anttiraisala/casino-open-sign/RDD-REQUIREMENTS.md

# RDD-REQUIREMENTS
Functional requirements agreed by the maintainer (RDD = Requirement Driven Development). IDs are never reused.

## Overview
**Purpose:** (to be agreed with the maintainer; a draft was proposed in chat on 2026-11-10)
**Users:**
**In scope:**
**Out of scope:**
**Constraints:**

## Requirements
REQ-001 to REQ-011 describe the planned settings menu: it is NOT implemented yet and is not being implemented now.

| ID | Requirement | Acceptance criterion | Origin | Revisions |
|----|---|---|---|---|
| REQ-001 | Settings menu: a menu is a list of items; each item is either a submenu or a property. The user moves through it with the keys of REQ-005; how it is presented is a separate matter. Back returns to the place the user came from (the item that was selected when the submenu was entered); at the top level it leaves the menu. | A host test walks a sample menu tree: opening a submenu, going back lands on the same item, back at the top level leaves the menu. | Maintainer chat 2026-11-10 | |
| REQ-002 | A property has a name and a value. Types: integer (negative, positive or mixed ranges, e.g. -100..-10, -50..50, 0..255), float with linear scale, float with logarithmic scale, and choice (dropdown; a boolean is a choice of two). Each has min, max and default. A text (string) type is not needed yet. | For every type a host test shows the default is applied and the value never leaves [min, max]. | Maintainer chat 2026-11-10 | |
| REQ-003 | Step size: an integer property steps by 1 unless the definition gives another step. A float property divides min..max into 50 intervals unless the definition gives another step or number of steps. A logarithmic property needs min > 0 and multiplies by a constant ratio per step ((max/min)^(1/steps)). A shift button held while turning multiplies the step by 10 (capped to the range; a property may override the factor). | Host tests: integer 0..255 with default step moves by 1; float exponent 0.1..20 log gives 51 values with the default 2.67 on the grid; shift moves by ten times the step. | Maintainer chat 2026-11-10 |  2026-11-11: shift factor fixed to x10. |
| REQ-004 | Limits: with wrap off a step that would pass min or max stops exactly at that limit (both ends); with wrap on the remaining amount of the step continues from the other end (both directions). Wrap is set per property (default off). | Host tests with a stepped value near both ends, with wrap on and off, for integer, float and choice properties. | Maintainer chat 2026-11-10 | |
| REQ-005 | Keys: a free-running 16-position hex rotary switch changes the selection or value; three buttons: OK, CANCEL, SHIFT (the OK button, documentation name "OK-menu button", opens the menu from the status pages; its label in the UI and on the LCD is always `OK`). The menu rotary is relative (it moves the selection or changes the value by steps; it is the only hex switch). In the menu OK opens a submenu or starts editing a property. While editing, OK accepts the value and returns to the menu at that property; CANCEL cancels, restores the value the property had when editing started and returns to the menu at that property. In the menu CANCEL goes up one level. The list selection stops at both ends (no wrap). Turning the arrow or casino switch while the menu is open cancels any edit (value restored) and shows the status page. The menu always opens at the root; the inactivity timer runs only at the menu root while just browsing (no submenu, property view, edit or confirm page open): after 60 s without input the display returns to the status pages, the remaining seconds shown at the right edge of row 0; elsewhere there is no timeout. SHIFT held while turning multiplies the step by 10. | A scripted key sequence on the host (turn, OK, CANCEL, SHIFT) gives the expected value and menu position for each case above. | Maintainer chat 2026-11-10 |  2026-11-11: control set of the V2 sign (menu hex switch D42-D45, OK D48, CANCEL D49, SHIFT D50), timeout and no-wrap list. 2026-11-11 (OQ-006, OQ-007, OQ-011): OK-menu button name, relative menu rotary, timeout only at the root while browsing. 2026-11-12: program switch removed, so only the arrow and casino switches close the menu (IDEA-017). 2026-11-12: BACK renamed CANCEL (technical name PIN_CANCEL, one level up or cancels an edit); CANCEL also skips the power-on LED test and the separate skip button SW2/D33 is removed from V2 (owner decision). 2026-11-12: pins spread out (menu hex switch legs 1, 2, 4, 8 on D38, D41, D42, D45; OK D46; CANCEL D49 and SHIFT D50 unchanged; owner decision, wiring only). |
| REQ-006 | The menu is defined in a human-written JSON file with a `root` tree and a `common` section of reusable elements (properties, submenus, type templates). The same element may appear in many places; loops are forbidden and are detected by the tooling. A property field is taken from the built-in default, overridden by its type template, overridden by the property itself (e.g. integer step 1 unless set). | The tooling rejects a menu with a loop, accepts a shared element in two places, and a test shows a type template field being overridden by a property. | Maintainer chat 2026-11-10 | |
| REQ-007 | Row text: by default a property row shows its name and value; the maintainer can define any friendly text for a row (including the shown words for true and false). Quick-pick rows set a value directly with one OK press, with freely definable text (e.g. "Lights on" sets B to true; "Min brightness 10" sets an integer to 10). A row text longer than 16 characters scrolls (marquee) on the 16-character LCD row; it is not a build error. A property row whose name and value do not fit together in 16 characters scrolls as one text "Name: value": a pause at the start, one character per step, a pause with the last character at the right edge (2026-11-11). A turn at the first or last item changes nothing, and a move away and straight back within 300 ms keeps that row's scroll phase. | A sample menu has a property row with default text, one with custom text and two quick-pick rows; host tests show the displayed texts and that OK on a quick-pick row sets the value. | Maintainer chat 2026-11-10 | 2026-11-11: whole-row scroll "Name: value" for rows that do not fit (maintainer chat). |
| REQ-008 | Callbacks: a property may have no callback, one or several callback functions that are called when its value changes, in the order given; menu editing, quick-pick rows and bound controls all change values through the same path and call them the same way. | A host test: a property with two callbacks calls both in order on every change; a property without a callback just changes the value. | Maintainer chat 2026-11-10 | |
| REQ-009 | Values survive power-off (stored in EEPROM) and are applied at start-up. A value is written only when the user accepts it with OK (or by a quick-pick). Each property has its own slot (by order) and the stored data carries a layout tag; on a mismatch or invalid data all defaults are used (old values may be lost). | A host test with a mock EEPROM: set a value, restart, the same value is back; with empty or invalid stored data the defaults are used. | Maintainer chat 2026-11-10 |  2026-11-11: save only on OK, slot per property, layout tag. |
| REQ-010 | A property can be read-only (default false): the menu shows its value but does not let the user change it. A value shown in the menu updates immediately when it changes elsewhere (for example by a bound control). | Host tests: OK on a read-only row does not start editing; changing the value from outside changes the displayed text in the next loop pass. | Maintainer chat 2026-11-10 | 2026-11-11: OK on a read-only property opens a view page like the edit page (name; a padlock and the value on row 1), nothing can be changed, CANCEL or OK returns (maintainer chat). |
| REQ-011 | Hardware controls bound to properties (separate from the menu): a rotary switch and buttons can be bound directly to a property and change it through the same path as the menu (same limits, wrap and callbacks). A rotary switch can work in a relative way (turning steps the value) or an absolute way (the position sets the value). The property stays visible in the menu (read-only when wanted). | Host tests: a bound dial and a bound button each change a property with its callbacks called; a read-only bound property is shown in the menu and follows the control. | Maintainer chat 2026-11-10 | |
| REQ-012 | V2 controls: the arrow slide switch (D32) and the Casino open/closed slide switch (D30) each have a reverse flag (a boolean property stored in EEPROM, editable in the menu); the switch position itself is read-only in the menu. The speed switches SW3/SW4 and the mode button D33 are removed; the speeds are menu properties. | Host test: the reverse flag inverts the meaning of each switch; the removed pins are no longer read; speeds change only through properties. | Maintainer chat 2026-11-11 | |
| REQ-013 | V2 effects (replaces the program switch, which is removed: D34-D37 are free): the frame and the letters each have their own effect, chosen in the menu group Effects (Frame effect, Letters effect, Random delay); the two effect properties also open the Frame and Letters groups (one value, two places). Each effect property is 0..15 (no wrap, default 1, saved in EEPROM): 0 = Random, 1..15 = a fixed effect (letters: 1 Breathe .. 15 Marquee; each letters effect N goes with frame pattern N, some following the arrow direction). Value rows show the number first, e.g. `12 Slot machine`. Random: one shared timer, its length the property Random delay (integer minutes 0..30, default 2, step 1, no wrap; 0 = a random delay of 1..30 min drawn on every restart; the delay is stored, a drawn value is not). When the timer runs out only the groups set to 0 pick a new effect (each its own, never the same one twice in a row); a fixed effect never changes by itself; a group switched to 0 picks at once and restarts the shared timer. | Host tests: every fixed effect N starts letters pattern N and frame pattern N; a random group never repeats and uses all 15; only random groups change when the timer runs out; both random groups change at the same moment; delay 0 draws 1..30; delay N changes after N minutes; the saved effects load at power-up. | Maintainer chat 2026-11-11 | 2026-11-11: "read at boot" changed to "read all the time" (answer to OQ-013). 2026-11-12: program switch removed; effects moved into the menu (IDEA-017, maintainer: "Joo, poistetaan"); program 0..E / F random replaced by effects 1..15 / 0 random per group, shared random timer. |
| REQ-014 | V2 status page: row 0 `F12 L03 Open|Closed` (F = frame effect, L = letters effect, two digits each, at most 16 characters; a `*` before the number marks a random group and the number is the effect really showing now, e.g. `F*07`; `--` when unknown); row 1 shows the arrow as seen from behind the sign and the customer direction (arrow character + `Customer right|left`, 16 characters; `<-`/`->` fallback if the LCD ROM lacks the arrows). While the frame or the letters are random, row 1 alternates with `Change in M:SS` (about 3 s each). | Host test of the row texts for every combination of effects, casino state and arrow direction, and the countdown (shown when either group is random); an LCD check on the real display for the arrow characters. | Maintainer chat 2026-11-11 | 2026-11-12: row 0 changed from `#<hex> Casino Open|Closed` to `F12 L03 Open|Closed` and the countdown from program F to "a group is random" (IDEA-017, maintainer chose this row 0 on 2026-11-11). |
| REQ-015 | V2 menu content: Controls (arrow, casino read-only; arrow reverse, casino reverse), Effects (Frame effect, Letters effect, Random delay), Speed (three rows Frame speed, Letters speed, Arrow speed, float log 0.125..4, 30 steps, default 1 (exactly at step 18), 3 decimals, unit x; SHIFT moves 10 steps), a group per LED type, Frame (the frame strip), Letters and Arrow (the arrow sticks), each with its speed (Frame speed, Letters speed, Arrow speed; Frame and Letters start with their effect property) and Min (int 0..255 default 0), Max (int 0..255 default 80), Exponent (float log 0.1..20, 50 steps, default 2.67) and Mix (float linear 0..1, 50 steps, default 1.0; blends the linear and the logarithmic curve as in the brightness tool), Brightness (the same brightness properties again, grouped Frame / Letters / Arrow; each property exists once and appears in two places), and a preset Restore defaults (sets every property to its default after OK/CANCEL confirmation). | The generated menu tree matches this list; a host test walks every row and the Restore defaults preset sets all defaults in one EEPROM batch. | Maintainer chat 2026-11-11 |  2026-11-11: Letters brightness group and Mix property added (maintainer chat). 2026-11-11: Speed range changed from 0.25..4 / 24 steps to 0.125..4 / 30 steps, 3 decimals (maintainer chat); the EEPROM layout tag changes, so old saved values are dropped. 2026-11-11: Menu renamed and regrouped: Strip -> Frame, Stick -> Arrow; root now Controls, Speed, Frame, Letters, Arrow, Brightness, Random program, Restore defaults; speed rows named Frame speed / Letters speed / Arrow speed (maintainer chat). 2026-11-12: Controls loses program; new group Effects (Frame effect, Letters effect, Random delay; the effects also start the Frame and Letters groups); `Random program (Change delay)` replaced by Random delay in Effects; root now Controls, Effects, Speed, Frame, Letters, Arrow, Brightness, Restore defaults (IDEA-017). |
| REQ-016 | Quick-pick presets: a row may set up to 16 property values at once (hidden properties allowed, a value may be the word `default`); all values are applied first, then the callbacks run once and the EEPROM is written as one batch. A quick-pick that targets a read-only property gives a warning when the menu is generated, and the preset does not try to set that property. A destructive preset asks OK/CANCEL. No active-value marker is shown. | Host tests: a preset with three values calls each callback once and writes one batch; a read-only target gives a generator warning and is not set. | Maintainer chat 2026-11-11 | 2026-11-11 (OQ-012): build error changed to a warning. |
| REQ-017 | Menu editor tool: a browser tool (published as a link like the Plate Designer) edits the menu JSON of REQ-006 and shows a preview of the 2 x 16 character display and the key behaviour of REQ-005; it exports the JSON that a later generator turns into PROGMEM tables. The same core logic runs in the tool and in the host tests. | Node and browser tests: the sample V2 menu loads, validation reports loops and read-only quick-pick targets, preview rows are 16 characters, the exported JSON loads back unchanged. | Maintainer chat 2026-11-11 | |
| REQ-018 | Live preview while editing: while a property is being edited, every step of the rotary switch changes the value immediately and calls its callbacks, so the effect on the sign is seen at once (a brightness changes the light, a speed changes the animation, a lighting effect starts). OK accepts the value and ends the editing (the only moment it is written to EEPROM); CANCEL (cancel) restores the value the property had when editing started and calls the callbacks again, so the effect goes back too. | Host tests: while editing, each turn calls the callbacks with the new value and nothing is written to EEPROM; OK keeps the value and writes it once; CANCEL restores the start value, calls the callbacks with it and writes nothing; the same for the V2 sketch menu. | Maintainer chat 2026-11-11 | Behaviour already exists (REQ-005 accept/restore, REQ-008 callbacks on every change, REQ-009 save only on OK); this makes the live effect and the callback on cancel explicit. |
| REQ-019 | Brightness test mode: the first item of the Brightness group is the submenu "Brightness test". While it, or any menu, edit or view below it, is open, every LED shows a fixed test pattern instead of the effects (frame, letters, all ten arrow sticks whatever the arrow direction, the CLOSED stick), and the pattern goes through the same brightness curves as every effect. The submenu holds the property Pattern (Ramp, All white, Red, Green, Blue, Level; starts at Ramp), the property Level (0..255, default 128, used by the pattern Level) and the three curve groups Frame, Letters and Arrow (Min, Max, Exponent, Mix), so a curve can be edited while the pattern is visible (live preview, REQ-018). Ramp: 10 steps with the input levels 26, 51, 77, 102, 128, 153, 179, 204, 230, 255; on every stick and on the CLOSED stick LED 1..10 in wiring order, on the letters in reading order (C A S I N O O P E N), on the 18 frame pixels in strip order two pixels per step (steps 1, 2, 2, 3, 3, 4, 4, 5, 5, 6, 7, 7, 8, 8, 9, 9, 10, 10). All white, Red, Green, Blue: every LED at input 255 (the curve maximum); Level: every LED white at the Level value. Pattern and Level are not stored in EEPROM (the layout tag does not change). CANCEL out of the submenu (or a change of the arrow or casino switch) ends the mode and the effects go on; there is no menu timeout inside the submenu. | Host tests: with identity curves each pattern gives exactly the stated colours on every LED group; with a Max of 80 the brightest step shows 80 on all three LED types; turning Pattern or Level, or editing a curve property inside the submenu, changes the LEDs at once and CANCEL restores them; the mode is off in the Brightness group itself, ends when leaving the submenu or turning the arrow switch, and nothing is written to EEPROM. | Maintainer chat 2026-11-12 (IDEA-018) | |
| REQ-020 | EEPROM clear tool: the sketch `eeprom_clear/sketch.ino` sets every byte of the Mega's EEPROM to 0xFF once at start-up (only bytes that differ are written), checks by reading back, reports the size, the number of bytes that were not 0xFF and the result on the Serial Monitor (115200 baud, one DBG line per second) and blinks the LED on pin 13 slowly when clear and fast when a byte could not be cleared; it needs no wiring. | Host tests: with seven, 1024 or no used bytes, a stuck byte, and first and last byte used: all bytes 0xFF afterwards, writes only for bytes that differed, the messages, the LED rates and the DBG line exactly as stated, one debug line per second. | Maintainer chat 2026-11-12 (IDEA-019) | |
| REQ-021 | Monochrome and effect 15: the menu property Effects > Monochrome (No/Yes, default Yes, stored in EEPROM) makes the frame, letters, arrow and CLOSED light show grey instead of colour (grey level = the brightest of R, G, B, then the brightness curve); the Brightness test and the power-on LED test stay coloured. Effect 15 of both groups is "Grey bands": always grey, only the levels off, half (128) and full (255), all lit at the start of every phase, then moving patterns (frame: four phases of 36 steps; letters: three phases of 6 s) and a broken-light flicker (frame: one pixel in a burst of 8 steps per 50-step slot, one slot in three, plus the whole frame blinking out in the first 6 steps of some 60-step slots; letters: the existing neon flicker). | Host tests: toGrey/shapeShow exact values, Monochrome on gives grey on every LED of every strip and stick and off gives colour, the Brightness test stays coloured, the frame grey bands match the independent reference table (four phases, bursts), the letters grey bands match hard-coded levels in all three phases (off/half/full only, all lit at the start of each phase), menu row and storage slot of Monochrome, layout tag 6e5c98ef; mutation tests detect every mutant. | Maintainer chat 2026-11-12 (IDEA-020) | 2026-11-12: Monochrome default changed from No to Yes on the maintainer's request (grey is the standard look). 2026-11-12: effect 15 changed from four grey levels (0/70/150/255) to three (off, half, full) with all lit at the start of each phase, on the maintainer's request. 2026-11-12: whole-frame blink-out added to effect 15; power-on LED test shows only greys in Monochrome; arrow stick default Max 80 -> 60 (maintainer's request). |
