anttiraisala/casino-open-sign/AI_CONTEXT.md

# AI_CONTEXT - read this first when continuing the project

This file is for a new AI chat that continues the work. Read it fully, then read `README.txt`
and the top (CONFIGURATION section) of `sketch.ino`. `DESCRIPTION.md` is the plain-language
description for humans.

## 1. Project in one paragraph

Arduino Mega 2560 casino sign "CASINO OPEN" for a home poker casino: 10 WS2812B LED strips
(238 LEDs), a black 50 x 45 cm plate with an LED frame, red plexi letters (CASINO / OPEN), a hole
text "CLOSED" lit from behind, and a left/right arrow. Inputs: arrow direction switch, letter mode
button, casino closed switch, and two hex rotary speed switches; an I2C 2x16 LCD shows the settings
(debug style). The whole thing is simulated in
Wokwi (https://wokwi.com/projects/new/arduino-mega). The user pastes the files into Wokwi by hand;
you only produce project files. Nothing has been tested on real hardware or in Wokwi by the AI:
tests run on the host with mock Arduino headers (section 8).

## 2. Working rules set by the user (follow them)

- The user writes Finnish. **Reply in Finnish.** Everything that goes into the project (code,
  comments, docs, config, file names) is **English**. The only exception: `README-fi.txt`, a
  Finnish translation of `README.txt` (keep the two in sync; `README.txt` is the master). Product
  names copied from partco.fi may contain Finnish characters.
- **Deliver all project files together in ONE zip** (the whole `casino_sign` folder), never as
  loose files. Send only the zip.
- The README must contain an exact wiring description (component -> pin) and a parts-to-buy list
  looked up from **partco.fi** (main parts only, no plain wire).
- Always include an **SVG electrical schematic** drawn with real symbols (`wiring-diagram.svg`),
  plus the layout drawings. All drawings are A4 and also exported as PDF.
- The user often says (in Finnish) "explain in your own words, do not implement anything": then
  explain and **do not change anything** until they confirm. Flag contradictions in a request before building.
- **Parts list prices, stock and links (`parts-list.*`, `tools/parts_data.py`, README section 5) must NOT be
  updated without an explicit request from the user** (no refreshing, re-checking or relinking on your own
  initiative). **Remind the user now and then** (for example when the parts list is mentioned, when a
  zip with it is delivered, or when they talk about ordering or building) that these are a snapshot from
  2026-11-02 and that a refresh is possible on request. Do not refresh it just because you remind them.
- Do the work in this order: explain -> user confirms -> implement -> regenerate -> test -> zip.
- The user does not want a ring of single LEDs for the frame; the frame is two strips. A letter
  may use any number of LEDs (default 6, "I" 4). Placement by the user: the arrow must have no
  vertical line at the head end of the shaft (the shaft is closed at the tail, open at the head).

## 3. Files

| File | Role |
|---|---|
| `sketch.ino` | The program. All settings are in the CONFIGURATION section at the top. |
| `diagram.json` | Wokwi circuit. **Generated** by `tools/generate_diagram.py`; never edit by hand. |
| `libraries.txt` | `Adafruit NeoPixel` |
| `wiring-diagram.svg/.pdf` | Electrical schematic, A4 portrait. Generated by `tools/generate_schematic.py`. |
| `layout-diagram.svg/.pdf` | To-scale layout of the strips on the plate, A4 landscape. `tools/generate_layout.py`. |
| `layout-parts.svg/.pdf` | LED counts, cutting list, letter table, A4 portrait. Same script. |
| `README.txt`, `README-fi.txt` | Wokwi instructions, wiring, parts list, cutting list, behaviour. |
| `DESCRIPTION.md` | Human description + list of planned features. |
| `AI_CONTEXT.md` | This file. |
| `tools/generate_diagram.py` | Reads the config from `sketch.ino` (regex, `read_config`) and builds `diagram.json`. |
| `tools/generate_schematic.py` | Draws the schematic; also defines the `Svg` helper class (`render_a4`). |
| `tools/generate_layout.py` | Draws the plate layout and the parts sheet from the same geometry. |
| `tools/sign_data.py` | Shared strip data (pins, pieces, LED counts, index ranges) for the drawings. |
| `tools/size_calculator.py` | Suggests LED counts for a sign size (`--width --height --arrow-width --arrow-height --closed-leds`). |
| `tools/export_pdf.py` | SVG -> A4 PDF with Playwright. |
| `tools/parts_data.py` | Data of the shopping list (every part, qty, price, stock, partco.fi URL). Edit here. |
| `tools/generate_parts_list.py` | Makes `parts-list.pdf` (A4 landscape, clickable links + a link page), `parts-list.csv` and `parts-list.xlsx` (formulas: line totals, SUMIFS totals; recalculated with the xlsx skill's `recalc.py`). |
| `parts-list.pdf/.csv/.xlsx` | The complete shopping list, master of the parts list (README section 5 has the main parts only). |
| `tests/` | Host-side test harness (section 8); `tests/strip_test_harness.cpp` tests `strip_test/sketch.ino`. |
| `stick_test_direct/` | Second stick test: up to 11 Grove sticks (shield connectors D2..D8, A0..A3) plugged UNMODIFIED, always-moving patterns from power-up (spotlight stick, 11 patterns, button = load test) into the Grove shield, Arduino+shield fed from the external 5 V supply on the Mega 5V/GND pins (no USB while running). Same pins as stick_test plus A3; sign-of-life LED and DBG serial line. Generators `tools/generate_stick_test_direct_{diagram,schematic}.py` (layout comes from generate_stick_test_layout.py); host test `tests/stick_test_direct_harness.cpp`. |
| `stick_test/` | Separate small project: sketch + Wokwi diagram + A4 schematic + layout + READMEs for testing 10 Grove RGB LED sticks (10x WS2813) on a separate 5 V supply. Generators: `tools/generate_stick_test_{diagram,schematic,layout}.py`; host test `tests/stick_test_harness.cpp`. Chosen arrow design B (10 sticks: 4 shaft, 2 caps, 4 wings at 30 deg); NOT yet applied to the main sketch (user said 9 sticks earlier, 10 now: open). |
| `strip_test/` | Separate small project: sketch + Wokwi diagram + A4 schematic + READMEs for testing a short piece of the candidate 12 V WS2811 strip. Schematic made by `tools/generate_strip_test_schematic.py`. |
| `strip_single_led_test/` | Test "LED strip single LED": 3 x 12 V WS2811 strips (D9 walking white pixel, D10 coloured walking pixel, D11 ruler), 150 steps (probably only 50 real pixels). Files made by `tools/generate_strip_single_led_test.py`; tests `tests/strip_single_led_test_harness.cpp`, `tests/mutate_strip_single_led.py`. |
| `eeprom_clear/` | Tool (not a test): sets every EEPROM byte to 0xFF once at start-up (EEPROM.update, read back and verified), sign of life LED 13 (slow = ok, fast = failed) and a DBG line per second; no wiring, USB only. A USB upload does not clear the EEPROM, so the V2 menu settings survive uploads (a changed layout tag gives defaults). Tests `tests/eeprom_clear_harness.cpp` + `tests/mutate_eeprom_clear.py` (52 mutants). |
| `hex_rotary_test/` | Test of a free-running 16-position hex rotary switch (legs 1, 2, 4, 8 on D34-D37, C to GND, INPUT_PULLUP, bit set = LOW): number A 2..51 (start 26, no wrap, step 1, `reverseDirection` bit) follows the switch; direction and steps from delta = (new - old) mod 16 (1..7 forward, 9..15 backward, 8 ignored), 10 ms debounce; I2C LCD 0x27 shows `A=..` and `Pos:X CW n:..`; LCD retried every second when lost, re-initialised every 5 s; I2C scan at boot; sign of life. Files by `tools/generate_hex_rotary_test.py`; tests `tests/hex_rotary_test_harness.cpp`, `tests/mutate_hex_rotary.py`. Not yet run on hardware. |
| `strip_frame_demo_test/` | Demo "Strip frame demo" (owner's name "Street Frame Demo Test"): D9 frame strip of 18 WS2811 pixels (6 bottom, 3 right, 6 top, 3 left; pixel 1 at the lower-left corner, counter-clockwise), three Knight Rider lights whose route starts at the upper-left corner (strip pixel 15) and runs clockwise, turning at pixel 16 (34 steps per cycle), red 500 ms / green 385 ms (1.3x) / blue 333 ms (1.5x) per step with additive colour mixing; D10 single pixel pulse 3 s, 8 palette colours; D11 colour bar of 6 pixels (red, green, blue, cyan, violet, white moving 1 pixel/s towards pixel 6); D12 pixel test of 10 pixels (counter 5 s, fill/empty 10 s, red-green-blue-white 6 s, runner 3.6 s); peak 80. Files by `tools/generate_strip_frame_demo_test.py`; tests `tests/strip_frame_demo_test_harness.cpp`, `tests/mutate_strip_frame_demo.py`. |
| `strip_knight_rider_test/` | Demo "LED strip knight rider": 3 x 12 V WS2811 strips of 50 pixels, one light bounces (D9 red 1 px/s, D10 blue 4 px/s, D11 green 10 px/s; 98 steps per cycle). Files by `tools/generate_strip_knight_rider_test.py`; tests `tests/strip_knight_rider_test_harness.cpp`, `tests/mutate_strip_knight_rider.py`. |
| `sticks_11_test/` | Test "11 sticks": 10 arrow sticks (D2-D8, A0-A2, sign order) + the CLOSED light stick on A3, steady CLOSED light + flowing white arrow (button D33: flow <-> all on), heat check. Files by `tools/generate_sticks_11_test_{diagram,schematic,layout}.py`; tests `tests/sticks_11_test_harness.cpp`, `tests/mutate_sticks_11.py`. |

Regenerate everything after changing the config or geometry:

    python3 tools/generate_diagram.py
    python3 tools/generate_schematic.py
    python3 tools/generate_layout.py
    python3 tools/export_pdf.py
    python3 tools/generate_parts_list.py   # then recalculate parts-list.xlsx (LibreOffice recalc.py) so cached values exist
    rm -rf tools/__pycache__

## 4. Hardware and pins (must match `sketch.ino`, README.txt, both SVGs)

Strips (each through a 330 ohm resistor R1..R3 to the first LED's DIN):

| Pin | Strip | LEDs | What |
|---|---|---|---|
| D9 | frameCw | 53 | frame: top edge (28) then right edge (25) |
| D10 | frameCcw | 53 | frame: left edge (25) then bottom edge (28) |
| D11 | letters | 58 | letters in reading order C A S I N O, O P E N: 6 6 6 4 6 6, 6 6 6 6 |

Grove sticks (plugged into the Grove Base Shield connectors, no resistor, power ONLY through the shield):

| Connector | Stick | LEDs | What |
|---|---|---|---|
| D2 D3 D4 | L-CAP, L-WING-UP, L-WING-DN | 10 each | left cap and the left arrowhead wings |
| D5 D6 D7 D8 | RAIL-UP-L, RAIL-UP-R, RAIL-DN-L, RAIL-DN-R | 10 each | the four rail sticks |
| A0 A1 A2 | R-CAP, R-WING-UP, R-WING-DN | 10 each | right cap and the right arrowhead wings |
| A3 (57) | closedLight | 10 | the 11th stick: white light behind the plate, lights the CLOSED hole text |

D31 is free (the CLOSED light used to be a 6-LED strip there).

Inputs (INPUT_PULLUP; a switch pulls the pin to GND):

| Pin | Part | Meaning |
|---|---|---|
| D32 | slide switch SW1 | arrow direction: LOW (handle on GND side) = points left |
| D33 | push button | each press = next letter mode |
| D30 | slide switch SW5 | casino closed: LOW = closed |
| D22-D25 | hex rotary switch SW3 (bits 1,2,4,8) | speed of frame + arrow |
| D26-D29 | hex rotary switch SW4 (bits 1,2,4,8) | speed of the letter patterns |
| D20 (SDA), D21 (SCL) | I2C LCD 2x16 (PCF8574 backpack, 0x27) | shows mode, speeds, casino state, arrow; 5 V + GND from the Arduino pins |

The hex switches are the partco.fi part "hex-coded rotary switch 0-F" (not a pulse encoder): 4
bit pins + common to GND. `SPEED_BIT_IS_LOW = true`. Speed multiplier grows geometrically from
0.25 (position 0) to 4.0 (position F).

Power: 5 V / 10 A supply (Mean Well LRS-50-5), 10 A fuse, 1000 uF capacitor, common GND with the
Arduino. The supply feeds the Arduino through BOTH Mega 5V pins (no USB while the supply is on), and the Grove shield passes that 5 V to the 11 sticks; no wire goes from the supply to any stick. The strips are fed directly from the supply bus. Worst case 164 strip LEDs + 110 stick LEDs = 274 x 60 mA = 16.4 A;
Brightness curves: per LED type (STRIP: frame+letters, STICK: arrow+CLOSED) a 256-byte lookup table built by setBrightnessCurve(type,min,max,exponent,mix,keepZero) (defaults CURVE_DEFAULT_*: min 0, max 80, exponent 2.67, mix 1.0, keepZero true); shapeColor() maps the largest channel through the table and keeps the hue; applied where colours are written (not in the power-on test); the harness runs the old tests with an identity curve and tests the curves with hard-coded values. There is no global BRIGHTNESS any more (library brightness 255); curve max 80 gives about 4.5 A when all LEDs are white.

Geometry (60 LEDs/m, pitch 16.7 mm): plate 50 x 45 cm, arrow about 39.1 x 16.7 cm (the 40 x 15
target cannot be hit exactly with whole LEDs and an even cap), CLOSED hole text about 10 x 2.5 cm,
about 5 cm free under the arrow. Total 3.97 m of strip in 27 pieces (one 5 m reel).

## 5. Sketch structure

- Adafruit_NeoPixel, **one object and one data pin per logical strip** (10 objects), `show()` per
  strip. Strips made of several physical pieces are chained with wires (DOUT -> DIN).
- All timing is non-blocking `millis()`. **Never use `delay()`** (the only exception is the one-time LCD start-up in `setup()`).
- Sections in order: CONFIGURATION, helpers (`mixChannel`, `cycleOf`, `lettersTotalLeds`), input
  debouncing (`pollInput`, `initInput`, `INPUT_ARROW/MODE/CLOSED`), speed switches
  (`buildSpeedTable`, `pollSpeedSwitch`, `applyMainSpeed`, `applyLettersSpeed`,
  `advanceLetterClock`), frame (`updateFrame`), letters (11 modes `MODE_*`, `letterLevel`,
  `drawLetters`, random neon flicker of one letter), CLOSED light (states `CL_OFF/CL_STARTUP/
  CL_STEADY/CL_FLICKER`, `setCasinoClosed`, `updateClosedLight`), arrow (`drawArrow`,
  `updateArrow`, `applyArrowSwitch`), `setup()`, `loop()`.
- Frame: 5 LEDs lit / 5 dark pattern, distance measured from the start corner along two paths that
  meet at the opposite corner. Corners are empty cells. When the arrow points right the pattern
  starts at the top-left corner; when it points left the distance mapping is mirrored.
- Letters: modes 0 breathe (default, start mode), 1 wave, 2 typewriter, 3 ignite, 4 word blink,
  5 alternate, 6 scanner, 7 sparkle (stateless hash `hash16`), 8 chase (one dim letter per word),
  9 pulse (heartbeat), 10 random auto (`pickAutoMode`: random pattern from 0..9, never the one
  showing, re-picked every `LETTER_RANDOM_AUTO_MS` = 120000 real ms). `letterMode` is what the button
  selected, `activeMode` the pattern really shown; `baseLetterLevel` switches on `activeMode`. The
  letter patterns run on their own scaled clock `letterClockMs` (SW4), so changing the switch never
  makes a pattern jump. The random letter flicker keeps real time.
- Casino closed: `letterLevel()` returns 0 for letters of the second word (OPEN) while closed. The
  CLOSED light is always white (R = G = B): startup flashes (`CLOSED_STARTUP_MS`), steady
  5-14 s, flicker burst 0.4-1.5 s with full / dim / dark phases. Timing follows SW4.
- Power-on LED test (`POWER-ON LED TEST` section): `setup()` only initialises the hardware, the
  strips, the button, the LCD and the speed table, then `beginStartupTest()`; the rest of the start
  (reading the arrow/closed/speed switches, mode 0, closed light) is `finishStartup(now, skipped)`,
  called when the test ends or the button D3 is pressed (`buttonChanged` and LOW; a button already held
  at power-up has no change event, so only a new press skips; that press is not a mode change).
  `updateStartupTest()` draws, for all `allStrips[]` at once, a window of `STARTUP_TEST_WINDOW_LEDS` LEDs
  moving over the strip (front from 0 to n + w over each pass, so strips finish together); pass 0 white,
  later passes R, G, B by LED number. `STARTUP_TEST_MS` = 10000 (0 = no test), `STARTUP_TEST_PASSES` = 2.
  During the test `loop()` only polls the button and calls `updateStartupTest()` and `updateLcd()`.
  LCD test screen: `lcdBuildTestText()`: one row scrolls "press D3 to skip" (`LCD_TEST_SCROLL_MS`), the other
  shows `N/10 s` centred over a `#`/`.` progress bar; rows swap every `LCD_TEST_SWAP_MS` (2.5 s).
  The test harness calls `finishStartup(g_millis, true)` right after `setup()` so its older tests start
  from normal operation; the power-on test has its own block at the end of the harness.
- LCD (`LCD DISPLAY` section): own HD44780-over-PCF8574 driver on `Wire` only (no library; the
  one-time start-up sequence uses `delay()` in `setup()`, nothing else does). Pages 0 mode, 1 SW3,
  2 SW4, 3 status rotate every `LCD_PAGE_MS` (3 s). A changed setting calls `lcdShowPage(page, now,
  true)` = shown at once and held `LCD_HOLD_MS` (6 s) from the last change, then rotation resumes from
  the next page; the automatic random-auto change shows page 0 without a hold. `lcdBuildText()` builds
  the text (rate-limited, immediate on page change); `lcdSendChanges()` sends only changed characters,
  `LCD_CHARS_PER_LOOP` per loop pass (one short transmission, no blocking). If no display answers at
  start-up (`lcdOk` false) the display is skipped. Backpack mapping: P0 RS, P1 RW, P2 E, P3 backlight,
  P4-P7 D4-D7. Address `LCD_I2C_ADDRESS` 0x27 (the partco page says 0x27, but PCF8574AT chips are
  often 0x3F; unverified on real hardware).
- Arrow (10 Grove sticks): only the head the arrow points at is lit; tail cap = middle 6 LEDs, head cap = 3 + 3 end LEDs; two routes (upper, lower) tail -> rails -> head cap -> wing -> tip in blue/cyan/violet/ice-white, with a white pulse taking turns on the two routes (see section "Phase 1 sign rebuild").

### Pitfall: Arduino auto-prototypes

The Arduino build inserts function prototypes at the top of the file. A function signature may
only use types known before the first function: built-in types, `Adafruit_NeoPixel`,
`__FlashStringHelper`. A custom `struct` in a signature or a `constexpr` function caused the build
error `'Rgb' does not name a type`. Colours are packed `uint32_t`; the letter LED total is the
runtime function `lettersTotalLeds()`. Keep it this way.

## 6. Wokwi diagram (`diagram.json`) facts

- Parts used: `wokwi-lcd1602` (attribute `pins` "i2c": SDA = mega:20, SCL = mega:21, VCC = 5V, GND), `wokwi-arduino-mega`, `wokwi-led-strip` (chain DOUT -> DIN, VDD.2 -> VDD,
  VSS.2 -> VSS; any `rotate`), `wokwi-slide-switch` (pins 1, 2 common, 3; attribute `value` "1" =
  handle right), `wokwi-pushbutton`, `wokwi-dip-switch-8` (pins `1a`..`8b`), `wokwi-text`.
- The I2C LCD sits below the Arduino (caption above it). Wokwi has no hex rotary switch: a DIP-8 stands in (switches 1-4 = SW3 bits, 5-8 = SW4 bits).
- The CLOSED hole text cannot be shown; a text label stands in. SW5 starts "open" (`value` "1").
- Wokwi has no background graphics: the letters are groups of single LEDs drawn as circles with a
  text label in the middle. Strips are separated by one-LED gaps for clarity (not on the real sign).
- Geometry constants at the top of `generate_diagram.py` (`PITCH = 16`, `THICKNESS`, ...) are an
  estimate of the Wokwi strip element size. If the user reports misaligned parts, tune them.
- Layout: the sign is at x = 480, y = 20. The input block (switches, button, DIP bank, labels) is
  placed ABOVE the Arduino, left of x = 460, with every caption ABOVE its component (slide switches
  and button on top, then the DIP bank's caption block with the DIP bank below it); the Arduino is below. Wires may cross, that is fine.
- A text list of the letter modes sits under the sign (`mode_list_*` text parts); update it in
  `generate_diagram.py` when modes change.
- The user pastes `sketch.ino` into the `sketch.ino` tab and `diagram.json` into the `diagram.json`
  tab. Once the sketch ended up in the diagram.json tab (no Play button) - remind them if needed.

## 7. Drawings

- `Svg.render_a4(landscape)` in `generate_schematic.py` scales a drawing to one A4 page (width and
  height in mm, viewBox scaled to fit with 8 mm margins). Text sizes in the code are in drawing
  units; the printed size is printed by the generator scripts.
- Schematic: real symbols (resistors, slide switches, push button, hex switch blocks, fuse,
  capacitor, power supply). Each strip is a block fed at the points listed in README section 4.
  Strip table comes from `sign_data.strip_info`, so counts always match the sketch.
- Layout: to scale (60 LEDs/m), dimensions in cm, callouts per strip with LED index ranges, CLOSED
  hole text outline drawn over the LED squares. `--leds-per-m` changes the pitch.
- The wiring diagram is a single A4 page; its text is small (about 1.9 mm per 12-unit label).
  Splitting it into two pages was offered but the user chose one page for now.
- Always check new drawings visually (render with Playwright/pdftoppm and look at them).

## 8. Tests (no AVR toolchain, no Wokwi in the sandbox)

`tests/` holds a host-side harness with mock `Arduino.h`, `Adafruit_NeoPixel.h` and `Wire.h` (the
mock Wire contains a fake HD44780 + PCF8574 display that decodes the I2C bytes into two text rows):

    g++ -std=c++17 -O1 -w -Itests -DSKETCH_PATH='"../sketch.ino"' -o /tmp/harness tests/harness.cpp
    /tmp/harness        # prints "RESULT: all checks passed"

It checks (including the four new modes, random auto and the LCD pages): LED counts and pins of all strips, every letter mode, flicker, arrow direction and
frame mirroring, input debouncing, all speed switch positions, the casino-closed behaviour (OPEN
letters dark in all modes, CLOSED light always white with startup/steady/flicker phases, burst rate
scales with SW4, reopening restores everything, a 10 ms glitch is ignored). When you change the
sketch, extend the harness and also run a mutation (break the feature, the test must fail).
A reversed-polarity build (`CASINO_CLOSED_WHEN_LOW = false`) fails the harness by design because
the harness hard-codes LOW = closed.

### Hex rotary test (2026-11-10)

`hex_rotary_test/sketch.ino` is tested by `tests/hex_rotary_test_harness.cpp` (mock Arduino + Wire with the fake LCD; all expected values hard-coded:
leg-to-pin mapping, the move table with forward/backward/wrap/ambiguous cases and clamping, 10 ms debounce, `reverseDirection`, LCD text, LED and
DBG timing, LCD loss/retry/re-initialisation, I2C scan range) and mutation-tested by `tests/mutate_hex_rotary.py` (108 mutants, all detected; the
one "lcdShown updated on a failed send" mutant was dropped as equivalent because `lcdInit()` resets `lcdShown`):

    g++ -std=c++17 -O1 -w -Itests -DSKETCH_PATH='"'$PWD'/hex_rotary_test/sketch.ino"' -o /tmp/hex_rotary_harness tests/hex_rotary_test_harness.cpp && /tmp/hex_rotary_harness
    python3 tests/mutate_hex_rotary.py

The mock cannot check the LCD set-up commands 0x28, 0x0C, 0x06 (it only models 4-bit switching, clear and cursor/data writes).

### Casino Open Sign V2 tests (2026-11-10)

`casino_open_sign_v2/` has its own sketch; the harness is `tests/casino_open_sign_v2_harness.cpp` (derived from `tests/harness.cpp`, with the
V2 pins, 13 strips, hard-coded frame paths for both arrow directions, letter pixel order C A S I N O N E P O and a typewriter order test) and
`tests/mutate_v2.py` (~85 mutants):

    g++ -std=c++17 -O1 -w -Itests -DSKETCH_PATH='"'$PWD'/casino_open_sign_v2/sketch.ino"' -o /tmp/v2 tests/casino_open_sign_v2_harness.cpp && /tmp/v2

V2 generators: `tools/generate_v2_diagram.py` (Wokwi), `generate_v2_schematic.py`, `generate_v2_layout.py` (layout-diagram + layout-parts),
`generate_v2_parts_list.py` (CSV + SVG), shared data `tools/v2_data.py`; all read `casino_open_sign_v2/sketch.ino`. The v1 files are unchanged.
V2 stick wiring (differs from v1 and `arrow_sticks/`; positions unchanged): L-CAP D2, L-WING-UP D6, L-WING-DN D5, RAIL-UP-L D7, RAIL-UP-R D8,
RAIL-DN-L D3, RAIL-DN-R D4, R-CAP A3, R-WING-UP A1, R-WING-DN A2, CLOSED stick A0. The connectors come from the sketch, not from `arrow_geometry.py`.
V2 boot: `scanI2cBus()` (0x08-0x77, empty write) prints the found I2C devices to Serial before `lcdInit()` and warns if nothing answers on `LCD_I2C_ADDRESS` (0x27); one LCD only, its address is a constant (tests: "I2C scan" checks + 9 mutants).

## 9. Decisions already made (do not reopen without a reason)

- 60 LEDs/m strip, plate 50 x 45 cm, arrow ~40 x 15 cm target (actual 39.1 x 16.7 cm).
- The frame is two strips (CW and CCW), not a ring of single LEDs; corner cells stay empty.
- Letters: one data pin, one chained strip made of per-letter pieces, LED count per letter free.
- Hex rotary switches (4 pins each) for the two speeds, not pulse encoders.
- Power-on LED test: 10 s, all strips in parallel, 2 passes (white, then RGB), D3 skips, LCD shows seconds in a progress bar plus a scrolling skip text with the rows swapping every 2.5 s.
- Casino closed = darkens only OPEN (24 LEDs), lights the CLOSED hole text; the closed light is
  always white and flickers like a faulty fluorescent tube.
- One zip with all files; Finnish README as the only non-English file.
- The controller stays the Arduino Mega 2560 (decided 2026-11-02). Smaller boards were considered and rejected
  for now: the sign needs 23 I/O pins (10 strip data pins, 11 inputs, 2 I2C), more than an Uno/Nano (about
  18-20 usable); an Uno also has only 2 KB RAM (rough estimate, not measured, about 1.7 KB needed). CPU speed
  is not a problem (updating all 238 LEDs takes about 7 ms). Possible cheaper options if asked again: Seeeduino
  Mega (46.70 EUR at partco.fi, pin numbering unchecked), a Mega clone, or a smaller board plus an I2C port
  expander (PCF8574) for the hex switches (needs wiring and code changes). 3.3 V boards need level shifters
  for the WS2812B data lines.

## Plate Designer (2026-11-09)
`tools/plate-designer/` (README.md there): `plate-core.js` = tested pure logic (SDF/marching-squares letter geometry, hole checks, snapping, frame counts, EPS/PDF writers, JSON v1), `app.js` + `index.html` = UI, `arrow-data.js` generated from `tools/arrow_geometry.py`. Tests: `tests/plate_designer_core_test.js`, `tests/mutate_plate_designer.py`, `tests/plate_designer_ui_test.py`. Fonts stored by name only; Google Fonts load needs network (untested from the sandbox).

## Menu Editor (2026-11-11)
`tools/menu-editor/` (README there): `menu-core.js` (JSON format 1 validation + engine: keys, live editing, presets, EEPROM image with layout tag, 16-character rows, 60 s root timeout, marquee), browser editor (`index.html`, `app.js`), V2 menu `menu-v2.json`. Tests: `tests/menu_core_test.js` (hard-coded expectations), `tests/mutate_menu_core.py` (151 mutants), `tests/menu_editor_ui_test.py` (Playwright; `MENU_EDITOR_PAGE=menu-editor-single.html` for the single file). Single-file build `tools/build_menu_editor_single.py`, artifact slug 840aef6c-fb14-4ea5-9587-4e52d8c076dd. The V2 sketch does not use it yet; next steps are the generator (JSON -> PROGMEM) and the V2 sketch changes (REQ-012..016, RDD-PROGRESS AP-003..005).

### Menu engine and menu test (2026-11-11)
`tools/menu_engine/engine.inc` is the C++ menu engine (same rules as the JS `Engine`), `generate_menu_tables.js` turns the menu JSON into PROGMEM tables (properties, items, menus, presets, value texts, callbacks, string blob, EEPROM slots, layout tag), `test_shell.ino.in` is the hardware shell (menu hex switch D38/D41/D42/D45, OK D46, CANCEL D49, SHIFT D50, arrow D32, casino D30, I2C LCD, sign of life). `node tools/generate_menu_test.js` assembles `menu_test/sketch.ino` (never edit it by hand). Tests: `tests/menu_diff_test.py` (random events through both engines, compares rows, callbacks, EEPROM batches, positions, mode), `tests/menu_engine_harness.cpp` + `tests/menu_engine_checks.inc` (EEPROM image, texts, shell pins/debounce/polarity, sign of life, set-up), `tests/mutate_menu_engine.py` (124 mutants; equivalent ones are listed in its header). Drawings and Wokwi circuit: `tools/generate_menu_test_drawings.py`. `tests/arduino_signature_lint.py` checks that no function signature uses a user-defined type (Arduino automatic prototypes). The V2 sign sketch does not contain the menu yet (AP-004).

## 10. Open items and ideas

- Planned features are listed in `DESCRIPTION.md` (section "Planned and possible features");
  currently none are decided. Update both files when something is added or built.
- The parts list (`parts-list.*`) was checked on partco.fi on 2026-11-02: the 60 LEDs/m 5 V strip (the only suitable
  one) was SOLD OUT, so check availability again; the 330 ohm 0.5 W resistor was discontinued (2 W type used);
  wire prices, solder, plate, letters and frosted plastic have no price. Re-check stock and prices before ordering.
- Real hardware and Wokwi runs are unverified; if the user reports a Wokwi problem, ask for the
  error text or a screenshot.

### Strip change under study (NOT applied to the sign's files yet)

- The designed strip (60 LEDs/m, 5 V WS2812B) is sold out at partco.fi. A white single-colour 12 V strip was
  rejected (not addressable). The candidate is partco's RGB-LEDNAUHA 30kpl/m WS2811 5m (12 V, 150 LEDs, cut every
  10 cm, SKU LED-N-RGB-W2812X150-5M, https://partco.fi/tuote/rgb-lednauha-30kpl-m-ws2812-5m-103). The product text
  is generic; evidence (12 V, cut every 10 cm, WS2811) says one chip per 3 LEDs = 50 pixels of 10 cm. The user
  was to ask partco; a question email was drafted. Unconfirmed: colour order, bit speed, current, width.
- Plan: test a short piece with `strip_test/` first (the user reports what he sees), make the main design
  independent of the pixel size (set in cm), keep the current 5 V design in the zip as a variant if the user wants.
- New plate size from the user: 60 x 30 cm, the frame strip as large as the plate (ring outer 60 x 30 cm; the user cuts
  the strip later), arrow 45 cm tip to tip and 10 cm high (the 8 cm shaft cannot be made with the current even-cap
  model), the text and the arrow share about 26 cm. With the old 16.67 mm pitch this is frame 34 + 16 LEDs per half
  (100 LEDs), arrow 64 LEDs (cap 2, base 1, wing 5, body 18), total 228 LEDs. With 10 cm pixels about 38-50 pixels.
- Open decisions asked from the user: 10 cm pixel acceptable? one or two pixels per letter? simplified line arrow?
  fix the Wokwi letter circles (they do not fit vertically)? If the 12 V strip is used: LRS-50-12 supply (4.2 A),
  5 A fuse, capacitor rated 25 V, 330 ohm data resistors stay, Arduino data 5 V (probably works, test it).
- `parts-list.*` was rebuilt on 2026-11-02 at the user's explicit request for the PLANNED 12 V colour strip, with a
  Certainty column (sure/probable/uncertain), Insurance rows (extras for the uncertain situations; total with
  insurance) and strip-test parts. The sketch and drawings still describe the 5 V design.
- Hex rotary switches (KIERTOKYTKIN-216), slide switches KYT-LIU19-B (2-pole, long knob, 0.90 EUR, user's choice
  for D2/D30; use one pole) and push button KYT-DS102-MUS (panel, 6.53 EUR) for D3 were discussed; the parts list
  was NOT updated (prices and links change only on explicit request).

## 11. Checklist before sending a result

1. All config numbers consistent: `sketch.ino` -> generators rerun -> README.txt and README-fi.txt
   numbers (LED totals, strip length, pins, current) updated.
2. Harness passes; project text is ASCII/English (except README-fi and partco product names).
3. Drawings regenerated, PDFs exported, drawings looked at.
4. `tools/__pycache__` removed; one zip of the whole folder; send only the zip with a short
   Finnish summary (what changed, new numbers, what was NOT tested).

## Rule: tests the user is asked to run
Any test the AI asks the user to run must live in its own sub-folder of the zip (e.g. strip_test/). The sub-folder must be self-contained:
its own sketch.ino, diagram.json, libraries.txt, README.txt + README-fi.txt (wiring, parts to buy), wiring-diagram (SVG+PDF) and layout-diagram (SVG+PDF).

## Sign of life rule (project-wide)
While an Arduino program runs, the debug LED on pin 13 must blink and the Serial Monitor must get one line per second with changing values (uptime, fps/loop count, state, beats). The speed (115200 baud) is stated in the comment at the top of the sketch, printed at start-up and written in the README. The LED reflects the load: normal toggle interval, shortly inverted when a state change happens, twice as fast when many state changes happen. Skip the LED and/or the serial line if the project uses that pin or the serial port for something else. Reference implementation: stick_test_direct/sketch.ino (loop(), printDebug()) and tests/stick_test_direct_harness.cpp. stick_test_direct and sketch.ino have it now (sketch.ino: signOfLife/noteEvent/printDebug before setup(); 115200 baud); add it to strip_test/ and stick_test/ the next time they are updated (user decision).

## Stick arrow geometry (2026-11-07)
See `arrow_sticks/README.txt` and `tools/arrow_geometry.py` (single source for the drill template, layout and wiring drawings; `tests/arrow_geometry_test.py` checks it). Owner's inputs: stick body 83 x 10 mm, LED window 74 x 4 mm, 2 mm between sticks, Grove connector in the middle of the stick, rails' LED rows on the 3rd LED from the top and the 3rd from the bottom of the vertical bars, drill template exact to the millimetre as a landscape PDF, layout drawing indicative. Assumptions to confirm on a real stick: LED pitch 7.4 mm, ball end (STICK_BALL_AT_DIN_END), cable hole diameter 8 mm. The stick_test* layout drawings still show the older 80 mm sketch.

## Phase 1 sign rebuild (2026-11-07)
- sketch.ino drives the 10 sticks (STICK_PINS = D2-D8, A0-A2; names in arrow_sticks/README.txt) with two routes (upper, lower) of 36 LEDs each: tail cap middle 6 LEDs (index 2..7, 3 per lane, ends dark) -> 20 rail LEDs -> 3 end LEDs of the head cap (index 2,1,0 / 7,8,9; middle 4 dark) -> 10 wing LEDs to the tip (stickFlow(), stickActive()). Pointing right: L-CAP is the tail cap, R-CAP the head cap, R-WING-* lit; pointing left: mirrored. Both caps are therefore always partly lit; only the wings of the other head are dark. Logical stick LED 0 = the BALL end (the black dot in the drawings; left-half sticks point left, right-half right, caps up). STICK_BALL_AT_DIN_END (true = ball at the DIN end, LED numbers as they are; false = the program counts from the other end) corrects the LED order for the real sticks; the sticks are mounted exactly as drawn. LCD status page shows the customer view with the arrow symbol first ("<-Customer right" / "->Customer left"; mirrored because the LCD is behind the sign). Switch D32 (ARROW_POINTS_LEFT_WHEN_LOW reverses it; harness variant + mutants cover both values): handle direction = real arrow direction; back view, GND contact on the right. Animation: palette wave + shimmer on both routes, plus a white 5-LED pulse (255,200,150,100,55) that runs tail -> tip on the upper route, then on the lower route (ARROW_PULSE_TURN = 36, period 72 ticks, exactly one pulse head at a time).
- Moved pins: frame D9/D10, letters D11, CLOSED light moved from D31 to the 11th stick on A3, arrow switch D32, button D33, casino-closed D30, speed switches D22-D29.
- Power: the Grove shield passes the Mega 5V/GND to the sticks, so the PSU +5 V feeds both Mega 5V pins; no USB while the supply is on.
- Wokwi: the arrow is drawn below the frame at the Wokwi LED size (16 px per LED); diagram.json comes from tools/generate_diagram.py. Host harness tests/harness.cpp checks pins and the flow mapping with hard-coded expectations (mutation-tested with `python3 tests/mutate.py`: 34 mutants, all detected).
- CLOSED light (2026-11-07): the 11th Grove stick, PIN_CLOSED_LIGHT = A3 (57), CLOSED_LIGHT_LEDS = 10, always white; D31 is free. Sticks only through the shield: the supply never has a wire to any stick (wiring-diagram shows "+5V, GND via the shield"). The LED window (74 mm) is narrower than the ~100 mm hole text: diffuser needed.
- Old strip arrow: backup/old_arrow_strips/ (sketch, diagram, README with the retired parts). Phase 2 is in PROGRESS.md.

## Results from the user (2026-11-06)
- stick_test_direct on real hardware: all 11 Grove sticks plugged unmodified into the Grove Base Shield with the Arduino + shield fed from the external 5 V supply work, all show the moving patterns. The user has at least 11 sticks. This settles the stick count for the arrow (10 for design B, an 11th: now the CLOSED light).
- The directory is not a git repository inside the AI workspace; the user commits the files to version control himself (a .gitignore for __pycache__ is included). No GitHub repository for this project was found on the user's account by the AI.

## Casino Open Sign V2 settings menu (2026-11-11)
`casino_open_sign_v2/sketch.ino` has a generated block between `//@V2_MENU_BEGIN` and `//@V2_MENU_END` (PROGMEM tables + the C++ menu
engine from `tools/menu_engine/engine.inc`), written by `node tools/generate_v2_menu.js` from `tools/menu-editor/menu-v2.json`
(`--check` tells if it is current). The hand-written rest of the sketch supplies `menuCallback` (applySwitches, applySpeeds,
curve rebuilds), the controls (menu hex switch legs 1, 2, 4, 8 on D38/D41/D42/D45 relative, OK D46, CANCEL D49, SHIFT D50; there is no program switch and no skip button: CANCEL also skips the power-on LED test, D33 is free) and
the LCD output (`lcdBuildText` uses `menuRows`). The old speed switches (D22-D29) are removed: the speeds and the three brightness
curves are menu properties saved in EEPROM (layout tag checked at start-up). The two slide switches update
the status properties with `menuPhysical`, which also closes an open menu. Tests: `tests/casino_open_sign_v2_harness.cpp` (a boot
mode `V2_BOOT=1` loads a saved EEPROM image), `tests/mutate_v2.py` (196 mutants, each run in both modes), `tests/menu_diff_test.py`,
`tests/menu_engine_harness.cpp`. Host only: not run on hardware or Wokwi.
Menu structure (2026-11-11): root Controls, Effects (Frame effect, Letters effect, Random delay, Monochrome), Speed (three rows Frame speed / Letters speed / Arrow speed), Frame, Letters (both start with their effect property), Arrow (each its speed + Min, Max, Exponent, Mix), Brightness (first the submenu Brightness test, then Frame/Letters/Arrow with the same properties), Restore defaults. Brightness test (REQ-019, menuRef `brightnessTest`, table index constant `MENU_REF_brightnessTest` emitted by the generator for every menuRef): Pattern (Ramp, All white, Red, Green, Blue, Level; not stored), Level (0..255, default 128, not stored) and the three curve groups; while it or anything below it is open (`brightTestActive()` looks for the menu index in the open levels) `updateBrightTest()` (every 50 ms) replaces all effects with the pattern, through `shapeColor()` of each LED type: Ramp levels 26, 51, 77, 102, 128, 153, 179, 204, 230, 255 on LED 1..10 (wiring order) of all ten sticks and the CLOSED stick, letters in reading order, frame pixels two per step; leaving it sets `arrowDarkDirty` and `lastLetterClockTick`. The layout tag stays adc94b94 (non-stored properties). Property rows are "Name: value" (value right-aligned when name + 1 + value <= 16 characters, else the whole text scrolls: pause, one character per 400 ms, end pause). OK on a read-only property opens a view page (`MM_VIEW`; row 0 name, row 1 padlock + value; CANCEL/OK returns; no timeout). The padlock is HD44780 custom character 1 (`lcdLoadLock()`, called in `lcdInit`); `tests/Wire.h` emulates CGRAM. The EEPROM layout tag is now 0xADC94B94 (effect properties added, program removed, `Change delay` renamed `Random delay`).
Menu JSON copy: `casino_open_sign_v2/menu-v2.json` is an exact copy of `tools/menu-editor/menu-v2.json` written by `tools/generate_v2_menu.js` (checked by `--check`). Scroll: a turn at the first/last item does nothing; a move away and back within `MENU_UNDO_MS` (300 ms) keeps that row's marquee phase (guards against contact bounce of the binary menu switch).
Speed properties (V2): float, logarithmic, 0.125..4.0, 30 steps (31 positions), default 1.0 at position 18, shown with 3 decimals; layout tag 0x36874F93.

Monochrome and effect 15 (REQ-021, 2026-11-12): menu property `monochrome` (yesno, stored, last row of Effects; changing the stored set changed the EEPROM layout tag to `6e5c98ef`, so the first start after upload resets saved values once). `toGrey()` copies the brightest channel to all three; `shapeShow(type, color, alwaysGrey)` = `shapeColor` of the grey when Monochrome is on or the effect is always grey; all effects (frame, letters, arrow, CLOSED light) use it, the Brightness test and the power-on LED test call `shapeColor` directly (stay coloured). Effect 15 = frame pattern 14 and `MODE_GREY_BANDS` (letters), always grey, levels 0/70/150/255: frame four phases of 36 steps (ramp, ramp reversed, even/odd opposite, 3-pixel blocks) + broken pixel (8-step burst per 50-step slot, one slot in three, hash-based, so deterministic and testable); letters three phases of 6 s (ramp, words opposite, bouncing block), each phase starts from its own beginning, the existing letter neon flicker runs on top. Tests: frame table from `tests/frame_pattern_reference.py` (own step list for mode 14), letters levels hard-coded in the V2 harness, `tests/mutate_v2.py` grey/monochrome mutants.
Monochrome default is Yes (2026-11-12, owner: grey is the standard look). The layout tag does not depend on defaults, so a sign whose EEPROM already holds Monochrome = No keeps No until it is set to Yes in the menu, Restore defaults is run, or `eeprom_clear/` is used. The V2 harness turns Monochrome off before the colour checks of the timeline.
Effect 15 Grey bands uses three levels only (0, 128, 255) since the owner's request on 2026-11-12: every phase starts with all lit (frame 8 steps, letters 1000 ms; phase 1 all half), then RAMP6 {255,255,128,128,0,0} scrolling (frame phases 0/1, letters phase 0), RAMP3 {255,128,0} (frame phase 2 even/odd opposite, letters phase 1 words opposite), frame blocks {255,128,0,128}, letters bouncing block (255 head, 128 next). The broken-pixel flicker picks 0/128/255.
Further 2026-11-12 changes (owner): default curve Max of the arrow sticks 80 -> 60 (`CURVE_DEFAULT_MAX = {80, 60, 80}`, menu JSON stickMax default 60; the CLOSED stick uses the stick curve too; the phone brightness tool keeps one default set of 80 and tests the v1 root sketch; saved EEPROM values are not changed by a new default: Restore defaults or eeprom_clear/); the power-on LED test pass 2 shows full/half/quarter grey (255/128/64 by LED number) while Monochrome is on, red-green-blue otherwise (harness env `V2_LED_COLOUR=1` runs the colour variant); effect 15 frame: the whole frame blinks out (first 6 steps of a 60-step slot, one slot in two, dark in 2 of 3 steps, hash-based); the effects themselves never produced colour on the frame (RGB always equal), the colours the owner saw were the power-on LED test.
