anttiraisala/casino-open-sign/PROGRESS.md

# PROGRESS.md - status (2026-11-07)

## Done
- 2026-11-11: Requirement texts updated after the answers to OQ-006, 007, 010, 011, 012: REQ-005 (OK-menu button name, relative menu rotary, timer only at root while browsing), REQ-007 (long row text scrolls), REQ-016 (read-only target = warning); REQ-016 status changed. Documents only; the menu engine and `menu_test/` already behave this way except the generator warning for a read-only preset target (to check).
- 2026-11-11: OQ-001..005, 008, 009 answered, OQ-011 pins accepted; OK button to be renamed OK/menu (recorded only, nothing implemented).
- 2026-11-11: OQ-006, OQ-007, OQ-010, OQ-011, OQ-012 answered by the maintainer (recorded in RDD-IDEAS.md). Documents only; no requirement text changed yet.
- 2026-11-11: OQ-013 answered by the maintainer (program switch is read all the time); REQ-013 wording changed (status changed). Documents only.
- 2026-11-11: Casino Open Sign V2: program switch SW6 (hex rotary D34-D37, read all the time), 15 letter programs (new: converge, words swap, slot machine, twin chase, marquee; F = random every 2 min) and 15 frame patterns, D33 now only skips the LED test (IDEA-015, IDEA-016, OQ-013; REQ-013 in progress, AP-007). Wiring diagram, Wokwi diagram.json (second DIP bank) and READMEs updated. Run: V2 harness, mutate_v2.py (all detected), arduino_signature_lint. Host only, not run on hardware or Wokwi. `menu_test/` unchanged.
- Sign sketch (`sketch.ino`) for the first design: 10 WS2812B strips (pins D4-D12, D31), inputs D2, D3, D30, D22-D29, I2C LCD. Simulated in Wokwi by the owner earlier.
- Drawings, parts list (snapshot 2026-11-02), host test harnesses (all four pass on a host compiler with mock libraries).
- `strip_test/` (WS2812B strip test), `stick_test/` (sticks on a separate 5 V supply, modified cables), `strip_single_led_test/` (walking pixel on three 12 V WS2811 strips, not yet run on hardware), `sticks_11_test/` (10 arrow sticks + CLOSED light stick on A3, heat test, not yet run on hardware), `strip_knight_rider_test/` (bouncing light on three 50-pixel strips, not yet run on hardware), `strip_frame_demo_test/` (18-pixel frame strip, route from the upper-left corner clockwise, with three bouncing colour lights + single pulsing pixel + 6-pixel colour bar + 10-pixel pixel test (D12), not yet run on hardware), `stick_test_direct/` (11 sticks in the Grove shield, moving patterns, sign of life).

- `arrow_sticks/`: exact 1:1 drill template (A3 PDF, or two A4 pages with half an arrow on each), indicative layout and wiring for the 10-stick arrow with named sticks; dimensions checked by `tests/arrow_geometry_test.py` (gaps, rails on LED 3 and 8, size, symmetry; mutation-tested).

## Tested
- `stick_test_direct`: run on real hardware by the owner. All 11 Grove RGB LED sticks plugged unmodified into the Grove Base Shield (D2-D8, A0-A3), Arduino + shield fed from an external 5 V supply, every stick shows its patterns. The load test (button held, all LEDs white) was not reported separately; heat and voltage drop at full load are not confirmed.
- Host harnesses: logic only (mock libraries), no AVR build, no Wokwi run by the AI.

## Not tested
- `strip_test` and `stick_test` on real hardware; the sign sketch on real hardware.

## Ball/dot package DONE (2026-11-08)
- Dot = ball of the real stick (left half left, right half right, caps up); STICK_BALL_AT_DIN_END bit in sketch.ino (+ Wokwi generator, harness variant with the bit false, 42 mutation checks); LCD shows customer view "<-Customer right"/"->Customer left"; switch D32 mounting rule (back view, GND contact on the right) in README/schematic.

## Brightness curves DONE (2026-11-08)
- Per-LED-type lookup tables (strip, stick), defaults 0/255/1.97/1.0/keepZero, setBrightnessCurve() rebuilds a table; harness + 24 new mutants. Planned next (needs "toteuta"): menu with 4 rotary encoders, 3 buttons and EEPROM storage.

- Curve defaults changed to 0/80/2.67/1.0/true; global BRIGHTNESS removed (curve max is the limit); phone tool in tools/brightness-tool/ with its defaults test.

## Plate Designer DONE (2026-11-09)
- `tools/plate-designer/`: browser tool for the front plate (boxes, letter holes, CLOSED round/slot, dimension arrows, LED strip frame, strip pieces, fonts by name, thickening, thin-part warning, preview, undo, JSON, localStorage); exports drill EPS/DXF, tiled A4/A3 PDF, letter cut EPS/DXF (as placed / nested, mirror, kerf). Core logic has a node test with a mutation test (47 mutants); a Playwright test drives the UI with a local font. Not tested: real Google Fonts loading, real plate/laser.

## Plate Designer online (prepared 2026-11-09)
- Root `index.html` redirect + `.nojekyll` + README links for GitHub Pages (https://anttiraisala.github.io/casino-open-sign/). Not live until the owner enables Pages (steps in `tools/plate-designer/README.md`); not checked whether the repository is public.

## Planned / open
- Phase 1 DONE (2026-11-07; refined the same evening: tail cap middle 6 LEDs, head cap 3 + 3 end LEDs, upper/lower routes of 36 LEDs, alternating pulse; owner saw the first version run in Wokwi and said it works): sketch.ino + diagram.json use the 10 sticks (D2-D8, A0-A2) with a simple flowing arrow animation; frame D9/D10, letters D11, switch D32, button D33; CLOSED light changed from a 6-LED strip on D31 to the 11th Grove stick (10 LEDs, A3); sign of life in sketch.ino; old strip arrow in backup/old_arrow_strips/. Not yet run in Wokwi or built for the real Arduino by the AI.
- Phase 2 (after the owner asks): sign of life in strip_test and stick_test, old stick_test* layouts to 83x10 / 74x4 mm, richer arrow animations, 12 V WS2811 redesign, versioned releases, update the account skill ar-git-repo to v4.
- Check the drill template on real sticks before drilling: print at 100 %, lay a stick on it; confirm the LED pitch, Grove connector position, DIN end and the cable hole diameter (8 mm is a guess).
- Add the sign-of-life rule to `strip_test/`, `stick_test/` (done in `sketch.ino` and `stick_test_direct/`).
- Write the full arrow program (more patterns); phase 1 has only the flow animation.
- Open: second Grove connector on the sticks?, shield 5 V switch position (user says: 5 V), final stick count (11 work), whether the partco parts list needs a refresh (only on request).
- Plate Designer: options "LED strips inside the plate" (top bar) and "plate edge as a cut line in the letter cut" added, with tests (115 mutants detected).
- Plate Designer: strips inside the plate are drawn as translucent orange dashed ghosts over the plate; 100 mm LED groups alternate in tint with clear dividers (also outside).
- Plate Designer: several holes per letter (extraHoles): add buttons per letter, double-click add/remove, drag, Delete, drill exports, PDF labels, tests + mutants (132).
- Plate Designer: plate centre lines/marker drawn; holes and strips snap to them; Ctrl while dragging disables snapping.
- Plate Designer: plate width/height changes around the plate centre (resizePlate), 143 mutants.
- Plate Designer: plate size limits 1-1000 mm (width and height), default 960 x 300; default OPEN x 580, CLOSED x 540; 149 mutants.
- Plate Designer: gold selection flash + panel scroll into view for the text elements; 156 mutants.
- Plate Designer: right/middle button pans, rubber-band and Shift/Ctrl multi-selection of texts, group move/scale, "same height" option (sameHeight); 173 mutants.
- Plate Designer: frame material calculator (frameWidth 0-100, default 30; mitred bars, perimeter and material needed, frame page in the drill PDFs + "Frame PDF (A4)"); default plate 600 x 300 with new default text/arrow positions; 188 mutants.
- Plate Designer: EPS exports rewritten for Roland CutStudio (m/l/c only, pt, y up, extra 0 0 m); the plate is centred in the Export sheet w x h; 208 mutants.
- Plate Designer: strip pieces turn freely (rotation field, drag handle with Shift 15 degree snap, R = 90 degree step); strips JSON v2 (older rot 0/90 converted); 227 mutants.
- Plate Designer: arrow drill export = outlines of the 10 LED sticks (no round holes; DXF layer ARROW); new option mirror image of the drill pattern (EPS/DXF/PDF, default off); 240 mutants.
- Plate Designer: the arrow drill export is the 74 x 4 mm LED window of each stick (size from the LED window fields shared with the CLOSED slot, written whatever the CLOSED mode); 247 mutants.
- Casino Open Sign V2 (`casino_open_sign_v2/`, 2026-11-10): sketch (frame 18 px on D11, letters 10 px on D12 with OPEN reversed, two-way frame light from the upper corners), Wokwi diagram, schematic with two supplies (5 V + 12 V), layout, layout-parts, parts list (CSV/PDF), README EN/FI, host harness + ~85 mutants all detected. Stick shield connectors re-wired for V2 only (2026-11-10): L-WING-UP D6, L-WING-DN D5, RAIL-UP-L D7, RAIL-UP-R D8, RAIL-DN-L D3, RAIL-DN-R D4, R-CAP A3, CLOSED stick A0 (L-CAP D2, R-WING-UP A1, R-WING-DN A2 as before). V2 boot I2C scan prints the found devices to Serial (2026-11-10). Not run on hardware or Wokwi; open: owner to confirm the 5 V + 12 V power plan, frame bar width/speed, colour order of the 12 V strips.
- 2026-11-10: RDD taken into use (RDD-REQUIREMENTS.md, RDD-IDEAS.md, RDD-PROGRESS.md, rules in CLAUDE.md); the planned settings menu is recorded as REQ-001..011, ideas IDEA-001..010 and open questions OQ-001..012. Documents only; nothing implemented, no code run.
- 2026-11-10: `hex_rotary_test/` added (hex rotary switch test: legs 1, 2, 4, 8 on D34-D37, C to GND; number A 2..51 on the I2C LCD; direction from the position change; LCD retry every second and re-initialisation every 5 s because the owner saw "light but no text" on the real LCDs with the Arduino on an external supply). Host test + 108 mutants pass; drawings SVG+PDF, README.txt/README-fi.txt, Wokwi diagram (DIP bank stands in for the switch). Not run on hardware or Wokwi.
- 2026-11-11: RDD-IDEAS.md: quick-pick rows that set several values (IDEA-004 extended: max 16 values, hidden properties allowed), no active-value marker (IDEA-006 narrowed), new IDEA-012 (`default` value), IDEA-013 (generator validation), IDEA-014 (one EEPROM batch). Ideas only; no requirement changed, nothing implemented.
- 2026-11-11: RDD: V2 controls and settings-menu decisions recorded as REQ-012..017; REQ-003, REQ-005, REQ-009 revised (status changed); action points AP-001..005. Documents only; nothing run.
- 2026-11-11: Menu Editor added (`tools/menu-editor/`: `menu-core.js` validation + engine, browser editor with 2 x 16 preview and JSON export, `menu-v2.json`, `tools/build_menu_editor_single.py`); published as an artifact (slug 840aef6c-fb14-4ea5-9587-4e52d8c076dd). `tests/menu_core_test.js`, `tests/mutate_menu_core.py` (127 mutants), `tests/menu_editor_ui_test.py` all pass. REQ-017 done (AP-001, AP-002). No Arduino sketch changed.
- 2026-11-11: Menu Editor: brightness menu now Strip (frame strip), Letters, Stick, each Min, Max, Exponent, Mix (mix float linear 0..1, default 1.0); REQ-015 revised (changed). Tests and 127 mutants pass; editor artifact republished. No sketch changed.
- 2026-11-11: Menu engine and hardware test: `tools/menu_engine/` (C++ engine + hardware shell + table generator), `tools/generate_menu_test.js`, `menu_test/` (sketch, Wokwi diagram, wiring and layout drawings SVG+PDF, README.txt/README-fi.txt), `tools/generate_menu_test_drawings.py`; menu editor loaded with the owner's JSON and republished; AP-003 done, AP-006 added; REQ-015 evidence (host only). Tests run: menu_core_test, mutate_menu_core 128/128, menu_editor_ui_test, menu_diff_test 18006 events 0 mismatches, menu_engine_harness, mutate_menu_engine 99/99, all older harnesses. The V2 sketch was NOT changed; not run on hardware.
- 2026-11-11: `menu_test/` compile fix: the Arduino IDE reported "'HexSwitch' does not name a type" (function signatures with user-defined structs break the automatic prototypes); `readHexRaw`, `pollHex`, `pollButton` now take an index; new `tests/arduino_signature_lint.py` catches this (it flags the old sketch); engine checks, JS/C++ difference test (12006 events, 0 mismatches) and 99 engine mutants pass again. Not compiled with the real Arduino toolchain here; the owner's compiler output was the evidence.
- 2026-11-11: Wiring diagrams of `menu_test/` and `hex_rotary_test/`: rotary switch legs 1, 2, 4, 8 and C now labelled large and bold on the switch symbol; rule added to CLAUDE.md. Owner ran `menu_test/` on the hardware: all features worked (menu navigation, entering submenus, changing values, leaving), no errors found (owner's report; REQ-015 stays `changed` until the maintainer verifies it in RDD-PROGRESS.md).
- 2026-11-11: Casino Open Sign V2: the settings menu is in the sketch (generated block, `tools/generate_v2_menu.js`; menu hex switch D42-D45, OK D48, BACK D49, SHIFT D50; EEPROM; status page per REQ-014; speeds and the three brightness curves are menu properties; SW3/SW4 on D22-D29 removed; Arrow/Casino reverse flags; random delay property with the F countdown). Menu generator: a preset on a read-only property is a warning (`menu-core.js`). `menu_test/` regenerated (arrow mapping fixed: switch LOW = pos 1). Wokwi diagram, wiring diagram and READMEs updated. REQ-005, REQ-007, REQ-012..016, AP-004. Run: V2 harness (normal + `V2_BOOT=1`), `tests/menu_diff_test.py` 36006 events, `tests/menu_engine_harness.cpp`, `tests/mutate_menu_core.py` 129/129, `tests/mutate_menu_engine.py` 99/99, `tests/menu_editor_ui_test.py`, `tests/mutate_v2.py` 171 mutants all detected. Host only; not run on hardware or Wokwi.
- 2026-11-11: Speed menu properties (Frame, Letters, Arrow) changed to a logarithmic range 0.125..4.0 with 30 steps (default 1.000 = step 18, SHIFT 10 steps, 3 decimals); EEPROM layout tag changed to 0x36874F93 so old saved values are dropped; `menu_test/` regenerated; READMEs, REQ-015. Run: menu core test, menu diff test, menu engine harness, V2 harness (normal + boot modes), menu editor UI test; `tests/mutate_v2.py` 171 mutants, `tests/mutate_menu_core.py` 129/129 and `tests/mutate_menu_engine.py` 99/99 all detected. Host only.

- 2026-11-11: Menu regrouped and renamed (Strip -> Frame, Stick -> Arrow): root Controls, Speed (Frame speed, Letters speed, Arrow speed), Frame, Letters, Arrow (each its speed + Min/Max/Exponent/Mix), Brightness (Frame/Letters/Arrow), Random program, Restore defaults. Property rows are "Name: value" (right-aligned when it fits 16 characters, otherwise the whole row scrolls); OK on a read-only property opens a view page with a padlock (custom LCD character 1, loaded at LCD init). Engine, JS core, V2 sketch, `menu_test/` regenerated; READMEs, REQ-007/010/015. EEPROM tag unchanged (property ids same). Run: menu core test, menu diff test, menu engine harness, V2 harness, `mutate_menu_core.py` 136/136, `mutate_menu_engine.py` 108/108, `mutate_v2.py` (all detected), editor UI test. Host only.
- 2026-11-11: Menu scroll fix: a turn at the first/last item never restarts the row scroll, and a move away and straight back within 300 ms (contact bounce of the binary menu switch, suspected cause of the owner's report) keeps the scroll phase (`MENU_UNDO_MS`, JS core + C++ engine). The menu JSON used for the sketch is now stored as `casino_open_sign_v2/menu-v2.json` (written by `tools/generate_v2_menu.js`, checked by `--check`); CLAUDE.md rule. REQ-007. Run: menu core test, diff test (0 mismatches), engine harness, V2 mutants all detected, core 143/143, engine 116/116, editor UI test. Host only.
- 2026-11-11: REQ-018 (live preview while editing, cancel restores value and effect) added to RDD-REQUIREMENTS.md at the owner's request; RDD-PROGRESS.md row `planned` with AP-008 (explicit tests); nothing implemented. Also discussed (not decided, nothing recorded as a requirement): single rotary switch with per-group effect selection (Frame/Letters, 0 = random, 1..15).
- 2026-11-11: IDEA-017 (single rotary switch; Frame/Letters effects 0 = random, 1..15; shared random delay; status page row 0 `F12 L03 Open`) recorded in RDD-IDEAS.md with OQ-014, OQ-015; documents only, nothing implemented.
- 2026-11-11: OQ-015 answered (effect value text `12 Slot machine`, number first); IDEA-017 notes updated; documents only.

- 2026-11-12: IDEA-017 implemented on the owner's go: the program switch (D34-D37) is removed from V2 and `menu_test/`; menu group Effects (Frame effect, Letters effect 0..15, Random delay), effects also first in the Frame and Letters groups, shared random timer, status row 0 `F12 L03 Open`, countdown while either group is random, live preview/BACK restore (REQ-005, REQ-013, REQ-014, REQ-015, REQ-018); EEPROM tag 0xADC94B94; drawings, Wokwi files, READMEs, menu JSON copy and Menu Editor artifact updated. Run: menu core test, menu diff test (36006 events, 0 mismatches), engine harness, V2 harness (all checks, also V2_BOOT modes), editor UI test, signature lint, generate --check, mutation suites core 151/151, engine 124/124, V2 190 mutants + variants all detected.
- 2026-11-12: BACK renamed CANCEL everywhere (PIN_CANCEL, MENU_KEY_CANCEL, texts, drawings, Wokwi files, READMEs, editor, tests); then the V2 skip button SW2/D33 was removed: CANCEL (D49) skips the power-on LED test (only a new press counts), LCD text `press CANCEL to skip`, `Test skipped` notice for 1.5 s (REQ-005). Run: core test, diff test (36006 events), engine harness, V2 harness (+ boot mode), editor UI test, signature lint, mutation suites core 151/151, engine 124/124, V2 196 mutants all detected (2 equivalent ones documented).
- 2026-11-12: pins spread out on the owner's request (easier to unplug sockets): V2 frame D11 -> D12, letters D12 -> D10, menu hex switch legs 1, 2, 4, 8 D42-D45 -> D38, D41, D42, D45, OK D48 -> D46 (CANCEL D49, SHIFT D50, arrow D32, casino D30 unchanged); `menu_test/` follows for the menu switch and OK; sketches, generated menu_test sketch, Wokwi `diagram.json`, wiring/layout drawings (SVG + PDF), READMEs (EN + FI), CLAUDE.md, AI_CONTEXT.md, DESCRIPTION.md, tests and mutation patterns updated; REQ-005 revision note. Ran: V2 harness, menu diff test (36006 events), menu core/engine/UI tests, signature lint, `tests/mutate_v2.py` (199 detected, 0 survived), `tests/mutate_menu_engine.py` 124/124. Host only; not run on hardware or Wokwi.
- 2026-11-12: Brightness test mode (IDEA-018 -> REQ-019) on the owner's go: menu Brightness > Brightness test (Pattern Ramp/All white/Red/Green/Blue/Level, Level 0..255, the three curve groups inside; not stored, EEPROM layout tag unchanged); V2 sketch shows the pattern on all LEDs through the brightness curves while it is open (ramp 26, 51, 77, 102, 128, 153, 179, 204, 230, 255); generator emits `MENU_REF_<id>` constants; `casino_open_sign_v2/menu-v2.json` updated; Menu Editor republished to the same link; README EN+FI, CLAUDE.md, AI_CONTEXT.md, DESCRIPTION.md, RDD files updated. Ran: V2 harness, menu core/diff/engine/UI tests, signature lint, `tests/mutate_v2.py` (225 detected, 0 survived), `tests/mutate_menu_core.py` 151/151, `tests/mutate_menu_engine.py` 126/126. Host only; not run on hardware or Wokwi.
- 2026-11-12: EEPROM clear tool (IDEA-019 -> REQ-020) after the owner asked whether an upload clears the EEPROM (it does not): new folder `eeprom_clear/` (sketch, README EN + FI, wiring drawing SVG + PDF, Wokwi diagram.json), generator `tools/generate_eeprom_clear.py`, `tools/export_pdf.py` list, EEPROM mock got `length()` and a `stuck` hook, V2 README EN + FI note, CLAUDE.md and AI_CONTEXT.md. Ran: `tests/eeprom_clear_harness.cpp`, `tests/mutate_eeprom_clear.py` (52 detected, 0 survived), V2 harness and menu engine harness again with the changed mock. Host only; not run on hardware or Wokwi.
- 2026-11-12: Monochrome property and grey effect 15 (IDEA-020 -> REQ-021) on the owner's go: menu Effects > Monochrome (No/Yes, stored; layout tag now `6e5c98ef`, saved values reset once on the first start), `toGrey`/`shapeShow` (brightest channel) for frame, letters, arrow and CLOSED light, Brightness test and LED test stay coloured; effect 15 of frame and letters is now "Grey bands" (always grey, levels 0/70/150/255, four frame phases + broken pixel, three letter phases + the neon flicker; Dashes/Marquee removed). Menu JSON, generated menu block and `menu_test/`, Menu Editor republished (same link), V2 README EN + FI, CLAUDE.md, AI_CONTEXT.md, RDD files. Ran: `tests/casino_open_sign_v2_harness.cpp`, `tests/menu_core_test.js`, `tests/menu_engine_harness.cpp`, `tests/menu_diff_test.py` (0 mismatches), `tests/menu_editor_ui_test.py`, `tests/mutate_v2.py` (254 mutants, all detected; the 1 equivalent frame mutant removed and documented), `tests/mutate_menu_core.py` 151/151, `tests/mutate_menu_engine.py` 126/126. Host only; not run on hardware or Wokwi.
- 2026-11-12: Monochrome default changed from No to Yes (REQ-021) on the owner's request. Menu JSON, generated menu block, `menu_test/`, `menu-v2.json` copy, Menu Editor, READMEs, CLAUDE.md, AI_CONTEXT.md, tests adapted. Ran: V2 harness (+ boot modes), `tests/menu_core_test.js`, `tests/menu_engine_harness.cpp`, `tests/menu_diff_test.py`, `tests/menu_editor_ui_test.py`, `tests/mutate_menu_core.py` 151/151; `tests/mutate_v2.py` 254 mutants all detected, `tests/mutate_menu_engine.py` 126/126. Host only.
- 2026-11-12: Effect 15 Grey bands reduced to three levels (off, half 128, full 255) on the owner's request (REQ-021): every phase starts with all lit (frame 8 steps, letters 1 s; phase 1 all half), then scrolling off/half/full patterns, words opposite, bouncing block; broken-pixel flicker picks 0/128/255. Sketch, `tests/frame_pattern_reference.py`, V2 harness tables, mutants, READMEs EN+FI, CLAUDE.md, AI_CONTEXT.md, RDD-REQUIREMENTS.md. Ran: V2 harness (+ boot modes), `tests/mutate_v2.py` (all mutants detected, the 2 static-assert compile-error mutants as before). Menu JSON unchanged. Host only; not run on hardware or Wokwi.
- 2026-11-12: Owner's three changes (REQ-021): (1) default curve Max of the arrow sticks 80 -> 60 (25 % less; menu JSON `stickMax` default and `CURVE_DEFAULT_MAX = {80, 60, 80}`; the CLOSED stick shares the stick curve); (2) the frame never shows colour in the effects (RGB always equal, checked every frame show in the harness), the colours seen were the power-on LED test, which now shows only greys (255/128/64) while Monochrome is on; (3) effect 15 frame: the whole frame blinks out now and then. Menu JSON, generated block, `menu_test/`, `menu-v2.json`, Menu Editor (republished), tests, mutants, READMEs EN+FI, CLAUDE.md, AI_CONTEXT.md, RDD-REQUIREMENTS.md. Ran: V2 harness (+ boot modes + `V2_LED_COLOUR=1`), `tests/menu_core_test.js`, `tests/menu_engine_harness.cpp`, `tests/menu_diff_test.py`, `tests/menu_editor_ui_test.py`, `tests/mutate_v2.py` (270 mutants, all detected), `tests/mutate_menu_core.py` 151/151, `tests/mutate_menu_engine.py` 126/126. Host only; not run on hardware or Wokwi.
