anttiraisala/casino-open-sign/RDD-IDEAS.md

# RDD-IDEAS
Raw ideas and open questions (RDD = Requirement Driven Development). An idea becomes a requirement only when the maintainer accepts it.

| ID | Idea | Status | Notes |
|----|---|---|---|
| IDEA-001 | Text (string) property type: a charset rolled forward with the rotary switch, SHIFT jumps to the next character group (upper case, lower case, digits, symbols); OK moves to the next character, BACK to the previous. | new | Maintainer: not needed yet. Check against the LCD character ROM when it is built. |
| IDEA-002 | Logarithmic scale for ranges that cross zero (a linear zone around zero). | new | AI proposal; a negative-only range can be handled by mirroring. |
| IDEA-003 | A separate `onCommit` callback that runs only after OK (heavier work), next to the per-step callback. | new | AI proposal. |
| IDEA-004 | A quick-pick row sets several properties at once, as a list of property = value pairs (e.g. "Calm mode": A = 5, B = 14, max brightness = 40). The values are all set first and the callbacks shared by those properties then run once. Maximum 16 values per quick-pick. A quick-pick may also set a property that is not shown in the menu (but exists). A quick-pick refers only to properties, never to another quick-pick (no loops). | new | Maintainer 2026-11-11: max 16 values, hidden properties allowed. Rest AI proposal. |
| IDEA-005 | The generator prints a table of every menu row: shown text and what the row really does. | new | AI proposal, to catch misleading friendly texts. |
| IDEA-006 | After a quick-pick: a short confirmation on the LCD. A destructive quick-pick (for example restore defaults) first asks OK / BACK. | new | AI proposal. Maintainer 2026-11-11: NO marker on the row whose values are currently active (that part of the idea is dropped). |
| IDEA-007 | A bound control that changes a value shows a short toast page on the LCD (name and new value). | new | AI proposal. |
| IDEA-008 | EEPROM write protection: a value changed quickly by a dial is saved only after it has stayed unchanged for about two seconds. | new | AI proposal; EEPROM lasts about 100 000 writes per cell. |
| IDEA-009 | The existing inputs of the sign (arrow switch, casino closed switch, mode button, speed switches) become bindings of the same mechanism. | new | AI proposal; changes working code, only on request. |
| IDEA-010 | An I2C I/O expander on D20/D21 if the Mega runs out of pins for controls. | new | AI proposal. |
| IDEA-011 | Read the hex rotary switch with only two legs (1 and 2) to save pins: gives the direction (mod 4) but not the absolute position, and a fast turn is ambiguous. The Mega has many free pins, so `hex_rotary_test/` uses all four legs. | new | AI proposal after the owner's question 2026-11-10; the hardware test decides. |
| IDEA-012 | A quick-pick value may be the word `default`, meaning the default value of that property from its definition (`{"A": "default"}`), so restoring defaults does not copy the values into a second place. A ready-made row "Restore all defaults" goes through every property (more than 16 values allowed there because the generator builds it, not the author). | new | AI proposal 2026-11-11, from the quick-pick discussion. |
| IDEA-013 | The generator rejects a quick-pick whose value is outside the limits (or not on the step grid of a log property), whose property does not exist, or that has more than 16 values; a read-only target is OQ-012. | new | AI proposal 2026-11-11. |
| IDEA-014 | A quick-pick that changes several values writes them to EEPROM as one batch, not one write per value (see IDEA-008). | new | AI proposal 2026-11-11. |
| IDEA-015 | Five new letter programs (positions 10..14 of the program switch): 10 converge (each word lights from both ends towards its middle, holds, goes dark), 11 words swap (the two words breathe in opposite phase), 12 slot machine (letters flicker like reels and lock in one by one, left to right, hold, dark), 13 twin chase (two dim letters run through all letters in opposite directions), 14 marquee (three letters lit, one dark, moving). Programs 0..9 are the existing ten patterns; position F is random auto (never the same twice, new program every 2 min). | promoted (implemented as proposed, maintainer 2026-11-11: "implement them as such, I will think about them when I see them live") | Maintainer asked the AI to write the proposals here and implement them unchanged; he will judge them on the real sign. Implemented in `casino_open_sign_v2/sketch.ino`, host tests only. |
| IDEA-016 | Fifteen frame patterns, one per program (white): 0 bar (2 lit, 2 dark) from the arrow's start corner both ways (the existing pattern, follows the arrow); 1 comet with a 5-pixel tail once round the frame (follows the arrow); 2 fills from the start corner both ways, holds, off (follows the arrow); 3 pixels start up one by one, flickering; 4 top and bottom steady, sides blink; 5 odd and even pixels alternate; 6 one comet ping-pongs round the frame (follows the arrow); 7 random twinkle; 8 one lit pixel in three runs round (follows the arrow); 9 heartbeat of the whole frame; 10 corners light first, then the edges fill in; 11 long edges and side edges alternate; 12 slot machine: pixels spin then lock one by one; 13 twin comets run apart from the start corner (follows the arrow); 14 two lit, one dark, running round (follows the arrow). | promoted (implemented as proposed, maintainer 2026-11-11) | Same decision as IDEA-015. A pattern that "follows the arrow" starts at the arrow's start corner (right: upper-left, left: upper-right) and runs in the arrow direction (right: clockwise, left: counter-clockwise). |
| IDEA-017 | One rotary switch only: the program switch (D34-D37) is dropped and the effects are chosen in the menu. Group "Effects" with two properties, Frame effect and Letters effect (also under the Frame and Letters menus; one value, two places), each 0..15: 0 = random, 1..15 = the 15 effects (old programs 0..14 shifted by one, names such as 1 Breathe .. 15 Marquee for letters), default 1, no wrap. Name "Effect" chosen by the maintainer (2026-11-11). Random: one shared change delay (menu "Random delay"); when it fires only the groups that are set to 0 pick a new effect (each its own, never the same twice in a row); a fixed effect never changes by itself. Values live-preview while editing and BACK restores (REQ-018) and are saved in EEPROM on OK. Status page row 0 becomes `F12 L03 Open` / `F12 L03 Closed` (F = frame effect, L = letters effect, `*` before the number when it is random and now drawn, e.g. `F*07`); row 1 unchanged, `Change in M:SS` alternates there while a group is random (maintainer chose this row 0, 2026-11-11). Would change REQ-012, REQ-013, REQ-014, REQ-015. | promoted -> REQ-013 (also changes REQ-005, REQ-014, REQ-015) | Implemented 2026-11-12 on the maintainer's go ("Joo, poistetaan"): program switch removed from V2 and menu_test. Value text: number first with the name, e.g. `12 Slot machine` (accepted 2026-11-11, OQ-015). The quick-dial idea (status page edits a property) was dropped by the maintainer. OQ-014 answered. The frame effects have no names yet (the status page shows numbers only). |
| IDEA-018 | Brightness test mode: under Brightness a submenu "Brightness test" shows a fixed pattern on every LED (Ramp of 10 steps, All white, Red, Green, Blue, Level) so the brightness curves can be judged while they are edited. | promoted -> REQ-019 | Maintainer chat 2026-11-12: ramp steps equally spaced 26..255 (255 x step / 10), sticks LED by LED, letters in reading order, frame 18 pixels two per step; the curve properties live inside the test submenu; pattern and level not saved. |
| IDEA-019 | EEPROM clear tool: a USB upload does not clear the EEPROM, so a separate sketch `eeprom_clear/` sets every EEPROM byte to 0xFF once, to start the sign from nothing. | promoted -> REQ-020 | Maintainer chat 2026-11-12 ("if it does not clear, add a tool to clear the EEPROM"). |
| IDEA-020 | Monochrome property and a grey effect 15: menu Effects > Monochrome (No/Yes, stored) shows every effect as grey levels (brightest channel); effect 15 of the frame and the letters is replaced by "Grey bands", always grey, four grey levels, movement first, with a broken-light flicker. | promoted -> REQ-021 | Maintainer chat 2026-11-12 ("toteuta commit push"); owner answered the design questions by go: both groups, always grey, name Grey bands (my defaults). |

## Open questions
- OQ-001: Does a value change live while editing (callbacks on every step, BACK restores the old value)? Assumed yes. ANSWERED 2026-11-11: Yes.
- OQ-002: Wrap period: min and max count as two separate values (255 + 1 = 0, Z + 1 = A). Assumed yes. ANSWERED 2026-11-11: Yes.
- OQ-003: Default shift step: 16 times the normal step, at most one fifth of the number of steps, overridable per property (`shiftStep`). OK? ANSWERED 2026-11-11: Yes.
- OQ-004: Logarithmic scale: min > 0 required, negative-only ranges by mirroring, ranges crossing zero not supported (see IDEA-002). OK? ANSWERED 2026-11-11: Yes.
- OQ-005: Menu data: the JSON file is turned into tables by a generator at build time (recommended: checks at build time, no JSON parser on the Mega), or the JSON text is embedded in the sketch and parsed at start-up? ANSWERED 2026-11-11: Yes (generator at build time).
- OQ-006: Does the display return to the status pages after some inactivity (how long), and is an unfinished edit then cancelled? ANSWERED 2026-11-11: no, the display does not return to the status pages by itself (so there is no inactivity timeout and no automatic cancel of an edit). REVISED 2026-11-11: an inactivity timer exists, but only at the menu root while browsing (nothing opened for viewing or editing, no edit, no confirm page); then the display returns to the status pages. Elsewhere there is no timeout. This matches the current engine (TIMEOUT_MS 60000, `mode menu` and `stack.length === 1`); the 60 s value itself is still to be decided. Timeout 60 s accepted 2026-11-11 (remaining seconds shown on the display, as in menu_test).
- OQ-007: A rotary switch bound to a property: absolute or relative as the default, and at boot does the physical position win over the saved value? ANSWERED 2026-11-11: the program switch selects absolutely (the position is the program, not stored, so the position always wins); menu selection by rotary is relative. Still open: any other rotary bound to a stored property (none planned).
- OQ-008: While a property is edited in the menu, controls bound to it are ignored (the menu wins). OK? ANSWERED 2026-11-11: Yes (the menu wins).
- OQ-009: Texts on the LCD are English under the repository rule; Finnish texts need an explicit exception. ANSWERED 2026-11-11: For now no Finnish texts are needed (English only).
- OQ-010: A row text longer than 16 characters: build error, or scrolling text? ANSWERED 2026-11-11: scrolling text.
- OQ-011: Which program gets the menu (Casino Open Sign V2 assumed), and which hex switches, buttons (OK, BACK, SHIFT) and pins are used? ANSWERED 2026-11-11: the menu goes into Casino Open Sign V2. Hex switches, buttons and pins beyond D34-D37 (program) are still to be fixed. Pins D34-D37 accepted 2026-11-11. The OK button is renamed OK/menu (not yet applied to REQ-005, the editor, menu_test or the V2 sketch). Naming: the LCD/UI always says OK; documentation may call it the OK-menu button.
- OQ-012: A quick-pick row that targets a read-only property: warning or error? ANSWERED 2026-11-11: warning (at build time); the row does not try to set the read-only property.
- OQ-013: REQ-013 says the program switch is read at boot. The sign and `menu_test/` read it all the time (turning it changes the program at once, and closes the menu in the test), which is what the maintainer tried and approved on the test. ANSWERED 2026-11-11: read all the time; REQ-013 wording changed.
- OQ-014: Is the program switch (D34-D37) already wired on the real sign? ANSWERED 2026-11-11: not wired; the switch was removed from V2 and `menu_test/` entirely.
- OQ-015: Effect value text: number first with the name, e.g. `12 Slot machine`, scrolling. ANSWERED 2026-11-11: accepted by the maintainer.
