anttiraisala/casino-open-sign/RDD-PROGRESS.md

# RDD-PROGRESS
Current status of every requirement with action points and evidence (RDD = Requirement Driven Development).
Statuses: planned, in progress, done, verified, changed, dropped.

| ID | Status | Evidence |
|----|---|---|
| REQ-001 | planned | - |
| REQ-002 | planned | - |
| REQ-003 | changed | - |
| REQ-004 | planned | - |
| REQ-005 | done | 2026-11-11, host only (V2 sketch with the menu): `tests/casino_open_sign_v2_harness.cpp` drives the menu switch D42-D45 (relative steps 1..7 / 9..15, 8 ignored, SHIFT bigger step) and OK D48, BACK D49, SHIFT D50 through the sketch; `tests/menu_diff_test.py` 36006 events identical in JS and C++; `tests/mutate_v2.py` 171 mutants all detected (each also run in the boot modes with a saved, a wrong-tag and an out-of-range EEPROM image), `tests/mutate_menu_engine.py` 99/99. The hex switch itself works on the owner's hardware in `menu_test/` (owner's report). The V2 sketch is not run on hardware or Wokwi; not verified. 2026-11-12 (effects menu, program switch removed; IDEA-017): host only: `tests/casino_open_sign_v2_harness.cpp` (effects, shared random timer, status rows, countdown, live preview and BACK restore, no program pins), `tests/menu_core_test.js`, `tests/menu_diff_test.py` 36006 events 0 mismatches, `tests/menu_engine_harness.cpp`, `tests/menu_editor_ui_test.py`, `tests/mutate_menu_core.py` 151/151, `tests/mutate_menu_engine.py` 124/124, `tests/mutate_v2.py` 190 mutants (see PROGRESS.md). Not run on hardware or Wokwi; not verified. 2026-11-12 (CANCEL rename, SW2/D33 removed): host only: V2 harness (CANCEL skips the LED test, OK/SHIFT/arrow switch do not, held button does not, `Test skipped` notice 1.5 s), core/diff/engine/UI tests, `tests/mutate_v2.py` 198 mutants, core 151/151, engine 124/124. Not run on hardware; not verified.  2026-11-12 (pins spread out: menu switch D38/D41/D42/D45, OK D46, frame D12, letters D10): host only: V2 harness with the new pin asserts, `tests/menu_diff_test.py` 36006 events 0 mismatches, core/engine/UI tests, `tests/mutate_v2.py` 199 mutant lines detected and none survived (pin mutants updated), `tests/mutate_menu_engine.py` 124/124; drawings and Wokwi files regenerated. Not run on hardware or Wokwi; not verified. |
| REQ-006 | planned | - |
| REQ-007 | changed | 2026-11-11, host only (V2 sketch with the menu): row texts, quick-pick rows and scrolling long text checked by `tests/menu_engine_harness.cpp` and `tests/menu_diff_test.py`; V2 menu rows through `menuRows` in the V2 harness. Not run on hardware; not verified. 2026-11-11 (menu regroup, view page, whole-row scroll): menu core test, menu diff test (0 mismatches), menu engine harness, `tests/mutate_menu_core.py` 136/136, `tests/mutate_menu_engine.py` 108/108, V2 harness, `tests/mutate_v2.py` all mutants detected, editor UI test; 2026-11-11 later: scroll kept at list ends / after contact bounce (core 143/143, engine 116/116 mutants, diff test 0 mismatches). Host only, not verified. |
| REQ-008 | planned | - |
| REQ-009 | changed | - |
| REQ-010 | changed | - 2026-11-11 (menu regroup, view page, whole-row scroll): menu core test, menu diff test (0 mismatches), menu engine harness, `tests/mutate_menu_core.py` 136/136, `tests/mutate_menu_engine.py` 108/108, V2 harness, `tests/mutate_v2.py` all mutants detected, editor UI test. Host only, not verified. |
| REQ-011 | planned | - |
| REQ-012 | done | 2026-11-11, host only (V2 sketch with the menu): V2 harness: Arrow reverse and Casino reverse invert the switches (also after a boot with the saved flag), D22-D29 and the mode button no longer read (D33 only skips the LED test), speeds and curves change only through properties. Not run on hardware or Wokwi; not verified. |
| REQ-013 | changed | Host only (2026-11-11): V2 sketch reads the program switch D34-D37 (positions 0..E, F random), 15 letter programs and 15 frame patterns; `tests/casino_open_sign_v2_harness.cpp` with hard-coded tables from the independent `tests/frame_pattern_reference.py` passes, `tests/mutate_v2.py` all mutants detected.  Random delay property (Change delay, default 2 min, 0 = random 1..30) and the F countdown are checked in the V2 harness. Not run on hardware or Wokwi; not verified. 2026-11-12 (effects menu, program switch removed; IDEA-017): host only: `tests/casino_open_sign_v2_harness.cpp` (effects, shared random timer, status rows, countdown, live preview and BACK restore, no program pins), `tests/menu_core_test.js`, `tests/menu_diff_test.py` 36006 events 0 mismatches, `tests/menu_engine_harness.cpp`, `tests/menu_editor_ui_test.py`, `tests/mutate_menu_core.py` 151/151, `tests/mutate_menu_engine.py` 124/124, `tests/mutate_v2.py` 190 mutants (see PROGRESS.md). Not run on hardware or Wokwi; not verified. |
| REQ-014 | changed | 2026-11-11, host only (V2 sketch with the menu): V2 harness checks the status rows for the program, casino and arrow combinations, the ROM arrow characters 0x7F/0x7E and the F countdown `Change in M:SS`. The arrow characters on the real display are still unchecked (AP-005). Not verified. 2026-11-12 (effects menu, program switch removed; IDEA-017): host only: `tests/casino_open_sign_v2_harness.cpp` (effects, shared random timer, status rows, countdown, live preview and BACK restore, no program pins), `tests/menu_core_test.js`, `tests/menu_diff_test.py` 36006 events 0 mismatches, `tests/menu_engine_harness.cpp`, `tests/menu_editor_ui_test.py`, `tests/mutate_menu_core.py` 151/151, `tests/mutate_menu_engine.py` 124/124, `tests/mutate_v2.py` 190 mutants (see PROGRESS.md). Not run on hardware or Wokwi; not verified. |
| REQ-015 | changed | 2026-11-11: menu JSON updated, editor tests pass. Host evidence: `tests/menu_diff_test.py` 36006 events, `tests/menu_engine_harness.cpp`, `tests/mutate_menu_engine.py` 99/99; the V2 sketch now contains the generated menu (`tools/generate_v2_menu.js --check` up to date) and the V2 harness checks it (speeds, curves, random delay, 60 s timer, EEPROM save and boot load). `menu_test/` ran on the owner's hardware (owner's report: all features worked). The V2 sketch is not run on hardware; not verified. Speed range 0.125..4, 30 log steps, 3 decimals (2026-11-11): host tests updated and passing (`tests/menu_core_test.js`, `tests/menu_engine_harness.cpp`, V2 harness, `tests/menu_editor_ui_test.py`); layout tag now 0x36874F93. Not verified. 2026-11-11 (menu regroup, view page, whole-row scroll): menu core test, menu diff test (0 mismatches), menu engine harness, `tests/mutate_menu_core.py` 136/136, `tests/mutate_menu_engine.py` 108/108, V2 harness, `tests/mutate_v2.py` all mutants detected, editor UI test. Host only, not verified. 2026-11-12 (effects menu, program switch removed; IDEA-017): host only: `tests/casino_open_sign_v2_harness.cpp` (effects, shared random timer, status rows, countdown, live preview and BACK restore, no program pins), `tests/menu_core_test.js`, `tests/menu_diff_test.py` 36006 events 0 mismatches, `tests/menu_engine_harness.cpp`, `tests/menu_editor_ui_test.py`, `tests/mutate_menu_core.py` 151/151, `tests/mutate_menu_engine.py` 124/124, `tests/mutate_v2.py` 190 mutants (see PROGRESS.md). Not run on hardware or Wokwi; not verified. |
| REQ-016 | done | 2026-11-11, host only (V2 sketch with the menu): `tests/menu_core_test.js`: a preset on a read-only property gives a warning and the target is dropped; `tests/mutate_menu_core.py` 129/129 mutants; V2 harness: Restore defaults sets every stored value, one callback batch, one EEPROM write. Not run on hardware; not verified. |
| REQ-017 | done | 2026-11-11: `tests/menu_core_test.js` passes (V2 menu valid, loop and read-only quick-pick rejected, 16-character rows, EEPROM image), `tests/mutate_menu_core.py` 128/128 mutants detected, `tests/menu_editor_ui_test.py` passes (also for the single-file page; JSON round trip). Published as an artifact. Not yet verified by the maintainer. |
| REQ-018 | done | 2026-11-12, host only: V2 harness turns the Frame/Letters effect while editing (effect shows at once, only that group changes), BACK restores value and effect, OK accepts and saves to EEPROM; JS core and C++ engine tests cover callbacks per turn and BACK (menu_core_test, menu_engine_checks). Not run on hardware; not verified. |
| REQ-019 | done | 2026-11-12, host only: `tests/casino_open_sign_v2_harness.cpp` (Ramp with identity curves: exact levels 26..255 on every stick LED, the CLOSED stick, the letters in reading order and the frame two pixels per step; all ten sticks lit; All white/Red/Green/Blue/Level patterns; live turning and CANCEL restore of Pattern and Level; Max 80 on all three LED types; editing the frame Max inside the submenu changes the pattern at once; mode off in the Brightness group, ends by CANCEL out of the submenu and by the arrow switch; no timeout inside; letter clock does not jump; nothing written to EEPROM), `tests/menu_core_test.js` (menu structure, props not stored, layout tag unchanged), `tests/menu_engine_checks.inc` (generated `MENU_REF_` indexes), `tests/menu_diff_test.py` 36006 events 0 mismatches, `tests/menu_editor_ui_test.py`, `tests/mutate_v2.py` 225 mutant lines detected and none survived (26 new brightness-test mutants), `tests/mutate_menu_core.py` 151/151, `tests/mutate_menu_engine.py` 126/126. Not run on hardware or Wokwi; not verified. |
| REQ-020 | done | 2026-11-12, host only: `tests/eeprom_clear_harness.cpp` (7 used bytes, an empty EEPROM writes nothing, a full EEPROM writes 1024, first and last byte, a stuck byte gives FAILED text + fast LED + `state=FAIL`, slow LED 500 ms, one DBG line per second with the exact text, baud 115200), `tests/mutate_eeprom_clear.py` 52 mutants, 52 detected, none survived. Not run on the real Mega or in Wokwi; not verified. |
| REQ-021 | done | 2026-11-12, host only: `tests/casino_open_sign_v2_harness.cpp` (toGrey/shapeShow, Monochrome on/off on all LEDs, Brightness test stays coloured, frame grey bands vs `tests/frame_pattern_reference.py`, letters grey bands in three phases), `tests/menu_core_test.js`, `tests/menu_engine_checks.inc`, mutation tests (see PROGRESS.md). Not run on hardware or Wokwi; not verified. |

Action points are added per requirement when the maintainer asks for them.

## REQ-017 action points
- [x] AP-001 Menu JSON format and core logic (`tools/menu-editor/menu-core.js`) with host test and mutation test
- [x] AP-002 Browser editor with display preview and JSON export, UI test, published link
- [x] AP-003 Generator JSON -> PROGMEM tables and C++ menu engine (`tools/menu_engine/`, `tools/generate_menu_test.js`) with the hardware test `menu_test/` (evidence under REQ-017)

## REQ-012..016 action points
- [x] AP-007 (2026-11-11) V2 sketch: program switch D34-D37, 15 letter programs (5 new) and 15 frame patterns, mode button D33 only skips the LED test; host tests and mutation tests (evidence under REQ-013). (The SW3/SW4 removal, status page and menu followed under AP-004.)
- [x] AP-004 (2026-11-11) V2 sketch: menu switch D42-D45 (moved to D38/D41/D42/D45 on 2026-11-12), OK D48 (now D46), CANCEL D49 (was BACK), SHIFT D50, generated menu tables (`tools/generate_v2_menu.js`), status page, EEPROM, speeds and brightness curves as menu properties, SW3/SW4 removed (host tests and mutation tests; evidence under REQ-005..016). Not run on hardware.
- [ ] AP-005 Test the LCD ROM arrow characters on the real display (part of running `menu_test/` on the hardware)
- [ ] AP-006 Run `menu_test/` on the hardware and write down the results (owner)

## REQ-018 action points
- [x] AP-008 (2026-11-12, effect tests in the V2 harness) Add explicit host tests (JS core, C++ engine, V2 harness): callbacks per turn while editing, none written to EEPROM until OK, BACK restores and calls the callbacks again; add mutants

## REQ-019 action points
- [x] AP-009 (2026-11-12) Menu JSON: submenu Brightness test (Pattern, Level, three curve groups) first in Brightness; generator emits `MENU_REF_<id>` constants; V2 sketch test pattern (`brightTestActive`, `updateBrightTest`); host tests in the V2 harness, JS core and C++ engine, mutants in `tests/mutate_v2.py` and `tests/mutate_menu_engine.py`.
- [ ] AP-010 Try the Brightness test on the real sign and judge the patterns (owner).

## REQ-020 action points
- [x] AP-011 (2026-11-12) Sketch `eeprom_clear/sketch.ino`, README EN+FI, wiring drawing (USB only, SVG + PDF), Wokwi `diagram.json`, host harness and mutation test.
- [ ] AP-012 Run the tool on the real Mega and check the Serial Monitor text and the LED (owner).

## REQ-021 action points
- [x] AP-013 (2026-11-12) Menu JSON: Monochrome (yes/no, stored, last row of Effects); effect 15 renamed Grey bands; sketch `toGrey`/`shapeShow`, frame pattern 14 and letters mode 14 rewritten; tests, mutants, docs, Menu Editor republished.
- [ ] AP-014 Judge Monochrome and the grey bands (movement, flicker) on the real sign (owner).
