anttiraisala/casino-open-sign/tools/plate-designer/index.html

UndoRedo +-Fit Preview

### Plate (vinyl)

Width mm

Height mm

Frame width mm

Hole ⌀ mm

One diameter for all letter holes and the round CLOSED hole (10 mm = 6 wires).

LED strips inside the plate

Min stroke mm

### Texts

### Arrow

Fixed size 349.76 x 102.32 mm, 10 cable holes (8 mm) from arrow_geometry.py. Drag the box.

### LED strip frame (outside the plate)

Layout

### Strip pieces behind the letters

Add 100 x 10 mm pieceTurn 90° (R)Delete

Rotation °

### View

Dimensions

snap to centre lines (3 mm, Ctrl = off) grid and rulers

Drag: boxes, holes, strips. Wheel: zoom. Drag background: pan. Arrows: nudge 1 mm (Shift 10, Alt 0.1). R: turn the strip 90 degrees; drag the round handle at its end (Shift = 15 degree steps) or type the angle to turn it freely. Del: delete strip.

### Export

CLOSED hole

LED window w x h mm

plate outline in the drill pattern arrow LED windows in the drill pattern mirror image of the drill pattern (EPS, DXF, PDF) letters, arrow and labels in the drill PDF distances to all plate edges around every hole (PDF)

Drill pattern EPSDrill PDF A4Drill PDF A3Frame PDF (A4)Drill DXF

mirror the letters (cut from the back) dashed bounding boxes plate edge as a cut line in the letter cut nest the letters on a raw sheet

Kerf mmspacing

Sheet w x h mm

Letter cut EPSLetter cut DXF

Downloads can be blocked (for example inside a published page): every export is also shown here as text, to copy into a file with the same name.

Copy

### Layouts

Save

LoadDelete

Reset to defaults

### JSON (copy / paste)

Copy JSON from appPaste clipboard into app

Apply edited JSON

Fonts are stored by name only; they are fetched from Google Fonts when used (needs the network).
