anttiraisala/casino-open-sign/arrow_sticks/layout-diagram.pdf

## Stick arrow - layout (indicative; exact dimensions: drill-template-A3.pdf)

10 Grove RGB LED sticks, each 83 x 10 mm with 74 x 4 mm LED window, 2 mm between the sticks; arrow 349.8 x 102.3 mm

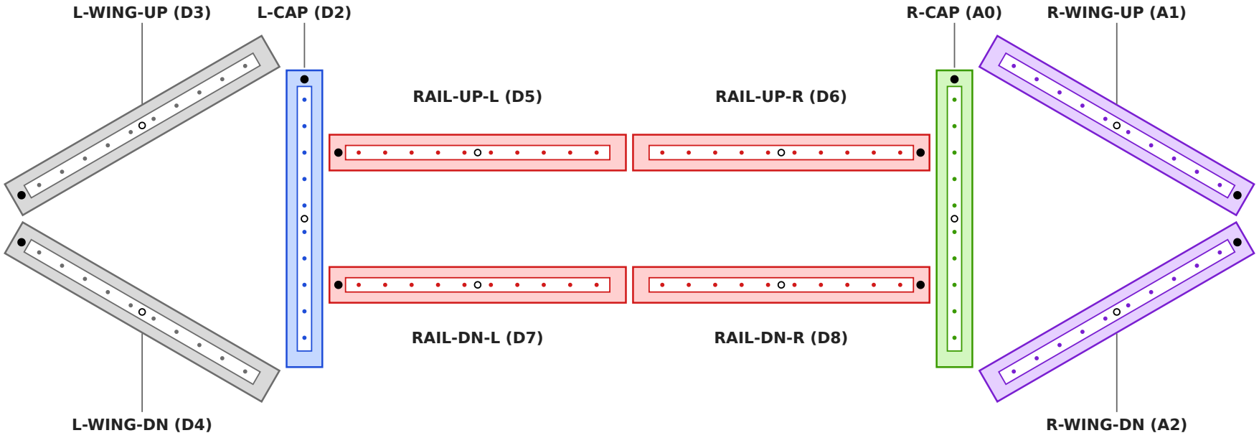
[picture p2: figure]
L-WING-UP (D3); L-CAP (D2); L-WING-DN (D4); RAIL-UP-L (D5); RAIL-UP-R (D6); RAIL-DN-L (D7); RAIL-DN-R (D8); R-CAP (A0); R-WING-UP (A1); R-WING-DN (A2)

### Stick names, positions and Grove Base Shield connectors

L-CAP D2 left vertical bar
L-WING-UP D3 left upper wing
L-WING-DN D4 left lower wing
RAIL-UP-L D5 upper rail, left stick RAIL-UP-R D6 upper rail, right stick

RAIL-DN-L D7 lower rail, left stick RAIL-DN-R D8 lower rail, right stick R-CAP A0 right vertical bar R-WING-UP A1 right upper wing R-WING-DN A2 right lower wing

Black dot = the ball of the stick: mount each stick with its ball here (left half: dots left, right half: dots right, caps: up). Small circle = middle of the stick (Grove connector, cable hole).
Connector A3 of the shield carries the CLOSED light stick (not part of the arrow).
The sign sketch drives the arrow; this drawing and the wiring only fix the names and the connectors.
