anttiraisala/casino-open-sign/layout-parts.pdf

## Casino sign - parts list: strips, LED counts and cutting list

3 strips, 14 pieces, 164 LEDs = 2.73 m of strip (60 LEDs per metre, pitch 16.7 mm).
Cut the strip only between two LEDs (at the cut marks). See layout-diagram.svg for the positions.

### LED counts and cutting list

Strip | Pin | LEDs | Pieces LEDs per piece (index range)
frameCw | D9 | 53 | 2 | top edge 28 (#0-27), right edge 25 (#28-52)
frameCcw | D10 | 53 | 2 | left edge 25 (#0-24), bottom edge 28 (#25-52)
letters | D11 | 58 | 10 | see the letter table below
Total | | 164 | 14 | 3 strips, 164 LEDs, 14 pieces

### Letters (strip D11): LEDs per letter group and LED index range

C (line 1) | A (line 1) | S (line 1) | I (line 1) | N (line 1) | O (line 1) | O (line 2) | P (line 2) | E (line 2) | N (line 2)
6 LEDs | 6 LEDs | 6 LEDs | 4 LEDs | 6 LEDs | 6 LEDs | 6 LEDs | 6 LEDs | 6 LEDs | 6 LEDs
#0-5 | #6-11 | #12-17 | #18-21 | #22-27 | #28-33 | #34-39 | #40-45 | #46-51 | #52-57

The letter pieces are joined in reading order (CASINO, then OPEN) with wire jumpers;
together they are the one strip 'letters' on pin D11.

### Grove sticks: 10 arrow sticks + the CLOSED light (in the shield, not cut)

Stick | Connector | LEDs | Position
1 L-CAP | D2 | 10 | left vertical bar
2 L-WING-UP | D3 | 10 | left upper wing
3 L-WING-DN | D4 | 10 | left lower wing
4 RAIL-UP-L | D5 | 10 | upper rail, left stick
5 RAIL-UP-R | D6 | 10 | upper rail, right stick
6 RAIL-DN-L | D7 | 10 | lower rail, left stick
7 RAIL-DN-R | D8 | 10 | lower rail, right stick
8 R-CAP | A0 | 10 | right vertical bar
9 R-WING-UP | A1 | 10 | right upper wing
10 R-WING-DN | A2 | 10 | right lower wing
11 CLOSED | A3 | 10 | CLOSED light, behind the plate

Stick body 83 x 10 mm, LED window 74 x 4 mm; arrow geometry and drill template: arrow_sticks/.
