anttiraisala/casino-open-sign/parts-list.pdf

# Casino sign - parts list (shopping list)

Prices incl. VAT 25.5 %, checked on partco.fi 2026-11-02. Plan: 12 V colour strip. (probable) / (uncertain) = how sure we are of the part. [n] = link number.
Prices, stock status and links are a snapshot from 2026-11-02. They are not updated unless the user explicitly asks for it, so check them before ordering.
Part | Used for | Qty Unit EUR | Line EUR | Availability | Product / SKU / notes | Link

### Control and display

Arduino Mega 2560 | the controller | 1 pcs | 58.00 | 58.00 | in stock (15 pcs) | Arduino Mega 2560 R3 (A000067) (ARD-A000067) | [1] (https://partco.fi/tuote/arduino-mega-2560-r3-a000067-2178)
LCD 2x16, I2C (probable) | shows mode, speeds, casino state, arrow | 1 pcs | 13.40 | 13.40 | in stock (45 pcs) | LCD-NÄYTTÖ 2x16 SINIVALKO I2C-LIITÄNTÄ (LCD-2X16-I2C) > I2C backpack with PCF8574AT, address 0x27 per the > page (try 0x3F if blank) | [2] (https://partco.fi/tuote/lcd-n%C3%A4ytt%C3%B6-2x16-sinivalko-i2c-liit%C3%A4nt%C3%A4-5193)

Hex rotary switch 0-F
(probable)

SW3 and SW4: speed of frame + arrow, speed of letters

2 pcs | 3.43 | 6.86 | in stock (4 pcs) | HEX ENKOODERI/KIERTOKYTKIN TAPILLA 0..F (KIERTOKYTKIN-216) > PCB mount, 16 positions, binary coded, NOT a pulse > encoder; the pin order and the code (true or > complement) are not on the page: test it
[3] (https://partco.fi/tuote/hex-enkooderi-kiertokytkin-tapilla-0-f-4851)

Slide switch DPDT,
long knob
(probable)

SW1 arrow direction, SW5 casino closed (one pole used)

2 pcs | 0.90 | 1.80 | in stock (25 pcs) | 2-NAP LIUKUKYTKIN ON/ON PITKÄ NUPPI (KYT-LIU19-B) > the user's choice; holes 19 mm apart, knob 6.5 mm; > the page does not say if it is panel or PCB mount
[4] (https://partco.fi/tuote/2-nap-liukukytkin-on-on-pitk%C3%A4-nuppi-4859)

Push button, panel
mount
(probable)

SW2: next letter mode, skips the power-on test

1 pcs | 6.53 | 6.53 | in stock (19 pcs) | SULKEUTUVA PAINOKYTKIN 1A 125VAC MUSTA (KYT- DS102-MUS) > hole 7 mm; the page does not state outright that it > is normally open (the name means it closes when > pressed)
[5] (https://partco.fi/tuote/sulkeutuva-painokytkin-1a-125vac-musta-14704)

USB cable A-B
(probable)
programming and power of the Arduino 1 pcs | 3.90 | 3.90 | in stock (per listing) | USB-2.0 VÄLIJOHTO A-UROS / B-UROS 1m (DK-USB- VJ2-1M) > price and stock are from partco.fi's Arduino > accessories listing; the product page was not opened
[6] (https://www.partco.fi/fi/1416-usb-kaapelit)

### Power

### 12 V power supply 4.2

A
(probable)
powers the 12 V LED strip | 1 pcs | 23.79 | 23.79 | in stock (4 pcs) | HAKKURI MODULI 50W 12VDC 4,2A (Mean Well) (LRS-50-12) > 99 x 82 x 30 mm, screw terminals; the page does not > mention an earth terminal: check the datasheet
[7] (https://partco.fi/tuote/hakkuri-moduli-50w-12vdc-4-2a-5775)
Fuse holder | 5 A fuse in the +12 V line | 1 pcs | 3.56 | 3.56 | in stock (8 pcs) | AUTOSULAKEPESÄ JOHDOT PÄÄSTÄ (SULPES-APUR) | [8] (https://partco.fi/tuote/autosulakepes%C3%A4-johdot-p%C3%A4%C3%A4st%C3%A4-4732)
Blade fuse 5 A (probable) | F1 (the strip needs about 3 A at most) | 1 pcs | 0.33 | 0.33 | in stock (per listing) | AUTOSULAKE 32V 5A oranssi (SUA-5A) > price and stock are from the fuse listing | [9] (https://partco.fi/kategoria/komponentit/s%C3%A4hk%C3%B6mekaaniset-komponentit/sulakkeet/autosulakkeet)
Capacitor 1000 uF 25 V | C1 across the LED supply (16 V is too tight at 12 V) | 1 pcs | 1.73 | 1.73 | in stock (100+ pcs) | ELEKTROLYYTTIKOND. 1000µF 25V 10x21mm (ELKO105-1000U-25V) | [10] (https://partco.fi/tuote/elektrolyyttikond-1000%C2%B5f-25v-10x21mm-12238)

Prices incl. VAT 25.5 %, checked on partco.fi 2026-11-02. Plan: 12 V colour strip. (probable) / (uncertain) = how sure we are of the part. [n] = link number.
Prices, stock status and links are a snapshot from 2026-11-02. They are not updated unless the user explicitly asks for it, so check them before ordering.
Part | Used for | Qty Unit EUR | Line EUR | Availability | Product / SKU / notes | Link

### Power

Mains cord, Schuko
plug, free end
230 V into the power supply | 1 pcs | 5.20 | 5.20 | in stock | LAITEJOHTO SUKO KULMA / VAPAA PÄÄ 2m
| | | | | (LAITEJOHTO-2V-KULMA) > 3-wire cord; the mains side must be wired by someone > who knows how | [11] (https://partco.fi/tuote/laitejohto-suko-kulma-vapaa-p%C3%A4%C3%A4-2m-4301)

Plastic enclosure with
cable glands
(probable)

encloses the power supply and the mains wiring

1 pcs | 12.70 | 12.70 | in stock (per listing) | VEDENPITÄVÄ MUOVIKOTELO LÄPIVIENNEILLÄ 95x151x175mm (KOTEV-171) > price and stock are from the industrial enclosures > listing; the product page was not opened
[12] (https://www.partco.fi/fi/1517-teollisuuskotelot)

### LED strip

RGB LED strip, 12 V,
WS2811, 30 LEDs/m, 5 m
(uncertain)

all lighting of the sign (colour, addressable)

1 reel | 70.37 | 70.37 | in stock (1 pc only!) | RGB-LEDNAUHA 30kpl/m WS2811 5m (LED-N- RGB-W2812X150-5M) > probably one control chip per 3 LEDs = 50 pixels of > 10 cm; colour order, bit speed, current and width > are unknown (test it with strip_test/); only one > reel in stock; the sign needs about 38-50 pixels
[13] (https://partco.fi/tuote/rgb-lednauha-30kpl-m-ws2812-5m-103)

### Strip test (do this first)

USB to 12 V step-up
converter, 500 mA
(probable)

powers a short test piece of the strip safely (no mains)

1 pcs | 14.19 | 14.19 | in stock (6 pcs) | USB to 2,1mm DC STEP-UP DC-DC MUUNNIN 12VDC (ADA2778) > 500 mA is enough for 30-60 cm at brightness 60; > needs a USB charger
[14] (https://www.partco.fi/fi/teholaehteet/dcdc-jaennitemuuntimet/step-up-dcdc-jaennitettae-nostava/23817-ada2778.html)

DC jack with screw
terminals, 2.1 mm
(probable)

connects the step-up converter to the strip wires

1 pcs | 3.40 | 3.40 | in stock (154 pcs) | DC-JATKOLIITIN 2,1mm RUUVILIITOKSELLA (DCJ21RUU) > check that it fits the barrel of the converter (2.1 > mm, plus in the middle)
[15] (https://partco.fi/tuote/dc-jatkoliitin-2-1mm-ruuviliitoksella-1875)

### Wiring and assembly

Resistor 330 ohm | R1.. in the data lines (one per
strip chain)
3 pcs | 0.45 | 1.35 | in stock (89 pcs) | METALLIOKSIDIKALVOVASTUS 2W: 330ohm (VASTUS-2W-330R) > 2 W type (body 5 x 12 mm) because the 0.5 W type > FRES-05W-330R has been discontinued; the new design > may need only 4-6 data lines
[16] (https://partco.fi/tuote/metallioksidikalvovastus-2w-330ohm-9515)
Perfboard 200 x 100 mm | resistors, capacitor, fuse holder, hex switches, connections | 1 pcs | 6.50 | 6.50 | in stock (10 pcs) | KYTKENTÄLEVY 200x100mm JUOTOSLIUSKOILLA PERTINAX (KL-PL200) | [17] (https://partco.fi/tuote/kytkent%C3%A4levy-200x100mm-juotosliuskoilla-pertinax-14786)
Heat-shrink tubing set | insulates soldered joints | 1 set | 10.50 | 10.50 | in stock (39 pcs) | KUTISTESUKKASARJA 100kpl laatikko (K-SARJA-86271) | [18] (https://www.partco.fi/fi/kaapelitarvikkeet/kutistemuovit/2-1-kutistemuovit/18196-k-sarja-86271.html)
Hook-up wire 0.75 mm2, red (probable) | +12 V feeds and data wires (length is an estimate) | 10 m | - | - | in stock | ASENNUSJOHTO 0,75mm2 PUNAINEN 1m (KAA- AJ-1X0.75-PUN) > price per metre not checked (the page did not load) | [19] (https://www.partco.fi/fi/kaapelit-metritavarana/monisaeikeiset-asennusjohdot/14290-kaa-aj-1x075-pun.html)

Prices incl. VAT 25.5 %, checked on partco.fi 2026-11-02. Plan: 12 V colour strip. (probable) / (uncertain) = how sure we are of the part. [n] = link number.
Prices, stock status and links are a snapshot from 2026-11-02. They are not updated unless the user explicitly asks for it, so check them before ordering.
Part | Used for | Qty Unit EUR | Line EUR | Availability | Product / SKU / notes | Link

### Wiring and assembly

Hook-up wire 0.75 mm2,
black
(probable)
GND feeds (length is an estimate) | 10 m | - | - | in stock | ASENNUSJOHTO 0,75mm2 MUSTA (sold by the metre; 100
| | | | | m reel shown) (KAA-AJ-1X0.75-MUS) > price per metre not checked; the 1 m item is listed > as a related product on this page | [20] (https://www.partco.fi/fi/kaapelit-metritavarana/monisaeikeiset-asennusjohdot/18135-kaa-aj-1x075-mus-100m.html)

Solder wire
(probable)
soldering | 1 roll | - | - | not looked up | lead-free solder wire (partco.fi had only tips and wick in my search) > buy where convenient; link is the partco.fi front > page
[21] (https://partco.fi/)

### Plate and letters (not at partco.fi)

Black plate 60 x 30 cm | the sign plate (with the CLOSED hole
text cut out)
1 pcs | - | - | - | your choice of material, with a 10 x 2.5 cm CLOSED text cut-out > not a partco.fi item; the link is the partco.fi > front page
[22] (https://partco.fi/)
Red plexiglass letters | CASINO and OPEN | 1 set | - | - | - | 10 letters (C A S I N O O P E N), size to fit the plate > not a partco.fi item; the link is the partco.fi > front page
[23] (https://partco.fi/)
Frosted plastic | behind the CLOSED hole text, so the
light does not show as dots
1 pcs | - | - | - | frosted/opal plastic, about 12 x 4 cm > not a partco.fi item; the link is the partco.fi > front page
[24] (https://partco.fi/)
Mounting hardware | fixing the strips, board, display
and letters to the plate
1 set | - | - | - | double-sided tape, screws, spacers (as needed) > not a partco.fi item; the link is the partco.fi > front page
[25] (https://partco.fi/)

### Insurance for the uncertain parts

Spare resistors 330
ohm

in case a data line needs more or one is damaged

2 pcs | 0.45 | 0.90 | in stock (89 pcs) | METALLIOKSIDIKALVOVASTUS 2W: 330ohm (VASTUS-2W-330R) | [26] (https://partco.fi/tuote/metallioksidikalvovastus-2w-330ohm-9515)
Spare blade fuse 5 A | a blown fuse is the usual first
mishap
2 pcs | 0.33 | 0.66 | in stock (per listing) | AUTOSULAKE 32V 5A oranssi (SUA-5A) | [27] (https://partco.fi/kategoria/komponentit/s%C3%A4hk%C3%B6mekaaniset-komponentit/sulakkeet/autosulakkeet)

Logic buffer 74HCT125
(DIP14)
(uncertain)

cleans up the 5 V data signal if the strip is fussy about it

1 pcs | 1.05 | 1.05 | in stock (20 pcs) | TTL-LOGIIKKAPIIRI BUF 74125 HCT-PERHE DIP14 (74HCT125) > only helps if the 5 V signal is poor; it does not > raise the level to 12 V; a DIP14 socket was not > looked up | [28] (https://partco.fi/fi/elektroniikan-komponentit/aktiivit/ttlcmos-logiikkapiirit/logiikkapiirit-74xx/2192-74hct125.html)

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

### Insurance for the uncertain parts

5 V power supply 10 A (for a 5 V strip bought elsewhere) (uncertain) | only if the 12 V strip turns out to be unusable
1 pcs | 23.79 | 23.79 | in stock (10 pcs) | HAKKURI MODULI 50W 5VDC 10A (Mean Well)
| | | | | (LRS-50-5) > the 5 V strip of the old design (60 LEDs/m) is sold > out at partco.fi | [29] (https://partco.fi/tuote/hakkuri-moduli-50w-5vdc-10a-5777)

Blade fuse 10 A (for
the 5 V supply)
(uncertain)
same reason as the 5 V supply | 1 pcs | 0.31 | 0.31 | in stock (76 pcs) | AUTOSULAKE 32V 10A punainen (SUA-10A) | [30] (https://partco.fi/tuote/autosulake-32v-10a-punainen-5320)

### Alternatives and options (not in any total)

Alternative: Seeeduino
Mega
instead of the Arduino Mega | 1 pcs | 46.70 | 46.70 | in stock (1 pc) | Seeeduino Mega (ATmega2560) (SEEED-102010007) > Mega compatible; set its 5 V / 3.3 V switch to 5 V > and check the pin numbering
[31] (https://partco.fi/tuote/seeeduino-mega-atmega2560-2531)

Old design: 5 V strip,
60 LEDs/m, 5 m
the strip of the earlier 5 V design | 1 reel | 136.00 | 136.00 | SOLD OUT, availability
unknown

RGB-LEDNAUHA 60kpl/m WS2812 5m (LED-N-RGB-W2812X300-5M)

[32] (https://partco.fi/tuote/rgb-lednauha-60kpl-m-ws2812-5m-104)

White strip, 12 V, 60
LEDs/m, 5 m (not
addressable)

only on/off and dimming of whole zones

1 reel | 35.14 | 35.14 | in stock (2 pcs) | EDULLINEN LED-NAUHA KYLMÄNVALKOINEN 6000K 24W IP20 (https://partco.fi/tuote/edullinen-led-nauha-kylm%C3%A4nvalkoinen-6000k-24w-ip20-5m-kela-120)
5m kela (LEDN-24W-VAL)
> rejected: no per-LED control
[33] (https://partco.fi/tuote/edullinen-led-nauha-kylm%C3%A4nvalkoinen-6000k-24w-ip20-5m-kela-120)

Option: knob for the
hex switches
(uncertain)

SW3 and SW4 (pin 3.8 mm; a standard knob may not fit)

2 pcs | - | - | - | Knobs category (3 mm, 4 mm and 6 mm shafts) > the hex switch has a 3.8 mm pin: check the fit, or > use a small screwdriver
[34] (https://www.partco.fi/fi/2088-nupit)

Option: screw terminal
block 2-pole

removable connections for the strip pieces

1 pcs | 0.79 | 0.79 | in stock (per listing) | IRROTETTAVA RIVILIITIN 2X R5,08 (TBW5-2P) > buy as many as you need
[35] (https://partco.fi/tuote/irrotettava-riviliitin-2x-r5-08-1787)

Total of the rows with a price (not counting insurance, alternatives and options): 244.11 EUR (VAT incl.)

Insurance rows (extra parts for the uncertain situations): 26.71 EUR. Total with insurance: 270.82 EUR.

7 counted rows have no price (wire, solder, plate, letters, frosted plastic, mounting): buy elsewhere or check the price yourself.
The LED strip is the most uncertain part (only 1 reel in stock; pixel size, colour order and speed unknown): test a short piece first with strip_test/.

# Links to partco.fi (numbers match the [n] in the table)

[1] | Arduino Mega 2560 | https://partco.fi/tuote/arduino-mega-2560-r3-a000067-2178
[2] | LCD 2x16, I2C | https://partco.fi/tuote/lcd-n%C3%A4ytt%C3%B6-2x16-sinivalko-i2c-liit%C3%A4nt%C3%A4-5193
[3] | Hex rotary switch 0-F | https://partco.fi/tuote/hex-enkooderi-kiertokytkin-tapilla-0-f-4851
[4] | Slide switch DPDT, long knob | https://partco.fi/tuote/2-nap-liukukytkin-on-on-pitk%C3%A4-nuppi-4859
[5] | Push button, panel mount | https://partco.fi/tuote/sulkeutuva-painokytkin-1a-125vac-musta-14704
[6] | USB cable A-B | https://www.partco.fi/fi/1416-usb-kaapelit
[7] | 12 V power supply 4.2 A | https://partco.fi/tuote/hakkuri-moduli-50w-12vdc-4-2a-5775
[8] | Fuse holder | https://partco.fi/tuote/autosulakepes%C3%A4-johdot-p%C3%A4%C3%A4st%C3%A4-4732
[9] | Blade fuse 5 A | https://partco.fi/kategoria/komponentit/s%C3%A4hk%C3%B6mekaaniset-komponentit/sulakkeet/autosulakkeet
[10] Capacitor 1000 uF 25 V | https://partco.fi/tuote/elektrolyyttikond-1000%C2%B5f-25v-10x21mm-12238
[11] Mains cord, Schuko plug, free end | https://partco.fi/tuote/laitejohto-suko-kulma-vapaa-p%C3%A4%C3%A4-2m-4301
[12] Plastic enclosure with cable glands | https://www.partco.fi/fi/1517-teollisuuskotelot
[13] RGB LED strip, 12 V, WS2811, 30 LEDs/m, 5 mhttps://partco.fi/tuote/rgb-lednauha-30kpl-m-ws2812-5m-103
[14] USB to 12 V step-up converter, 500 mA | https://www.partco.fi/fi/teholaehteet/dcdc-jaennitemuuntimet/step-up-dcdc-jaennitettae-nostava/23817-ada2778.html
[15] DC jack with screw terminals, 2.1 mm | https://partco.fi/tuote/dc-jatkoliitin-2-1mm-ruuviliitoksella-1875
[16] Resistor 330 ohm | https://partco.fi/tuote/metallioksidikalvovastus-2w-330ohm-9515
[17] Perfboard 200 x 100 mm | https://partco.fi/tuote/kytkent%C3%A4levy-200x100mm-juotosliuskoilla-pertinax-14786
[18] Heat-shrink tubing set | https://www.partco.fi/fi/kaapelitarvikkeet/kutistemuovit/2-1-kutistemuovit/18196-k-sarja-86271.html
[19] Hook-up wire 0.75 mm2, red | https://www.partco.fi/fi/kaapelit-metritavarana/monisaeikeiset-asennusjohdot/14290-kaa-aj-1x075-pun.html
[20] Hook-up wire 0.75 mm2, black | https://www.partco.fi/fi/kaapelit-metritavarana/monisaeikeiset-asennusjohdot/18135-kaa-aj-1x075-mus-100m.html
[21] Solder wire | https://partco.fi
[22] Black plate 60 x 30 cm | https://partco.fi
[23] Red plexiglass letters | https://partco.fi
[24] Frosted plastic | https://partco.fi
[25] Mounting hardware | https://partco.fi
[26] Spare resistors 330 ohm | https://partco.fi/tuote/metallioksidikalvovastus-2w-330ohm-9515
[27] Spare blade fuse 5 A | https://partco.fi/kategoria/komponentit/s%C3%A4hk%C3%B6mekaaniset-komponentit/sulakkeet/autosulakkeet
[28] Logic buffer 74HCT125 (DIP14) | https://partco.fi/fi/elektroniikan-komponentit/aktiivit/ttlcmos-logiikkapiirit/logiikkapiirit-74xx/2192-74hct125.html
[29] 5 V power supply 10 A (for a 5 V strip boughthtetplsse://wpahretcroe.fi)/tuote/hakkuri-moduli-50w-5vdc-10a-5777 (https://partco.fi/tuote/hakkuri-moduli-50w-5vdc-10a-5777)
[30] Blade fuse 10 A (for the 5 V supply) | https://partco.fi/tuote/autosulake-32v-10a-punainen-5320
[31] Alternative: Seeeduino Mega | https://partco.fi/tuote/seeeduino-mega-atmega2560-2531
[32] Old design: 5 V strip, 60 LEDs/m, 5 m | https://partco.fi/tuote/rgb-lednauha-60kpl-m-ws2812-5m-104
[33] White strip, 12 V, 60 LEDs/m, 5 m (not addreshsttapbs:l/e/p)artco.fi/tuote/edullinen-led-nauha-kylm%C3%A4nvalkoinen-6000k-24w-ip20-5m-kela-120 (https://partco.fi/tuote/edullinen-led-nauha-kylm%C3%A4nvalkoinen-6000k-24w-ip20-5m-kela-120)
[34] Option: knob for the hex switches | https://www.partco.fi/fi/2088-nupit
[35] Option: screw terminal block 2-pole | https://partco.fi/tuote/irrotettava-riviliitin-2x-r5-08-1787
