anttiraisala/casino-open-sign/casino_open_sign_v2/layout-parts.pdf

## Casino Open Sign V2 - parts: strips, pixel numbers and cutting list

2 strips, 28 pixels = 2.8 m of 12 V WS2811 strip (30 LEDs per metre, 1 pixel = 10 cm); 11 Grove sticks of 10 LEDs. Cut the strip only at the cut marks (between two pixels). Both strips are single pieces: no joints.

### Strips

Strip | Pin | Pixels LEDs | Length / contents
letters | D10 | 10 | 30 | 100 cm, one piece 1-6 C A S I N O, 7-10 N E P O (reversed)
frame | D12 | 18 | 54 | 180 cm, one piece 1-6 bottom 7-9 right 10-15 top 16-18 left
Total | | 28 | 84 | 2.8 m of one 5 m reel (50 pixels): 2.2 m left over

### Frame strip (D12): pixel numbers (front view, counter-clockwise)

Pixels | Position | | | Corners
1 - 6 | bottom edge, left to right | pixel 1 = lower-left corner, pixel 6 = lower-right corner
7 - 9 | right edge, going up
10 - 15 | top edge, right to left | pixel 10 = upper-right corner, pixel 15 = upper-left corner
16 - 18 | left edge, going down | the strip ends here (DOUT end)

Frame light, arrow right: start pixel 15 (upper left), end pixel 6 (lower right).
Frame light, arrow left: start pixel 10 (upper right), end pixel 1 (lower left).

### Letters strip (D10): one pixel per letter

C (line 1) | A (line 1) | S (line 1) | I (line 1) | N (line 1) | O (line 1) | O (line 2) | P (line 2) | E (line 2) | N (line 2)
pixel 1 | pixel 2 | pixel 3 | pixel 4 | pixel 5 | pixel 6 | pixel 10 | pixel 9 | pixel 8 | pixel 7

The strip order is C A S I N O N E P O: the OPEN letters are wired in REVERSED order (O is the last pixel).
The program maps every letter to its pixel, so all patterns run in reading order for the viewer.

### Grove sticks: 10 arrow sticks + the CLOSED light (in the shield, not cut)

Stick | Connector | LEDs | Position
1 L-CAP | D2 | 10 | left vertical bar
2 L-WING-UP | D6 | 10 | left upper wing
3 L-WING-DN | D5 | 10 | left lower wing
4 RAIL-UP-L | D7 | 10 | upper rail, left stick
5 RAIL-UP-R | D8 | 10 | upper rail, right stick
6 RAIL-DN-L | D3 | 10 | lower rail, left stick
7 RAIL-DN-R | D4 | 10 | lower rail, right stick
8 R-CAP | A3 | 10 | right vertical bar
9 R-WING-UP | A1 | 10 | right upper wing
10 R-WING-DN | A2 | 10 | right lower wing
11 CLOSED | A0 | 10 | CLOSED light, behind the plate

Stick body 83 x 10 mm, LED window 74 x 4 mm; arrow geometry and drill template: ../arrow_sticks/.
