anttiraisala/casino-open-sign/casino_open_sign_v2/parts-list.pdf

## Casino Open Sign V2 - parts list (partco.fi)

Prices, stock status and links are a snapshot from 2026-11-02. They are not updated unless the user explicitly asks for it, so check them before ordering. Prices include VAT 25.5 %. Rows without a price: not sold at partco.fi or not looked up. Links: see parts-list.csv.

Qty | Part | Used for | Unit | EUR each EUR line | In total | Certainty | SKU
Control and display
1 | Arduino Mega 2560 | the controller | pcs | 58.00 | 58.00 | Yes | sure | ARD-A000067
1 | LCD 2x16, I2C | shows mode, speeds, casino state, arrow | pcs | 13.40 | 13.40 | Yes | probable | LCD-2X16-I2C
2 | Hex rotary switch 0-F | SW3 and SW4: speed of frame + arrow, speed of letters | pcs | 3.43 | 6.86 | Yes | probable | KIERTOKYTKIN-216
2 | Slide switch DPDT, long knob | SW1 arrow direction, SW5 casino closed (one pole used) | pcs | 0.90 | 1.80 | Yes | probable | KYT-LIU19-B
1 | Push button, panel mount | SW2: next letter mode, skips the power-on test | pcs | 6.53 | 6.53 | Yes | probable | KYT-DS102-MUS
1 | USB cable A-B | programming and power of the Arduino | pcs | 3.90 | 3.90 | Yes | probable | DK-USB-VJ2-1M
Power
1 | 5 V power supply 10 A (PSU1) | feeds the Mega 5V pins, the Grove shield, the 11 sticks and the LCD | pcs | 23.79 | 23.79 | Yes | sure | LRS-50-5
1 | Blade fuse 10 A | F1 right after PSU1 (the Mega 5V pins carry the stick current) | pcs | 0.31 | 0.31 | Yes | sure | SUA-10A
1 | 12 V power supply 4.2 A (PSU2) | powers ONLY the two 12 V strips (28 pixels peak about 1-2 A at the brightness limit) | pcs | 23.79 | 23.79 | Yes | probable | LRS-50-12
2 | Fuse holder | fuse holders for F1 (5 V line) and F2 (+12 V line) | pcs | 3.56 | 7.12 | Yes | sure | SULPES-APUR
1 | Blade fuse 5 A | F2 in the +12 V line (the two strips need about 2 A at most) | pcs | 0.33 | 0.33 | Yes | probable | SUA-5A
2 | Capacitor 1000 uF 25 V | C1 across the 5 V supply (16 V or more) and C2 across +12 V at the strips (25 V) | pcs | 1.73 | 3.46 | Yes | sure | ELKO105-1000U-25V
2 | Mains cord, Schuko plug, free end | 230 V into PSU1 and PSU2 | pcs | 5.20 | 10.40 | Yes | sure | LAITEJOHTO-2V-KULM
1 | Plastic enclosure with cable glands | encloses both power supplies and the mains wiring (check the size: two supplies) | pcs | 12.70 | 12.70 | Yes | probable | KOTEV-171

LED strip
1 | RGB LED strip, 12 V, WS2811, 30 LEDs/m, 5 m | frame (18 pixels) + letters (10 pixels): 28 pixels = 2.8 m, one reel is enough | reel | 70.37 | 70.37 | Yes | uncertain | LED-N-RGB-W2812X15
11 | Grove RGB LED stick (10x WS2813 mini) | 10 arrow sticks + the CLOSED light stick | pcs | - | - | Yes | probable | -
1 | Grove Base Shield for Arduino Mega | the 11 sticks plug into its connectors D2-D8 and A0-A3 | pcs | - | - | Yes | probable | -
Wiring and assembly
2 | Resistor 330 ohm | R1, R2: data lines of the frame (D12) and the letters (D10) strips; the sticks have none | pcs | 0.45 | 0.90 | Yes | sure | VASTUS-2W-330R
1 | Perfboard 200 x 100 mm | resistors, capacitors, fuse holders, hex switches, connections | pcs | 6.50 | 6.50 | Yes | sure | KL-PL200
1 | Heat-shrink tubing set | insulates soldered joints | set | 10.50 | 10.50 | Yes | sure | K-SARJA-86271
10 | Hook-up wire 0.75 mm2, red | +12 V feeds and data wires (length is an estimate) | m | - | - | Yes | probable | KAA-AJ-1X0.75-PUN
10 | Hook-up wire 0.75 mm2, black | GND feeds (length is an estimate) | m | - | - | Yes | probable | KAA-AJ-1X0.75-MUS
1 | Solder wire | soldering | roll | - | - | Yes | probable | -
Plate and letters (not at partco.fi)
1 | Black plate 60 x 30 cm | the sign plate 60 x 30 cm (with the CLOSED hole text and the arrow stick holes) | pcs | - | - | Yes | sure | -
1 | Red plexiglass letters | CASINO and OPEN | set | - | - | Yes | sure | -
1 | Frosted plastic | behind the CLOSED hole text, so the light does not show as dots | pcs | - | - | Yes | sure | -
1 | Mounting hardware | fixing the strips, board, display and letters to the plate | set | - | - | Yes | sure | -
Insurance for the uncertain parts
2 | Spare resistors 330 ohm | in case a data line needs more or one is damaged | pcs | 0.45 | 0.90 | Insurance | sure | VASTUS-2W-330R
2 | Spare blade fuse 5 A | a blown fuse is the usual first mishap | pcs | 0.33 | 0.66 | Insurance | sure | SUA-5A
1 | Logic buffer 74HCT125 (DIP14) | cleans up the 5 V data signal if the strip is fussy about it | pcs | 1.05 | 1.05 | Insurance | uncertain | 74HCT125

Alternatives and options (not in any total)
1 | Alternative: Seeeduino Mega | instead of the Arduino Mega | pcs | 46.70 | 46.70 | No | sure | SEEED-102010007
1 | Old design: 5 V strip, 60 LEDs/m, 5 m | the strip of the earlier 5 V design | reel | 136.00 | 136.00 | No | sure | LED-N-RGB-W2812X30
1 | White strip, 12 V, 60 LEDs/m, 5 m (not addressable) | only on/off and dimming of whole zones | reel | 35.14 | 35.14 | No | sure | LEDN-24W-VAL
2 | Option: knob for the hex switches | SW3 and SW4 (pin 3.8 mm; a standard knob may not fit) | pcs | - | - | No | uncertain | -
1 | Option: screw terminal block 2-pole | removable connections for the strip pieces | pcs | 0.79 | 0.79 | No | sure | TBW5-2P

Total of the rows marked Yes that have a price: 260.66 EUR (9 counted rows have no price). Insurance rows: 2.61 EUR.

Not in the list: your own Grove sticks if you already have them, the plate material, the letters, the frosted plastic, tools.
Strip pixels: frame 18 + letters 10 = 28 pixels of one 5 m reel (50 pixels); the 11 sticks and the Grove shield are listed without price.
