anttiraisala/casino-open-sign/wiring-diagram.pdf

Casino sign - electrical schematic (Mega 2560 + Grove shield with 11 LED sticks, 3 WS2812B strips)

Mean Well
LRS-50-5
5 V / 10 A
PSU1

L

N

PE

230 V AC mains

mains side: inside an enclosure, wired by a qualified person

V+

V-

F1 10 A fuse
+5 V

### GND

+ C1 1000 uF / 16 V (stripe on the body = minus)

### Arduino Mega 2560

GND

any GND pin

5V

both 5V pins (long header)

D2

Grove SIG, no resistor | L-CAP 10 LEDs, WS2813 (stick) Grove stick: left vertical bar
DIN | +5V, GND: via the shield (Grove cable)

D3

Grove SIG, no resistor | L-WING-UP 10 LEDs, WS2813 (stick) Grove stick: left upper wing
DIN | +5V, GND: via the shield (Grove cable)

D4

Grove SIG, no resistor | L-WING-DN 10 LEDs, WS2813 (stick) Grove stick: left lower wing
DIN | +5V, GND: via the shield (Grove cable)

D5

Grove SIG, no resistor | RAIL-UP-L 10 LEDs, WS2813 (stick) Grove stick: upper rail, left stick
DIN | +5V, GND: via the shield (Grove cable)

D6

Grove SIG, no resistor | RAIL-UP-R 10 LEDs, WS2813 (stick) Grove stick: upper rail, right stick
DIN | +5V, GND: via the shield (Grove cable)

D7

Grove SIG, no resistor | RAIL-DN-L 10 LEDs, WS2813 (stick) Grove stick: lower rail, left stick
DIN | +5V, GND: via the shield (Grove cable)

D8

Grove SIG, no resistor | RAIL-DN-R 10 LEDs, WS2813 (stick) Grove stick: lower rail, right stick
DIN | +5V, GND: via the shield (Grove cable)

A0

Grove SIG, no resistor | R-CAP 10 LEDs, WS2813 (stick) Grove stick: right vertical bar
DIN | +5V, GND: via the shield (Grove cable)

A1

Grove SIG, no resistor | R-WING-UP 10 LEDs, WS2813 (stick) Grove stick: right upper wing
DIN | +5V, GND: via the shield (Grove cable)

A2

Grove SIG, no resistor | R-WING-DN 10 LEDs, WS2813 (stick) Grove stick: right lower wing
DIN | +5V, GND: via the shield (Grove cable)

A3

Grove SIG, no resistor | CLOSED 10 LEDs, WS2813 (stick) Grove stick: CLOSED light, behind the plate
DIN | +5V, GND: via the shield (Grove cable)

D9

R1 330 ohm | frameCw 53 LEDs, WS2812B top edge 28 + right edge 25
DIN | +5V
| GND

feed: start and end

D10

R2 330 ohm | frameCcw 53 LEDs, WS2812B left edge 25 + bottom edge 28
DIN | +5V
| GND

feed: start and end

D11

R3 330 ohm | letters 58 LEDs, WS2812B groups: 6 6 6 4 6 6 | 6 6 6 6
DIN | +5V
| GND

feed: every group

D32

2 (common)

1

3

SW1 slide switch (SPDT)
arrow direction: handle on the GND side
= LOW = arrow points left
mount: back view, GND contact on the right

pin 3 stays unconnected

D30

2 (common)

1

3

SW5 slide switch (SPDT)
casino closed: handle on the GND side = LOW = CLOSED (OPEN letters off, CLOSED light on); handle on the other side = casino open

pin 3 stays unconnected

D33

SW2 push button (momentary)
each press = next letter mode

SW3 hex rotary switch 0-F
speed of the frame and the arrow

0 .. F

| 1 | D22
| 2 | D23
| 4 | D24
C | 8 | D25

SW4 hex rotary switch 0-F
speed of the letters

0 .. F

| 1 | D26
| 2 | D27
| 4 | D28
C | 8 | D29

LCD1 2x16 character LCD, I2C backpack
shows mode, speeds, casino state, arrow
(I2C address 0x27, try 0x3F if blank)

LCD
16 x 2

GND
VCC | 5V pin
SDA | D20 (SDA)
SCL | D21 (SCL)

USB-B cable (upload, Serial Monitor): ONLY while the LED supply is switched OFF. The supply feeds the Mega 5V pins (the sticks
get their power through the Grove shield), so with USB plugged in
as well two 5 V sources would be connected together.
+5 V power | GND | data (via 330 ohm) | inputs | I2C | hop = lines cross without a connection; dot = connection

Notes
Total: 164 LEDs in 3 WS2812B strips (14 pieces) plus 11 Grove sticks with 10 LEDs each (10 arrow sticks + the CLOSED light). Positions: layout-diagram.svg, arrow_sticks/.
1. Common ground: PSU V-, Arduino GND (and the shield) and the GND of every LED strip piece and stick are connected together.
2. Put each 330 ohm resistor close to the first LED of its strip. Keep data wires short. The sticks plug straight into the Grove shield (no resistors).
3. Feed +5 V and GND into every strip piece from the buses (thick wire, at least 1 mm2). Where the diagram says 'start and end', feed the strip at both ends. The DIN end of a strip is the end the arrow printed on the strip points away from.
4. Strips made of several pieces (frame edges, letter groups) are chained: DOUT of one piece to DIN of the next, and each piece gets its own +5 V and GND connection.
5. The Mega's 5 V logic drives WS2812B and the sticks directly: no level shifter. Fit F1 right after
the supply.
6. SW3 and SW4: pins 1, 2, 4, 8 go to D22-D25 and D26-D29, the common pin C goes to GND. A position counts in binary (0..F). If your switch gives the complement (15 - position), set
SPEED_BIT_IS_LOW to false in sketch.ino.
7. All inputs (SW1 to SW5) use the internal pull-ups (INPUT_PULLUP), so no resistors are needed for them.
8. CLOSED (the 11th Grove stick, 10 white LEDs, shield connector A3) sits BEHIND the plate under the CLOSED hole text and is lit only while SW5 says closed. Like all sticks it is plugged into the
shield: no wire from the supply to it.
9. LCD1 (I2C backpack) uses the Mega's I2C pins D20 (SDA) and D21 (SCL) plus the Mega 5V and GND pins (about 30 mA with the backlight).
10. Arrow sticks: the 10 Grove RGB LED sticks go into the Grove Base Shield connectors D2-D8 and A0-A2 (A3 carries the CLOSED light stick; the shield's 3V3/5V switch must be on 5 V). Connect
the +5 V bus to BOTH 5V pins of the Mega's long header and the GND bus to the Mega GND pins, as in stick_test_direct (tested on real hardware). The Mega 5V pin therefore carries the stick
current: keep the brightness curve max moderate.
11. Pin 13 (the LED on the Mega board) blinks while the program runs; the Serial Monitor (115200 baud) shows one line per second.
