anttiraisala/casino-open-sign/eeprom_clear/wiring-diagram.pdf

## EEPROM clear tool - wiring

nothing is wired: only the USB cable between the PC and the Mega

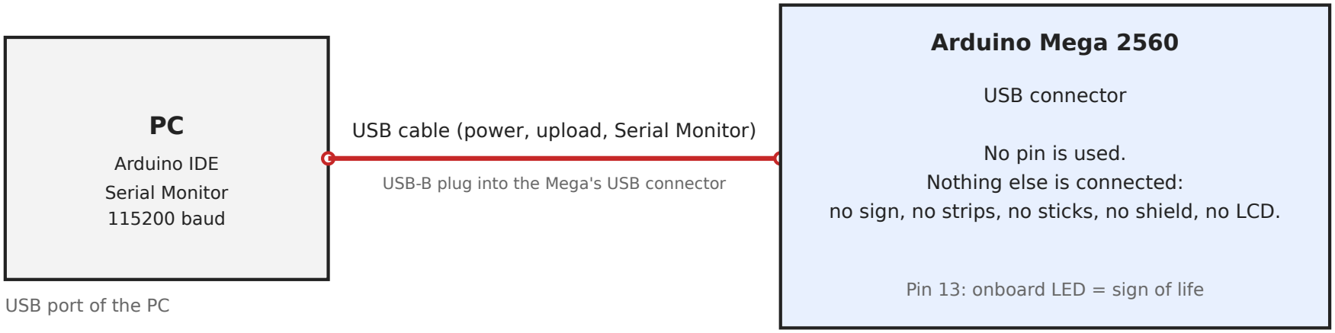
[picture p3: figure]
Arduino IDE Serial Monitor 115200 baud; USB port of the PC; Arduino Mega 2560; USB connector; No pin is used. Nothing else is connected:; Pin 13: onboard LED = sign of life

USB cable (power, upload, Serial Monitor)

USB-B plug into the Mega's USB connector
no sign, no strips, no sticks, no shield, no LCD.

### How to use

1. Unplug everything from the Mega except the USB cable (the sign hardware may stay connected: the tool does not use any pin).
2. Upload eeprom_clear/sketch.ino. At start-up it sets every EEPROM byte to 0xFF, once.
3. Serial Monitor at 115200 baud: 'EEPROM cleared: all bytes are 0xFF.' and one DBG line per second. LED on pin 13 blinks slowly.
4. A fast blink and 'EEPROM clear FAILED' mean that some byte could not be cleared (a worn-out EEPROM).
5. Upload the sign program again: it finds no saved settings and starts with the default values of the menu.
USB cable | GND
