anttiraisala/casino-open-sign/strip_single_led_test/wiring-diagram.pdf

## LED strip single LED - wiring (Arduino Mega 2560 + three 12 V WS2811 strips)

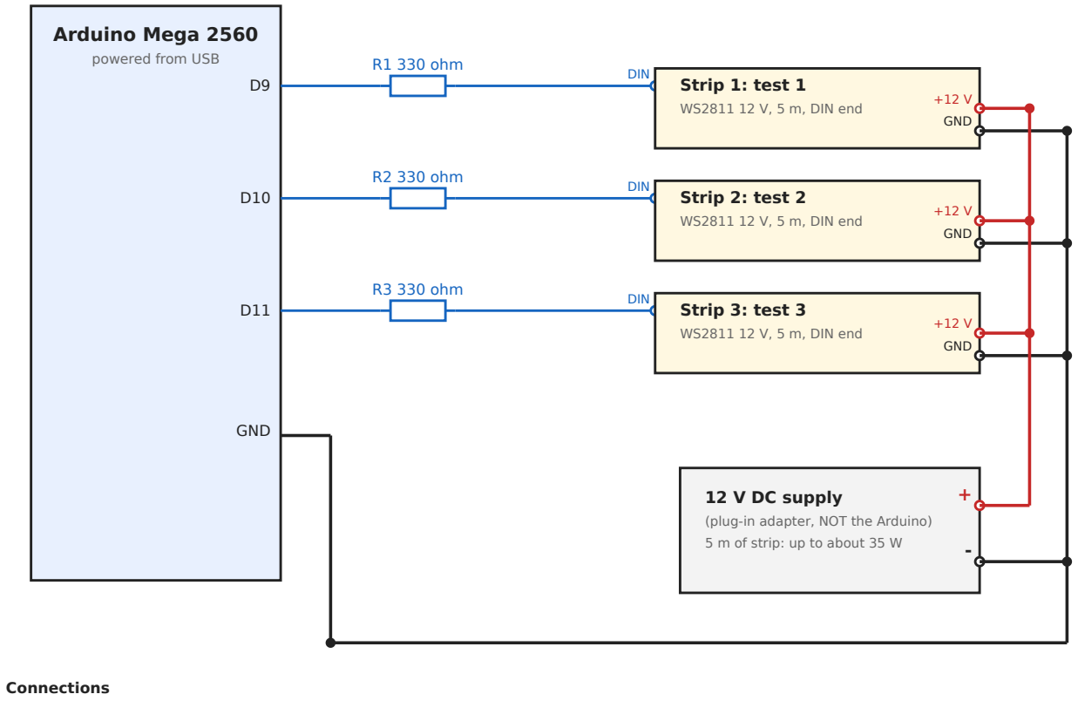
[picture p4: figure]
Arduino Mega 2560; powered from USB; GND; R1 330 ohm; Strip 1: test 1; WS2811 12 V, 5 m, DIN end; DIN; R2 330 ohm; Strip 2: test 2; R3 330 ohm; Strip 3: test 3; 12 V DC supply; (plug-in adapter, NOT the Arduino) 5 m of strip: up to about 35 W; Connections

1. Arduino D9, D10, D11 -> a 330 ohm resistor each -> DIN of strip 1, 2, 3 (the end where the printed arrows point away from). One strip is enough: connect it to D9 for test 1, or to D10 / D11 for the other tests.
2. The +12 V of every strip comes from the 12 V supply, NEVER from an Arduino pin. No 12 V on any Arduino pin.
3. GND of the 12 V supply, GND of all strips and GND of the Arduino are connected together (common ground).
4. The Arduino is powered from USB (the Serial Monitor, 115200 baud, shows one DBG line per second).
5. Optional: a 1000 uF capacitor rated 25 V or more across +12 V and GND at the strip start (plus to +12 V).
6. The built-in LED (pin 13) blinks while the program runs.
7. Brightness is limited to 80 of 255 in the sketch (TEST_LEVEL); the walking pixel is far below the supply limit.
