anttiraisala/casino-open-sign/hex_rotary_test/wiring-diagram.pdf

## Hex rotary switch test - wiring

### Arduino Mega 2560

powered over USB for this test

SW hex rotary switch 0-F
6 legs: 1, 2, 4, 8 and two C (common, joined inside)

0 .. F

leg 1 | D34

bit 0 (weight 1)

leg 2 | D35

bit 1 (weight 2)

leg 4 | D36

bit 2 (weight 4)

leg 8 | D37

bit 3 (weight 8)

C (common)

one C leg to GND (the other C leg is left free)
No resistors: the Mega's internal pull-ups (INPUT_PULLUP) are used. A leg connected to C reads LOW = bit set (sketch: HEX_BIT_IS_LOW).

LCD 2x16 character LCD, I2C backpack
shows A, the switch position and the direction
(I2C address 0x27; the boot scan on the Serial Monitor lists the real one)

LCD
16 x 2

GND
VCC | 5V pin
SDA | D20 (SDA)
SCL | D21 (SCL)

Pin 13: onboard LED = sign of life (blinks while the program runs)

switch leg | I2C (SDA / SCL) | +5 V | GND

Connections
1. Switch leg 1 -> D34, leg 2 -> D35, leg 4 -> D36, leg 8 -> D37; one C leg -> GND (any Mega GND pin).
2. LCD: GND -> GND, VCC -> 5V, SDA -> D20, SCL -> D21 (the Mega's own I2C pins; no pull-up resistors needed).
3. Power: USB cable to the PC (upload, Serial Monitor at 115200 baud). No LED strips or sticks are connected.
4. If the legs are not marked, look for the numbers 1, 2, 4, 8 and the two letters C on the switch body.
5. If A goes the wrong way: set reverseDirection to true in sketch.ino. If position 0 shows as F: set HEX_BIT_IS_LOW to false (the switch is complement-coded).
6. If the LCD shows no text but its light is on: turn the blue contrast trimmer on the I2C backpack, and check that the LCD VCC pin measures at least 4.75 V (see README.txt).
