anttiraisala/casino-open-sign/strip_frame_demo_test/wiring-diagram.pdf

## Strip frame demo test - wiring (Arduino Mega 2560 + four 12 V WS2811 strip pieces)

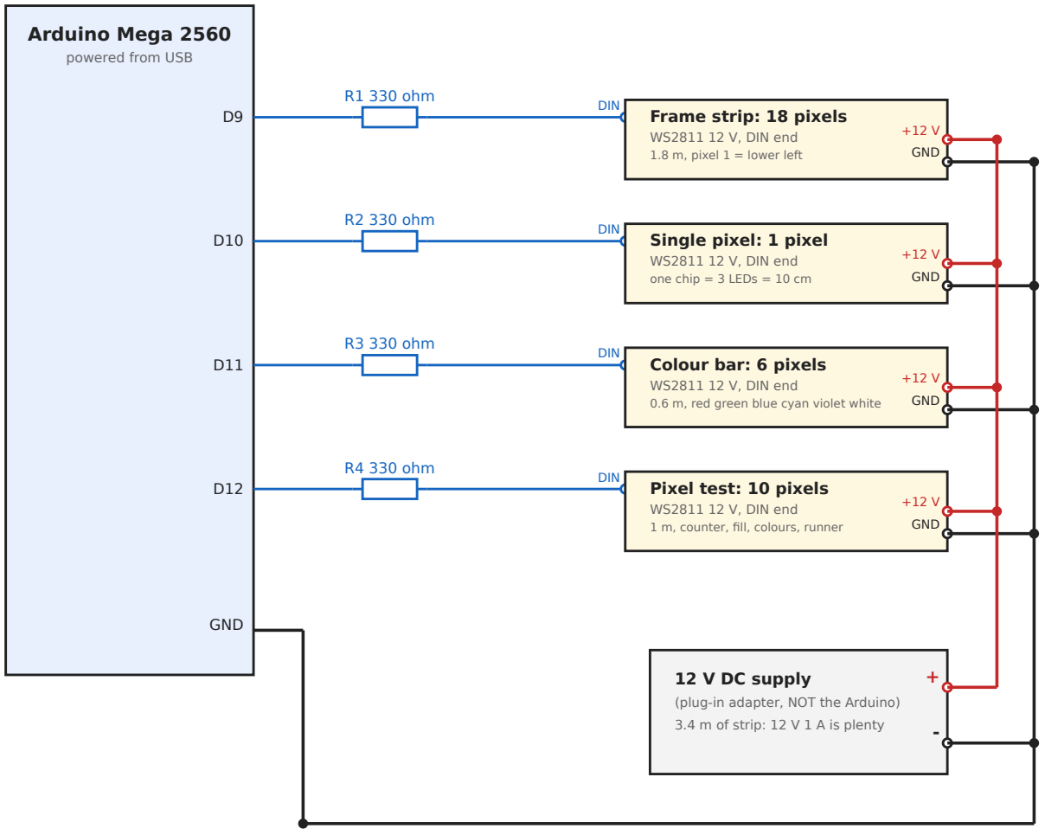
[picture p5: figure]
Arduino Mega 2560; powered from USB; GND; R1 330 ohm; Frame strip: 18 pixels WS2811 12 V, DIN end 1.8 m, pixel 1 = lower left; DIN; R2 330 ohm; Single pixel: 1 pixel; WS2811 12 V, DIN end one chip = 3 LEDs = 10 cm; R3 330 ohm; Colour bar: 6 pixels WS2811 12 V, DIN end 0.6 m, red green blue cyan violet white; R4 330 ohm; Pixel test: 10 pixels WS2811 12 V, DIN end 1 m, counter, fill, colours, runner; 12 V DC supply; (plug-in adapter, NOT the Arduino) 3.4 m of strip: 12 V 1 A is plenty

Connections
1. Arduino D9 -> 330 ohm resistor R1 -> DIN of the frame strip (18 pixels, the end where the printed arrows point away from).
2. Arduino D10 -> 330 ohm resistor R2 -> DIN of the single-pixel piece (one chip, 3 LEDs, cut from the same roll).
2b. Arduino D11 -> 330 ohm resistor R3 -> DIN of the colour bar (6 pixels = 18 LEDs, 60 cm, cut from the same roll).
2c. Arduino D12 -> 330 ohm resistor R4 -> DIN of the pixel test strip (10 pixels = 30 LEDs, 1 m, cut from the same roll).
3. The +12 V of all four strips comes from the 12 V supply, NEVER from an Arduino pin. No 12 V on any Arduino pin.
4. GND of the 12 V supply, GND of all strips and GND of the Arduino are connected together (common ground).
5. The Arduino is powered from USB (the Serial Monitor, 115200 baud, shows one DBG line per second).
6. Optional: a 1000 uF capacitor rated 25 V or more across +12 V and GND at the strip start (plus to +12 V).
7. The built-in LED (pin 13) blinks while the program runs.
8. Brightness peaks at 80 of 255 in the sketch (TEST_LEVEL); at most about 30 lit pixels need very little current.
