anttiraisala/casino-open-sign/arrow_sticks/wiring-diagram.pdf

Stick arrow - wiring (10 named Grove sticks plugged unmodified into the Grove Base Shield)

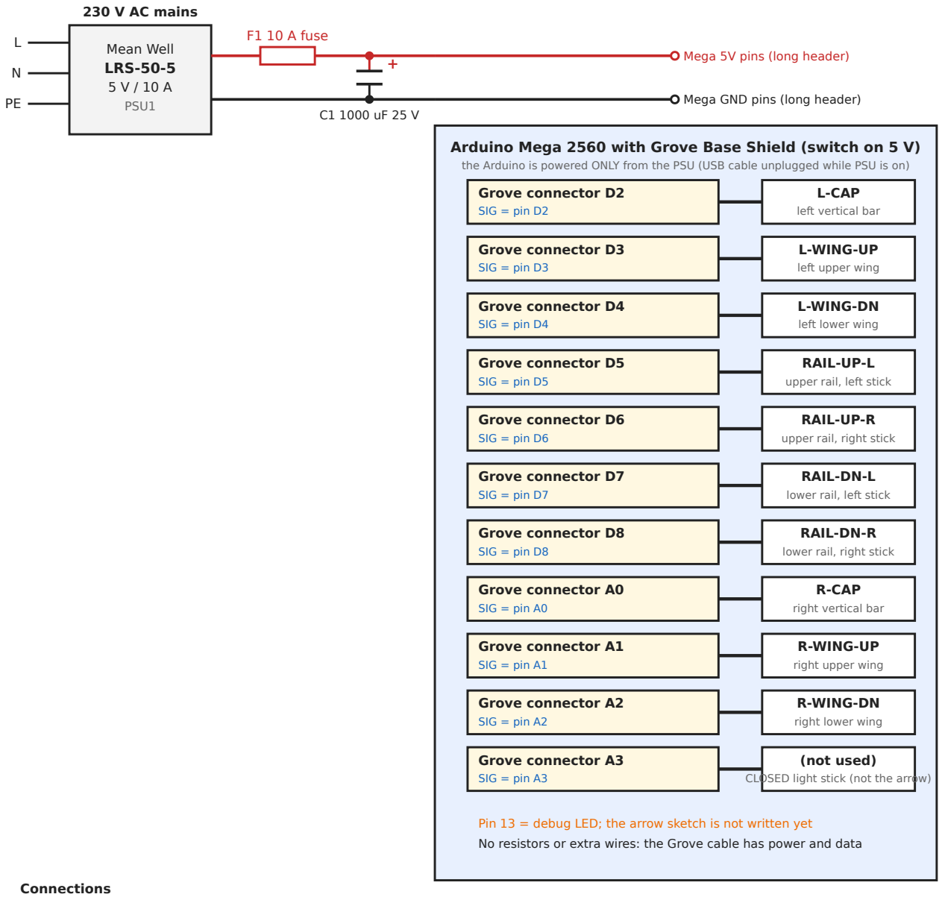
[picture p6: figure]
230 V AC mains; Mean Well LRS-50-5 5 V / 10 A PSU1; F1 10 A fuse; Mega 5V pins (long header); Mega GND pins (long header); Grove connector D2 SIG = pin D2; L-CAP left vertical bar; Grove connector D3 SIG = pin D3; L-WING-UP left upper wing; Grove connector D4 SIG = pin D4; L-WING-DN left lower wing; Grove connector D5 SIG = pin D5; RAIL-UP-L upper rail, left stick; Grove connector D6 SIG = pin D6; RAIL-UP-R upper rail, right stick; Grove connector D7 SIG = pin D7; RAIL-DN-L lower rail, left stick; Grove connector D8 SIG = pin D8; RAIL-DN-R lower rail, right stick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

Arduino Mega 2560 with Grove Base Shield (switch on 5 V)
the Arduino is powered ONLY from the PSU (USB cable unplugged while PSU is on)

Pin 13 = debug LED; the arrow sketch is not written yet
No resistors or extra wires: the Grove cable has power and data
1. Each stick is plugged with its own unmodified Grove cable into the connector shown: L-CAP D2 ... RAIL-DN-R D8,
R-CAP A0, R-WING-UP A1, R-WING-DN A2; the connector A3 carries the sign's CLOSED light stick, not part of the arrow (the stick names are in layout-diagram
2. The shield 3V3/5V switch must be on 5 V. The stick power (red/black wires) goes through the shield and the Grove connectors.
3. PSU V+ -> 10 A fuse F1 -> the Mega 5V pins; PSU V- -> the Mega GND pins (use the 5V and GND pins at the end of the long
double header, away from the shield; use both 5V pins and both GND pins, thick wire 1.5 mm2). C1 across the supply wires.
4. Power the Arduino ONLY from the PSU: do not plug the USB cable while the PSU is on (upload the sketch first with USB, unplug, then power).
5. No Serial Monitor output without USB; the pin 13 LED shows that the program runs.
6. Feel the shield, the connectors and the wires after running all LEDs white for a minute: if anything gets warm, switch off and lower the brightness.
7. The mains side of the supply must be in an enclosure and wired by a person who knows how (nothing here is mains).
