anttiraisala/casino-open-sign/menu_test/layout-diagram.pdf

## Settings menu test - where the wires go (not to scale)

Mega 2560: long double-row header (from above)

5V | 5V
-> casino switch | 30 | 31
-> arrow switch | 32 | 33
34 | 35
36 | 37
-> menu leg 1 | 38 | 39
40 | 41 | -> menu leg 2
-> menu leg 4 | 42 | 43
44 | 45 | -> menu leg 8
-> OK | 46 | 47
48 | 49 | -> CANCEL
-> SHIFT | 50 | 51
52 | 53
GND | GND

Yellow = used pins; grey = GND (all C legs, buttons, slide switches and the LCD GND go to GND pins).

What goes where

Part | Pin / contact | Mega pin
Menu hex switch | legs 1, 2, 4, 8 | D38 D41 D42 D45
| C (one leg) | GND
OK button | one contact | D46
CANCEL button | one contact | D49
SHIFT button | one contact | D50
| other contact | GND
Arrow slide switch | middle contact | D32
Casino slide switch | middle contact | D30
| one side contact | GND
LCD backpack | GND / VCC | GND / 5V
| SDA / SCL | D20 / D21

Rotary switch legs are marked 1, 2, 4, 8 and C (the order differs by maker).
A slide switch has three contacts in a row: the middle one is the common contact. D20 (SDA) / D21 (SCL): communication header, or the SDA / SCL pins by AREF.
