anttiraisala/casino-open-sign/strip_single_led_test/layout-diagram.pdf

# LED strip single LED - what to look for

Three tests run at the same time, one per data pin. Each segment (10 cm) has 3 LEDs.

Test 1 (D9): one white pixel walks along the strip, one step every 150 ms, 150 steps, then again

If one chip drives 3 LEDs, the lit spot is a whole 10 cm segment and only the first 50 steps light something. Note after which step (Serial Monitor: t1=n/150) the strip stays dark: that is the real number of pixels.

Test 2 (D10): one pixel walks (60 ms per step), the colour changes every pass: red, green, blue, white

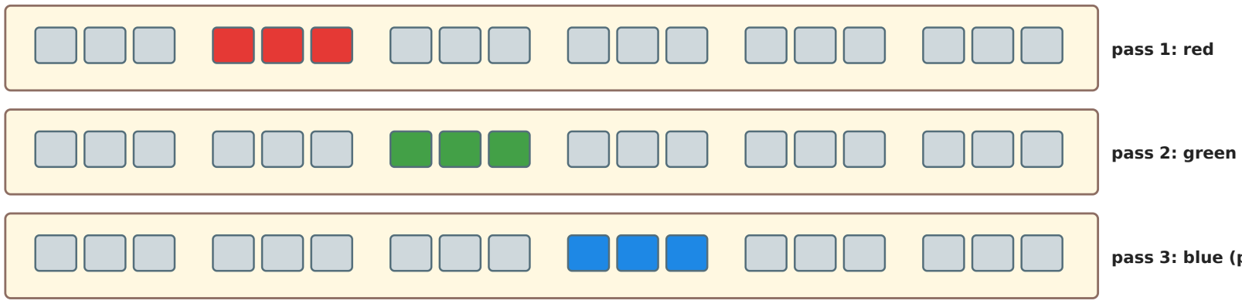
[picture p9: figure]
pass 1: red; pass 2: green

pass 3: blue (pass 4: white)

If pass 1 looks green or blue, the colour order is wrong: change COLOR_ORDER at the top of the sketch (see README).

### Test 3 (D11): ruler, blinking every 500 ms: every 10th pixel blue, every 50th pixel white

pixel 1, 51, 101: white | pixels 11, 21, 31 ... blue (not drawn)
