anttiraisala/casino-open-sign/hex_rotary_test/layout-diagram.pdf

## Hex rotary switch test - where the wires go (not to scale)

Mega 2560: long double-row header (from above)
One column holds the even pins, the other the odd pins (read the numbers on the board).
| 5V | 5V
| 22 | 23
| 32 | 33
-> switch leg 1 | 34 | 35 | -> switch leg 2
-> switch leg 4 | 36 | 37 | -> switch leg 8
| 38 | 39
| 52 | 53
-> switch C | GND | GND

Yellow = the four switch pins, grey = GND for the common leg C. Any other GND pin of the Mega works as well.

Switch legs

Switch leg | Bit weight | Mega pin
1 | 1 | D34
2 | 2 | D35
4 | 4 | D36
8 | 8 | D37
C (one of two) | common | GND
C (other) | - | free

The legs of the switch are marked 1, 2, 4, 8 and C on its body.
The order of the legs on the case differs between makers: read the marks.

LCD (I2C backpack)

GND | -> Mega GND
VCC | -> Mega 5V
SDA | -> Mega D20
SCL | -> Mega D21

D20 (SDA) and D21 (SCL) are on the communication header; the pins marked SDA and SCL next to AREF are the same two lines.
