anttiraisala/casino-open-sign/stick_test/layout-diagram.pdf

## Stick test - layout of the 10-stick arrow (design B, barbed head)

The test needs only the 10 sticks connected; they do not have to be fixed in this shape.

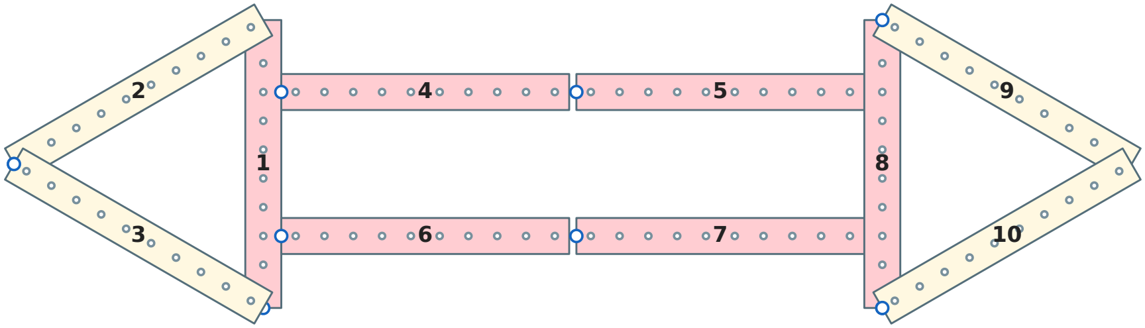
[picture p12: figure]

about 31 cm wide, 9 cm high (the exact size depends on the gaps) Blue dot = data-in end (LED 1) of the stick. Each stick: 80 x 10 x 10 mm, 10 LEDs.

### Stick -> Arduino data pin (sketch order)

Stick 1 D2 left cap
Stick 2 D3 left upper wing
Stick 3 D4 left lower wing
Stick 4 D5 top rail, left
Stick 5 D6 top rail, right

Stick 6 D7 bottom rail, left Stick 7 D8 bottom rail, right Stick 8 A0 right cap
Stick 9 A1 right upper wing Stick 10 A2 right lower wing

Wings are at 30 degrees: with 80 mm sticks the wing spans 69 mm along the shaft and 40 mm across it.
