anttiraisala/casino-open-sign/sticks_11_test/layout-diagram.pdf

## 11 sticks - which stick goes where, and what to feel

Sticks 1-10 form the arrow (same order and connectors as in the sign, see ../arrow_sticks/); stick 11 is the CLOSED light.

Stick -> Grove connector -> what it shows

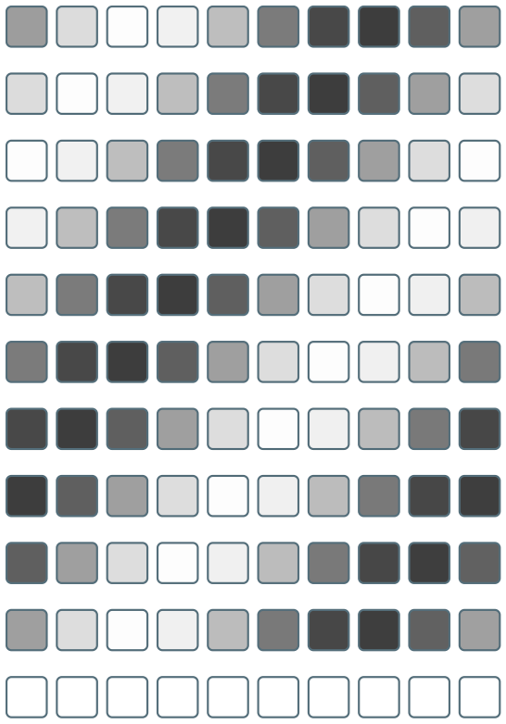
[picture p13: figure]

Stick 1 | D2 | L-CAP: flowing white wave, brightness 0..80
Stick 2 | D3 | L-WING-UP: flowing white wave, brightness 0..80
Stick 3 | D4 | L-WING-DN: flowing white wave, brightness 0..80
Stick 4 | D5 | RAIL-UP-L: flowing white wave, brightness 0..80
Stick 5 | D6 | RAIL-UP-R: flowing white wave, brightness 0..80
Stick 6 | D7 | RAIL-DN-L: flowing white wave, brightness 0..80
Stick 7 | D8 | RAIL-DN-R: flowing white wave, brightness 0..80
Stick 8 | A0 | R-CAP: flowing white wave, brightness 0..80
Stick 9 | A1 | R-WING-UP: flowing white wave, brightness 0..80
Stick 10 | A2 | R-WING-DN: flowing white wave, brightness 0..80
Stick 11 | A3 | CLOSED light: steady white, level 80

LEDs of the stick (example moment)

Where to feel for heat (switch the supply off first if something is hot):

1. The Grove Base Shield and the Mega 5V pin area (where the supply wires go in).
2. The Grove connectors and the cables, especially of sticks far from the supply and of the CLOSED light stick.
3. The back of each stick (the chips) and the CLOSED light stick, which is lit all the time.
4. The supply and the fuse holder. Try both modes: flow (default) and all on (button on D33).
