anttiraisala/casino-open-sign/strip_knight_rider_test/layout-diagram.pdf

## LED strip knight rider - what you should see

Three strips of 50 pixels (each pixel = one control chip = 3 LEDs = 10 cm). One light runs back and forth.

### D9: RED light, 1 pixel per second (one cycle (end to end and back) = 98 s)

pixel 1 <-> pixel 50 (only 6 of the 50 pixels are drawn)

### D10: BLUE light, 4 pixels per second (one cycle = 24.5 s)

pixel 1 <-> pixel 50 (only 6 of the 50 pixels are drawn)

### D11: GREEN light, 10 pixels per second (one cycle = 9.8 s)

pixel 1 <-> pixel 50 (only 6 of the 50 pixels are drawn)

At each end the light turns around at once (the end pixel is lit only once per turn). The LED on pin 13 is shortly inverted at a turnaround. If your strip has a different number of pixels, change STRIP_PIXELS in the sketch. Wrong colours: change COLOR_ORDER (see README).
