anttiraisala/casino-open-sign/strip_test/layout-diagram.pdf

# LED strip test - layout of the piece and what to look for

A piece of 3 to 6 pixel segments (10 cm each) is enough. Each segment has 3 LEDs.

### A The strip piece (start end = DIN end on the left)

cut only at these marks (every 10 cm)

data direction (the arrows printed on the strip point this way) DIN <- Arduino D6 via 330 ohm. +12 V <- 12 V supply. GND <- supply minus and Arduino GND.

### B Colour test (the first 3 seconds of every setting)

The setting number (blinks of the built-in LED, also in the Serial Monitor) where you see red, green, blue in this order is the colour order to use. Wrong settings show other colours (for example green, red, blue), nothing, white, or flicker.

### C Walking white pixel (after the colour test): how many LEDs light up in one step?

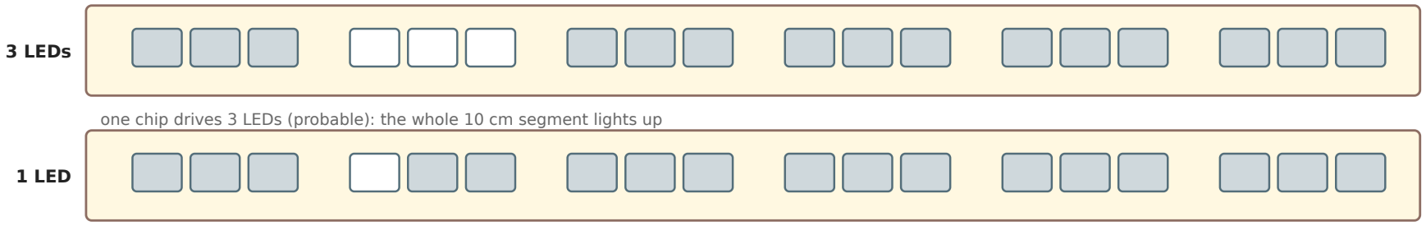
[picture p14: figure]
3 LEDs; 1 LED

one chip drives 3 LEDs (probable): the whole 10 cm segment lights up

every LED has its own chip: only one LED lights up

The white spot moves one step every half second along the piece. Tell me which of the two pictures matches what you see (3 LEDs or 1 LED at a time). Also tell: do all pixels work, does anything flicker, and what is printed on the strip or the reel.
