anttiraisala/casino-open-sign/menu_test/wiring-diagram.pdf

### Settings menu test - wiring

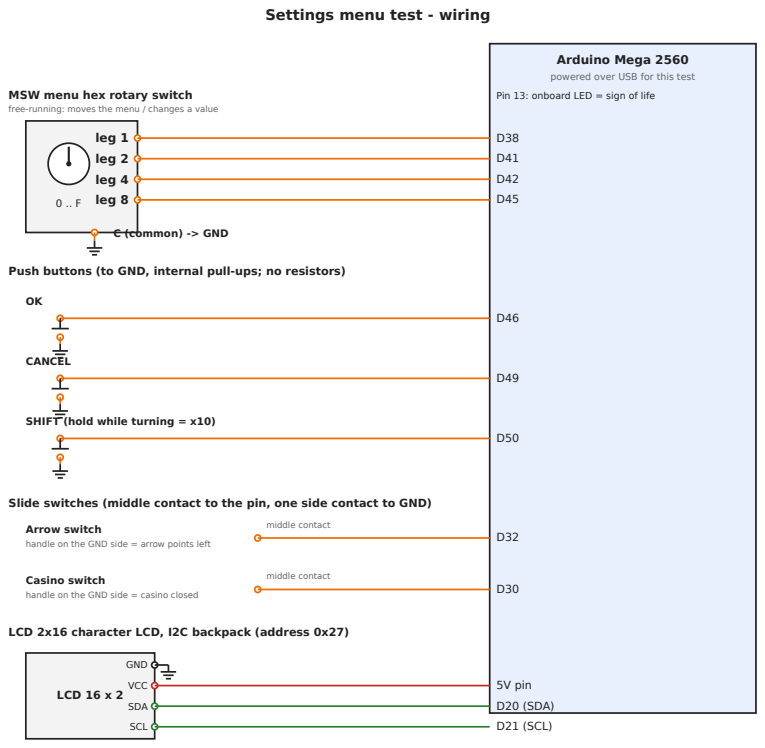
[picture p15: page 1]

Arduino Mega 2560
powered over USB for this test

MSW menu hex rotary switch
free-running: moves the menu / changes a value

Pin 13: onboard LED = sign of life

Push buttons (to GND, internal pull-ups; no resistors)

SHIFT (hold while turning = x10)

Slide switches (middle contact to the pin, one side contact to GND)

LCD 2x16 character LCD, I2C backpack (address 0x27)
