anttiraisala/casino-open-sign/layout-diagram.pdf

# Casino sign - layout of the LED strips (to scale, dimensions in cm)

### 50 cm

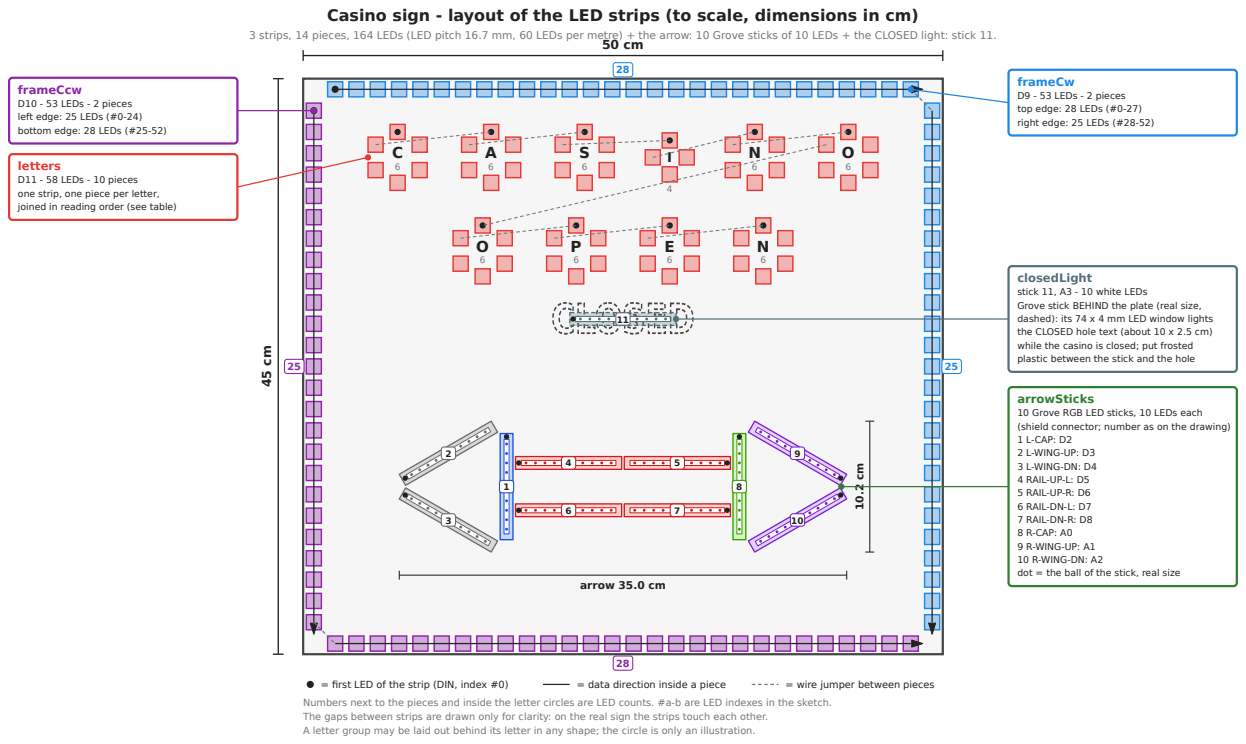
[picture p16: page 1]

3 strips, 14 pieces, 164 LEDs (LED pitch 16.7 mm, 60 LEDs per metre) + the arrow: 10 Grove sticks of 10 LEDs + the CLOSED light: stick 11.

letters
D11 - 58 LEDs - 10 pieces
one strip, one piece per letter,
joined in reading order (see table)

closedLight
stick 11, A3 - 10 white LEDs
Grove stick BEHIND the plate (real size,
dashed): its 74 x 4 mm LED window lights
the CLOSED hole text (about 10 x 2.5 cm)
while the casino is closed; put frosted
plastic between the stick and the hole

arrowSticks
10 Grove RGB LED sticks, 10 LEDs each
(shield connector; number as on the drawing)
1 L-CAP: D2
2 L-WING-UP: D3
3 L-WING-DN: D4
4 RAIL-UP-L: D5
5 RAIL-UP-R: D6
6 RAIL-DN-L: D7
7 RAIL-DN-R: D8
8 R-CAP: A0
9 R-WING-UP: A1
10 R-WING-DN: A2
dot = the ball of the stick, real size

Numbers next to the pieces and inside the letter circles are LED counts. #a-b are LED indexes in the sketch.
The gaps between strips are drawn only for clarity: on the real sign the strips touch each other.
A letter group may be laid out behind its letter in any shape; the circle is only an illustration.
