anttiraisala/casino-open-sign/arrow_sticks/drill-template-A3.pdf

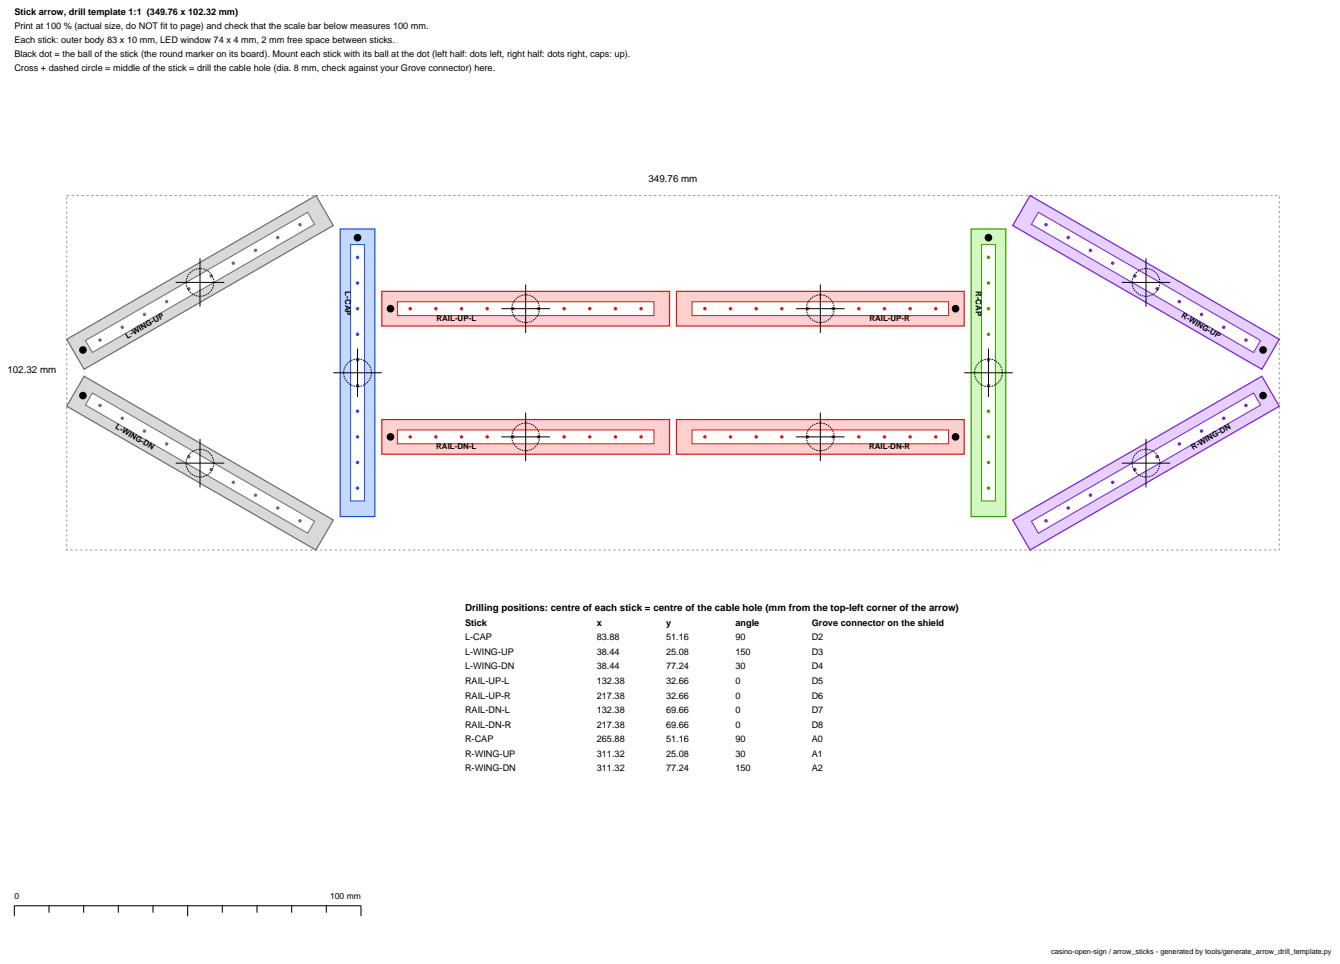
[picture p17: page 1]
L-WING-UP; L-WING-DN; RAIL-UP-L; RAIL-UP-R; RAIL-DN-L; RAIL-DN-R; R-CAP; R-WING-UP; R-WING-DN; Stick; angle; Grove connector on the shield; L-CAP

Stick arrow, drill template 1:1 (349.76 x 102.32 mm)
Print at 100 % (actual size, do NOT fit to page) and check that the scale bar below measures 100 mm.
Each stick: outer body 83 x 10 mm, LED window 74 x 4 mm, 2 mm free space between sticks.
Black dot = the ball of the stick (the round marker on its board). Mount each stick with its ball at the dot (left half: dots left, right half: dots right, caps: up).
Cross + dashed circle = middle of the stick = drill the cable hole (dia. 8 mm, check against your Grove connector) here. L-CAP

Drilling positions: centre of each stick = centre of the cable hole (mm from the top-left corner of the arrow)

casino-open-sign / arrow_sticks - generated by tools/generate_arrow_drill_template.py
