anttiraisala/casino-open-sign/arrow_sticks/drill-template-A4-tiled.pdf

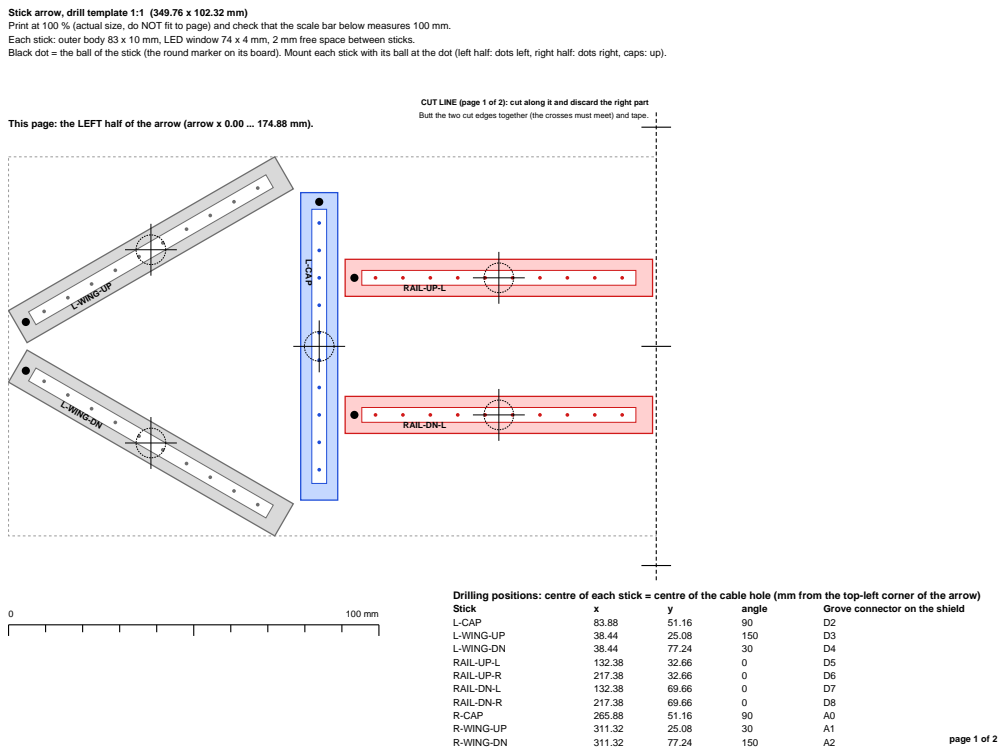
[picture p18: page 1]
L-CAP; L-WING-UP; L-WING-DN; RAIL-UP-L; RAIL-DN-L; Stick; angle; Grove connector on the shield; RAIL-UP-R; RAIL-DN-R; R-CAP; R-WING-UP; R-WING-DN; page 1 of 2

Stick arrow, drill template 1:1 (349.76 x 102.32 mm)
Print at 100 % (actual size, do NOT fit to page) and check that the scale bar below measures 100 mm.
Each stick: outer body 83 x 10 mm, LED window 74 x 4 mm, 2 mm free space between sticks.
Black dot = the ball of the stick (the round marker on its board). Mount each stick with its ball at the dot (left half: dots left, right half: dots right, caps: up).

CUT LINE (page 1 of 2): cut along it and discard the right part
Butt the two cut edges together (the crosses must meet) and tape.

This page: the LEFT half of the arrow (arrow x 0.00 ... 174.88 mm).

Drilling positions: centre of each stick = centre of the cable hole (mm from the top-left corner of the arrow)

CUT LINE (page 2 of 2): cut along it and discard the left part

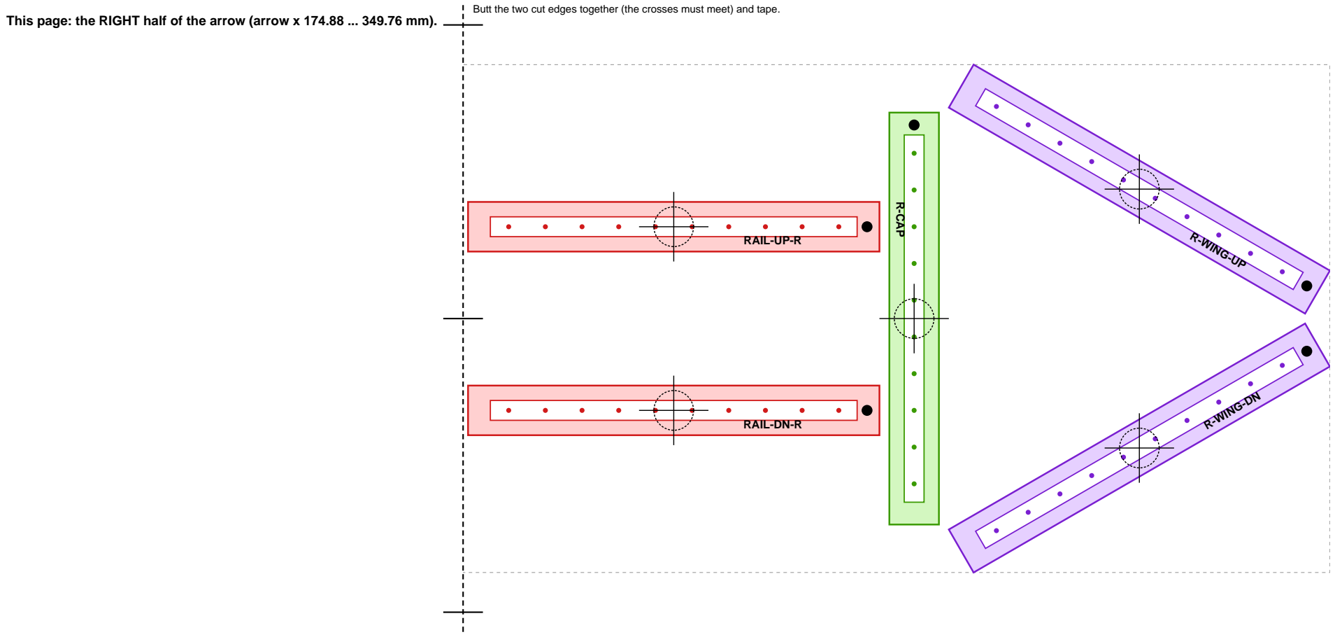
[picture p19: figure]
RAIL-UP-L; RAIL-UP-R; RAIL-DN-L; RAIL-DN-R; R-CAP; R-WING-UP; R-WING-DN

Butt the two cut edges together (the crosses must meet) and tape.

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

This page: the RIGHT half of the arrow (arrow x 174.88 ... 349.76 mm).

0 | 100 mm

page 2 of 2
