anttiraisala/casino-open-sign/tests/casino_open_sign_v2_harness.cpp

#include "Arduino.h"
#include "Adafruit_NeoPixel.h"
#include "Wire.h"
#include "EEPROM.h"
unsigned long g_millis = 0;
uint8_t g_pinLevel[64];
MockSerial Serial;
uint8_t g_pinOut[64];
TwoWire Wire;
EEPROMClass EEPROM;
std::vector<Adafruit_NeoPixel*> g_strips;
#include SKETCH_PATH
#include <cstring>
#include <set>
// Expected value of STICK_BALL_AT_DIN_END in the sketch under test (hard-coded here; tests/mutate.py builds a
// variant with the bit false and defines EXPECT_BALL_AT_DIN=0). The logical LED number counts from the ball.
#ifndef EXPECT_BALL_AT_DIN
#define EXPECT_BALL_AT_DIN 1
#endif
// Expected value of ARROW_POINTS_LEFT_WHEN_LOW (hard-coded; mutate.py builds a variant with false and defines
// EXPECT_LOW_IS_LEFT=0). SW_LEFT / SW_RIGHT are the pin levels that must make the arrow point left / right.
#ifndef EXPECT_LOW_IS_LEFT
#define EXPECT_LOW_IS_LEFT 1
#endif
#define SW_LEFT (EXPECT_LOW_IS_LEFT ? LOW : HIGH)
#define SW_RIGHT (EXPECT_LOW_IS_LEFT ? HIGH : LOW)
#define PHYS(ld) (EXPECT_BALL_AT_DIN ? (ld) : 9 - (ld))
#include <string>

// Names of the strips in the order they are created in the sketch (= order in g_strips).
static const char* kStripNames[] = {"frame", "letters", "closedLight", "L-CAP", "L-WING-UP", "L-WING-DN",
                                    "RAIL-UP-L", "RAIL-UP-R", "RAIL-DN-L", "RAIL-DN-R", "R-CAP", "R-WING-UP", "R-WING-DN"};
static const char* nameOf(Adafruit_NeoPixel *st) {
  for (size_t k = 0; k < g_strips.size(); k++) if (g_strips[k] == st) return kStripNames[k];
  return "?";
}
// V2 has no program switch: the effects are menu properties. In this harness an old "program" m (0..14) means that BOTH the
// frame effect and the letters effect are m + 1 (each program has its own frame pattern, as before), and program 15 means
// that both are random (effect 0). curMode() gives the program of the letters.
static const int MODE_RANDOM_AUTO = 15, LETTER_MODE_COUNT = 16;
static int curMode() { return lettersIsRandom() ? MODE_RANDOM_AUTO : (int)activeLetters; }
#define letterMode (curMode())
static void setProgram(int m) {
  const int e = m == MODE_RANDOM_AUTO ? 0 : m + 1;
  menuSetPos(P_frameEffect, (uint16_t)e); menuSetPos(P_lettersEffect, (uint16_t)e);
}

static void dump(FILE *f) {
  fprintf(f, "{\"t\":%lu,\"mode\":%d", g_millis, (int)letterMode);
  for (auto *s : g_strips) {
    fprintf(f, ",\"%s\":[", nameOf(s));
    for (size_t i = 0; i < s->shown_.size(); i++) fprintf(f, "%s\"%06x\"", i ? "," : "", s->shown_[i]);
    fprintf(f, "]");
  }
  fprintf(f, "}\n");
}
static int fails = 0;
#define CHECK(cond, msg) do { if (!(cond)) { if (fails < 25) printf("FAIL: %s (t=%lu)\n", msg, g_millis); fails++; } } while (0)

// Level of letter l read back from the strip (the red channel carries the level).
static uint8_t shownLevel(Adafruit_NeoPixel *let, uint8_t l) {
  // V2: one pixel per letter. Hard-coded strip pixels (0-based) of the letters C A S I N O, O P E N: the OPEN letters
  // are wired REVERSED on the strip (strip order C A S I N O N E P O).
  static const int PIXEL_OF_LETTER[10] = {0, 1, 2, 3, 4, 5, 9, 8, 7, 6};
  return (let->shown_[PIXEL_OF_LETTER[l]] >> 16) & 0xFF;
}

int main(int argc, char **argv) {
  FILE *out = argc > 1 ? fopen(argv[1], "w") : nullptr;
  Serial.capture = true;                                // everything printed is kept for the sign-of-life checks
  memset(g_pinLevel, HIGH, sizeof g_pinLevel);          // pull-ups: open switch/button read HIGH
  g_pinLevel[PIN_ARROW_SWITCH] = SW_RIGHT;             // slide switch handle right -> arrow points right
  if (getenv("V2_BOOT")) {   // power-up with a saved menu image in EEPROM (the mutation test runs this mode, too)
    for (int k = 0; k < 4; k++) EEPROM.mem[k] = (uint8_t)(MENU_LAYOUT_TAG >> (8 * k));
    for (uint8_t pr = 0; pr < MENU_PROP_COUNT; pr++) { const uint8_t sl = menuRd8(PP_SLOT, pr); if (sl != MENU_NO_SLOT) EEPROM.mem[4 + sl] = (uint8_t)menuRd16(PP_DEFPOS, pr); }
    auto saveSlot = [&](uint8_t pr, int pos) { EEPROM.mem[4 + menuRd8(PP_SLOT, pr)] = (uint8_t)pos; };
    saveSlot(P_speedFrame, 20); saveSlot(P_speedArrow, 4); saveSlot(P_speedLetters, 16); saveSlot(P_arrowReverse, 1); saveSlot(P_stripMax, 40);
    saveSlot(P_lettersMax, 60); saveSlot(P_stickMax, 100); saveSlot(P_randomDelay, 5);
    const std::string bootMode = getenv("V2_BOOT");
    if (bootMode == "tag") EEPROM.mem[1] ^= 0x55;            // a saved image of another menu layout
    if (bootMode == "range") saveSlot(P_speedFrame, 255);    // one stored value outside its property's range
    setup();
    finishStartup(g_millis, true);
    for (int k = 0; k < 300; k++) { g_millis++; loop(); }
    if (bootMode == "tag" || bootMode == "range") {
      CHECK(!menuEepromValid && Serial.captured.find("EEPROM: no saved values for this menu layout, defaults used.") != std::string::npos, "boot: a wrong layout tag / a value out of range gives the defaults and says so");
      CHECK(menuPos(P_speedFrame) == 18 && menuPos(P_speedArrow) == 18 && menuPos(P_speedLetters) == 18 && menuPos(P_arrowReverse) == 0 && menuPos(P_randomDelay) == 2 && menuPos(P_monochrome) == 1, "boot: after the rejected image all properties have their defaults (also the valid-looking ones; Monochrome is Yes)");
      if (fails) printf("RESULT: %d failures\n", fails); else printf("RESULT: all checks passed (boot mode %s)\n", bootMode.c_str());
      return fails ? 1 : 0;
    }
    CHECK(menuEepromValid && Serial.captured.find("EEPROM: saved menu values loaded.") != std::string::npos, "boot: the saved menu image is loaded");
    CHECK(menuPos(P_speedFrame) == 20 && menuPos(P_speedArrow) == 4 && menuPos(P_speedLetters) == 16, "boot: the saved speeds are loaded");
    CHECK(fabs((double)frameIntervalMs - 200.0 / (0.125 * pow(32.0, 20 / 30.0))) <= 1.0, "boot: the saved frame speed is applied");
    CHECK(fabs((double)arrowIntervalMs - 35.0 / (0.125 * pow(32.0, 4 / 30.0))) <= 2.0, "boot: the saved arrow speed is applied");
    CHECK(letterMult256 == (uint16_t)(0.125 * pow(32.0, 16 / 30.0) * 256.0 + 0.5), "boot: the saved letters speed is applied");
    CHECK(!arrowPointsRight && menuPos(P_arrow) == 1, "boot: the saved Arrow reverse flag turns the arrow (switch right -> arrow left)");
    CHECK(brightnessLut[LED_TYPE_STRIP][255] == 40 && brightnessLut[LED_TYPE_LETTERS][255] == 60 && brightnessLut[LED_TYPE_STICK][255] == 100, "boot: the saved curves are built for the three LED types");
    setProgram(MODE_RANDOM_AUTO); for (int k = 0; k < 300; k++) { g_millis++; loop(); }
    CHECK(autoDelayMs == 300000UL, "boot: the saved Random delay (5 min) is used by the random effects");
    CHECK(menuMode == MM_STATUS && menuLastInput >= 0, "boot: the status page is shown");
    printf(fails ? "RESULT: %d failures\n" : "RESULT: all checks passed (boot mode)\n", fails);
    return fails ? 1 : 0;
  }
  setup();
  CHECK(startupTestActive, "the power-on LED test starts at power-up");
  // The older tests below check the colours the sketch computes, so they run with an identity curve (min 0,
  // max 255, exponent 1, mix 0). The default curves are tested separately at the end.
  CHECK(brightnessLut[0][128] == 13 && brightnessLut[1][128] == 10 && brightnessLut[2][128] == 13 && brightnessLut[0][255] == 80 && brightnessLut[1][192] == 28 && brightnessLut[1][255] == 60 && brightnessLut[2][255] == 80, "setup() builds the default tables of the three LED types (frame, sticks, letters)");
  for (auto *s : g_strips) CHECK(s->brightness_ == 255, "no global library brightness: the curve maximum is the limit");
  CHECK(LED_TYPE_COUNT == 3 && CURVE_DEFAULT_MIN[0] == 0 && CURVE_DEFAULT_MIN[1] == 0 && CURVE_DEFAULT_MIN[2] == 0 &&
        CURVE_DEFAULT_MAX[0] == 80 && CURVE_DEFAULT_MAX[1] == 60 && CURVE_DEFAULT_MAX[2] == 80 &&
        CURVE_DEFAULT_EXPONENT[0] == 2.67f && CURVE_DEFAULT_EXPONENT[1] == 2.67f && CURVE_DEFAULT_EXPONENT[2] == 2.67f &&
        CURVE_DEFAULT_MIX[0] == 1.0f && CURVE_DEFAULT_MIX[1] == 1.0f && CURVE_DEFAULT_MIX[2] == 1.0f &&
        CURVE_DEFAULT_KEEP_ZERO[0] && CURVE_DEFAULT_KEEP_ZERO[1] && CURVE_DEFAULT_KEEP_ZERO[2], "default curve values: min 0, max 80 (arrow sticks 60), exponent 2.67, mix 1, keep zero dark");
  const uint8_t IDENT_TYPES[3] = {0, 1, 2};
  for (uint8_t ty : IDENT_TYPES) setBrightnessCurve(ty, 0, 255, 1.0f, 0.0f, true);
  finishStartup(g_millis, true);   // the older tests below start from the normal operation
  // Pins hard-coded here (not taken from the sketch): frame D11, letters D12, CLOSED light = 11th stick on A0 (54),
  // sticks in the order L-CAP D2, L-WING-UP D6, L-WING-DN D5, RAIL-UP-L D7, RAIL-UP-R D8, RAIL-DN-L D3, RAIL-DN-R D4,
  // R-CAP A3 (57), R-WING-UP A1 (55), R-WING-DN A2 (56) (A0 = 54 on the Mega), arrow switch D32 (D33 is free).
  CHECK(FRAME_SPEED_MS == 200 && FRAME_BAR_LEDS == 2 && STARTUP_TEST_WINDOW_LEDS == 2, "frame step 200 ms, bar of 2 pixels, LED test window of 2 pixels");
  CHECK(PIN_FRAME == 12 && PIN_LETTERS == 10 && PIN_CLOSED_LIGHT == 54 && PIN_STATUS_LED == 13, "strip pins (D13 stays the status LED)");
  for (auto *s : g_strips) CHECK(s->pin_ != 31, "pin 31 is free: nothing is on D31 any more");
  CHECK(PIN_ARROW_SWITCH == 32 && PIN_CANCEL == 49 && PIN_CASINO_CLOSED_SWITCH == 30, "input pins");
  const int wantStickPins[10] = {2, 6, 5, 7, 8, 3, 4, 57, 55, 56};
  Adafruit_NeoPixel *fr=nullptr,*let=nullptr,*clo=nullptr;
  Adafruit_NeoPixel *st[10] = {};          // the sticks in the order L-CAP, L-WING-UP, L-WING-DN, RAIL-UP-L, RAIL-UP-R,
                                           // RAIL-DN-L, RAIL-DN-R, R-CAP, R-WING-UP, R-WING-DN
  for (auto *s : g_strips) {
    if (s->pin_ == 12) fr = s; else if (s->pin_ == 10) let = s; else if (s->pin_ == 54) clo = s;
    for (int k = 0; k < 10; k++) if (s->pin_ == wantStickPins[k]) st[k] = s;
  }
  { bool allThere = fr && let && clo; for (int k = 0; k < 10; k++) allThere = allThere && st[k];
    if (!allThere) { printf("RESULT: pins do not match, stopping (1 failures)\n"); return 1; } }
  CHECK(g_strips.size() == 13 && STRIP_COUNT == 13, "13 strips: frame, letters, CLOSED light stick (A0), 10 arrow sticks (2 strips + 11 sticks)");
  CHECK(fr && let && clo, "frame, letters and CLOSED strips exist on the expected pins");
  for (int k = 0; k < 10; k++) CHECK(st[k] != nullptr && st[k]->numPixels() == 10, "every stick exists on its pin and has 10 LEDs");
  CHECK(clo && clo->numPixels() == 10 && CLOSED_LIGHT_LEDS == 10, "closed light is a 10-LED Grove stick");
  CHECK(fr->numPixels() == 18 && FRAME_PIXELS == 18, "the frame is one strip of 18 pixels");
  CHECK(let->numPixels() == 10 && LETTER_COUNT == 10, "the letters are one strip of 10 pixels (one per letter)");
  CHECK(arrowPointsRight, "arrow starts pointing right with the switch released (HIGH)");
  CHECK(g_analogPin == 69, "the random seed is read from the free pin A15 (A0 carries the CLOSED stick)");

  // ---- Frame patterns (one per program): expected levels are hard-coded (made by an independent reference
  // implementation, /tmp-free: see tests/frame_pattern_reference.py), 2 hex digits per pixel, pixels 0..17 ----
  {
    const int NSTEPS = 24;
    struct FrameExpect { int mode; bool right; const char *rows[24]; };
    static const int STEPS[24] = {0, 1, 2, 3, 4, 5, 6, 7, 9, 10, 12, 13, 14, 15, 17, 20, 25, 29, 30, 33, 35, 36, 38, 39};
    static const FrameExpect EXPECT[] = {
  {0, true, {"ffff0000ffffff0000ffff0000ffffff0000", "00ffff0000ff0000ffff0000ffff00ffff00", "0000ffff000000ffff0000ffff000000ffff", "ff0000ffff00ffff0000ffff0000ff0000ff", "ffff0000ffffff0000ffff0000ffffff0000", "00ffff0000ff0000ffff0000ffff00ffff00", "0000ffff000000ffff0000ffff000000ffff", "ff0000ffff00ffff0000ffff0000ff0000ff", "00ffff0000ff0000ffff0000ffff00ffff00", "0000ffff000000ffff0000ffff000000ffff", "ffff0000ffffff0000ffff0000ffffff0000", "00ffff0000ff0000ffff0000ffff00ffff00", "0000ffff000000ffff0000ffff000000ffff", "ff0000ffff00ffff0000ffff0000ff0000ff", "00ffff0000ff0000ffff0000ffff00ffff00", "ffff0000ffffff0000ffff0000ffffff0000", "00ffff0000ff0000ffff0000ffff00ffff00", "00ffff0000ff0000ffff0000ffff00ffff00", "0000ffff000000ffff0000ffff000000ffff", "00ffff0000ff0000ffff0000ffff00ffff00", "ff0000ffff00ffff0000ffff0000ff0000ff", "ffff0000ffffff0000ffff0000ffffff0000", "0000ffff000000ffff0000ffff000000ffff", "ff0000ffff00ffff0000ffff0000ff0000ff"}},
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
      {false, {"ffffffffffffffffffffffffffffffffffff", "ffffffffffffffffffffffffffffffff00ff", "ffffffffffffffffffffffffffffffff80ff", "ffffffffffffffffffffffffffffffff00ff", "ffffffffffffffffffffffffffffffff00ff", "00008080ffff00008080ffff00008080ffff", "80ffff00008080ffff00008080ffff000080", "80ffff00008080ffff00008080ffff000080", "808080808080808080808080808080808080", "808080808080808080808080808080808080", "808080808080808080808080808080808080", "00ffff80800000ffff80800000ffff808000", "80800000ffff80800000ffff80800000ffff", "80800000ffff80800000ffff80800000ffff", "ffffffffffffffffffffffffffffffffffff", "ffffffffffffffffffffffffffffffffffff", "ffffffffffffffffffffffffffffffffffff", "000080ffff80000080ffff80000080ffff80", "8080ff0000ff8080ff0000ff8080ff0000ff", "000080ffff80000080ffff80000080ffff80", "ffffffffffffffffffffffffffffffffffff", "ffffffffffffffffffffffffffffffffffff", "ffffffffffffffffffffffffffffffffffff", "0000808080ffffff808080ffffff80808000", "000000000000000000000000000000000000", "000000000000000000000000000000000000", "000000000000000000000000000000000000", "000000000000000000000000000000000000", "80ffffff8080800000ff8080800000008080", "80ffffff8080800000ff8080800000008080", "00808080ffffff808080ffffff8080800000", "ffffffffffffffffffffffffffffffffffff", "ffffffffffffffffffffffffffffffffffff", "ffffffffffffffffffffffffffffffffffff", "000000000000000000000000000000000000", "ffff00008080ffff00008080ffff80008080", "008080ffff00008080ffff000080ffffff00", "80ffff00008080ffff00008080ffff000080", "800000ffff80800000ffff80800000ffff80", "000000000000000000000000000000000000"}},
      };
      for (const GreyExpect &e : GREY) for (int k = 0; k < 40; k++) {
        std::string got; char b[4];
        for (uint16_t i = 0; i < 18; i++) { snprintf(b, sizeof b, "%02x", frameLevel(i, e.right, 14, (uint16_t)GSTEPS[k])); got += b; }
        if (got != e.rows[k]) { printf("FAIL: frame program 14 arrow %s step %d: got %s expected %s\n", e.right ? "right" : "left", GSTEPS[k], got.c_str(), e.rows[k]); fails++; }
      }
      // only off, half and full, always
      bool levelsOk = true;
      for (int t = 0; t < 3600; t++) for (uint16_t i = 0; i < 18; i++) { const uint8_t v = frameLevel(i, t % 2 == 0, 14, (uint16_t)t); if (v != 0 && v != 128 && v != 255) levelsOk = false; }
      CHECK(levelsOk, "frame program 14: only the levels 0, 128, 255");
      // the whole frame blinks out: 95 of the 3600 steps (made by the reference), all of them in the first 6 steps of a 60-step slot, in 23 different slots
      { int offSteps = 0, offOutside = 0; std::set<int> offSlots;
        for (int t = 0; t < 3600; t++) { bool allDark = true; for (uint16_t i = 0; i < 18; i++) if (frameLevel(i, true, 14, (uint16_t)t) != 0) allDark = false;
          if (allDark) { offSteps++; if (t % 60 >= 6) offOutside++; else offSlots.insert(t / 60); } }
        CHECK(offSteps >= 95 && offOutside == 0 && offSlots.size() == 23, "frame program 14: the whole frame blinks out only in the first 6 steps of some 60-step slots"); }
      // every phase starts with 8 steps all lit (full, in phase 1 half); 1728 is a multiple of 144, so phase ph starts at 1728 + 36 * ph
      for (int ph = 0; ph < 4; ph++) for (int k = 0; k < 8; k++) for (uint16_t i = 0; i < 18; i++) {
        const int t = 1728 + ph * 36 + k;
        if (t % 50 < 8 || t % 60 < 6) continue;                 // inside a burst one pixel may differ, or the whole frame is blinking out
        CHECK(frameLevel(i, true, 14, (uint16_t)t) == (ph == 1 ? 128 : 255), "frame program 14: every phase starts with all pixels lit (half in phase 1)"); }
    }
    // frame program 3: steady until step 29, dark from step 30
    for (int right = 0; right < 2; right++) for (uint16_t i = 0; i < 18; i++) {
      CHECK(frameLevel(i, right, 3, 29) == 230 && frameLevel(i, right, 3, 30) == 0, "frame program 3: steady until step 29, dark from step 30");
    }
    // frame program 12: pixel i locks at step 6 + i (spinning before, 255 from then on until step 36)
    { bool sawDarkSpin = false;
      for (uint16_t i = 0; i < 18; i++) { CHECK(frameLevel(i, true, 12, (uint16_t)(6 + i)) == 255, "frame program 12: pixel i is locked at step 6 + i");
        if (frameLevel(i, true, 12, (uint16_t)(5 + i)) == 0) sawDarkSpin = true; }
      CHECK(sawDarkSpin, "frame program 12: a pixel is still spinning at step 5 + i"); }
    // the step counter wraps at 3600 and restarts when the program changes
    { frameStep = 3599; updateFrame(); CHECK(frameStep == 0, "frame step wraps at 3600");
      frameStep = 7; updateFrame(); CHECK(frameStep == 8, "frame step counts the frame updates");
      frameStep = 7; setProgram(5); CHECK(frameStep == 0, "the frame step restarts when the frame effect changes");
      setProgram(MODE_RANDOM_AUTO); frameStep = 7; autoPickedAt = g_millis - autoDelayMs; updateRandomEffects(g_millis); CHECK(frameStep == 0, "the frame step restarts when a random frame effect picks a pattern");
      setProgram(0); }
    // random-looking programs: check what is certain
    for (int right = 0; right < 2; right++) {
      for (uint16_t i = 0; i < 18; i++) {
        CHECK(frameLevel(i, right, 3, 25) == 230 && frameLevel(i, right, 3, 33) == 0, "frame program 3: all steady at step 25, dark at step 33");
        CHECK(frameLevel(i, right, 12, 30) == 255 && frameLevel(i, right, 12, 38) == 0, "frame program 12: all locked at step 30, dark at step 38");
        for (int t = 0; t < 200; t++) { uint8_t v = frameLevel(i, right, 7, (uint16_t)t); CHECK(v == 255 || v == 30, "frame program 7: twinkle levels 255 or 30"); }
        for (int t = 0; t < 40; t++) { uint8_t v = frameLevel(i, right, 12, (uint16_t)t); CHECK(v == 255 || v == 0, "frame program 12: spinning pixels are on or off"); }
      }
    }
    // the programs that follow the arrow differ between the two directions; the others do not
    const int FOLLOW[] = {0, 1, 2, 6, 8, 13, 14};
    for (int m = 0; m < 15; m++) {
      bool differs = false;
      for (int t = 0; t < 36 && !differs; t++) for (uint16_t i = 0; i < 18; i++) if (m != 3 && m != 7 && m != 12 && frameLevel(i, true, m, t) != frameLevel(i, false, m, t)) differs = true;
      bool follows = false; for (int f : FOLLOW) if (f == m) follows = true;
      if (m != 3 && m != 7 && m != 12) CHECK(differs == follows, "frame programs 0, 1, 2, 6, 8, 13, 14 follow the arrow direction, the others do not");
    }
  }

  // ---- The five new letter programs (10-14): expected levels hard-coded from the descriptions ----
  {
    const uint8_t saved = activeLetters;
    auto lv = [&](int mode, unsigned long t, int letter) { activeLetters = (uint8_t)mode; return (int)baseLetterLevel((uint8_t)letter, t); };
    // 10 converge: step = t / 400 mod 8; each word lights from its ends: lit (230) when the distance from the nearer end <= step
    { const int e0[10] = {230, 25, 25, 25, 25, 230, 230, 25, 25, 230};            // step 0: CASINO ends C and O, OPEN ends O and N
      const int e1[10] = {230, 230, 25, 25, 230, 230, 230, 230, 230, 230};        // step 1
      for (int l = 0; l < 10; l++) { CHECK(lv(10, 0, l) == e0[l] && lv(10, 399, l) == e0[l], "converge step 0");
        CHECK(lv(10, 400, l) == e1[l], "converge step 1"); CHECK(lv(10, 800, l) == 230 && lv(10, 2000, l) == 230, "converge: all lit from step 2 to step 5");
        CHECK(lv(10, 2400, l) == 0 && lv(10, 2800, l) == 0 && lv(10, 3199, l) == 0 && lv(10, 3200, l) == e0[l], "converge: dark in steps 6 and 7"); } }
    // 11 words swap: the first word follows the sine table, the second word is half a cycle behind
    { for (int l = 0; l < 6; l++) { CHECK(lv(11, 0, l) == lv(11, 0, 0) && lv(11, 1200, l) == lv(11, 0, 6), "words swap: the first word at half a cycle equals the second word at 0"); }
      for (int l = 6; l < 10; l++) { CHECK(lv(11, 0, l) == lv(11, 0, 6) && lv(11, 1200, l) == lv(11, 0, 0), "words swap: the second word at half a cycle equals the first word at 0"); }
      CHECK(lv(11, 300, 0) != lv(11, 300, 6), "words swap: the words differ at the same moment");
      CHECK(lv(11, 0, 0) >= 40 && lv(11, 0, 0) <= 255 && lv(11, 600, 0) >= 40, "words swap: never darker than 40"); }
    // 12 slot machine: letter k locks at 1500 + 300 k ms; locked = 230 until 7200 ms, dark until 8000 ms, then again
    { for (int l = 0; l < 10; l++) { int v = lv(12, 0, l); CHECK(v == 255 || v == 30, "slot: spinning letters are 255 or 30");
        { int w = lv(12, 4199, 9); CHECK(w == 255 || w == 30, "slot: the last letter still spins at 4199 ms"); }
        CHECK(lv(12, 4200, l) == 230 && lv(12, 7199, l) == 230 && lv(12, 7200, l) == 0 && lv(12, 7999, l) == 0, "slot: all locked at 4200, dark from 7200");
        CHECK(lv(12, 8000 + 4200, l) == 230, "slot: the cycle repeats every 8000 ms"); }
      for (int l = 0; l < 4; l++) CHECK(lv(12, 2401, l) == 230, "slot: letters 0-3 are locked at 2401 ms");
      for (int l = 4; l < 10; l++) { int v = lv(12, 2401, l); CHECK(v == 255 || v == 30, "slot: letters 4-9 still spin at 2401 ms"); }
      bool sawOn = false, sawOff = false; for (int t = 0; t < 1500; t += 80) { int v = lv(12, t, 9); if (v == 255) sawOn = true; if (v == 30) sawOff = true; }
      CHECK(sawOn && sawOff, "slot: a spinning letter changes between 255 and 30"); }
    // 13 twin chase: dim (30) letters step and 9 - step, step = t / 250 mod 10
    { for (int step = 0; step < 10; step++) for (int l = 0; l < 10; l++) {
        const bool dim = (l == step || l == 9 - step);
        CHECK(lv(13, (unsigned long)step * 250 + 10, l) == (dim ? 30 : 230), "twin chase: the two dim letters run in opposite directions"); }
      CHECK(lv(13, 2500, 0) == 30 && lv(13, 2500, 9) == 30 && lv(13, 2500, 4) == 230, "twin chase: the cycle repeats after 10 steps"); }
    // 14 grey bands: only 0/128/255. Phases of 6000 ms (repeat after 18000 ms), each starts with 1000 ms all lit (phase 1: all half);
    // phase 0: pattern 255 255 128 128 0 0 scrolls one letter per 250 ms; phase 1: words run opposite ways in steps of 400 ms (ramp 255 128 0);
    // phase 2: a block bounces (200 ms steps): 255 at the head, 128 next to it, else 0
    { static const int RAMP6[6] = {255, 255, 128, 128, 0, 0};
      static const int RAMP3[3] = {255, 128, 0};
      bool levelsOk = true;
      for (int ph = 0; ph < 3; ph++) for (unsigned long ms = 0; ms < 1000; ms += 100) for (int l = 0; l < 10; l++)
        CHECK(lv(14, (unsigned long)ph * 6000 + ms, l) == (ph == 1 ? 128 : 255), "grey bands: every phase starts with all letters lit (half in phase 1)");
      for (int step = 4; step < 24; step++) for (int l = 0; l < 10; l++) {
        const unsigned long t = (unsigned long)step * 250 + 7;           // phase 0 lasts 24 steps of 250 ms
        CHECK(lv(14, t, l) == RAMP6[((step % 6) - l % 6 + 6) % 6], "grey bands phase 0: the pattern scrolls one letter per 250 ms");
        CHECK(lv(14, 18000UL + t, l) == lv(14, t, l), "grey bands: repeats every 18000 ms"); }
      // phase 1 (after the first second): first word letter l: RAMP3[(step - l) mod 3]; second word letter l (6..9): RAMP3[(step + l - 6) mod 3]; step = local / 400
      for (int step = 3; step < 15; step++) for (int l = 0; l < 10; l++) {
        const int want = l < 6 ? RAMP3[((step % 3) - l % 3 + 3) % 3] : RAMP3[(step % 3 + l - 6) % 3];
        CHECK(lv(14, 6000UL + (unsigned long)step * 400 + 9, l) == want, "grey bands phase 1: the two words run in opposite directions"); }
      // phase 2: head moves 0..9 then 8..1 (period 18 steps of 200 ms)
      for (int step = 5; step < 30; step++) { const int tri = step % 18, head = tri < 10 ? tri : 18 - tri;
        for (int l = 0; l < 10; l++) { const int d = l > head ? l - head : head - l; const int want = d == 0 ? 255 : (d == 1 ? 128 : 0);
          CHECK(lv(14, 12000UL + (unsigned long)step * 200 + 3, l) == want, "grey bands phase 2: a block bounces along the letters"); } }
      for (unsigned long t = 0; t < 36000; t += 50) for (int l = 0; l < 10; l++) { const int v = lv(14, t, l); if (v != 0 && v != 128 && v != 255) levelsOk = false; }
      CHECK(levelsOk, "grey bands: only the levels 0, 128, 255"); }
    activeLetters = saved;
  }

  menuSetPos(P_monochrome, 0);   // the timeline below checks the colours of the effects: Monochrome is Yes by default, so turn it off here
  // Timeline: program k (both effects k + 1) is active from MODE_MS*k; it is chosen in the menu properties just before.
  const unsigned long MODE_MS = 14000, END = MODE_MS * LETTER_MODE_COUNT + 2000;
  // Arrow switch: LOW (left) at 5 s, HIGH (right) at 25 s, short glitch at 45 s, bouncing change at 60 s.
  long lastFrameShows = fr->shows, lastArrowShows = 0; long arrowFlowChecks = 0;
  std::vector<int> prevPath; bool prevMirrored = false, sawMirrored = false, sawNormal = false;
  long modeChanges = 0; int lastMode = letterMode;
  bool minMax[LETTER_MODE_COUNT][4] = {};   // per mode: sawAllOff, sawAllLit, sawSpread, sawWordBlink
  unsigned long lastDump = 0; int modeSeenHigh2 = 0;
  uint8_t secondWordLo = 255, secondWordHi = 0, firstWordLo = 255; // for MODE_WORD_BLINK
  uint8_t breatheMin = 255; bool altDiffer = false, sawFlicker = false;
  bool glitchIgnored = true, bounceHandled = false;
  for (g_millis = 0; g_millis <= END; g_millis++) {
    // ---- stimulus ----
    for (int k = 1; k < LETTER_MODE_COUNT; k++) if (g_millis == MODE_MS * k - 200) setProgram(k);   // the next program is chosen
    if (g_millis == 5000) g_pinLevel[PIN_ARROW_SWITCH] = SW_LEFT;
    if (g_millis == 25000) g_pinLevel[PIN_ARROW_SWITCH] = SW_RIGHT;
    if (g_millis == 45000) g_pinLevel[PIN_ARROW_SWITCH] = SW_LEFT;    // 10 ms glitch: must be ignored
    if (g_millis == 45010) g_pinLevel[PIN_ARROW_SWITCH] = SW_RIGHT;
    if (g_millis >= 60000 && g_millis < 60012) g_pinLevel[PIN_ARROW_SWITCH] = (g_millis & 1) ? HIGH : LOW;  // bounce
    if (g_millis == 60012) g_pinLevel[PIN_ARROW_SWITCH] = SW_LEFT;     // settles LOW -> left

    loop();

    // ---- checks ----
    if (g_millis > 1 && letterMode != lastMode) { modeChanges++; lastMode = letterMode; }
    if (fr->shows != lastFrameShows) {
      lastFrameShows = fr->shows;
      for (auto c : fr->shown_) CHECK(((c >> 16) & 0xFF) == ((c >> 8) & 0xFF) && ((c >> 8) & 0xFF) == (c & 0xFF), "the frame shows only greys (R = G = B)");
      // Rebuild the two light paths (start corner -> end corner) from the ONE frame strip. Strip pixels (0-based, seen from
      // the front): 0 = lower-left corner, 0-5 bottom going right, 5 = lower-right, 6-8 right edge going up, 9 = upper-right,
      // 9-14 top going left, 14 = upper-left, 15-17 left edge going down. All indices are hard-coded here.
      const bool mir = !arrowPointsRight;
      std::vector<int> A, B;
      if (activeLetters == MODE_BREATHE) {   // the bar checks below are for program 0 only (the others are tested above)
      auto lit = [&](size_t i) { return (int)(fr->shown_[i] != 0); };
      for (auto c : fr->shown_) CHECK(c == 0 || c == 0xffffff, "frame colours black/white only");
      static const int RIGHT_CW[10] = {14, 13, 12, 11, 10, 9, 8, 7, 6, 5};     // upper-left, along the top, down the right edge
      static const int RIGHT_CCW[10] = {14, 15, 16, 17, 0, 1, 2, 3, 4, 5};     // upper-left, down the left edge, along the bottom
      static const int LEFT_CW[10] = {9, 8, 7, 6, 5, 4, 3, 2, 1, 0};           // upper-right, down the right edge, along the bottom
      static const int LEFT_CCW[10] = {9, 10, 11, 12, 13, 14, 15, 16, 17, 0};  // upper-right, along the top, down the left edge
      for (int k = 0; k < 10; k++) {
        A.push_back(lit(mir ? LEFT_CW[k] : RIGHT_CW[k]));
        B.push_back(lit(mir ? LEFT_CCW[k] : RIGHT_CCW[k]));
      }
      CHECK(A == B, "both frame light paths (clockwise and counter-clockwise) show the same pattern");
      size_t i = 0;
      while (i < A.size()) { size_t j = i; while (j < A.size() && A[j] == A[i]) j++;
        if (i > 0 && j < A.size()) CHECK(j - i == 2, "frame run length is 2 pixels");
        i = j; }
      if (!prevPath.empty() && prevMirrored == mir) {
        bool shifted = true;
        for (size_t k = 1; k < A.size(); k++) if (A[k] != prevPath[k-1]) shifted = false;
        CHECK(shifted, "frame pattern advances one pixel per step toward the end corner");
      }
      prevPath = A; prevMirrored = mir;
      sawMirrored = sawMirrored || mir; sawNormal = sawNormal || !mir;
      } else prevPath.clear();
    }
    // Letters: one pixel per letter, green channel follows the deep-red colour rule (green = red / 12); effect 15 is grey.
    // Only checked in a step where the strip was shown (a pattern change between two shows leaves the old colours on the strip).
    static unsigned long lastLetterShows = 0;
    if (let->shows != lastLetterShows) {
      lastLetterShows = let->shows;
      for (size_t p = 0; p < let->numPixels(); p++) {
        const uint32_t c = let->shown_[p];
        if (activeLetters == 14) CHECK(((c >> 8) & 0xFF) == ((c >> 16) & 0xFF) && (c & 0xFF) == ((c >> 16) & 0xFF), "letter pixel colour: effect 15 is always grey");
        else CHECK(((c >> 8) & 0xFF) == ((c >> 16) & 0xFF) / 12 && (c & 0xFF) == 0, "letter pixel colour: red with a little green, no blue");
      }
      if (flickerLetter != NO_LETTER) sawFlicker = true;
    }
    if (g_millis > 1) {
      // Per-mode behaviour (skip the flicker letter, which is deliberately overridden).
      const unsigned long tm = g_millis - letterModeStart;
      if (tm > 300) {
        const int m = letterMode;
        int lit = 0, off = 0; uint8_t lo = 255, hi = 0;
        for (uint8_t l = 0; l < LETTER_COUNT; l++) { if (l == flickerLetter) continue;
          uint8_t v = shownLevel(let, l); if (v > 150) lit++; if (v < 8) off++; if (v < lo) lo = v; if (v > hi) hi = v; }
        if (off >= LETTER_COUNT - 1) minMax[m][0] = true;
        if (lit >= LETTER_COUNT - 1) minMax[m][1] = true;
        if (hi - lo > 150) minMax[m][2] = true;
        if (m == MODE_WORD_BLINK) {
          uint8_t a = shownLevel(let, FIRST_WORD_LETTERS), b = shownLevel(let, 0);
          if (flickerLetter != FIRST_WORD_LETTERS) { if (a < secondWordLo) secondWordLo = a; if (a > secondWordHi) secondWordHi = a; }
          if (flickerLetter != 0 && b < firstWordLo) firstWordLo = b;
        }
        if (m == MODE_BREATHE) for (uint8_t l = 0; l < LETTER_COUNT; l++) if (l != flickerLetter && shownLevel(let,l) < breatheMin) breatheMin = shownLevel(let,l);
        if (m == MODE_ALTERNATE && flickerLetter != 0 && flickerLetter != 1 && abs((int)shownLevel(let,0) - (int)shownLevel(let,1)) > 100) altDiffer = true;
      }
    }
    // Casino open: the CLOSED light stays dark.
    for (auto c : clo->shown_) CHECK(c == 0, "CLOSED light is off while the casino is open");
    // Arrow: which LEDs are lit follows the switch (hard-coded lists; stick numbers: L-CAP 0, L-WING-UP 1, L-WING-DN 2,
    // RAIL-UP-L 3, RAIL-UP-R 4, RAIL-DN-L 5, RAIL-DN-R 6, R-CAP 7, R-WING-UP 8, R-WING-DN 9).
    //   points right: tail cap L-CAP lit on LEDs 2..7 only; head cap R-CAP lit on LEDs 0,1,2,7,8,9 only;
    //                 rails and R-WING-UP/DN fully lit; L-WING-UP/DN dark
    //   points left:  tail cap R-CAP lit on LEDs 2..7 only; head cap L-CAP lit on LEDs 0,1,2,7,8,9 only;
    //                 rails and L-WING-UP/DN fully lit; R-WING-UP/DN dark
    auto expectDir = [&](unsigned long from, unsigned long to, bool right, const char *msg) {
      if (g_millis > from && g_millis < to) {
        const bool tailLit[10] = {0, 0, 1, 1, 1, 1, 1, 1, 0, 0}, headLit[10] = {1, 1, 1, 0, 0, 0, 0, 1, 1, 1};
        const int tailCap = right ? 0 : 7, headCap = right ? 7 : 0;
        for (int i = 0; i < 10; i++) {
          CHECK((st[tailCap]->shown_[i] != 0) == (tailLit[i] != 0), msg);
          CHECK((st[headCap]->shown_[i] != 0) == (headLit[i] != 0), msg);
        }
        const int rails[4] = {3, 4, 5, 6};
        for (int i = 0; i < 4; i++) for (auto c : st[rails[i]]->shown_) CHECK(c != 0, msg);
        for (int w : {right ? 8 : 1, right ? 9 : 2}) for (auto c : st[w]->shown_) CHECK(c != 0, msg);
        for (int w : {right ? 1 : 8, right ? 2 : 9}) for (auto c : st[w]->shown_) CHECK(c == 0, msg);
      } };
    expectDir(1000, 4900, true, "before the switch moves: right head, tail cap L-CAP middle 6, head cap R-CAP ends 3+3");
    expectDir(5200, 24900, false, "switch LOW: left head, tail cap R-CAP middle 6, head cap L-CAP ends 3+3");
    expectDir(25200, 44900, true, "switch HIGH: right head, tail cap L-CAP middle 6, head cap R-CAP ends 3+3");
    expectDir(45000, 59900, true, "10 ms glitch ignored: still the right head");   // 45000..: glitch
    expectDir(60200, END, false, "bouncing switch settles LOW: left head");

    // Flow check with the white pulse head: at every arrow update exactly one LED is pure white, the LED whose flow
    // coordinate equals the pulse position. The upper route's pulse position is tick % 72, the lower route's is
    // (tick + 36) % 72; a pulse head exists on a route only while its position is 0..35. The map flow coordinate ->
    // (stick, LED) is hard-coded here (36 LEDs per route):
    //   points right: upper s0-2 L-CAP LEDs 4,3,2; s3-12 RAIL-UP-L 0..9; s13-22 RAIL-UP-R 9..0; s23-25 R-CAP LEDs 2,1,0;
    //                 s26-35 R-WING-UP 9..0
    //                 lower s0-2 L-CAP LEDs 5,6,7; s3-12 RAIL-DN-L 0..9; s13-22 RAIL-DN-R 9..0; s23-25 R-CAP LEDs 7,8,9;
    //                 s26-35 R-WING-DN 9..0
    //   points left:  upper s0-2 R-CAP LEDs 4,3,2; s3-12 RAIL-UP-R 0..9; s13-22 RAIL-UP-L 9..0; s23-25 L-CAP LEDs 2,1,0;
    //                 s26-35 L-WING-UP 9..0
    //                 lower s0-2 R-CAP LEDs 5,6,7; s3-12 RAIL-DN-R 0..9; s13-22 RAIL-DN-L 9..0; s23-25 L-CAP LEDs 7,8,9;
    //                 s26-35 L-WING-DN 9..0
    CHECK(ARROW_POINTS_LEFT_WHEN_LOW == (EXPECT_LOW_IS_LEFT != 0), "ARROW_POINTS_LEFT_WHEN_LOW has the expected value");
    CHECK(STICK_BALL_AT_DIN_END == (EXPECT_BALL_AT_DIN != 0), "STICK_BALL_AT_DIN_END has the expected value");
    if (st[3]->shows != lastArrowShows && g_millis > 1000) {
      lastArrowShows = st[3]->shows;
      const bool right = arrowPointsRight;
      const int tickDrawn = (int)arrowTick - 1;
      auto where = [&](bool lower, int s, int &stick, int &led) {
        if (s < 3) { stick = right ? 0 : 7; led = lower ? 5 + s : 4 - s; }
        else if (s < 13) { stick = lower ? (right ? 5 : 6) : (right ? 3 : 4); led = s - 3; }
        else if (s < 23) { stick = lower ? (right ? 6 : 5) : (right ? 4 : 3); led = 22 - s; }
        else if (s < 26) { stick = right ? 7 : 0; led = lower ? s - 16 : 25 - s; }
        else { stick = lower ? (right ? 9 : 2) : (right ? 8 : 1); led = 35 - s; }
      };
      int want = 0; bool found[2] = {false, false};
      for (int lane = 0; lane < 2; lane++) {
        const int pulse = (tickDrawn + (lane ? 36 : 0)) % 72;
        if (pulse <= 35) { int sk, ld; where(lane == 1, pulse, sk, ld); want++;
          found[lane] = (st[sk]->shown_[PHYS(ld)] & 0xFFFFFF) == 0xFFFFFF; }
      }
      int whites = 0;
      for (int k = 0; k < 10; k++) for (auto c : st[k]->shown_) if ((c & 0xFFFFFF) == 0xFFFFFF) whites++;
      CHECK(want == 1 && whites == 1, "arrow: exactly one white pulse head on the arrow");
      for (int lane = 0; lane < 2; lane++) if ((tickDrawn + (lane ? 36 : 0)) % 72 <= 35) CHECK(found[lane], "arrow: the white pulse head is on the LED with the right flow coordinate");
      arrowFlowChecks++;
    }
    if (out && g_millis - lastDump >= 250) { dump(out); lastDump = g_millis; }
  }
  // ---- Speeds: menu properties Speed > Frame, Letters, Arrow (x0.125 .. x4 in 30 log steps, default x1 = position 18) ----
  auto run = [&](unsigned long ms) { for (unsigned long k = 0; k < ms; k++) { g_millis++; loop(); } };
  CHECK(frameIntervalMs == 200 && arrowIntervalMs == 35 && letterMult256 == 256, "default speeds: x1 for the frame, the arrow and the letters");
  CHECK(menuPos(P_speedFrame) == 18 && menuPos(P_speedArrow) == 18 && menuPos(P_speedLetters) == 18, "the speed properties start at position 18 (x1.000)");
  const int speedPos[][3] = {{0, 30, 18}, {30, 0, 4}, {8, 24, 30}, {18, 18, 0}};   // frame, letters, arrow positions
  for (auto &pr : speedPos) {
    menuSetPos(P_speedFrame, pr[0]); menuSetPos(P_speedLetters, pr[1]); menuSetPos(P_speedArrow, pr[2]);
    run(300);
    const double mFrame = 0.125 * pow(32.0, pr[0] / 30.0), mLet = 0.125 * pow(32.0, pr[1] / 30.0), mArrow = 0.125 * pow(32.0, pr[2] / 30.0);
    double wantFrame = 200.0 / mFrame, wantArrow = 35.0 / mArrow;
    if (wantFrame < 8) wantFrame = 8;
    if (wantArrow < 8) wantArrow = 8;
    CHECK(fabs((double)frameIntervalMs - wantFrame) <= 1.0 + 0.015 * wantFrame, "frame interval follows the frame speed property");
    CHECK(fabs((double)arrowIntervalMs - wantArrow) <= 1.0 + 0.015 * wantArrow, "arrow interval follows the arrow speed property (separate from the frame)");
    const long f0 = fr->shows, a0 = st[3]->shows, l0 = let->shows;
    const unsigned long clk0 = letterClockMs;
    run(24000);
    const double gotFrame = 24000.0 / (fr->shows - f0), gotArrow = 24000.0 / (st[3]->shows - a0);
    CHECK(fabs(gotFrame - wantFrame) <= 0.03 * wantFrame + 1.5, "measured frame update period matches");
    CHECK(fabs(gotArrow - wantArrow) <= 0.03 * wantArrow + 1.5, "measured arrow update period matches");
    const double clockRate = (double)(letterClockMs - clk0) / 24000.0;
    CHECK(fabs(clockRate - mLet) <= 0.02 * mLet + 0.005, "letter pattern clock runs at the letters speed multiplier");
    CHECK(let->shows - l0 > 150, "letters keep updating at their own rate");
    printf("  speeds at positions %d/%d/%d: frame %.0f ms, arrow %.1f ms, letters x%.2f\n", pr[0], pr[1], pr[2], gotFrame, gotArrow, clockRate);
  }
  menuSetPos(P_speedFrame, 18); menuSetPos(P_speedLetters, 18); menuSetPos(P_speedArrow, 18);
  // The menu switch is a hex switch with a debounce (tested with the menu below); here the program is chosen in the menu properties.
  setProgram(0); run(200);
  setProgram(4); run(150);
  CHECK(letterMode == 4 && activeFrame == 4 && menuActiveLetters == 5 && menuActiveFrame == 5, "choosing effect 5 for both groups shows pattern 4 and publishes the numbers for the status page");
  setProgram(0); run(150);

  // ---- Casino closed tests ----
  run(300);
  auto openLevel = [&](int k) { return shownLevel(let, FIRST_WORD_LETTERS + k); };
  auto pressMode = [&]() { const int to = (letterMode + 1) % 16; setProgram(to); run(180); };   // next program (both effects)
  while (letterMode != MODE_BREATHE) pressMode();
  // V2: the typewriter lights the letters in reading order C A S I N O, O P E N; on the strip that is the pixel order
  // 0 1 2 3 4 5, then 9 8 7 6 (OPEN is wired reversed). Pixel numbers are hard-coded here.
  {
    static const int WANT_ORDER[10] = {0, 1, 2, 3, 4, 5, 9, 8, 7, 6};
    while (letterMode != MODE_TYPEWRITER) pressMode();
    long firstLit[10]; for (int p = 0; p < 10; p++) firstLit[p] = -1;
    const unsigned long t0 = g_millis;
    for (int k = 0; k < 6000; k++) { run(1); for (int p = 0; p < 10; p++) if (firstLit[p] < 0 && ((let->shown_[p] >> 16) & 0xFF) > 100) firstLit[p] = (long)(g_millis - t0); }
    bool ordered = true;
    for (int i = 0; i < 10; i++) { if (firstLit[WANT_ORDER[i]] < 0) ordered = false; if (i > 0 && firstLit[WANT_ORDER[i]] <= firstLit[WANT_ORDER[i - 1]]) ordered = false; }
    CHECK(ordered, "typewriter runs in reading order: strip pixels 0-5, then 9, 8, 7, 6 (OPEN is reversed on the strip)");
    for (int l = 0; l < 10; l++) CHECK(letterPixel(l) == WANT_ORDER[l], "letterPixel() maps the letters to the strip pixels");
    while (letterMode != MODE_BREATHE) pressMode();
  }
  // a 10 ms glitch on the switch must be ignored
  g_pinLevel[PIN_CASINO_CLOSED_SWITCH] = LOW; run(10); g_pinLevel[PIN_CASINO_CLOSED_SWITCH] = HIGH; run(200);
  CHECK(!casinoClosed, "10 ms glitch on the casino closed switch is ignored");
  // the OPEN letters are lit in breathe mode while open
  { int lit = 0; for (int k = 0; k < 600; k++) { run(1); for (int l = 0; l < LETTER_COUNT - FIRST_WORD_LETTERS; l++) if (openLevel(l) > 60) lit++; }
    CHECK(lit > 0, "OPEN letters are lit while the casino is open"); }
  g_pinLevel[PIN_CASINO_CLOSED_SWITCH] = LOW; run(100);
  CHECK(casinoClosed, "casino closed after the switch goes LOW");
  int prevFlick = NO_LETTER; bool sawFull = false, sawDim = false, sawOffAfterStart = false, startupZero = false, startupFull = false;
  long openLit = 0, firstLit = 0, nonWhite = 0;
  for (int mode = 0; mode < LETTER_MODE_COUNT; mode++) {
    long casinoLit = 0;
    for (int k = 0; k < 6000; k++) {
      run(1);
      for (int l = 0; l < LETTER_COUNT - FIRST_WORD_LETTERS; l++) if (openLevel(l) != 0) openLit++;
      for (int l = 0; l < FIRST_WORD_LETTERS; l++) if (shownLevel(let, l) > 20) casinoLit++;
      if (flickerLetter != NO_LETTER && prevFlick == NO_LETTER) CHECK(flickerLetter < FIRST_WORD_LETTERS, "only CASINO letters flicker while closed");
      prevFlick = flickerLetter;
      // CLOSED light: always white (R = G = B) and all LEDs equal
      for (auto c : clo->shown_) { if (((c >> 16) & 0xFF) != ((c >> 8) & 0xFF) || ((c >> 8) & 0xFF) != (c & 0xFF) || c != clo->shown_[0]) nonWhite++; }
      const uint8_t v = clo->shown_[0] & 0xFF;
      if (g_millis % 7 == 0) { }
      if (closedState == CL_STEADY) { if (v == 255) sawFull = true; }
      if (closedState == CL_FLICKER) { if (v > 0 && v < 255) sawDim = true; if (v == 0) sawOffAfterStart = true; }
      if (closedState == CL_STARTUP) { if (v == 0) startupZero = true; if (v == 255) startupFull = true; }
      if (out && g_millis % 250 == 0) dump(out);
    }
    firstLit += casinoLit;
    CHECK(casinoLit > 0, "CASINO letters still follow the mode while closed");
    pressMode();
  }
  CHECK(openLit == 0, "OPEN letters are dark in every mode while the casino is closed");
  CHECK(nonWhite == 0, "CLOSED light is always white and uniform");
  CHECK(sawFull && sawDim && sawOffAfterStart, "CLOSED light has steady phases and flicker bursts with full, dim and dark levels");
  CHECK(startupZero && startupFull, "CLOSED light flashes while starting up");
  // speed: at x4 the flicker bursts come much more often than at x0.25
  auto bursts = [&](int pos, unsigned long ms) { menuSetPos(P_speedLetters, pos); run(300); int n = 0, prev = closedState;
    for (unsigned long k = 0; k < ms; k++) { run(1); if (closedState == CL_FLICKER && prev != CL_FLICKER) n++; prev = closedState; } return n; };
  const int fast = bursts(30, 60000), slow = bursts(0, 60000);
  CHECK(fast >= 5 && slow <= 2 && fast > slow, "CLOSED light timing follows the letters speed property");
  printf("  CLOSED flicker bursts in 60 s: x4.000 -> %d, x0.125 -> %d\n", fast, slow);
  menuSetPos(P_speedLetters, 18); run(300);
  // reopen: OPEN letters come back, CLOSED light goes dark
  g_pinLevel[PIN_CASINO_CLOSED_SWITCH] = HIGH; run(100);
  CHECK(!casinoClosed, "casino open again after the switch goes HIGH");
  while (letterMode != MODE_BREATHE) pressMode();
  { int lit = 0; bool lightOff = true; for (int k = 0; k < 1500; k++) { run(1); for (int l = 0; l < LETTER_COUNT - FIRST_WORD_LETTERS; l++) if (openLevel(l) > 60) lit++;
        if (k > 100) for (auto c : clo->shown_) if (c != 0) lightOff = false; }
    CHECK(lit > 0, "OPEN letters light up again after reopening"); CHECK(lightOff, "CLOSED light is off after reopening"); }
  printf("  closed phase: CASINO letters lit samples %ld\n", firstLit);

  // ---- New letter modes (scanner, sparkle, chase, pulse) and random auto ----
  menuSetPos(P_speedLetters, 18); run(300);
  auto gotoMode = [&](uint8_t m) { while (letterMode != m) pressMode(); run(400); };
  {
    // scanner: a bright head moves over all letters; letters behind it glow as a tail
    gotoMode(MODE_SCANNER);
    bool heads[LETTER_COUNT] = {}; int spreadMs = 0, tailMs = 0;
    for (int k = 0; k < 5000; k++) { run(1);
      if (flickerLetter != NO_LETTER) continue;
      int best = 0; uint8_t hi = 0, lo = 255;
      for (uint8_t l = 0; l < LETTER_COUNT; l++) { uint8_t v = shownLevel(let, l); if (v > hi) { hi = v; best = l; } if (v < lo) lo = v; }
      if (hi >= 180) heads[best] = true;
      if (hi - lo > 150) spreadMs++;
      int mid = 0; for (uint8_t l = 0; l < LETTER_COUNT; l++) { uint8_t v = shownLevel(let, l); if (v > 60 && v < 230) mid++; }
      if (mid >= 2) tailMs++;
    }
    int seen = 0; for (bool h : heads) seen += h;
    CHECK(seen >= LETTER_COUNT - 1, "scanner: the bright head visits (almost) every letter");
    CHECK(spreadMs > 3000, "scanner: most of the time only part of the text is bright");
    CHECK(tailMs > 2500, "scanner: letters around the head glow as a tail");
  }
  {
    // sparkle: random letters flash and fade; levels in between exist
    gotoMode(MODE_SPARKLE);
    long flashes[LETTER_COUNT] = {}; bool fading = false; long total = 0;
    for (int k = 0; k < 6000; k++) { run(1);
      if (flickerLetter != NO_LETTER) continue;
      total++;
      for (uint8_t l = 0; l < LETTER_COUNT; l++) { uint8_t v = shownLevel(let, l); if (v > 200) flashes[l]++; if (v > 80 && v < 180) fading = true; }
    }
    bool every = true; for (long f : flashes) if (f < total / 40 || f > total / 2) every = false;
    CHECK(every, "sparkle: every letter sparkles sometimes, none all the time");
    CHECK(fading, "sparkle: flashes fade out softly");
  }
  {
    // chase: exactly one dim letter per word, and it moves
    gotoMode(MODE_CHASE);
    bool dimSeen[LETTER_COUNT] = {}; bool exactlyTwo = true;
    for (int k = 0; k < 4000; k++) { run(1);
      if (flickerLetter != NO_LETTER) continue;
      int dimFirst = 0, dimSecond = 0;
      for (uint8_t l = 0; l < LETTER_COUNT; l++) if (shownLevel(let, l) < 60) { (l < FIRST_WORD_LETTERS ? dimFirst : dimSecond)++; dimSeen[l] = true; }
      if (dimFirst != 1 || dimSecond != 1) exactlyTwo = false;
    }
    int seen = 0; for (bool d : dimSeen) seen += d;
    CHECK(exactlyTwo, "chase: exactly one dim letter in each word at any time");
    CHECK(seen == LETTER_COUNT, "chase: the dim spot visits every letter");
  }
  {
    // pulse: all letters equal, strong beats and a dim pause
    gotoMode(MODE_PULSE);
    bool uniform = true; uint8_t lo = 255, hi = 0;
    for (int k = 0; k < 4000; k++) { run(1);
      if (flickerLetter != NO_LETTER) continue;
      uint8_t ref = shownLevel(let, 0); if (ref < lo) lo = ref; if (ref > hi) hi = ref;
      for (uint8_t l = 1; l < LETTER_COUNT; l++) if (shownLevel(let, l) != ref) uniform = false;
    }
    CHECK(uniform, "pulse: all letters have the same brightness at the same time");
    CHECK(lo <= 60 && hi >= 200, "pulse: strong beats and a dim pause");
  }
  {
    // random effects (effect 0): a random group picks only real patterns, never the same twice in a row, uses all of them,
    // and one shared timer changes every random group after the Random delay (default 2 minutes)
    gotoMode(MODE_RANDOM_AUTO);
    CHECK(letterMode == MODE_RANDOM_AUTO && activeLetters < PATTERN_MODE_COUNT && activeFrame < PATTERN_MODE_COUNT, "random effects: both groups show a real pattern");
    CHECK(menuActiveFrame == activeFrame + 1 && menuActiveLetters == activeLetters + 1, "random effects: the status page gets the numbers of the patterns really showing");
    bool usedF[PATTERN_MODE_COUNT] = {}, usedL[PATTERN_MODE_COUNT] = {}; bool noRepeat = true, inRange = true;
    uint8_t prevF = activeFrame, prevL = activeLetters;
    for (int k = 0; k < 3000; k++) {
      autoPickedAt = g_millis - autoDelayMs; updateRandomEffects(g_millis);
      if (activeFrame == prevF || activeLetters == prevL) noRepeat = false;
      if (activeFrame >= PATTERN_MODE_COUNT || activeLetters >= PATTERN_MODE_COUNT) inRange = false; else { usedF[activeFrame] = true; usedL[activeLetters] = true; }
      prevF = activeFrame; prevL = activeLetters;
    }
    bool all = true; for (int i = 0; i < PATTERN_MODE_COUNT; i++) if (!usedF[i] || !usedL[i]) all = false;
    CHECK(noRepeat, "random effects: neither group picks the same pattern twice in a row");
    CHECK(inRange && all, "random effects: both groups pick every pattern 0..14 and nothing else");
    { int differ = 0; for (int k = 0; k < 2000; k++) { const uint8_t f = activeFrame; autoPickedAt = g_millis - autoDelayMs; updateRandomEffects(g_millis); if (activeFrame - f != activeLetters - activeLetters + (int)activeFrame - f) {} if (activeFrame != activeLetters) differ++; }
      CHECK(differ > 500, "random effects: the two groups draw independently (they are often different patterns)"); }
    menuSetPos(P_frameEffect, 1); menuSetPos(P_lettersEffect, 1); menuSetPos(P_frameEffect, 0); menuSetPos(P_lettersEffect, 0);   // both random, timer restarted by the last change
    int changesF = 0, changesL = 0; uint8_t lastF = activeFrame, lastL = activeLetters; unsigned long firstChange = 0, start = g_millis; bool together = true;
    for (unsigned long k = 0; k < 3 * 120000UL + 5000UL; k++) { run(1);
      const bool cf = activeFrame != lastF, cl = activeLetters != lastL;
      if (cf != cl) together = false;
      if (cf) { changesF++; lastF = activeFrame; if (!firstChange) firstChange = g_millis - start; }
      if (cl) { changesL++; lastL = activeLetters; } }
    CHECK(changesF == 3 && changesL == 3, "random effects: a new pattern after each 2 minutes (default Random delay)");
    CHECK(together, "random effects: both random groups change at the same moment");
    CHECK(firstChange >= 120000UL - 50 && firstChange <= 120000UL + 100, "random effects: first change after about two minutes");
    CHECK(letterMode == MODE_RANDOM_AUTO && frameIsRandom() && lettersIsRandom(), "random effects: the selected effects stay random");
    // only the random group changes; a fixed effect never changes by itself
    menuSetPos(P_frameEffect, 5);
    CHECK(activeFrame == 4 && !frameIsRandom() && lettersIsRandom(), "a fixed frame effect shows its own pattern, letters stay random");
    { const uint8_t l0 = activeLetters; int nl = 0; uint8_t la = l0; bool frameSteady = true;
      autoPickedAt = g_millis; menuSetPos(P_randomDelay, 1); restartRandomTimer(g_millis);
      for (unsigned long k = 0; k < 130000UL; k++) { run(1); if (activeFrame != 4) frameSteady = false; if (activeLetters != la) { nl++; la = activeLetters; } }
      CHECK(frameSteady, "a fixed frame effect does not change when the shared timer runs out");
      CHECK(nl == 2, "the random letters change by themselves (after 1 minute: twice in 130 s)"); }
    menuSetPos(P_randomDelay, 2);
    menuSetPos(P_lettersEffect, 8); menuSetPos(P_frameEffect, 0);
    { const uint8_t l8 = activeLetters; CHECK(l8 == 7 && !lettersIsRandom() && frameIsRandom(), "a fixed letters effect shows its own pattern, the frame is random");
      const uint8_t f0 = activeFrame; autoPickedAt = g_millis - autoDelayMs; updateRandomEffects(g_millis);
      CHECK(activeFrame != f0 && activeLetters == 7, "only the random frame changed when the timer ran out"); }
    // choosing random for a group picks a pattern at once and restarts the shared timer
    menuSetPos(P_frameEffect, 2); menuSetPos(P_lettersEffect, 2);
    { const unsigned long before = autoPickedAt; run(1000); menuSetPos(P_frameEffect, 0);
      CHECK(autoPickedAt > before && frameIsRandom() && activeFrame < PATTERN_MODE_COUNT, "choosing random for the frame picks a pattern and restarts the shared timer");
      const unsigned long mid = autoPickedAt; run(500); menuSetPos(P_lettersEffect, 0);
      CHECK(autoPickedAt > mid, "choosing random for the letters restarts the shared timer, so both groups still change together"); }
    // the Random delay property: 1 minute, and 0 = a random delay of 1..30 minutes
    setProgram(MODE_RANDOM_AUTO); menuSetPos(P_randomDelay, 1); restartRandomTimer(g_millis);
    CHECK(autoDelayMs == 60000UL, "random effects: Random delay 1 gives a 60 s delay");
    { unsigned long t0 = g_millis; uint8_t a0 = activeLetters; int n = 0;
      while (g_millis - t0 < 70000UL) { run(1); if (activeLetters != a0) { n++; a0 = activeLetters; } }
      CHECK(n == 1, "random effects: with Random delay 1 the pattern changes after one minute"); }
    menuSetPos(P_randomDelay, 0);
    { bool multiple = true, inRange = true; int smallest = 99, largest = 0;
      for (int k = 0; k < 400; k++) { restartRandomTimer(g_millis); if (autoDelayMs % 60000UL != 0) multiple = false;
        const int m = (int)(autoDelayMs / 60000UL); if (m < 1 || m > 30) inRange = false; if (m < smallest) smallest = m; if (m > largest) largest = m; }
      CHECK(multiple && inRange, "random effects: Random delay 0 draws whole minutes from 1 to 30");
      CHECK(smallest <= 3 && largest >= 28, "random effects: Random delay 0 uses the whole range 1..30 minutes"); }
    menuSetPos(P_randomDelay, 2);
    pressMode(); CHECK(letterMode == MODE_BREATHE, "choosing program 0 after random shows breathe again");
  }
  // ---- LCD display (fake HD44780 + PCF8574 backpack on the mock Wire) and the settings menu on the real controls ----
  {
    auto rtrim = [](std::string r) { while (!r.empty() && r.back() == ' ') r.pop_back(); return r; };
    auto line0 = [&]() { return rtrim(Wire.row(0)); };
    auto line1 = [&]() { return rtrim(Wire.row(1)); };
    CHECK(Wire.begun && Wire.clock == 400000UL, "LCD: I2C started at 400 kHz");
    CHECK(Wire.fourBit && Wire.clears >= 1 && Wire.backlight, "LCD: initialised in 4-bit mode, cleared, backlight on");
    CHECK(lcdOk, "LCD: found at start-up");
    CHECK(!Wire.oversize, "LCD: no transmission longer than the 32 byte Wire buffer");
    auto printable = [&]() { for (int r = 0; r < 2; r++) for (char c : Wire.row(r)) if ((c < 32 || c > 126) && c != 0x7E && c != 0x7F) return false; return true; };
    // Hard-coded pins of the menu controls and a model of the menu switch (starts at position 0 = all pins HIGH).
    CHECK(PIN_MENU_SWITCH[0] == 38 && PIN_MENU_SWITCH[1] == 41 && PIN_MENU_SWITCH[2] == 42 && PIN_MENU_SWITCH[3] == 45, "menu switch pins D38, D41, D42, D45");
    CHECK(PIN_OK == 46 && PIN_CANCEL == 49 && PIN_SHIFT == 50, "OK D46, CANCEL D49, SHIFT D50");
    static int menuPinPos = 0;
    auto setMenuPins = [&](int v) { for (int b = 0; b < 4; b++) g_pinLevel[PIN_MENU_SWITCH[b]] = ((v >> b) & 1) ? LOW : HIGH; };
    auto turn = [&](int steps) { const int d = steps < 0 ? -1 : 1; for (int k = 0; k < (steps < 0 ? -steps : steps); k++) { menuPinPos = (menuPinPos + d) & 15; setMenuPins(menuPinPos); run(25); } };
    auto key = [&](int pin) { g_pinLevel[pin] = LOW; run(60); g_pinLevel[pin] = HIGH; run(60); };
    auto settle = [&]() { run(200); };

    // ---- status page (row 0 "#<program> Casino Open|Closed", row 1 arrow symbol and customer direction) ----
    g_pinLevel[PIN_CASINO_CLOSED_SWITCH] = HIGH; g_pinLevel[PIN_ARROW_SWITCH] = SW_RIGHT; run(200);
    while (letterMode != MODE_BREATHE) pressMode();
    run(300);
    CHECK(menuMode == MM_STATUS, "status page after start-up");
    const std::string ARR_L = std::string(1, (char)0x7F) + " Customer right", ARR_R = std::string(1, (char)0x7E) + " Customer left";   // HD44780 ROM arrows
    CHECK(line0() == "F01 L01 Open" && line1() == ARR_L, "status page: effects 1 and 1, casino open, arrow points to the customer's right (left arrow symbol: seen from behind)");
    printf("  status page: '%s' / '%s'\n", line0().c_str(), line1().c_str());
    g_pinLevel[PIN_ARROW_SWITCH] = SW_LEFT; run(200);
    CHECK(line1() == ARR_R && !arrowPointsRight, "status page follows the arrow switch (customer left, right arrow symbol)");
    g_pinLevel[PIN_CASINO_CLOSED_SWITCH] = LOW; run(200);
    CHECK(line0() == "F01 L01 Closed" && casinoClosed, "status page shows Closed (and the sign follows)");
    g_pinLevel[PIN_CASINO_CLOSED_SWITCH] = HIGH; run(200);
    CHECK(line0() == "F01 L01 Open" && !casinoClosed, "status page shows Open again");
    g_pinLevel[PIN_ARROW_SWITCH] = SW_RIGHT; run(200);
    setProgram(10); run(200);
    CHECK(letterMode == 10 && line0() == "F11 L11 Open", "the effect numbers are shown with two digits (F11 L11)");
    setProgram(0); run(200);
    for (int m = 0; m < 15; m++) { setProgram(m); run(200); char want[24]; snprintf(want, sizeof want, "F%02d L%02d Open", m + 1, m + 1);
      CHECK(printable() && line0() == want && letterMode == m, "status page: every effect pair 1..15 is shown"); }
    setProgram(MODE_RANDOM_AUTO); run(200);
    { char want[24]; snprintf(want, sizeof want, "F*%02d L*%02d Open", (int)activeFrame + 1, (int)activeLetters + 1);
      CHECK(printable() && line0() == want, "status page: random groups show * before the number of the pattern really showing"); }
    menuSetPos(P_lettersEffect, 4); run(200);
    { char want[24]; snprintf(want, sizeof want, "F*%02d L04 Open", (int)activeFrame + 1);
      CHECK(line0() == want, "status page: only the random group has the star (F*.. L04)"); }
    menuSetPos(P_frameEffect, 9); run(200);
    CHECK(line0() == "F09 L04 Open", "status page: the frame and the letters effects are independent (F09 L04)");
    setProgram(0); run(200);
    // OK acts on the press (not on the release); a half turn (exactly 8) of the menu switch is ignored
    { setProgram(0); run(200); CHECK(menuMode == MM_STATUS, "OK test starts at the status page");
      g_pinLevel[PIN_OK] = LOW; run(60);
      CHECK(menuMode == MM_MENU, "OK opens the menu while the button is still held (acts on the press)");
      g_pinLevel[PIN_OK] = HIGH; run(60);
      CHECK(menuMode == MM_MENU, "releasing OK does not do anything else");
      const std::string h0 = line0(), h1 = line1();
      menuPinPos = (menuPinPos + 8) & 15; setMenuPins(menuPinPos); run(300);
      CHECK(line0() == h0 && line1() == h1, "a half turn (code change of exactly 8) of the menu switch is ignored");
      key(PIN_CANCEL); run(200);
      CHECK(menuMode == MM_STATUS, "CANCEL from the menu root returns to the status page"); }
    // random: row 1 alternates between the arrow text and "Change in M:SS"
    { setProgram(0); run(200); bool noCountdown = true;   // other programs never show the countdown
      for (int k = 0; k < 7000; k++) { run(1); if (line1().rfind("Change in ", 0) == 0) noCountdown = false; }
      CHECK(noCountdown && menuChangeInSec == -1, "fixed effects: row 1 never shows the countdown");
      setProgram(MODE_RANDOM_AUTO); run(200); CHECK(line1() == ARR_L, "random: row 1 starts with the arrow text, the countdown follows");
      bool sawArrow = false, sawCountdown = false;
      for (int k = 0; k < 7000; k++) { run(1); const std::string l1 = line1(); if (l1 == ARR_L) sawArrow = true; if (l1.rfind("Change in ", 0) == 0) sawCountdown = true; }
      CHECK(sawArrow && sawCountdown, "random: row 1 alternates between the arrow text and the change countdown");
      CHECK(line0().rfind("F*", 0) == 0 && line0().find(" L*") == 4, "random: row 0 shows F*.. L*..");
      menuSetPos(P_frameEffect, 3); run(200); { bool cd = false; for (int k = 0; k < 7000; k++) { run(1); if (line1().rfind("Change in ", 0) == 0) cd = true; } CHECK(cd, "the countdown shows while only the letters are random"); }
      menuSetPos(P_frameEffect, 0); menuSetPos(P_lettersEffect, 3); run(200); { bool cd = false; for (int k = 0; k < 7000; k++) { run(1); if (line1().rfind("Change in ", 0) == 0) cd = true; } CHECK(cd, "the countdown shows while only the frame is random"); }
      menuSetPos(P_frameEffect, 3); run(200); { bool cd = false; for (int k = 0; k < 7000; k++) { run(1); if (line1().rfind("Change in ", 0) == 0) cd = true; } CHECK(!cd && menuChangeInSec == -1, "no countdown when both effects are fixed"); }
      setProgram(MODE_RANDOM_AUTO); run(200);
      // the countdown shows the time left until the next random program: 2 minutes (default) minus the time passed
      bool okCount = false; int samples = 0;
      for (int k = 0; k < 7000 && samples < 3; k++) { run(1); const std::string l1 = line1();
        if (l1.rfind("Change in ", 0) == 0) { int m = 0, sec = 0; if (sscanf(l1.c_str() + 10, "%d:%d", &m, &sec) == 2) { samples++;
          const long left = 120L - (long)((g_millis - autoPickedAt) / 1000UL); if (labs((long)(m * 60 + sec) - left) <= 1 && menuChangeInSec == (long)((120000UL - (g_millis - autoPickedAt) + 999UL) / 1000UL)) okCount = true; else { okCount = false; break; } k += 400; } } }
      CHECK(okCount && samples >= 1, "random: the countdown shows the time left of the 2 minutes (M:SS)"); }
    setProgram(0); run(200);

    // ---- the menu on the real controls ----
    key(PIN_OK);
    CHECK(menuMode == MM_MENU && menuDepth == 1, "OK opens the menu at the root");
    CHECK(line0().rfind("Menu", 0) == 0 && line1().rfind("Controls", 0) == 0, "root: title Menu, first item Controls");
    printf("  menu root: '%s' / '%s'\n", Wire.row(0).c_str(), Wire.row(1).c_str());
    turn(1); settle(); CHECK(line1().rfind("Effects", 0) == 0, "one step on the menu switch moves to Effects");
    turn(1); settle(); CHECK(line1().rfind("Speed", 0) == 0, "after Effects comes Speed");
    turn(1); settle(); CHECK(line1().rfind("Frame", 0) == 0, "after Speed comes the Frame menu");
    turn(-1); turn(-1); turn(-1); turn(-5); settle(); CHECK(line1().rfind("Controls", 0) == 0, "the selection stops at the top (no wrap)");
    turn(2); settle(); key(PIN_OK);                    // Speed
    CHECK(menuDepth == 2 && line1().rfind("Frame", 0) == 0, "OK enters Speed (first row Frame)");
    key(PIN_OK);                                        // edit Frame speed
    CHECK(menuMode == MM_EDIT, "OK on a property starts editing");
    turn(3); settle();
    CHECK(menuPos(P_speedFrame) == 21, "turning the menu switch three steps raises the frame speed by three positions");
    CHECK(fabs((double)frameIntervalMs - 200.0 / (0.125 * pow(32.0, 21 / 30.0))) <= 3.0, "the new frame speed is applied while editing");
    g_pinLevel[PIN_SHIFT] = LOW; run(60);
    turn(1); settle();
    CHECK(menuPos(P_speedFrame) == 30, "SHIFT held makes the step bigger (10 steps, clamped at the top)");
    g_pinLevel[PIN_SHIFT] = HIGH; run(60);
    key(PIN_CANCEL); settle();
    CHECK(menuMode == MM_MENU && menuPos(P_speedFrame) == 18 && frameIntervalMs == 200, "CANCEL cancels the edit: the old speed returns");
    key(PIN_OK); turn(-4); key(PIN_OK); settle();       // edit and accept
    CHECK(menuMode == MM_MENU && menuPos(P_speedFrame) == 14, "OK accepts the edited value");
    CHECK(EEPROM.mem[0] != 0xFF && EEPROM.mem[3] != 0xFF, "the layout tag was written to EEPROM at address 0");
    { unsigned char savedSlot = EEPROM.mem[4 + menuRd8(PP_SLOT, P_speedFrame)]; CHECK(savedSlot == 14, "EEPROM holds position 14 for the frame speed"); }
    key(PIN_CANCEL); key(PIN_CANCEL); key(PIN_CANCEL); settle();
    CHECK(menuMode == MM_STATUS, "CANCEL from a submenu leads back to the status page");
    // the 60 s timer runs only at the root while browsing
    key(PIN_OK); run(59000); CHECK(menuMode == MM_MENU, "root: still open after 59 s");
    run(1500); CHECK(menuMode == MM_STATUS, "root: back to the status page after 60 s without input");
    key(PIN_OK); turn(1); key(PIN_OK); run(65000); CHECK(menuMode == MM_MENU && menuDepth == 2, "inside a submenu there is no timeout");
    key(PIN_OK); run(65000); CHECK(menuMode == MM_EDIT, "while editing there is no timeout");
    key(PIN_CANCEL); key(PIN_CANCEL); key(PIN_CANCEL); settle();
    CHECK(menuMode == MM_STATUS, "CANCEL at the root returns to the status page");

    // ---- the menu structure: Frame / Letters / Arrow groups, a view page with a padlock for read-only values ----
    { static const uint8_t lock[8] = {0x0E, 0x11, 0x11, 0x1F, 0x1B, 0x1B, 0x1F, 0x00};
      bool lockLoaded = true; for (int k = 0; k < 8; k++) if (Wire.cgram[8 + k] != lock[k]) lockLoaded = false;
      CHECK(lockLoaded, "the padlock is loaded into custom character 1 of the display");
      menuSetPos(P_speedFrame, 18); run(50);
      key(PIN_OK); turn(3); settle();
      CHECK(line1().rfind("Frame", 0) == 0, "root item 3 is the Frame group");
      key(PIN_OK); settle();
      printf("  Frame group rows: '%s' / '%s'\n", line0().c_str(), line1().c_str());
      CHECK(line0() == "Frame" && line1().rfind("Frame effect:", 0) == 0, "Frame group: first row is the Frame effect");
      turn(1); settle(); CHECK(line1().rfind("Frame speed:", 0) == 0, "Frame group: then the Frame speed");
      turn(1); settle(); CHECK(line1().rfind("Min", 0) == 0, "Frame group: then the brightness Min");
      key(PIN_CANCEL); turn(1); settle(); CHECK(line1().rfind("Letters", 0) == 0, "root item 4 is the Letters group");
      key(PIN_OK); settle(); CHECK(line0() == "Letters" && line1().rfind("Letters effect:", 0) == 0, "Letters group: first row is the Letters effect");
      key(PIN_CANCEL); turn(1); settle(); CHECK(line1().rfind("Arrow", 0) == 0, "root item 5 is the Arrow group");
      turn(1); settle(); key(PIN_OK); settle();
      CHECK(line0() == "Brightness" && line1().rfind("Brightness tes", 0) == 0, "Brightness starts with the Brightness test submenu");
      turn(1); settle(); CHECK(line1().rfind("Frame", 0) == 0, "Brightness: then the Frame, Letters and Arrow groups");
      key(PIN_OK); settle(); CHECK(line0() == "Frame" && line1().rfind("Min", 0) == 0, "Brightness > Frame starts with Min");
      key(PIN_CANCEL); key(PIN_CANCEL); key(PIN_CANCEL); settle();
      CHECK(menuMode == MM_STATUS, "back at the status page");
      key(PIN_OK); key(PIN_OK); key(PIN_OK); settle();                      // Controls > Arrow (read-only)
      CHECK(menuMode == MM_VIEW && line0() == "Arrow" && line1().size() >= 3 && line1()[0] == (char)1 && line1()[1] == ' ', "a read-only property opens the view page: name, padlock, value");
      turn(3); settle(); CHECK(menuMode == MM_VIEW, "turning does nothing on the view page");
      key(PIN_OK); settle(); CHECK(menuMode == MM_MENU, "OK leaves the view page");
      key(PIN_OK); settle(); key(PIN_CANCEL); settle(); CHECK(menuMode == MM_MENU, "CANCEL leaves the view page");
      key(PIN_OK); key(PIN_OK); key(PIN_OK); run(65000); CHECK(menuMode == MM_VIEW, "no timeout on the view page");
      key(PIN_CANCEL); key(PIN_CANCEL); key(PIN_CANCEL); settle(); }

    // ---- brightness test mode: Brightness > Brightness test shows a fixed pattern on every LED ----
    { const uint32_t gray[10] = {0x1a1a1a, 0x333333, 0x4d4d4d, 0x666666, 0x808080, 0x999999, 0xb3b3b3, 0xcccccc, 0xe6e6e6, 0xffffff};   // 26 51 77 102 128 153 179 204 230 255
      const int frameStep[18] = {0, 1, 1, 2, 2, 3, 3, 4, 4, 5, 6, 6, 7, 7, 8, 8, 9, 9};
      const int letterPix[10] = {0, 1, 2, 3, 4, 5, 9, 8, 7, 6};
      auto allEqual = [&](uint32_t v) {
        for (auto c : frame.shown_) if (c != v) return false;
        for (auto c : letters.shown_) if (c != v) return false;
        for (auto c : closedLight.shown_) if (c != v) return false;
        for (uint8_t k = 0; k < STICK_COUNT; k++) for (auto c : sticks[k]->shown_) if (c != v) return false;
        return true; };
      auto ramp = [&]() {
        for (int i = 0; i < 18; i++) if (frame.shown_[i] != gray[frameStep[i]]) return false;
        for (int l = 0; l < 10; l++) if (letters.shown_[letterPix[l]] != gray[l]) return false;
        for (int led = 0; led < 10; led++) {
          if (closedLight.shown_[led] != gray[led]) return false;
          for (uint8_t k = 0; k < STICK_COUNT; k++) if (sticks[k]->shown_[led] != gray[led]) return false; }
        return true; };
      const auto arrowBefore = g_pinLevel[PIN_ARROW_SWITCH];
      g_pinLevel[PIN_ARROW_SWITCH] = SW_RIGHT; run(300);
      menuSetPos(P_stripMax, 80); menuSetPos(P_lettersMax, 80); menuSetPos(P_stickMax, 80); rebuildAllCurves();
      const long eepromWrites = EEPROM.writes;
      key(PIN_OK); turn(6); key(PIN_OK); settle();                                  // Brightness
      CHECK(line0() == "Brightness" && !brightTestActive(), "the test mode is off while only the Brightness group is open");
      key(PIN_OK); settle();                                                        // Brightness test
      CHECK(line0() == "Brightness test" && line1().rfind("Pattern", 0) == 0 && brightTestActive() && menuMode == MM_MENU, "Brightness test opens on the Pattern row and the test mode is on");
      // identity curves: the pattern values come out unchanged, so the ramp is compared with hard-coded levels
      for (uint8_t ty = 0; ty < LED_TYPE_COUNT; ty++) setBrightnessCurve(ty, 0, 255, 1.0f, 0.0f, true);
      run(150);
      CHECK(ramp(), "Ramp: 10 steps 26..255 on every stick (LED 1..10) and the CLOSED stick, in reading order on the letters, two frame pixels per step");
      { bool allLit = true; for (uint8_t k = 0; k < STICK_COUNT; k++) for (auto c : sticks[k]->shown_) if (c == 0) allLit = false;
        CHECK(allLit, "all ten sticks are lit, whatever the arrow direction"); }
      CHECK(menuPos(P_testPattern) == 0, "the pattern starts at Ramp");
      key(PIN_OK); turn(1); run(150);
      CHECK(menuMode == MM_EDIT && menuPos(P_testPattern) == 1 && allEqual(0xffffff), "All white: every LED at 255 while the value is being turned");
      turn(1); run(150); CHECK(allEqual(0xff0000), "Red");
      menuSetPos(P_monochrome, 1); run(100); CHECK(allEqual(0xff0000), "the Brightness test stays coloured with Monochrome on"); menuSetPos(P_monochrome, 0);
      turn(1); run(150); CHECK(allEqual(0x00ff00), "Green");
      turn(1); run(150); CHECK(allEqual(0x0000ff), "Blue");
      turn(1); run(150); CHECK(menuPos(P_testPattern) == 5 && allEqual(0x808080), "Level: every LED white at the Level value (default 128)");
      key(PIN_CANCEL); settle();
      CHECK(menuMode == MM_MENU && menuPos(P_testPattern) == 0 && ramp() && brightTestActive(), "CANCEL restores the pattern (Ramp) and stays in the test mode");
      key(PIN_OK); turn(2); key(PIN_OK); settle();
      CHECK(menuPos(P_testPattern) == 2 && allEqual(0xff0000), "OK accepts the pattern (Red)");
      turn(1); settle(); CHECK(line1().rfind("Level", 0) == 0, "Brightness test: second row is the Level");
      key(PIN_OK); turn(1); key(PIN_OK); settle();
      CHECK(menuValue(P_testLevel) == 129.0f, "the Level can be edited (128 -> 129)");
      turn(-1); key(PIN_OK); turn(3); key(PIN_OK); settle();                        // pattern Red -> Level
      CHECK(menuPos(P_testPattern) == 5 && allEqual(0x818181), "Level pattern: every LED at 129");
      turn(1); key(PIN_OK); turn(-89); run(150);
      CHECK(menuMode == MM_EDIT && allEqual(0x282828), "turning the Level changes every LED at once (40)");
      key(PIN_CANCEL); settle(); CHECK(allEqual(0x818181), "CANCEL restores the Level");
      turn(-1); key(PIN_OK); turn(-5); key(PIN_OK); settle();
      CHECK(menuPos(P_testPattern) == 0 && ramp(), "back to Ramp");
      CHECK(EEPROM.writes == eepromWrites, "the test pattern and level are not saved in EEPROM");
      // the curve properties are inside the submenu and act on the pattern at once
      rebuildAllCurves(); run(150);
      CHECK(frame.shown_[17] == 0x505050 && letters.shown_[6] == 0x505050 && sticks[3]->shown_[9] == 0x505050, "with the saved curves the brightest step shows Max 80 on all three LED types");
      turn(2); settle(); CHECK(line1().rfind("Frame", 0) == 0, "Brightness test: then the Frame, Letters and Arrow groups");
      key(PIN_OK); settle(); CHECK(line0() == "Frame" && line1().rfind("Min", 0) == 0 && brightTestActive(), "the Frame group is inside the test mode");
      turn(1); key(PIN_OK); turn(-3); run(150);
      CHECK(menuMode == MM_EDIT && brightTestActive() && frame.shown_[17] == 0x4d4d4d && letters.shown_[6] == 0x505050, "editing the frame Max (80 -> 77) changes the frame pattern at once, the test mode stays on");
      key(PIN_CANCEL); run(150); CHECK(frame.shown_[17] == 0x505050, "CANCEL restores the frame Max");
      key(PIN_CANCEL); settle(); CHECK(line0() == "Brightness test" && brightTestActive(), "CANCEL from the Frame group stays inside the test submenu");
      key(PIN_CANCEL); run(300);
      CHECK(line0() == "Brightness" && !brightTestActive() && !ramp(), "CANCEL out of the submenu ends the test mode: the effects go on");
      { bool inactiveDark = true; for (uint8_t k = 0; k < STICK_COUNT; k++) if (!stickActive(k)) for (auto c : sticks[k]->shown_) if (c != 0) inactiveDark = false;
        CHECK(inactiveDark, "the sticks that are dark in the arrow direction are cleared again"); }
      // the menu timeout does not apply inside the test, and a switch change ends it
      const unsigned long clockBefore = letterClockMs;
      key(PIN_OK); settle(); run(65000);
      CHECK(menuMode == MM_MENU && brightTestActive() && ramp() == false && menuDepth == 3, "no timeout inside the test submenu");
      g_pinLevel[PIN_ARROW_SWITCH] = (arrowBefore == SW_RIGHT ? SW_LEFT : SW_RIGHT); run(300);
      CHECK(menuMode == MM_STATUS && !brightTestActive(), "turning the arrow switch ends the test mode and shows the status page");
      CHECK(letterClockMs - clockBefore < 3000UL, "the letter clock did not run on during the 65 s in the test (no jump when the effects come back)");
      g_pinLevel[PIN_ARROW_SWITCH] = arrowBefore; run(300);
      rebuildAllCurves(); }

    // a glitch of the menu switch shorter than the 10 ms debounce is not a step (contact bounce)
    { key(PIN_OK); settle(); const std::string g1 = line1(); const int p0 = menuPinPos;
      setMenuPins((p0 + 1) & 15); run(4); setMenuPins(p0); run(100);
      CHECK(line1() == g1, "a 4 ms glitch on the menu switch is ignored (debounce)");
      setMenuPins((p0 + 13) & 15); run(4); setMenuPins((p0 + 1) & 15); menuPinPos = (p0 + 1) & 15; run(100);
      CHECK(line1().rfind("Effects", 0) == 0, "a code that stays is one step: the 4 ms glitch before it did not count (debounce)");
      key(PIN_CANCEL); settle(); CHECK(menuMode == MM_STATUS, "back at the status page after the debounce test"); }
    // choosing random for a group never gives the pattern that is showing now
    { bool repeat = false;
      for (int e = 1; e <= 15 && !repeat; e++) for (int k = 0; k < 20; k++) {
        menuSetPos(P_frameEffect, (uint16_t)e); menuSetPos(P_lettersEffect, (uint16_t)e);
        const uint8_t f = activeFrame, l = activeLetters;
        menuSetPos(P_frameEffect, 0); if (activeFrame == f) repeat = true;
        menuSetPos(P_lettersEffect, 0); if (activeLetters == l) repeat = true; }
      CHECK(!repeat, "choosing random never picks the pattern that was showing");
      setProgram(0); run(100); }
    // with both effects fixed the shared timer does nothing (no restart, no output)
    { setProgram(5); run(100); const size_t mark = Serial.captured.size(); const unsigned long t0 = autoPickedAt; run(135000UL);
      CHECK(autoPickedAt == t0 && Serial.captured.find("Effects:", mark) == std::string::npos, "both effects fixed: the timer neither restarts nor prints");
      setProgram(0); run(100); }

    // ---- Effects menu: live preview while editing (REQ-018), OK accepts, CANCEL restores value and effect ----
    { setProgram(0); run(200);
      key(PIN_OK); turn(1); settle(); CHECK(line1().rfind("Effects", 0) == 0, "Effects is root item 1");
      key(PIN_OK); settle();
      CHECK(line0() == "Effects" && line1().rfind("Frame effect:", 0) == 0, "Effects: first row is the Frame effect");
      key(PIN_OK); turn(3); settle();
      CHECK(menuMode == MM_EDIT && menuPos(P_frameEffect) == 4 && activeFrame == 3 && activeLetters == 0, "turning the frame effect shows it at once (only the frame changes)");
      turn(-4); settle();
      CHECK(menuPos(P_frameEffect) == 0 && frameIsRandom() && activeFrame < PATTERN_MODE_COUNT, "turning to 0 makes the frame random while editing");
      key(PIN_CANCEL); settle();
      CHECK(menuMode == MM_MENU && menuPos(P_frameEffect) == 1 && activeFrame == 0 && !frameIsRandom(), "CANCEL restores the old value and the old effect");
      key(PIN_OK); turn(6); key(PIN_OK); settle();
      CHECK(menuPos(P_frameEffect) == 7 && activeFrame == 6, "OK accepts the new frame effect");
      { unsigned char saved = EEPROM.mem[4 + menuRd8(PP_SLOT, P_frameEffect)]; CHECK(saved == 7, "the accepted frame effect is saved in EEPROM"); }
      turn(1); settle(); CHECK(line1().rfind("Letters effect:", 0) == 0, "Effects: second row is the Letters effect");
      key(PIN_OK); turn(11); settle();
      CHECK(menuPos(P_lettersEffect) == 12 && activeLetters == 11 && activeFrame == 6, "turning the letters effect shows it at once (12 Slot machine)");
      CHECK(line1().find("12") != std::string::npos, "the value row shows the number first");
      key(PIN_CANCEL); settle();
      CHECK(menuPos(P_lettersEffect) == 1 && activeLetters == 0, "CANCEL restores the letters effect");
      turn(1); settle(); CHECK(line1().rfind("Random delay:", 0) == 0, "Effects: third row is the Random delay");
      key(PIN_CANCEL); key(PIN_CANCEL); settle(); CHECK(menuMode == MM_STATUS, "back at the status page");
      menuSetPos(P_frameEffect, 1); menuSave(&P_frameEffect, 1); setProgram(0); run(200); }

    // ---- reverse flags: the slide switches follow the flags at once ----
    g_pinLevel[PIN_ARROW_SWITCH] = SW_RIGHT; g_pinLevel[PIN_CASINO_CLOSED_SWITCH] = HIGH; run(200);
    CHECK(arrowPointsRight && !casinoClosed, "start: arrow right, casino open");
    menuSetPos(P_arrowReverse, 1); run(50);
    CHECK(!arrowPointsRight && menuPos(P_arrow) == 1, "Arrow reverse swaps the arrow direction without touching the switch");
    menuSetPos(P_casinoReverse, 1); run(50);
    CHECK(casinoClosed && menuPos(P_casino) == 0, "Casino reverse swaps open/closed");
    g_pinLevel[PIN_CASINO_CLOSED_SWITCH] = LOW; run(200);
    CHECK(!casinoClosed, "with Casino reverse on, the closed handle position means open");
    g_pinLevel[PIN_ARROW_SWITCH] = SW_LEFT; run(200);
    CHECK(arrowPointsRight, "with Arrow reverse on, the left handle position means right");
    menuSetPos(P_arrowReverse, 0); menuSetPos(P_casinoReverse, 0); run(50);
    CHECK(!arrowPointsRight && casinoClosed, "the flags off: the switch positions mean what they say again");
    g_pinLevel[PIN_ARROW_SWITCH] = SW_RIGHT; g_pinLevel[PIN_CASINO_CLOSED_SWITCH] = HIGH; run(200);
    CHECK(arrowPointsRight && !casinoClosed, "switches back to right / open");

    // ---- Monochrome: effects show grey (the brightest channel), the Brightness test stays coloured ----
    {
      for (uint8_t ty = 0; ty < LED_TYPE_COUNT; ty++) setBrightnessCurve(ty, 0, 255, 1.0f, 0.0f, true);   // identity curves: exact colours
      CHECK(toGrey(0) == 0 && toGrey(0x102030) == 0x303030 && toGrey(0xff0000) == 0xffffff && toGrey(0x0000ff) == 0xffffff && toGrey(0x00ff00) == 0xffffff && toGrey(0x7f1000) == 0x7f7f7f, "toGrey: all three channels get the largest channel");
      menuSetPos(P_monochrome, 0);
      CHECK(shapeShow(LED_TYPE_LETTERS, 0x200808, false) == 0x200808 && shapeShow(LED_TYPE_STICK, 0x200808, true) == 0x202020, "shapeShow: colour stays when Monochrome is off, grey only when the effect asks for it");
      menuSetPos(P_monochrome, 1);
      CHECK(shapeShow(LED_TYPE_LETTERS, 0x200808, false) == 0x202020 && shapeShow(LED_TYPE_STRIP, 0x0000ff, false) == 0xffffff, "shapeShow: grey when Monochrome is on");
      menuSetPos(P_monochrome, 0); run(400);
      bool lettersColoured = false, sticksColoured = false;
      for (auto c : letters.shown_) if (((c >> 16) & 0xFF) != ((c >> 8) & 0xFF)) lettersColoured = true;
      for (uint8_t k = 0; k < STICK_COUNT; k++) for (auto c : sticks[k]->shown_) if (((c >> 16) & 0xFF) != (c & 0xFF) || ((c >> 8) & 0xFF) != (c & 0xFF)) sticksColoured = true;
      CHECK(lettersColoured && sticksColoured, "Monochrome off: the letters are red and the arrow has colours");
      menuSetPos(P_monochrome, 1); run(400);
      bool allGrey = true, anyLit = false;
      auto grey = [&](uint32_t c) { if (c != 0) anyLit = true; if (((c >> 16) & 0xFF) != ((c >> 8) & 0xFF) || ((c >> 8) & 0xFF) != (c & 0xFF)) allGrey = false; };
      for (auto c : letters.shown_) grey(c);
      for (auto c : frame.shown_) grey(c);
      for (auto c : closedLight.shown_) grey(c);
      for (uint8_t k = 0; k < STICK_COUNT; k++) for (auto c : sticks[k]->shown_) grey(c);
      CHECK(allGrey && anyLit, "Monochrome on: every LED of every strip and stick shows a grey");
      menuSetPos(P_monochrome, 0); run(100);
      rebuildAllCurves();
    }

    // ---- brightness curves are menu properties: each LED type has its own curve ----
    rebuildAllCurves();                                  // the older tests ran with identity curves: back to the menu values
    menuSetPos(P_stripMax, 40); run(10);
    CHECK(brightnessLut[LED_TYPE_STRIP][255] == 40 && brightnessLut[LED_TYPE_LETTERS][255] == 80 && brightnessLut[LED_TYPE_STICK][255] == 80, "Strip Max changes only the frame curve");
    menuSetPos(P_lettersMax, 60); run(10);
    CHECK(brightnessLut[LED_TYPE_LETTERS][255] == 60 && brightnessLut[LED_TYPE_STRIP][255] == 40 && brightnessLut[LED_TYPE_STICK][255] == 80, "Letters Max changes only the letters curve");
    menuSetPos(P_stickMax, 100); run(10);
    CHECK(brightnessLut[LED_TYPE_STICK][255] == 100 && brightnessLut[LED_TYPE_LETTERS][255] == 60, "Stick Max changes only the stick curve");
    menuSetPos(P_stripMax, 80); menuSetPos(P_lettersMax, 80); menuSetPos(P_stickMax, 80); run(10);
    CHECK(brightnessLut[0][255] == 80 && brightnessLut[1][255] == 80 && brightnessLut[2][255] == 80, "the Max values back to 80");
    // Exponent and Mix reach the curves, too (property positions: exponent 0.1..20 log 50 steps, mix 0..1 linear 50 steps)
    menuSetPos(P_lettersMix, 0); run(10);
    CHECK(brightnessLut[LED_TYPE_LETTERS][128] == 40 && brightnessLut[LED_TYPE_STRIP][128] == 13, "Letters Mix 0 makes only the letters curve linear (128 -> 40)");
    menuSetPos(P_lettersMix, 50); run(10);
    CHECK(brightnessLut[LED_TYPE_LETTERS][128] == 13, "Letters Mix 1 again");
    menuSetPos(P_stickMin, 10); run(10);
    CHECK(brightnessLut[LED_TYPE_STICK][255] == 80 && brightnessLut[LED_TYPE_STICK][1] == 10 && brightnessLut[LED_TYPE_STICK][0] == 0 && brightnessLut[LED_TYPE_STRIP][1] == 0, "Stick Min 10 lifts only the stick curve (zero stays dark)");
    menuSetPos(P_stickMin, 0); run(10);

    // ---- Restore defaults through the menu: asks OK / CANCEL, sets every stored value to its default ----
    menuSetPos(P_speedArrow, 20); menuSetPos(P_randomDelay, 7); run(10);
    key(PIN_OK); turn(7); key(PIN_OK);                   // root item 7 = Restore defaults
    CHECK(menuMode == MM_CONFIRM, "Restore defaults asks for confirmation");
    key(PIN_CANCEL); CHECK(menuMode == MM_MENU && menuPos(P_speedArrow) == 20, "CANCEL at the question changes nothing");
    key(PIN_OK); key(PIN_OK); settle();
    CHECK(menuPos(P_speedArrow) == 18 && menuPos(P_speedFrame) == 18 && menuPos(P_randomDelay) == 2 && frameIntervalMs == 200 && arrowIntervalMs == 35,
          "OK at the question restores every default and applies it");
    key(PIN_CANCEL); key(PIN_CANCEL); settle();

    // ---- power cycle: the saved values come back from EEPROM ----
    menuSetPos(P_speedLetters, 20); menuSave(&P_speedLetters, 1);
    menuSetPos(P_speedLetters, 3);                       // a change that is not saved
    { const bool saved = menuBegin(); applySpeeds(); rebuildAllCurves();
      menuSet(P_arrow, arrowPosition()); menuSet(P_casino, casinoClosed ? 0 : 1);   // the status values are set again by finishStartup() in the real start
      CHECK(saved && menuPos(P_speedLetters) == 20 && letterMult256 == (uint16_t)(0.125 * pow(32.0, 20 / 30.0) * 256.0 + 0.5), "after a restart the saved value is used, the unsaved one is gone"); }
    menuSetPos(P_speedLetters, 18); menuSave(&P_speedLetters, 1); run(10);

    for (uint8_t ty : IDENT_TYPES) setBrightnessCurve(ty, 0, 255, 1.0f, 0.0f, true);   // the older tests below run with identity curves

    // ---- LCD hardware behaviour ----
    run(1000);
    const long before = Wire.transactions; run(2500);
    CHECK(Wire.transactions - before <= 8, "LCD: the display is only written when the text changes");
    bool small = true; long worst = 0;
    for (int k = 0; k < 20000; k++) { const long t0 = Wire.transactions; run(1); if (Wire.transactions - t0 > 1) small = false; if ((long)Wire.lastBytes > worst) worst = Wire.lastBytes; }
    CHECK(small && worst <= 24 && !Wire.oversize, "LCD: at most one short I2C transmission per loop pass");
    printf("  LCD: longest I2C transmission %ld bytes\n", worst);

    // a display that is missing or at another address is left out without disturbing the sign, and found again later
    Wire.address = 0x3F; lcdOk = false; lcdInit();
    CHECK(!lcdOk, "LCD: a display at another address is not found");
    const long t1 = Wire.transactions; run(500);
    CHECK(Wire.transactions == t1 + 1 || Wire.transactions == t1, "LCD: while no display answers only the retry probe is sent");
    Wire.address = 0x27; run(1500);
    CHECK(lcdOk, "LCD: found again by the periodic retry when the display answers");
    run(400);
    CHECK(line0() == "F01 L01 Open" && printable(), "LCD: shows the status page again after re-initialisation");
    CHECK(Wire.present, "LCD: present");
    Wire.present = false; g_pinLevel[PIN_ARROW_SWITCH] = SW_LEFT; run(300);          // the text changes: sending it fails
    CHECK(!lcdOk, "LCD: a display that stops answering is noticed when the sketch writes to it");
    g_pinLevel[PIN_ARROW_SWITCH] = SW_RIGHT;
    Wire.present = true; run(1500);
    CHECK(lcdOk, "LCD: and found again when it comes back");
    run(300);

    // boot-time I2C scan: the log lists the display and the scan hint appears only when the LCD address is silent
    {
      const std::string boot = Serial.captured;
      CHECK(boot.find("I2C scan (0x08-0x77):") != std::string::npos, "I2C scan: runs at boot and says so");
      CHECK(boot.find("  found 0x27  (LCD address in this sketch)\n") != std::string::npos, "I2C scan: boot log lists the display at 0x27");
      CHECK(boot.find("I2C scan done: 1 device(s)\n") != std::string::npos, "I2C scan: boot log counts one device");
      CHECK(boot.find("No device on the LCD address") == std::string::npos, "I2C scan: no warning when the display answers");
      CHECK(boot.find("I2C scan done") < boot.find("Serial speed 115200 baud"), "I2C scan: happens before the start-up lines");
      CHECK(boot.find("EEPROM: no saved values for this menu layout, defaults used.") != std::string::npos, "start-up: says that the EEPROM had no saved menu values");
      Serial.captured.clear();
      Wire.address = 0x3F;
      const uint8_t n3f = scanI2cBus();
      CHECK(n3f == 1 && Serial.captured.find("  found 0x3F\n") != std::string::npos, "I2C scan: finds a display at 0x3F (no LCD marker)");
      CHECK(Serial.captured.find("No device on the LCD address 0x27: check SDA D20 / SCL D21") != std::string::npos,
            "I2C scan: warns when nothing answers on the LCD address");
      Serial.captured.clear();
      Wire.present = false;
      const uint8_t n0 = scanI2cBus();
      CHECK(n0 == 0 && Serial.captured.find("I2C scan done: 0 device(s)") != std::string::npos, "I2C scan: reports no devices on an empty bus");
      Wire.present = true; Wire.address = 0x0A;
      Serial.captured.clear();
      CHECK(scanI2cBus() == 1 && Serial.captured.find("  found 0x0A\n") != std::string::npos, "I2C scan: addresses below 0x10 are printed with a leading zero");
      Wire.address = 0x27;
      Serial.captured.clear();
      CHECK(scanI2cBus() == 1 && Serial.captured.find("  found 0x08") == std::string::npos, "I2C scan: finds exactly the display (0x08 and 0x77 are the limits)");
      Serial.captured = boot;
    }
  }
  // ---- Power-on LED test ----
  {
    auto rtrimS = [](std::string r) { while (!r.empty() && r.back() == ' ') r.pop_back(); return r; };
    auto line0 = [&]() { return rtrimS(Wire.row(0)); };
    g_pinLevel[PIN_CANCEL] = HIGH; g_pinLevel[PIN_CASINO_CLOSED_SWITCH] = HIGH;
    while (letterMode != MODE_BREATHE) pressMode();
    run(300);
    const unsigned long t0 = g_millis;
    beginStartupTest(g_millis);
    CHECK(STARTUP_TEST_MS == 10000 && STARTUP_TEST_PASSES == 2, "LED test: 10 seconds, 2 passes");
    const unsigned long passMs = 5000;
    // lit[pass][strip][led]
    std::vector<std::vector<std::vector<char>>> lit(STARTUP_TEST_PASSES);
    for (auto &p : lit) { p.resize(STRIP_COUNT); for (int k = 0; k < STRIP_COUNT; k++) p[k].assign(allStrips[k]->numPixels(), 0); }
    const bool ledColour = getenv("V2_LED_COLOUR") != nullptr;   // run with Monochrome off: the LED test shows red, green and blue
    if (ledColour) menuSetPos(P_monochrome, 0);
    int maxLit = 0; bool wrongColour = false, onlyTestPattern = true;
    bool charsRow[2][256] = {};
    bool lcdExact = true; int lcdSamples = 0; std::string firstBad;
    const std::string marquee = "press CANCEL to skip   ";
    unsigned long endedAt = 0;
    for (unsigned long k = 0; k < STARTUP_TEST_MS + 200 && startupTestActive; k++) {
      if (k == 2000) g_pinLevel[PIN_CASINO_CLOSED_SWITCH] = LOW;      // changed during the test: takes effect afterwards
      run(1);
      if (!startupTestActive) { endedAt = g_millis - t0; break; }
      const unsigned long el = g_millis - t0;
      int pass = (int)(el / passMs); if (pass >= STARTUP_TEST_PASSES) pass = STARTUP_TEST_PASSES - 1;
      int total = 0;
      for (int s = 0; s < STRIP_COUNT; s++) for (uint16_t i = 0; i < allStrips[s]->numPixels(); i++) {
        const uint32_t c = allStrips[s]->shown_[i];
        if (!c) continue;
        total++; lit[pass][s][i] = 1;
        const uint32_t want = pass == 0 ? 0xFFFFFFu : (ledColour ? (i % 3 == 0 ? 0xFF0000u : i % 3 == 1 ? 0x00FF00u : 0x0000FFu)
                                                              : (i % 3 == 0 ? 0xFFFFFFu : i % 3 == 1 ? 0x808080u : 0x404040u));   // Monochrome (the default): full, half, quarter grey
        if ((c & 0xFFFFFF) != want) wrongColour = true;
      }
      if (total > maxLit) maxLit = total;
      if (total > STRIP_COUNT * 2) onlyTestPattern = false;
      for (int s2 = 0; s2 < STRIP_COUNT; s2++) { int cnt = 0; for (auto c : allStrips[s2]->shown_) if (c) cnt++; if (cnt > 2) onlyTestPattern = false; }
      for (int r = 0; r < 2; r++) for (char ch : Wire.row(r)) charsRow[r][(unsigned char)ch] = true;
      // LCD: compare with an independent calculation at moments when nothing is about to change
      if (el >= 180 && (el - 180) % 250 == 0) {
        const unsigned long idx = el / 2500;
        const int counterRow = idx % 2 == 0 ? 1 : 0, skipRow = 1 - counterRow;
        std::string skip; const unsigned long sh = (el / 250) % marquee.size();
        for (int c = 0; c < 16; c++) skip += marquee[(sh + c) % marquee.size()];
        std::string label = std::to_string(el / 1000) + "/" + std::string("10") + " s";
        const int start = (16 - (int)label.size()) / 2, filled = (int)(el * 16 / STARTUP_TEST_MS);
        std::string bar;
        for (int c = 0; c < 16; c++) bar += (c >= start && c < start + (int)label.size()) ? label[c - start] : (c < filled ? '#' : '.');
        lcdSamples++;
        if (Wire.row(skipRow) != skip || Wire.row(counterRow) != bar) { lcdExact = false; if (firstBad.empty()) firstBad = "t=" + std::to_string(el) + " got '" + Wire.row(0) + "'/'" + Wire.row(1) + "' want '" + (skipRow == 0 ? skip : bar) + "'/'" + (skipRow == 0 ? bar : skip) + "'"; }
      }
    }
    CHECK(endedAt >= STARTUP_TEST_MS - 5 && endedAt <= STARTUP_TEST_MS + 40, "LED test: lasts 10 seconds");
    CHECK(!wrongColour, "LED test: white on pass 1; pass 2 greys (Monochrome, default) or red-green-blue (Monochrome off) by LED number");
    CHECK(onlyTestPattern, "LED test: at most 2 pixels per strip are lit at the same time (nothing else is drawn)");
    bool all = true;
    for (int pass = 0; pass < STARTUP_TEST_PASSES; pass++) for (int s = 0; s < STRIP_COUNT; s++) for (char c : lit[pass][s]) if (!c) all = false;
    CHECK(all, "LED test: every LED of every strip is lit in every pass");
    CHECK(maxLit >= 20, "LED test: all strips run at the same time");
    CHECK(lcdExact && lcdSamples >= 38, "LED test: the LCD shows the scrolling text and the counter/bar, rows swapping every 2.5 s");
    if (!lcdExact) printf("  LCD mismatch: %s\n", firstBad.c_str());
    bool charsOk = true; for (char ch : marquee) for (int r = 0; r < 2; r++) if (!charsRow[r][(unsigned char)ch]) charsOk = false;
    CHECK(charsOk, "LED test: every character of the skip text appears on both rows");
    printf("  LED test: %.1f s, at most %d LEDs lit at once\n", endedAt / 1000.0, maxLit);
    CHECK(!startupTestActive && letterMode == MODE_BREATHE, "after the test the sign starts in mode 0");
    CHECK(casinoClosed, "a switch changed during the test takes effect when the test ends");
    run(400);
    CHECK(line0() == "F01 L01 Closed", "after the test the LCD shows the status page (the casino switch was set to closed during the test)");
    g_pinLevel[PIN_CASINO_CLOSED_SWITCH] = HIGH; run(100);
    CHECK(!casinoClosed, "casino open again");

    // CANCEL skips the test, the same press does nothing else, and nothing else skips it
    run(300); beginStartupTest(g_millis); run(500);
    CHECK(startupTestActive, "LED test: still running after 0.5 s");
    CHECK(Serial.captured.find("press CANCEL to skip") != std::string::npos, "LED test: the serial line says press CANCEL to skip");
    g_pinLevel[PIN_OK] = LOW; run(100); g_pinLevel[PIN_OK] = HIGH; run(100);
    g_pinLevel[PIN_SHIFT] = LOW; run(100); g_pinLevel[PIN_SHIFT] = HIGH; run(100);
    g_pinLevel[PIN_ARROW_SWITCH] = g_pinLevel[PIN_ARROW_SWITCH] == LOW ? HIGH : LOW; run(100);
    g_pinLevel[PIN_ARROW_SWITCH] = g_pinLevel[PIN_ARROW_SWITCH] == LOW ? HIGH : LOW; run(100);
    CHECK(startupTestActive && menuMode == MM_STATUS, "LED test: OK, SHIFT and the arrow switch neither skip the test nor open the menu");
    const size_t skipMark = Serial.captured.size();
    g_pinLevel[PIN_CANCEL] = LOW; run(100); g_pinLevel[PIN_CANCEL] = HIGH; run(100);
    CHECK(!startupTestActive, "LED test: CANCEL skips the test");
    CHECK(Serial.captured.find("LED test skipped", skipMark) != std::string::npos, "LED test: the serial monitor says the test was skipped");
    CHECK(letterMode == MODE_BREATHE && menuMode == MM_STATUS, "LED test: the skipping press does nothing else (no mode change, no menu)");
    CHECK(line0() == "Test skipped" && rtrimS(Wire.row(1)).empty(), "LED test: after a skip the LCD says Test skipped");
    run(1000); CHECK(line0() == "Test skipped", "LED test: the notice stays for a moment");
    run(700); CHECK(line0() == "F01 L01 Open", "LED test: then the LCD shows the status page");

    // CANCEL held down during power-up does not skip the test until it was released and pressed again
    g_pinLevel[PIN_CANCEL] = LOW; run(100);               // normal operation: CANCEL does nothing on the status page
    beginStartupTest(g_millis); run(2000);
    CHECK(startupTestActive, "LED test: CANCEL held during power-up does not skip the test");
    g_pinLevel[PIN_CANCEL] = HIGH; run(100);
    CHECK(startupTestActive, "LED test: releasing CANCEL does not skip it");
    g_pinLevel[PIN_CANCEL] = LOW; run(100);
    CHECK(!startupTestActive, "LED test: a new press skips it");
    g_pinLevel[PIN_CANCEL] = HIGH; run(100);
    // after a test that ran to the end there is no notice
    run(2000); beginStartupTest(g_millis); run(STARTUP_TEST_MS + 300);
    CHECK(!startupTestActive && line0() == "F01 L01 Open", "LED test: a test that runs to the end shows no Test skipped notice");
    while (letterMode != MODE_BREATHE) pressMode();

    // a skipped test leaves no LED test pattern behind: the strips are cleared and the sign runs normally
    run(300);
    bool shows = false; for (auto *st : g_strips) for (auto c : st->shown_) if (c) shows = true;
    CHECK(shows, "after the test the normal animations are running");
    CHECK(rtrimS(Wire.row(0)).size() > 0, "LCD has text");
  }
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
