anttiraisala/casino-open-sign/tests/mutate_menu_core.py

# Mutation test of tools/menu-editor/menu-core.js: every mutant must make tests/menu_core_test.js fail.
#   python3 tests/mutate_menu_core.py
import subprocess, os, tempfile, concurrent.futures as cf
ROOT = os.path.dirname(os.path.dirname(os.path.abspath(__file__)))
SRC = open(os.path.join(ROOT, 'tools', 'menu-editor', 'menu-core.js'), encoding='utf-8').read()
muts = [
 ("int count off by one", "Math.floor((p.max - p.min) / p.step + 1e-9) + 1", "Math.floor((p.max - p.min) / p.step + 1e-9)"),
 ("int value step", "return p.min + i * p.step;", "return p.min + i;"),
 ("float count", "return p.steps + 1;", "return p.steps;"),
 ("log ratio", "p.min * Math.pow(p.max / p.min, i / p.steps)", "p.min * Math.pow(p.max / p.min, i / (p.steps + 1))"),
 ("linear range", "p.min + i * (p.max - p.min) / p.steps", "p.min + i * (p.max - p.min) / (p.steps + 1)"),
 ("bool count", "return 2;\n  }", "return 3;\n  }"),
 ("posOf linear metric", "Math.abs(valueAt(p, i) - v);", "Math.abs(valueAt(p, i) - v) * 0;"),
 ("posOf log metric", "p.scale === 'log' ? Math.abs(Math.log(valueAt(p, i)) - Math.log(Math.max(v, 1e-300)))", "p.scale === 'log' ? Math.abs(valueAt(p, i) - v)"),
 ("posOf choice clamp", "Math.max(0, Math.min(n - 1, Math.round(v)))", "Math.round(v)"),
 ("move clamp low", "return Math.max(0, Math.min(n - 1, q));", "return Math.min(n - 1, q);"),
 ("move clamp high", "return Math.max(0, Math.min(n - 1, q));", "return Math.max(0, q);"),
 ("move wrap", "return ((q % n) + n) % n;", "return q % n;"),
 ("hex upper", "Math.round(v).toString(16).toUpperCase()", "Math.round(v).toString(16)"),
 ("unit appended", "return t + (p.unit || '');", "return t;"),
 ("valueTexts lookup", "p.valueTexts && p.valueTexts[", "false && p.valueTexts && p.valueTexts["),
 ("bool texts", "return v ? p.trueText : p.falseText;", "return v ? p.falseText : p.trueText;"),
 ("builtin int shift", "int: { min: 0, max: 100, step: 1, wrap: false, shift: 10,", "int: { min: 0, max: 100, step: 1, wrap: false, shift: 5,"),
 ("builtin choice shift", "choice: { wrap: false, shift: 1,", "choice: { wrap: false, shift: 10,"),
 ("builtin float steps", "scale: 'linear', steps: 50,", "scale: 'linear', steps: 40,"),
 ("builtin int step", "int: { min: 0, max: 100, step: 1,", "int: { min: 0, max: 100, step: 2,"),
 ("template order", "chain.unshift(cur);", "chain.push(cur);"),
 ("type loop check", "if (seen[cur.type]) {", "if (false) {"),
 ("unknown type check", "if (!cur) { errors.push('property ' + id + ': unknown type '", "if (false) { errors.push('property ' + id + ': unknown type '"),
 ("property overrides template", "chain.forEach(function (c) { FIELDS.forEach(", "chain.slice().reverse().forEach(function (c) { FIELDS.forEach("),
 ("kind check", "if (!KINDS[kind]) {", "if (false) {"),
 ("int min max check", "if (!isNum(p.min) || !isNum(p.max) || p.min > p.max) {", "if (!isNum(p.min) || !isNum(p.max)) {"),
 ("int step check", "p.step < 1 || Math.floor(p.step) !== p.step", "Math.floor(p.step) !== p.step"),
 ("float min max check", "p.min >= p.max) { e('min/max invalid'); return false; }\n      if (p.scale", "false) { e('min/max invalid'); return false; }\n      if (p.scale"),
 ("log min check", "if (p.scale === 'log' && p.min <= 0)", "if (p.scale === 'log' && p.min < 0)"),
 ("choice count check", "p.choices.length < 2", "p.choices.length < 1"),
 ("default text lookup", "var ci = p.choices.indexOf(p.default);", "var ci = 0;"),
 ("default range check", "if (d < p.min - 1e-9 || d > p.max + 1e-9) {", "if (d < p.min - 1e-9) {"),
 ("default snap warning", "if (Math.abs(g - d) > 0.25 * sp + 1e-9)", "if (false)"),
 ("default position", "p.defaultPos = posOf(p, d);", "p.defaultPos = 0;"),
 ("menu loop check", "if (stack.indexOf(it.menuRef) >= 0) {", "if (false) {"),
 ("loop check in unused menus", "walkItems(menus[id].items, 'menus.' + id, [id], inline);", "void 0;"),
 ("menu loop stack", "walkItems(mr.items, where + '/' + it.menuRef, stack.concat([it.menuRef]), collect)", "walkItems(mr.items, where + '/' + it.menuRef, stack, collect)"),
 ("unknown menuRef", "if (!mr) {", "if (false) {"),
 ("duplicate property id", "if (defs[it.property]) errors.push", "if (false) errors.push"),
 ("unknown property ref", "if (it.type === 'prop' && !defs[it.id]) errors.push", "if (false) errors.push"),
 ("empty menu", "if (!Array.isArray(items) || !items.length) {", "if (!Array.isArray(items)) {"),
 ("readonly opens edit", "this.mode = p.readOnly ? 'view' : 'edit';", "this.mode = 'edit';"),
 ("view page lock", "(this.mode === 'view' ? LOCK_CHAR : '>')", "'>'"),
 ("view key back", "} else if (this.mode === 'view') {", "} else if (false) {"),
 ("whole row scroll", "pn.length + 1 + pv.length <= COLS ? fit(pn, pv, now, since)", "true ? fit(pn, pv, now, since)"),
 ("whole row threshold", "pn.length + 1 + pv.length <= COLS ? fit(pn, pv, now, since)", "pn.length + 1 + pv.length < COLS ? fit(pn, pv, now, since)"),
 ("whole row colon", "fit(pn + ': ' + pv, '', now, since)", "fit(pn + ' ' + pv, '', now, since)"),
 ("lock char code", "var LOCK_CHAR = '\\u0001'", "var LOCK_CHAR = '\\u0002'"),
 ("preset readonly warning", "if (p.readOnly) { warnings.push(w + ': preset sets read-only", "if (false) { warnings.push(w + ': preset sets read-only"),
 ("preset readonly not dropped", "(it is skipped)'); delete it.set[id]; return; }", "(it is skipped)'); return; }"),
 ("preset unknown", "if (!p) { errors.push(w + ': preset sets unknown", "if (false) { errors.push(w + ': preset sets unknown"),
 ("preset range", "if (!isNum(v) || v < p.min - 1e-9 || v > p.max + 1e-9) errors.push", "if (!isNum(v) || v < p.min - 1e-9) errors.push"),
 ("preset limit 16", "if (n > MAX_PRESET_VALUES)", "if (n > MAX_PRESET_VALUES + 1)"),
 ("preset limit const", "var MAX_PRESET_VALUES = 16;", "var MAX_PRESET_VALUES = 15;"),
 ("preset needs set", "if (it.set === undefined && it.setAll === undefined) errors.push", "if (false) errors.push"),
 ("preset setAll value", "if (it.setAll !== undefined && it.setAll !== 'default')", "if (false)"),
 ("preset choice check", "p.choices.indexOf(v) < 0 && !(isNum(v)", "false && !(isNum(v)"),
 ("preset bool check", "if (typeof v !== 'boolean') errors.push", "if (false) errors.push"),
 ("preset snap warning", "warnings.push(w + ': value '", "void (w + ': value '"),
 ("status property check", "if (!m.props[st[k]]) errors.push", "if (false) errors.push"),
 ("format check", "if (src.format !== 1)", "if (false)"),
 ("root check", "if (!rootSrc || !Array.isArray(rootSrc.items))", "if (false)"),
 ("persist skips readonly", "return m.props[id].persist && !m.props[id].readOnly; }); }\n  function layoutTag", "return m.props[id].persist; }); }\n  function layoutTag"),
 ("tag includes count", "[id, p.kind, p.count].join(':')", "[id, p.kind].join(':')"),
 ("tag includes ids", "[id, p.kind, p.count].join(':')", "[p.kind, p.count].join(':')"),
 ("marquee pause", "MARQUEE_PAUSE_MS = 1000", "MARQUEE_PAUSE_MS = 500"),
 ("marquee step", "MARQUEE_STEP_MS = 400", "MARQUEE_STEP_MS = 300"),
 ("marquee cap", "Math.min(maxOff, Math.floor((t - MARQUEE_PAUSE_MS) / MARQUEE_STEP_MS))", "Math.floor((t - MARQUEE_PAUSE_MS) / MARQUEE_STEP_MS)"),
 ("marquee loop", "t = t % total;", "t = Math.min(t, total);"),
 ("fit avail", "var avail = COLS - right.length - (right ? 1 : 0)", "var avail = COLS - right.length"),
 ("fit width", "return (s + '                ').substr(0, COLS);", "return s;"),
 ("fit padding", "while (out.length < avail) out += ' ';", ""),
 ("timeout value", "TIMEOUT_MS = 60000", "TIMEOUT_MS = 30000"),
 ("timeout compare", "now - this.lastInput >= TIMEOUT_MS) this._toStatus", "now - this.lastInput > TIMEOUT_MS) this._toStatus"),
 ("timeout only root", "this.stack.length === 1 && now - this.lastInput", "now - this.lastInput"),
 ("timeout only menu mode", "if (this.mode === 'menu' && this.stack.length === 1 && now", "if (this.stack.length <= 1 && now"),
 ("countdown rounding", "Math.ceil((TIMEOUT_MS - (now - this.lastInput)) / 1000)", "Math.floor((TIMEOUT_MS - (now - this.lastInput)) / 1000)"),
 ("countdown at root only", "if (this.stack.length === 1) {\n      var sec", "if (true) {\n      var sec"),
 ("input restarts timeout", "if (k === l.idx) this._touch(now, false);", "if (k === l.idx) {}"),
 ("edge turn restarts scroll", "if (k === l.idx) this._touch(now, false);", "if (k === l.idx) this._touch(now, true);"),
 ("undo window zero", "var UNDO_MS = 300;", "var UNDO_MS = 0;"),
 ("undo window long", "var UNDO_MS = 300;", "var UNDO_MS = 3000;"),
 ("undo ignores item", "this.undo.idx === k && now", "now"),
 ("undo keeps no since", "l.idx = k; this.since = this.undo.since; this.undo = null;", "l.idx = k; this.undo = null;"),
 ("undo not remembered", "this.undo = { idx: l.idx, since: this.since, at: now };", "this.undo = null;"),
 ("undo kept after key", "Engine.prototype.key = function (name, now) {\n    this.undo = null;\n", "Engine.prototype.key = function (name, now) {\n"),
 ("list clamp low", "Math.max(0, Math.min(n - 1, l.idx + steps))", "Math.min(n - 1, l.idx + steps)"),
 ("list clamp high", "Math.max(0, Math.min(n - 1, l.idx + steps))", "Math.max(0, l.idx + steps)"),
 ("shift multiplier", "steps * (shift ? p.shift : 1)", "steps * (shift ? 1 : 1)"),
 ("shift ignored", "steps * (shift ? p.shift : 1)", "steps * p.shift"),
 ("root back leaves", "else this._toStatus(now); return; }", "else { this._touch(now, true); } return; }"),
 ("submenu back index", "if (this.stack.length > 1) { this.stack.pop();", "if (this.stack.length > 1) { this.stack.pop(); this._level().idx = 0;"),
 ("submenu push index", "this.stack.push({ menu: it, idx: 0 });", "this.stack.push({ menu: it, idx: 1 });"),
 ("readonly view only", "this.mode = p.readOnly ? 'view' : 'edit';", "this.mode = p.readOnly ? 'menu' : 'edit';"),
 ("edit OK saves", "if (name === 'OK') this._save([this.edit.id]); else this._setPos(this.edit.id, this.edit.start);", "this._save([this.edit.id]);"),
 ("edit CANCEL restores", "if (name === 'OK') this._save([this.edit.id]); else this._setPos(this.edit.id, this.edit.start);", "if (name === 'OK') this._save([this.edit.id]);"),
 ("edit OK restores", "if (name === 'OK') this._save([this.edit.id]); else this._setPos(this.edit.id, this.edit.start);", "this._setPos(this.edit.id, this.edit.start); if (name === 'OK') this._save([this.edit.id]);"),
 ("confirm OK applies", "if (name === 'OK') this._apply(this.confirmItem);", "this._apply(this.confirmItem);"),
 ("confirm needed", "if (it.confirm) { this.mode = 'confirm';", "if (false) { this.mode = 'confirm';"),
 ("physical cancels edit", "if (isStatus && this.mode === 'edit' && this.edit) this._setPos(this.edit.id, this.edit.start);", ""),
 ("physical cancel for every id", "if (isStatus && this.mode === 'edit' && this.edit)", "if (this.mode === 'edit' && this.edit)"),
 ("physical to status", "if (isStatus && this.mode !== 'status') this._toStatus(now);", "if (false) this._toStatus(now);"),
 ("physical ids", "isStatus = !!st && (id === st.casino || id === st.arrow)", "isStatus = !!st && (id === st.casino)"),
 ("physical casino", "id === st.casino || id === st.arrow);", "id === st.arrow);"),
 ("physical arrow", "id === st.casino || id === st.arrow);", "id === st.casino);"),
 ("set silent", "if (!silent) this._call(id);", "if (silent) this._call(id);"),
 ("callback order", "for (var i = 0; i < p.callbacks.length; i++) {", "for (var i = p.callbacks.length - 1; i >= 0; i--) {"),
 ("callback value", "v = valueAt(p, this.pos[id]);\n    for", "v = this.pos[id];\n    for"),
 ("no change no call", "if (pos === this.pos[id]) return false;", ""),
 ("preset callbacks after", "changed.forEach(function (id) { self._call(id); });", ""),
 ("preset changed only", "if (self.pos[id] !== want[id]) { self.pos[id] = want[id]; changed.push(id); }", "{ self.pos[id] = want[id]; changed.push(id); }"),
 ("preset save", "this._save(changed);", ""),
 ("preset setAll readonly", "if (!p.readOnly) want[id] = p.defaultPos;", "want[id] = p.defaultPos;"),
 ("preset default keyword", "v === 'default' ? p.defaultPos :", "false ? p.defaultPos :"),
 ("preset choice text", "p.kind === 'choice' && typeof v === 'string' ? p.choices.indexOf(v)", "false ? 0"),
 ("save non-persisted", "return m.props[id].persist && !m.props[id].readOnly; });\n    if (list.length)", "return true; });\n    if (list.length)"),
 ("save empty batch", "if (list.length) this.batches.push", "this.batches.push"),
 ("load tag check", "ok = !!img && img.tag === this.tag &&", "ok = !!img &&"),
 ("load range check", "s >= 0 && s < m.props[id].count", "s >= 0"),
 ("load count check", "img.slots.length === ids.length", "true"),
 ("load integer check", "Number.isInteger(s) &&", ""),
 ("load defaults", "this.pos[ids[i]] = ok ? img.slots[i] : m.props[ids[i]].defaultPos;", "if (ok) this.pos[ids[i]] = img.slots[i];"),
 ("eeprom slots", "slots: persistIds(this.m).map(function (id) { return self.pos[id]; })", "slots: persistIds(this.m).map(function (id) { return 0; })"),
 ("status frame letter", "r0 = 'F' + eff(", "r0 = 'G' + eff("),
 ("status letters letter", "' L' + eff(st.effectLetters", "' M' + eff(st.effectLetters"),
 ("status star", "(pos === 0 ? '*' : '')", "''"),
 ("status two digits", "('0' + n).slice(-2)", "('' + n)"),
 ("status unknown dashes", "n > 0 ? (", "n >= 0 ? ("),
 ("status random uses active", "n = pos === 0 ? active : pos", "n = pos"),
 ("status letters uses letters runtime", "eff(st.effectLetters, rt.activeLetters)", "eff(st.effectLetters, rt.activeFrame)"),
 ("status frame uses frame runtime", "eff(st.effectFrame, rt.activeFrame)", "eff(st.effectFrame, rt.activeLetters)"),
 ("status casino text", "' ' + this.text(st.casino)", "' ' + this.text(st.arrow)"),
 ("status arrow dir", "var left = this.getPos(st.arrow) === 0;", "var left = this.getPos(st.arrow) === 1;"),
 ("status ascii left", "'<-Customer right'", "'<-Customer rigth'"),
 ("status ascii right", "'->Customer left'", "'->Customer lef'"),
 ("status left arrow char", "LEFT_ARROW + ' Customer right'", "RIGHT_ARROW + ' Customer right'"),
 ("status right arrow char", "RIGHT_ARROW + ' Customer left'", "LEFT_ARROW + ' Customer left'"),
 ("status alt period", "STATUS_ALT_MS = 3000", "STATUS_ALT_MS = 2000"),
 ("status alt phase", "% 2 === 1) {\n        var s", "% 2 === 0) {\n        var s"),
 ("status alt when frame random", "this.getPos(st.effectFrame) === 0 ||", "false ||"),
 ("status alt when letters random", "|| this.getPos(st.effectLetters) === 0;", "|| false;"),
 ("status alt always", "var isRandom = this.getPos(st.effectFrame) === 0 || this.getPos(st.effectLetters) === 0;", "var isRandom = true;"),
 ("status alt needs runtime", "this.runtime.changeInSec !== null &&", ""),
 ("status countdown minutes", "Math.floor(s / 60) + ':'", "Math.floor(s / 30) + ':'"),
 ("status countdown seconds", "('0' + (s % 60)).slice(-2)", "(s % 60)"),
 ("edit row prefix", "(this.mode === 'view' ? LOCK_CHAR : '>') + ' '", "(this.mode === 'view' ? LOCK_CHAR : '>')"),
 ("confirm text", "'OK=yes CANCEL=no'", "'OK=yes'"),
 ("confirm title", "c.confirmText || (c.text || c.name) + '?'", "c.name"),
 ("submenu marker", "fit(it.text || it.name, '>', now, since)", "fit(it.text || it.name, '', now, since)"),
 ("custom text", "var pn = it.text || m.props[it.id].name", "var pn = m.props[it.id].name"),
 ("row marquee origin", "} else r0 = fit(l.menu.name, '', now, since);", "} else r0 = fit(l.menu.name, '', now, 0);"),
]
def run(m):
    name, old, new = m
    n = SRC.count(old)
    if n != 1:
        return name, 'BAD (pattern found %d times)' % n
    with tempfile.NamedTemporaryFile('w', suffix='.js', delete=False, encoding='utf-8') as f:
        f.write(SRC.replace(old, new)); path = f.name
    try:
        try:
            r = subprocess.run(['node', os.path.join(ROOT, 'tests', 'menu_core_test.js')], env=dict(os.environ, MENU_CORE=path), capture_output=True, timeout=20)
        except subprocess.TimeoutExpired:
            return name, 'killed'                      # a hang counts as detected
        return name, 'killed' if r.returncode != 0 else 'SURVIVED'
    finally:
        os.unlink(path)
with cf.ThreadPoolExecutor(8) as ex:
    res = list(ex.map(run, muts))
bad = [r for r in res if r[1] != 'killed']
for n, s in bad: print(s + ': ' + n)
print('%d mutants, %d killed, %d problems' % (len(res), len(res) - len(bad), len(bad)))
raise SystemExit(1 if bad else 0)
