anttiraisala/casino-open-sign/tests/mutate_plate_designer.py

# Mutation test of tools/plate-designer/plate-core.js: every mutant must make
# tests/plate_designer_core_test.js fail.   python3 tests/mutate_plate_designer.py
import subprocess, os, concurrent.futures as cf
ROOT = os.path.dirname(os.path.dirname(os.path.abspath(__file__)))
SRC = open(os.path.join(ROOT, 'tools', 'plate-designer', 'plate-core.js')).read()
muts = [
 ("edt swap term", "(f[q] + q * q) - (f[v[k]] + v[k] * v[k])) / (2 * q - 2 * v[k]);\n      while", "(f[q] + q * q) - (f[v[k]] + v[k] * v[k])) / (2 * q - 2 * v[k] + 1);\n      while"),
 ("sdf half pixel in", "dIn[i] - 0.5 :", "dIn[i] - 0.4 :"),
 ("sdf half pixel out", "-(dOut[i] - 0.5)", "-(dOut[i] - 0.6)"),
 ("raster top edge", "if (yc < lo || yc >= hi) continue;", "if (yc < lo || yc > hi) continue;"),
 ("raster winding", "b[1] > a[1] ? 1 : -1", "1"),
 ("raster x round", "Math.ceil(xs[k][0] - 0.5), x1 = Math.ceil(xs[k + 1][0] - 0.5)", "Math.ceil(xs[k][0]), x1 = Math.ceil(xs[k + 1][0])"),
 ("insideDist half px", "* this.ppm + this.ox - 0.5, py", "* this.ppm + this.ox, py"),
 ("insideDist offset", "return v / this.ppm + (offsetMm || 0);", "return v / this.ppm - (offsetMm || 0);"),
 ("insideDist bounds", "i >= this.w - 1 || j >= this.h - 1) return -1e3", "i >= this.w || j >= this.h) return -1e3"),
 ("inscribed offset", "r: best / this.ppm + (offsetMm || 0) };", "r: best / this.ppm };"),
 ("bestHole margin", "(r + (marginMm || 0) - (offsetMm || 0))", "(r - (offsetMm || 0))"),
 ("bestHole offset", "(r + (marginMm || 0) - (offsetMm || 0))", "(r + (marginMm || 0) + (offsetMm || 0))"),
 ("bestHole nearest", "if (dd < best) { best = dd; bi = i; }", "if (dd > best || bi < 0) { best = dd; bi = i; }"),
 ("bestHole fits flag", "r: f[bi] / this.ppm + (offsetMm || 0), fits: true", "r: f[bi] / this.ppm + (offsetMm || 0), fits: false"),
 ("thin core radius", "r = minStrokeMm / 2 * this.ppm", "r = minStrokeMm * this.ppm"),
 ("thin slack", "d[i] > r + 1) thin++", "d[i] > r + 3) thin++"),
 ("thin offset", "if (f[i] + off >= r) { core[i] = 1; any = true; }", "if (f[i] >= r) { core[i] = 1; any = true; }"),
 ("natural spacing half", "gx = x + def.spacing / 2;", "gx = x + def.spacing;"),
 ("natural cell width", "cw = adv + def.spacing;", "cw = adv;"),
 ("uniform centring", "gx = x + cw / 2 - (ink ? (ink.x0 + ink.x1) / 2 : 0);", "gx = x + cw / 2;"),
 ("baseline", "goy: def.y + def.h }", "goy: def.y }"),
 ("cell centre y", "cell.cy = cell.y + def.h / 2;", "cell.cy = cell.y;"),
 ("hole offset dy", "cy + (o.dy || 0)", "cy"),
 ("hole offset dx", "cx + (o.dx || 0)", "cx"),
 ("hole covered tolerance", "d >= r - 1e-6", "d > r + 1"),
 ("hole clearance", "clearance: d - r }", "clearance: d }"),
 ("hole centre mode", "if (mode === 'centre') return { dx: 0, dy: 0 };", ""),
 ("hole fit margin default", "marginMm === undefined ? 0.5 : marginMm", "marginMm === undefined ? 0 : marginMm"),
 ("frame floor", "Math.floor(len / unit + 1e-9)", "Math.round(len / unit)"),
 ("frame left uses top len", "l = side(fs[2].len), r = side(fs[3].len);", "l = side(fs[0].len), r = side(fs[3].len);"),
 ("frame leds", "total * 3", "total * 2"),
 ("frame exact fit", "unit + 1e-9)", "unit)"),
 ("dims right", "right: W - x", "right: W + x"),
 ("dims down", "down: H - y", "down: H + y"),
 ("snap threshold", "Math.abs(dx) <= thr &&", "Math.abs(dx) < thr &&"),
 ("snap threshold y", "Math.abs(dy) <= thr &&", "Math.abs(dy) < thr &&"),
 ("snap nearest", "Math.abs(dx) < Math.abs(bestX.d)", "Math.abs(dx) > Math.abs(bestX.d)"),
 ("snap nearest y", "Math.abs(dy) < Math.abs(bestY.d)", "Math.abs(dy) > Math.abs(bestY.d)"),
 ("nest tallest first", "return b.h - a.h; }", "return a.h - b.h; }"),
 ("nest wrap", "x + it.w > sheetW + 1e-9", "x + it.w > sheetW + 50"),
 ("nest height", "y + it.h > sheetH + 1e-9", "y + it.h > sheetH + 50"),
 ("dxf circle y", "dxfCircle(it.x, plate.h - it.y,", "dxfCircle(it.x, it.y,"),
 ("dxf radius", "it.d / 2, 'HOLES'", "it.d, 'HOLES'"),
 ("dxf slot y", "plate.h - it.y - it.h, it.w, it.h, 'SLOT'", "plate.h - it.y, it.w, it.h, 'SLOT'"),
 ("dxf poly closed", "'\\n66\\n1\\n70\\n1\\n'", "'\\n66\\n1\\n70\\n0\\n'"),
 ("dxf letters flip", "[q[0], h - q[1]]", "[q[0], q[1]]"),
 ("dxf min points", "if (p.length >= 3) t += dxfPoly", "if (p.length >= 2) t += dxfPoly"),
 ("dxf box y", "dxfRect(b.x, h - b.y - b.h,", "dxfRect(b.x, h - b.y,"),
 ("dxf version", "AC1009", "AC1015"),
 ("pdf ref evenodd", "cs += 'B*\\n0.1 w\\n';", "cs += 'B\\n0.1 w\\n';"),
 ("pdf ref not closed", "cs += 'h '; });", "cs += ''; });"),
 ("pdf ref y", "fmt(X(q[0])) + ' ' + fmt(Yp(q[1]))", "fmt(X(q[0])) + ' ' + fmt(Yp(-q[1]))"),
 ("pdf ref x", "fmt(X(q[0])) + ' ' + fmt(Yp(q[1]))", "fmt(q[0]) + ' ' + fmt(Yp(q[1]))"),
 ("pdf ref fill", "cs += fmt(it.fill) + ' g ' + fmt(it.stroke)", "cs += fmt(it.stroke) + ' g ' + fmt(it.fill)"),
 ("pdf ref moveto", "(i ? ' l ' : ' m ')", "' l '"),
 ("pdf ref after drill", "(ref || []).forEach(function (it) {", "[].forEach(function (it) {"),
 ("pdfRef default", "e2.pdfRef = x.pdfRef !== false;", "e2.pdfRef = !!x.pdfRef;"),
 ("pdf text escape", "pdfEscape(it.s) + ') Tj ET", "it.s + ') Tj ET"),
 ("dim left", "var L = edge ? x - rx : x,", "var L = edge ? x - rx : x + 1,"),
 ("dim right", "R = edge ? plate.w - x - rx : plate.w - x,", "R = edge ? plate.w - x - rx : plate.w + x,"),
 ("dim up", "U = edge ? y - ry : y,", "U = edge ? y - ry : y - 1,"),
 ("dim down", "D = edge ? plate.h - y - ry : plate.h - y;", "D = edge ? plate.h - y - ry : plate.h + y;"),
 ("dim slot edge", "R = edge ? plate.w - x - rx :", "R = edge ? plate.w - x :"),
 ("dim slot up edge", "U = edge ? y - ry : y,", "U = edge ? y : y,"),
 ("dim rounding", "Math.round(v * 10) / 10", "Math.round(v)"),
 ("dim line left", "line(0, y, x - rx, y);", "line(0, y, x, y);"),
 ("dim line down", "line(x, y + ry, x, plate.h);", "line(x, y, x, plate.h);"),
 ("dim text left x", "x: x - rx - 1 - tw(sl) / 2", "x: x - rx - 1"),
 ("dim text right x", "x: x + rx + 1 + tw(sr) / 2", "x: x + rx + 1"),
 ("dim text up y", "y: y - ry - 1.5", "y: y - ry"),
 ("dim text down y", "y: y + ry + 3.5", "y: y + ry"),
 ("dim text height", "y: y - 1.2, s: sl", "y: y, s: sl"),
 ("dim circle edge", "one(it.x, it.y, it.d / 2, it.d / 2, false)", "one(it.x, it.y, it.d / 2, it.d / 2, true)"),
 ("dim pdf dash", "(it.dash ? '[' + fmt(it.dash) + ' ' + fmt(it.dash) + '] 0 d ' : '')", "''"),
 ("dim pdf line y", "fmt(Yp(it.y1)) + ' m '", "fmt(it.y1) + ' m '"),
 ("dim pdf colour", "(it.rgb ? it.rgb.join(' ') + ' rg ' : '0.25 g ')", "'0.25 g '"),
 ("dim default", "e2.pdfDims = x.pdfDims !== false;", "e2.pdfDims = !!x.pdfDims;"),
 ("hs corner", "Math.sqrt(dx * dx + dy * dy) / Math.sqrt(w0 * w0 / 4 + h0 * h0 / 4)", "Math.sqrt(dx * dx + dy * dy) / Math.sqrt(w0 * w0 + h0 * h0)"),
 ("hs side x", "return Math.abs(dx) / (w0 / 2);", "return Math.abs(dx) / w0;"),
 ("hs side y", "return Math.abs(dy) / (h0 / 2);", "return Math.abs(dy) / h0;"),
 ("hs abs", "return Math.abs(dy) / (h0 / 2);", "return dy / (h0 / 2);"),
 ("hs snap x", "ns = 2 * hx * (xs[i] - cx) / w0;", "ns = 2 * (xs[i] - cx) / w0;"),
 ("hs snap y", "ns = 2 * hy * (ys[i] - cy) / h0;", "ns = 2 * (ys[i] - cy) / h0;"),
 ("hs snap pos", "if (ns > 0 && Math.abs(d) <= thr && (best === null || Math.abs(d) < Math.abs(best.d))) best = { d: d, s: ns, v: xs[i]", "if (Math.abs(d) <= thr && (best === null || Math.abs(d) < Math.abs(best.d))) best = { d: d, s: ns, v: xs[i]"),
 ("hs snap thr", "if (ns > 0 && Math.abs(d) <= thr && (best === null || Math.abs(d) < Math.abs(best.d))) best = { d: d, s: ns, v: xs[i]", "if (ns > 0 && Math.abs(d) < thr && (best === null || Math.abs(d) < Math.abs(best.d))) best = { d: d, s: ns, v: xs[i]"),
 ("hs snap nearest", "(best === null || Math.abs(d) < Math.abs(best.d))) best = { d: d, s: ns, v: null", "(best === null || Math.abs(d) > Math.abs(best.d))) best = { d: d, s: ns, v: null"),
 ("hs snap nearest x", "(best === null || Math.abs(d) < Math.abs(best.d))) best = { d: d, s: ns, v: xs[i]", "(best === null || Math.abs(d) > Math.abs(best.d))) best = { d: d, s: ns, v: xs[i]"),
 ("hs X pos", "X = cx + hx * w0 * s / 2", "X = cx + w0 * s / 2"),
 ("hs Y pos", "Y = cy + hy * h0 * s / 2", "Y = cy + h0 * s / 2"),
 ("hs limits lo", "var lo = Math.max(5 / t.h, 5 / t.cellW)", "var lo = 5 / t.h"),
 ("hs limits hi", "hi = Math.min(600 / t.h, 600 / t.cellW);", "hi = 600 / t.h;"),
 ("hs limits sp", "hi = Math.min(hi, 100 / t.spacing)", "hi = Math.min(hi, 50 / t.spacing)"),
 ("hs limits neg", "hi = Math.min(hi, 50 / -t.spacing)", "hi = Math.min(hi, 100 / -t.spacing)"),
 ("hs scaled offsets", "dx: r(o.dx * s), dy: r(o.dy * s)", "dx: r(o.dx), dy: r(o.dy * s)"),
 ("hs scaled spacing", "spacing: r(t.spacing * s),", "spacing: r(t.spacing),"),
 ("hs scaled round", "return Math.round(v * 1000) / 1000;", "return Math.round(v * 100) / 100;"),
 ("fr inside top len", "lenH = tb ? W : W - 2 * sw; lenV = tb ? H - 2 * sw : H;", "lenH = tb ? W : W - sw; lenV = tb ? H - 2 * sw : H;"),
 ("fr inside side len", "lenV = tb ? H - 2 * sw : H;", "lenV = tb ? H - sw : H;"),
 ("fr inside x0", "x0 = tb ? 0 : sw; y0 = tb ? sw : 0;", "x0 = 0; y0 = tb ? sw : 0;"),
 ("fr inside y0", "x0 = tb ? 0 : sw; y0 = tb ? sw : 0;", "x0 = tb ? 0 : sw; y0 = 0;"),
 ("fr inside bottom", "y: inside ? H - sw : H, len: lenH", "y: H, len: lenH"),
 ("fr inside right", "x: inside ? W - sw : W, y: y0", "x: W, y: y0"),
 ("fr inside top y", "{ x: x0, y: o, len: lenH, horiz: true }", "{ x: x0, y: -sw, len: lenH, horiz: true }"),
 ("fr clamp", "lenH = Math.max(0, lenH); lenV = Math.max(0, lenV);", ""),
 ("fr outside layout", "var tb = layout !== 'sides'", "var tb = layout === 'sides'"),
 ("fr default inside", "s.frame.inside = !!o.frame.inside;", "s.frame.inside = o.frame.inside !== false;"),
 ("cut default", "e2.plateCut = !!x.plateCut;", "e2.plateCut = x.plateCut !== false;"),
 ("cut layer", "'PLATE_CUT'); });", "'LETTERS'); });"),
 ("cut flip", "(plateCuts || []).forEach(function (p) { t += dxfPoly(p.map(function (q) { return [q[0], h - q[1]]; })", "(plateCuts || []).forEach(function (p) { t += dxfPoly(p.map(function (q) { return [q[0], q[1]]; })"),
 ("xh group", "if (e.i === i) cell.extras.push", "if (e.i !== i) cell.extras.push"),
 ("xh index", "y: cell.cy + (e.dy || 0), k: k }", "y: cell.cy + (e.dy || 0), k: 0 }"),
 ("xh dy", "y: cell.cy + (e.dy || 0), k: k", "y: cell.cy - (e.dy || 0), k: k"),
 ("xh status arg", "var h = hole || cell.hole;", "var h = cell.hole;"),
 ("xh suggest margin", "< r + 0.5) continue;", "< r - 0.5) continue;"),
 ("xh suggest far", "if (min > bestD + 1e-9)", "if (min < bestD + 1e-9)"),
 ("xh suggest round", "dx: Math.round((best.x - cell.cx) * 100) / 100, dy: Math.round((best.y - cell.cy) * 100) / 100, covered: true", "dx: Math.round((best.x - cell.cx) * 100) / 100, dy: Math.round((best.y - cell.cy) * 100) / 100, covered: false"),
 ("xh suggest empty", "if (!best) return { dx: 0, dy: 0, covered: false };", "if (!best) return { dx: 1, dy: 0, covered: false };"),
 ("xh suggest noglyph", "if (!cell.glyph) return { dx: 0, dy: 0, covered: false };", "if (!cell.glyph) return { dx: 0, dy: 0, covered: true };"),
 ("xh drill", "(c.extras || []).forEach(function (e) { items.push({ kind: 'circle', x: e.x, y: e.y, d: d, tag: key }); });", ""),
 ("xh drill y", "items.push({ kind: 'circle', x: e.x, y: e.y,", "items.push({ kind: 'circle', x: e.x, y: e.x,"),
 ("xh scale dx", "extraHoles: (t.extraHoles || []).map(function (o) { return { i: o.i, dx: r(o.dx * s)", "extraHoles: (t.extraHoles || []).map(function (o) { return { i: o.i, dx: r(o.dx)"),
 ("xh scale i", "return { i: o.i, dx: r(o.dx * s), dy: r(o.dy * s) }", "return { i: o.i + 1, dx: r(o.dx * s), dy: r(o.dy * s) }"),
 ("xh json max", "t.extraHoles.slice(0, 40)", "t.extraHoles.slice(0, 41)"),
 ("xh json i", "Math.min(19, Math.round(h.i))", "Math.min(25, Math.round(h.i))"),
 ("xh json filter", "filter(function (h) { return h && isFinite(h.i); })", "filter(function (h) { return h; })"),
 ("xh json clamp", "dx: num(h.dx, -300, 300, 0), dy: num(h.dy, -300, 300, 0) }; }) : [];\n      if (k", "dx: num(h.dx, -300, 3000, 0), dy: num(h.dy, -300, 300, 0) }; }) : [];\n      if (k"),
 ("rs half", "var dx = (nw - state.plate.w) / 2, dy", "var dx = (nw - state.plate.w), dy"),
 ("rs dy half", "dy = (nh - state.plate.h) / 2;", "dy = (nh - state.plate.h);"),
 ("rs min", "Math.max(1, Math.min(1000, w))", "Math.max(2, Math.min(1000, w))"),
 ("rs maxw", "Math.max(1, Math.min(1000, w))", "Math.max(1, Math.min(980, w))"),
 ("rs maxh", "Math.min(1000, h)", "Math.min(300, h)"),
 ("rs minh", "Math.max(1, Math.min(1000, h))", "Math.max(5, Math.min(1000, h))"),
 ("plate w json min", "num(o.plate.w, 1, 1000", "num(o.plate.w, 2, 1000"),
 ("plate w json max", "num(o.plate.w, 1, 1000", "num(o.plate.w, 1, 980"),
 ("plate h json min", "num(o.plate.h, 1, 1000", "num(o.plate.h, 2, 1000"),
 ("plate h json max", "num(o.plate.h, 1, 1000", "num(o.plate.h, 1, 300"),
 ("default plate w", "plate: { w: 600, h: 300 }", "plate: { w: 620, h: 300 }"),
 ("default frame width", "frameWidth: 30,", "frameWidth: 31,"),
 ("default arrow x", "arrow: { x: 125, y: 198 }", "arrow: { x: 124, y: 198 }"),
 ("default open y", "x: 120, y: 112, h: 100", "x: 120, y: 113, h: 100"),
 ("fb long w", "long: plate.w + 2 * fw, short: plate.w },\n      { name: 'Bottom'", "long: plate.w + fw, short: plate.w },\n      { name: 'Bottom'"),
 ("fb long h", "long: plate.h + 2 * fw, short: plate.h },\n      { name: 'Right'", "long: plate.h + fw, short: plate.h },\n      { name: 'Right'"),
 ("fb outer", "2 * (plate.w + plate.h) + 8 * fw;", "2 * (plate.w + plate.h) + 4 * fw;"),
 ("fb short", "{ name: 'Left', long: plate.h + 2 * fw, short: plate.h }", "{ name: 'Left', long: plate.h + 2 * fw, short: plate.h + 1 }"),
 ("fb zero", "if (!(fw > 0)) return", "if (!(fw >= 0)) return"),
 ("fb json max", "num(o.frameWidth, 0, 100, d.frameWidth)", "num(o.frameWidth, 0, 120, d.frameWidth)"),
 ("fb json min", "num(o.frameWidth, 0, 100, d.frameWidth)", "num(o.frameWidth, 1, 100, d.frameWidth)"),
 ("fb min thick", "thick = Math.max(fw * sc, 2)", "thick = Math.max(fw * sc, 1)"),
 ("fb null items", "rows = items ? Math.max(1, Math.ceil(plate.h / th - 1e-9)) : 0;", "rows = Math.max(1, Math.ceil(plate.h / th - 1e-9));"),
 ("fb extra page", "(extras || []).forEach(function (e) { pages.push(e); });", "(extras || []).slice(1).forEach(function (e) { pages.push(e); });"),
 ("fb tilePages", "var tilePages = rows * cols;", "var tilePages = pages.length;"),
 ("fb mediabox", "fmt(pg.w * K) + ' ' + fmt(pg.h * K)", "fmt(pw * K) + ' ' + fmt(ph * K)"),
 ("rs arrow", "state.arrow.x = r2(state.arrow.x + dx);", "state.arrow.x = r2(state.arrow.x);"),
 ("rs arrow y", "state.arrow.y = r2(state.arrow.y + dy);", "state.arrow.y = r2(state.arrow.y);"),
 ("rs strips", "q.x = r2(q.x + dx); q.y = r2(q.y + dy);", "q.x = r2(q.x + dx);"),
 ("rs text y", "t.y = r2(t.y + dy);", "t.y = r2(t.y);"),
 ("rs text x", "t.x = r2(t.x + dx); t.y", "t.x = r2(t.x); t.y"),
 ("rs round", "return Math.round(v * 100) / 100; }\n    var nw", "return v; }\n    var nw"),
 ("sd visible", "if (top >= 0 && bottom <= viewH) return 0;", "if (top > 0 && bottom <= viewH) return 0;"),
 ("sd visible2", "if (top >= 0 && bottom <= viewH) return 0;", "if (top >= 0 && bottom < viewH) return 0;"),
 ("sd margin", "var m = viewH / 5;", "var m = viewH / 4;"),
 ("sd fits2", "if (bottom - top + 2 * m > viewH) return top - m;", "if (bottom - top + m > viewH) return top - m;"),
 ("sd above val", "if (top < 0) return top - m;\n    return", "if (top < 0) return top;\n    return"),
 ("sd below", "return bottom - (viewH - m);", "return bottom - viewH;"),
 ("sd tall", "viewH) return top - m;\n    if (top < 0)", "viewH) return top;\n    if (top < 0)"),
 ("gr union x", "x0 = Math.min(x0, b.x); y0", "x0 = Math.max(x0, b.x); y0"),
 ("gr union y1", "y1 = Math.max(y1, b.y + b.h); });", "y1 = Math.max(y1, b.y); });"),
 ("gr union x1", "x1 = Math.max(x1, b.x + b.w);", "x1 = Math.max(x1, b.x);"),
 ("gr union y0", "y0 = Math.min(y0, b.y); x1", "y0 = Math.max(y0, b.y); x1"),
 ("gr touch1", "a.x <= b.x + b.w && b.x <= a.x + a.w", "a.x < b.x + b.w && b.x <= a.x + a.w"),
 ("gr touch2", "&& b.x <= a.x + a.w && a.y", "&& b.x < a.x + a.w && a.y"),
 ("gr touch3", "a.y <= b.y + b.h && b.y <= a.y + a.h; }", "a.y < b.y + b.h && b.y <= a.y + a.h; }"),
 ("gr touch4", "&& b.y <= a.y + a.h; }", "&& b.y < a.y + a.h; }"),
 ("gr band add", "mode === 'add' ? c || h", "mode === 'add' ? c && h"),
 ("gr band rem", "mode === 'remove' ? c && !h", "mode === 'remove' ? c && h"),
 ("gr band rep", ": h;\n    });", ": c;\n    });"),
 ("gr lim lo", "lo = Math.max(lo, l.min);", "lo = Math.min(lo, l.min);"),
 ("gr lim hi", "hi = Math.min(hi, l.max);", "hi = Math.max(hi, l.max);"),
 ("gr centre", "return { x: g.x + s * (c.x - g.x), y: g.y + s * (c.y - g.y) }", "return { x: g.x + s * (c.x - g.x), y: g.y + (c.y - g.y) }"),
 ("gr centre x", "return { x: g.x + s * (c.x - g.x),", "return { x: c.x + s * (c.x - g.x),"),
 ("gr same default", "s.sameHeight = o.sameHeight !== false;", "s.sameHeight = !!o.sameHeight;"),
 ("gr same state", "sameHeight: true,", "sameHeight: false,"),
 ("cut y flip", "Y = (areaH - (y + oy)) * K", "Y = (y + oy) * K"),
 ("cut x offset", "X = (x + ox) * K", "X = x * K"),
 ("cut y offset", "(areaH - (y + oy))", "(areaH - y)"),
 ("cut k", "var out = [], warnings = [], K = MM_TO_PT", "var out = [], warnings = [], K = 2.83"),
 ("cut range", "Math.abs(X) > 10000 || Math.abs(Y) > 10000", "Math.abs(X) > 10001 || Math.abs(Y) > 10000"),
 ("cut range y", "Math.abs(X) > 10000 || Math.abs(Y) > 10000", "Math.abs(X) > 10000 || Math.abs(Y) > 20000"),
 ("cut distinct", "if (k < 2) {", "if (k < 1) {"),
 ("cut empty", "if (!n) warnings.push", "if (n > 5) warnings.push"),
 ("cut num round", "Math.round(v * 1000) / 1000", "Math.round(v * 100) / 100"),
 ("cut num trail", ".replace(/0+$/, '')", ""),
 ("cut close", "if (closed && pts.length &&", "if (!closed && pts.length &&"),
 ("cut circle k", "var k = 0.5522847498 * r;", "var k = 0.5 * r;"),
 ("cut circle curves", "['c', cx + k, cy - r, cx + r, cy - k, cx + r, cy]]", "['l', cx + r, cy]]"),
 ("cut head bbox", "'%%BoundingBox: -10000 -10000 10000 10000', '%%EndComments'", "'%%BoundingBox: 0 0 10000 10000', '%%EndComments'"),
 ("cut tail moveto", "'0 0 m', 'S Q'", "'S Q'"),
 ("cut width", "'1.41732 w'", "'1 w'"),
 ("cut drill centre x", "ox = (aw - plate.w) / 2", "ox = (aw - plate.w)"),
 ("cut drill centre y", "oy = (ah - plate.h) / 2", "oy = 0"),
 ("cut drill area", "aw = Math.max(plate.w, sheet ? sheet.w : 0)", "aw = sheet ? sheet.w : plate.w"),
 ("cut drill warn", "sheet.w < plate.w || sheet.h < plate.h", "sheet.w < plate.w"),
 ("cut drill circle r", "circlePath(it.x, it.y, it.d / 2)", "circlePath(it.x, it.y, it.d)"),
 ("cut rect", "paths.push(rectPath(it.x, it.y, it.w, it.h));", "paths.push(rectPath(it.x, it.y, it.h, it.w));"),
 ("strip norm mod", "a = ((a % 360) + 360) % 360;", "a = a % 360;"),
 ("strip norm round", "a = Math.round(a * 100) / 100; return", "a = Math.round(a * 10) / 10; return"),
 ("strip norm 360", "return a >= 360 ? 0 : a; }", "return a; }"),
 ("strip centre", "return { x: s.x + STRIP_L / 2, y: s.y + STRIP_W / 2 };", "return { x: s.x, y: s.y };"),
 ("strip rot dir", "return { x: c.x + u * co - v * si, y: c.y + u * si + v * co };", "return { x: c.x + u * co + v * si, y: c.y - u * si + v * co };"),
 ("strip rot rad", "var c = stripCentre(s), a = (s.rot || 0) * Math.PI / 180, co", "var c = stripCentre(s), a = (s.rot || 0) * Math.PI / 90, co"),
 ("strip contains dir", "a = -(s.rot || 0) * Math.PI / 180, dx = px - c.x", "a = (s.rot || 0) * Math.PI / 180, dx = px - c.x"),
 ("strip contains w", "Math.abs(v) <= STRIP_W / 2 + 1e-9", "Math.abs(v) <= STRIP_W + 1e-9"),
 ("strip contains l", "Math.abs(u) <= STRIP_L / 2 + 1e-9", "Math.abs(u) <= STRIP_L / 2 + 5"),
 ("strip samples step", "v = -STRIP_W / 2 + step / 2; v < STRIP_W / 2; v += step", "v = -STRIP_W / 2 + step / 2; v < STRIP_W / 2 - 1; v += step"),
 ("strip handle", "stripToWorld(s, STRIP_L / 2 + 12, 0)", "stripToWorld(s, STRIP_L / 2 + 10, 0)"),
 ("strip angle snap", "a = Math.round(a / snap) * snap;", "a = Math.floor(a / snap) * snap;"),
 ("strip angle atan", "Math.atan2(py - c.y, px - c.x) * 180 / Math.PI", "Math.atan2(px - c.x, py - c.y) * 180 / Math.PI"),
 ("strip rect bbox", "x1 = Math.max(x1, q[0]); y0", "x1 = Math.min(x1, q[0]); y0"),
 ("strip json v", "o.stripsV === 2 ? normRot(t.rot)", "o.stripsV === 3 ? normRot(t.rot)"),
 ("strip json legacy x", "x -= 45; y += 45;", "x -= 50; y += 45;"),
 ("strip json legacy y", "x -= 45; y += 45;", "x -= 45; y += 50;"),
 ("strip json legacy cond", "if (o.stripsV !== 2 && rot === 90)", "if (rot === 90)"),
 ("strip json set", "s.stripsV = 2;", "s.stripsV = 1;"),
 ("strip default v", "stripsV: 2,\n", "stripsV: 1,\n"),
 ("mir circle", "if (it.kind === 'circle') o.x = plateW - it.x;", "if (it.kind === 'circle') o.x = it.x;"),
 ("mir rect", "o.x = plateW - it.x - it.w;", "o.x = plateW - it.x;"),
 ("mir poly", "o.pts = it.pts.map(function (q) { return [plateW - q[0], q[1]]; });", "o.pts = it.pts.map(function (q) { return [q[0], plateW - q[1]]; });"),
 ("mir copy", "var o = {}, k; for (k in it) o[k] = it[k];", "var o = it, k;"),
 ("mir json", "e2.mirrorDrill = !!x.mirrorDrill;", "e2.mirrorDrill = x.mirrorDrill === true;"),
 ("mir default", "mirror: false, mirrorDrill: false,", "mirror: false, mirrorDrill: true,"),
 ("arrow items", "(scene.arrow.sticks || []).forEach(function (st) {", "(scene.arrow.sticks || []).slice(1).forEach(function (st) {"),
 ("arrow items tag", "scene.closedSlot.h), tag: 'arrow', name: st.name", "scene.closedSlot.h), tag: 'x', name: st.name"),
 ("poly eps", "else if (it.kind === 'poly') paths.push(polyPath(it.pts, true));", "else if (it.kind === 'poly') paths.push(polyPath(it.pts, false));"),
 ("poly dxf y", "dxfPoly(it.pts.map(function (q) { return [q[0], plate.h - q[1]]; }), 'ARROW')", "dxfPoly(it.pts.map(function (q) { return [q[0], q[1]]; }), 'ARROW')"),
 ("poly dxf layer", "'ARROW');\n    });", "'SLOT');\n    });"),
 ("poly pdf close", "cs += 'h S\\n';", "cs += 'S\\n';"),
 ("poly dims centre", "one((x0 + x1) / 2, (y0 + y1) / 2, (x1 - x0) / 2, (y1 - y0) / 2, true);", "one((x0 + x1) / 2, (y0 + y1) / 2, (x1 - x0) / 2, (y1 - y0) / 2, false);"),
 ("win centre", "cx += pts[i][0] / n; cy += pts[i][1] / n;", "cx += pts[i][0] / n; cy += pts[i][1] / (n + 1);"),
 ("win long edge", "Math.hypot(e1[0], e1[1]) >= Math.hypot(e2[0], e2[1]) ? e1 : e2", "Math.hypot(e1[0], e1[1]) <= Math.hypot(e2[0], e2[1]) ? e1 : e2"),
 ("win perp", "vx = -uy, vy = ux;", "vx = uy, vy = ux;"),
 ("win w", "var a = q[0] * w / 2, b = q[1] * h / 2;", "var a = q[0] * w / 2, b = q[1] * h;"),
 ("win h", "var a = q[0] * w / 2, b = q[1] * h / 2;", "var a = q[0] * w, b = q[1] * h / 2;"),
 ("win round", "return Math.round(v * 1000) / 1000; }\n    return [[-1, -1]", "return Math.round(v * 100) / 100; }\n    return [[-1, -1]"),
 ("win slot w", "stickWindow(st.pts, scene.closedSlot.w, scene.closedSlot.h)", "stickWindow(st.pts, scene.closedSlot.h, scene.closedSlot.w)"),
 ("json clamp", "Math.min(hi, Math.max(lo, v))", "v"),
 ("json strips rot", "t.rot === 90 ? 90 : 0", "t.rot"),
 ("json dims", "o.ui.dims : 'selected'", "o.ui.dims : 'all'"),
]
def run(i):
    name, old, new = muts[i]
    if SRC.count(old) < 1: return name, 'BAD MUTANT (snippet missing)'
    d = '/tmp/mut_plate/%d' % i; os.makedirs(d, exist_ok=True)
    open(d + '/plate-core.js', 'w').write(SRC.replace(old, new, 1))
    env = dict(os.environ, PLATE_CORE=d + '/plate-core.js')
    r = subprocess.run(['node', ROOT + '/tests/plate_designer_core_test.js'], capture_output=True, text=True, env=env, timeout=120)
    return name, ('DETECTED' if r.returncode != 0 or 'all checks passed' not in r.stdout else 'SURVIVED')
with cf.ThreadPoolExecutor(6) as ex:
    res = list(ex.map(run, range(len(muts))))
for n, r in res: print(r + ' ' + n)
print('RESULT: %d mutants, %d survived/bad' % (len(res), sum(1 for n, r in res if r != 'DETECTED')))
