anttiraisala/casino-open-sign/tests/plate_designer_ui_test.py

# Browser test of tools/plate-designer/index.html (Playwright, local system fonts; Google Fonts are not reachable here).
#   python3 tests/plate_designer_ui_test.py [screenshot.png]
import os, sys, json
from playwright.sync_api import sync_playwright
ROOT = os.path.dirname(os.path.dirname(os.path.abspath(__file__)))
URL = 'file://' + ROOT + '/tools/plate-designer/index.html'
fails = []
LEGACY_JS = "(function(){var s=PlateApp.state();s.plate.w=960;s.plate.h=300;s.texts.casino.x=20;s.texts.casino.y=20;s.texts.open.x=580;s.texts.open.y=20;s.texts.closed.x=540;s.texts.closed.y=190;s.arrow.x=20;s.arrow.y=150;PlateApp.commit();})()"
def ncirc(t): return len([l for l in t.split('\n') if l.endswith(' c')]) // 4
def nmove(t): return len([l for l in t.split('\n') if l.endswith(' m') and not l.startswith('0 0')])
def check(c, m):
    if not c: print('FAIL: ' + m); fails.append(m)
def near(a, b, t, m): check(abs(a - b) <= t, '%s (got %s, want %s +-%s)' % (m, a, b, t))
with sync_playwright() as p:
    b = p.chromium.launch(); pg = b.new_context(viewport={'width': 1500, 'height': 850}, color_scheme='dark', permissions=['clipboard-read', 'clipboard-write']).new_page()
    errs = []; pg.on('pageerror', lambda e: errs.append(str(e))); pg.on('console', lambda m: errs.append(m.text) if m.type == 'error' and 'fonts.googleapis' not in m.text and 'ERR_' not in m.text else None)
    pg.goto(URL); pg.wait_for_timeout(500)
    d0 = pg.evaluate('PlateApp.state()'); check(d0['plate']['w'] == 600 and d0['plate']['h'] == 300 and d0['frameWidth'] == 30, 'defaults: plate 600 x 300, frame width 30')
    pg.evaluate(LEGACY_JS); pg.wait_for_timeout(50)
    S = lambda: pg.evaluate('PlateApp.state()')
    pg.evaluate("PlateApp.useFont('casino','DejaVu Sans')"); pg.wait_for_function("PlateApp.fontStatus('DejaVu Sans') && PlateApp.fontStatus('DejaVu Sans') !== 'loading'", timeout=15000)
    check(pg.input_value('#t-casino-font') == 'DejaVu Sans', 'font combobox shows the custom font')
    check(pg.evaluate("PlateApp.fontStatus('DejaVu Sans')") == 'ok', 'local font is detected as available')
    st = S(); check(st['texts']['casino']['font'] == 'DejaVu Sans', 'font set')
    sc = pg.evaluate('PlateApp.scene()')
    check(len(sc['casino']['cells']) == 6 and len(sc['open']['cells']) == 4 and len(sc['closed']['cells']) == 6, 'cell counts 6/4/6')
    check(all(c.get('hole') for c in sc['casino']['cells']) and not any(c.get('hole') for c in sc['closed']['cells']), 'holes in CASINO/OPEN cells only')
    near(sc['casino']['h'], 100, 1e-6, 'CASINO box height = 100'); near(sc['closed']['h'], 50, 1e-6, 'CLOSED half height')
    near(sc['casino']['w'], 540, 1e-6, 'CASINO width 6 x 90')
    check(len(sc['arrow']['holes']) == 10, '10 arrow holes')
    # drill EPS
    eps = pg.evaluate('PlateApp.drillEps()')
    check(ncirc(eps) == 6 + 4 + 1 and nmove(eps) == 1 + 11 + 10, 'EPS: 6+4 letter circles, 1 CLOSED round, 10 stick outlines (no arrow circles), got %d circles, %d paths' % (ncirc(eps), nmove(eps)))
    check(eps.startswith('%!PS-Adobe-3.0 EPSF-3.0\n%%LanguageLevel: 2\n%%BoundingBox: -10000 -10000 10000 10000\n') and eps.endswith('0 0 m\nS Q\nQ Q\nshowpage\n%%Trailer\nend\n%%EOF\n') and 'arc' not in eps.split('%%EndPageSetup')[1].replace('Cut lines', '').split('\n4 M q\n')[1], 'EPS is in the CutStudio format')
    pdf = pg.evaluate("PlateApp.drillPdf('A4')"); check(pdf['pages'] == 9 and pdf['tilePages'] == 8 and pdf['cols'] == 4 and pdf['rows'] == 2 and pdf['text'].startswith('%PDF-1.4'), 'A4 tiling of 960 x 300: 4 x 2 pages, got %s' % ((pdf['cols'], pdf['rows']),))
    ptxt = pdf['text']; check(' B*' in ptxt and '(C1) Tj' in ptxt and '(O6) Tj' in ptxt and '(L-CAP D2) Tj' in ptxt and '(R-WING-DN A2) Tj' in ptxt and '(CLOSED) Tj' in ptxt, 'drill PDF has the letter and arrow shapes with labels (C1..N6, stick names, CLOSED)')
    check(ptxt.count(' B*') >= 6 + 4 + 6 + 10, 'one filled shape per letter and per arrow stick, got %d' % ptxt.count(' B*'))
    nl = ptxt.count('0 0.45 0.15 RG'); check(nl == 21 * 4 * pdf['tilePages'], 'four dimension lines for each of the 21 holes on each of the %d tiles, got %d' % (pdf['pages'], nl))
    sc2 = pg.evaluate('PlateApp.scene()'); c0 = sc2['casino']['cells'][0]['hole']; W = 960
    check('(%s) Tj' % ('%g' % round(c0['x'], 1)) in ptxt and '(%s) Tj' % ('%g' % round(W - c0['x'], 1)) in ptxt and '(%s) Tj' % ('%g' % round(c0['y'], 1)) in ptxt, 'the first hole distances (left %.1f, right %.1f, up %.1f) are written in the PDF' % (c0['x'], W - c0['x'], c0['y']))
    pg.uncheck('#exPdfDims'); p3 = pg.evaluate("PlateApp.drillPdf('A4')")['text']; check('0 0.45 0.15 RG' not in p3 and ' B*' in p3, 'the dimension option turns the numbers off and keeps the reference drawing'); pg.check('#exPdfDims')
    check('Tj' not in pg.evaluate('PlateApp.drillEps()') and 'Tj' not in pg.evaluate('PlateApp.drillDxf()'), 'EPS and DXF have no dimension text')
    pg.uncheck('#exPdfRef'); p2 = pg.evaluate("PlateApp.drillPdf('A4')")['text']; check(' B*' not in p2 and '(C1) Tj' not in p2, 'the option turns the reference drawing off'); pg.check('#exPdfRef')
    pdf3 = pg.evaluate("PlateApp.drillPdf('A3')"); check(pdf3['pages'] == 7, 'A3 tiling: 3 x 2 pages, got %d' % pdf3['pages'])
    dxf = pg.evaluate('PlateApp.drillDxf()'); check(dxf.count('0\nCIRCLE\n') == 11 and dxf.count('POLYLINE\n8\nARROW') == 10 and dxf.startswith('0\nSECTION') and dxf.endswith('0\nEOF\n'), 'DXF has 11 circles and 10 arrow polylines, got %d' % dxf.count('0\nCIRCLE\n'))
    ld = pg.evaluate('PlateApp.lettersEps()'); check(ld['dxf'].count('POLYLINE\n8\nLETTERS') == ld['polys'] and ld['polys'] >= 14, 'letter DXF has one polyline per outline')
    pg.click('#exDxf'); pg.wait_for_timeout(100); check(pg.input_value('#exName') == 'plate-drill-pattern.dxf' and pg.input_value('#exText').count('CIRCLE') == 11, 'export is also shown as text (name and content)')
    # letter EPS
    le = pg.evaluate('PlateApp.lettersEps()'); check(le['polys'] >= 14, 'letter outlines exist, got %d' % le['polys']); check(nmove(le['text']) >= 14 and ' l\n' in le['text'], 'letter EPS has paths')
    # holes covered by the letters in the default layout (DejaVu Sans, uniform cells)
    cov = pg.inner_text('#info-casino'); print('casino info:', cov)
    # controls: plate width slider
    pg.fill('#plateWn', '700'); pg.wait_for_timeout(100); check(S()['plate']['w'] == 700, 'plate width numeric field'); check(pg.input_value('#plateW') == '700', 'slider follows numeric field')
    pg.fill('#plateWn', '960')
    # hole slider shared diameter
    pg.fill('#holeDn', '12'); pg.wait_for_timeout(50); check(S()['holeD'] == 12, 'hole diameter 12')
    eps = pg.evaluate('PlateApp.drillEps()'); el = eps.split('\n4 M q\n')[1].split('\n'); i0 = [i for i, l in enumerate(el) if l.endswith(' m')][1]; xs = float(el[i0].split()[0]); xe = float(el[i0 + 2].split()[-3]); check(abs((xs - xe) - 12 * 72 / 25.4) < 0.01, 'hole radius 6 mm in the EPS (diameter %.3f pt)' % (xs - xe))
    pg.fill('#holeDn', '10')
    # text edit
    pg.fill('#t-open-text', 'OP'); pg.wait_for_timeout(50); check(len(pg.evaluate('PlateApp.scene()')['open']['cells']) == 2, 'OPEN edited to two letters')
    pg.fill('#t-open-text', 'OPEN')
    # drag the CASINO box with the mouse
    box = pg.evaluate('PlateApp.scene().casino'); vb = pg.evaluate("document.getElementById('svg').getAttribute('viewBox')").split(); vb = [float(v) for v in vb]
    r = pg.evaluate("(()=>{const r=document.getElementById('svg').getBoundingClientRect();return [r.left,r.top,r.width,r.height]})()")
    def px(x, y): return r[0] + (x - vb[0]) / vb[2] * r[2], r[1] + (y - vb[1]) / vb[3] * r[3]
    # click on a gap between holes inside the CASINO box (top edge area, away from holes)
    sx, sy = px(box['x'] + box['w'] * 0.2, box['y'] + 4)
    pg.mouse.move(sx, sy); pg.mouse.down(); pg.mouse.move(sx + 20, sy + 40, steps=5); pg.mouse.up(); pg.wait_for_timeout(100)
    dx = S()['texts']['casino']['x'] - 20; dy = S()['texts']['casino']['y'] - 20
    check(dx > 5 and dy > 5, 'box moved by dragging (dx %.1f dy %.1f)' % (dx, dy))
    # undo restores
    pg.evaluate('PlateApp.commit()'); n0 = pg.evaluate('PlateApp.hist()')
    pg.click('#undo'); pg.wait_for_timeout(100); check(S()['texts']['casino']['x'] == 20, 'undo restores the position (x=%s)' % S()['texts']['casino']['x'])
    pg.click('#redo'); pg.wait_for_timeout(100); check(S()['texts']['casino']['x'] > 25, 'redo moves it again')
    # keyboard nudge
    pg.keyboard.press('ArrowRight'); x1 = S()['texts']['casino']['x']; pg.keyboard.press('Shift+ArrowRight'); x2 = S()['texts']['casino']['x']
    near(x2 - x1, 10, 1e-6, 'Shift+Arrow nudges 10 mm'); pg.keyboard.press('Alt+ArrowLeft'); near(S()['texts']['casino']['x'] - x2, -0.1, 1e-6, 'Alt+Arrow nudges 0.1 mm')
    # dropdowns: click opens the list, arrows preview live, Enter accepts, Esc reverts
    pg.select_option('#t-casino-font', 'Limelight'); pg.wait_for_timeout(100)
    pg.click('#t-casino-font + *', force=True) if False else pg.locator('#t-casino-font').locator('xpath=preceding-sibling::button').click()
    check(pg.locator('.dd-list').count() == 1, 'click opens the list')
    check(pg.locator('.dd-item.hi').inner_text() == 'Limelight', 'the current font is highlighted when the list opens')
    pg.keyboard.press('ArrowDown'); pg.wait_for_timeout(100); f1 = S()['texts']['casino']['font']; check(f1 != 'Limelight', 'ArrowDown previews the next font at once (got %s)' % f1)
    check(pg.locator('#t-casino-font').locator('xpath=preceding-sibling::button').inner_text().startswith(f1), 'the box shows the previewed font')
    pg.keyboard.press('Escape'); pg.wait_for_timeout(100); check(S()['texts']['casino']['font'] == 'Limelight' and pg.locator('.dd-list').count() == 0, 'Esc closes the list and puts the old font back')
    pg.locator('#t-casino-font').locator('xpath=preceding-sibling::button').click(); pg.keyboard.press('ArrowDown'); pg.keyboard.press('ArrowDown'); pg.keyboard.press('Enter'); pg.wait_for_timeout(100)
    f2 = S()['texts']['casino']['font']; check(f2 not in ('Limelight', f1) and pg.locator('.dd-list').count() == 0, 'Enter accepts the previewed font (%s)' % f2)
    h0 = pg.evaluate('PlateApp.hist()')['n']; pg.locator('#t-casino-font').locator('xpath=preceding-sibling::button').click(); pg.keyboard.press('ArrowDown'); pg.wait_for_timeout(600); pg.keyboard.press('Escape'); pg.wait_for_timeout(100)
    check(S()['texts']['casino']['font'] == f2 and pg.evaluate('PlateApp.hist()')['n'] == h0, 'a cancelled preview leaves no undo step')
    pg.locator('#frameLayout').locator('xpath=preceding-sibling::button').click(); pg.keyboard.press('ArrowDown'); check(S()['frame']['layout'] == 'sides', 'other dropdowns preview live too'); pg.keyboard.press('Escape'); check(S()['frame']['layout'] == 'topbottom', 'and revert on Esc')
    pg.locator('#dims').locator('xpath=preceding-sibling::button').click(); pg.mouse.click(5, 5); check(pg.locator('.dd-list').count() == 0, 'a click outside closes the list')
    pg.evaluate("PlateApp.useFont('casino','DejaVu Sans')")
    col = pg.evaluate("(()=>{const s=getComputedStyle(document.querySelector('.dd-btn'));return [s.color,s.backgroundColor]})()")
    check(col[0] != col[1], 'dropdown text is readable in dark mode: %s on %s' % tuple(col))
    # every control has a tooltip
    missing = pg.evaluate("Array.from(document.querySelectorAll('#panel input, #panel textarea, #panel button, #panel select')).filter(e => !(e.title || '').trim() && !e.closest('label[title]')).map(e => e.id || e.className)")
    check(not missing, 'controls without a tooltip: %s' % missing)
    mp = pg.evaluate("document.getElementById('minStroke').title"); check('thin' in mp and 'Minimum stroke' in mp, 'min stroke tooltip explains the setting')
    # drag a number
    def centre(sel):
        pg.locator(sel).scroll_into_view_if_needed(); bb = pg.locator(sel).bounding_box(); return bb['x'] + bb['width'] / 3, bb['y'] + bb['height'] / 2
    cx, cy = centre('#plateHn'); pg.mouse.move(cx, cy); pg.mouse.down(); pg.mouse.move(cx - 40, cy, steps=6); pg.mouse.up(); pg.wait_for_timeout(50)
    check(S()['plate']['h'] == 280, 'dragging left 40 px lowers plate height by 20 mm (got %s)' % S()['plate']['h'])
    cx, cy = centre('#plateHn'); pg.mouse.move(cx, cy); pg.mouse.down(); pg.mouse.move(cx, cy - 10, steps=5); pg.mouse.up(); pg.wait_for_timeout(50)
    check(S()['plate']['h'] == 300, 'dragging up 10 px raises it by 20 steps (4x faster), clamped to 300 (got %s)' % S()['plate']['h'])
    cx, cy = centre('#holeDn'); pg.mouse.move(cx, cy); pg.mouse.down(); pg.mouse.move(cx + 8, cy, steps=4); pg.mouse.up(); pg.wait_for_timeout(50)
    check(S()['holeD'] == 12, 'step 0.5: 8 px right = 4 steps = +2 mm (got %s)' % S()['holeD'])
    pg.fill('#holeDn', '10')
    cx, cy = centre('#t-casino-h'); pg.mouse.click(cx, cy); pg.keyboard.type('90'); pg.wait_for_timeout(50)
    check(S()['texts']['casino']['h'] == 90 and pg.evaluate("document.activeElement.id") == 't-casino-h', 'a plain click still lets you type a number (got %s)' % S()['texts']['casino']['h'])
    pg.fill('#t-casino-h', '100'); pg.keyboard.press('Tab')
    # a font that is still loading is not drawn: the old font stays until the new one is ready
    pg.route('**/fonts.googleapis.com/**', lambda r: (pg.wait_for_timeout(1500), r.abort()))
    before = pg.evaluate("PlateApp.shownFont('casino')")
    pg.evaluate("PlateApp.useFont('casino','Zilla Slab')"); pg.wait_for_timeout(200)
    check(pg.evaluate("PlateApp.shownFont('casino')") == before and pg.evaluate("PlateApp.fontStatus('Zilla Slab')") == 'loading', 'while the new font loads the old one stays drawn (shows %s)' % pg.evaluate("PlateApp.shownFont('casino')"))
    pg.wait_for_timeout(500); check('Loading font Zilla Slab' in pg.inner_text('#info-casino'), 'the info line says the font is loading')
    pg.wait_for_function("PlateApp.fontStatus('Zilla Slab') !== 'loading'", timeout=10000)
    check(pg.evaluate("PlateApp.shownFont('casino')") == 'Zilla Slab', 'after loading (or failing) the new font is the drawn one')
    pg.unroute('**/fonts.googleapis.com/**'); pg.evaluate("PlateApp.useFont('casino','DejaVu Sans')"); pg.wait_for_timeout(300)
    # height and width scale the whole text uniformly around the centre of the box
    pg.fill('#t-casino-x', '20'); pg.fill('#t-casino-y', '20'); pg.fill('#t-casino-h', '60'); st = S()['texts']['casino']
    near(st['y'], 40, 0.011, 'height 100 -> 60 keeps the vertical centre (y 20 -> 40)'); near(st['x'], 128, 0.011, 'and the horizontal centre: the width shrinks 540 -> 324, x 20 -> 128')
    near(st['cellW'], 54, 0.001, 'cell width scales with the height'); near(st['spacing'], 3.6, 0.001, 'gap scales with the height')
    check(pg.input_value('#t-casino-w') == '324', 'the width field shows 324 (got %s)' % pg.input_value('#t-casino-w'))
    pg.fill('#t-casino-w', '648'); st = S()['texts']['casino']
    near(st['h'], 120, 0.01, 'width 324 -> 648 doubles the height (aspect locked)'); near(st['x'] + 324, 290, 0.02, 'horizontal centre stays at 290'); near(st['y'] + 60, 70, 0.02, 'vertical centre stays at 70')
    pg.fill('#t-casino-h', '100'); pg.fill('#t-casino-cw', '90'); pg.fill('#t-casino-sp', '6'); st = S()['texts']['casino']; c0 = st['x'] + 270
    pg.fill('#t-casino-cw', '100'); st = S()['texts']['casino']; near(st['x'] + 300, c0, 0.02, 'cell width alone also keeps the horizontal centre')
    pg.fill('#t-casino-cw', '90'); pg.select_option('#t-casino-mode', 'natural')
    def cen(): return pg.evaluate("(()=>{const b=PlateApp.scene().casino;return [b.x+b.w/2,b.y+b.h/2,b.w/b.h]})()")
    c0 = cen(); pg.fill('#t-casino-h', '70'); c1 = cen()
    near(c1[0], c0[0], 0.02, 'natural mode: horizontal centre stays'); near(c1[1], c0[1], 0.02, 'natural mode: vertical centre stays'); near(c1[2], c0[2], 0.02, 'natural mode: aspect ratio stays')
    pg.select_option('#t-casino-mode', 'uniform'); pg.fill('#t-casino-h', '100'); pg.fill('#t-casino-cw', '90'); pg.fill('#t-casino-sp', '6'); pg.fill('#t-casino-x', '20'); pg.fill('#t-casino-y', '20')
    # handles: drag to scale around the centre
    def mmpx(mx, my):
        vb2 = [float(v) for v in pg.evaluate("document.getElementById('svg').getAttribute('viewBox')").split()]; r2 = pg.evaluate("(()=>{const r=document.getElementById('svg').getBoundingClientRect();return [r.left,r.top,r.width,r.height]})()")
        return r2[0] + (mx - vb2[0]) / vb2[2] * r2[2], r2[1] + (my - vb2[1]) / vb2[3] * r2[3]
    pg.mouse.click(*mmpx(20 + 540 * 0.2, 24)); check(pg.evaluate('PlateApp.selection().type') == 'casino', 'casino selected')
    pg.uncheck('#snap')
    bx = pg.evaluate('PlateApp.scene().casino'); hx0, hy0 = mmpx(bx['x'] + bx['w'], bx['y'] + bx['h'] / 2); tx, ty = mmpx(290 + 324, 70)
    pg.mouse.move(hx0, hy0); check(pg.evaluate("document.getElementById('svg').style.cursor") == 'ew-resize', 'cursor over a side handle is ew-resize')
    pg.mouse.down(); pg.mouse.move(tx, hy0, steps=6); pg.mouse.up(); pg.wait_for_timeout(50)
    st = S()['texts']['casino']; near(st['h'], 120, 1.5, 'right side handle dragged to scale 1.2: height 100 -> ~120 (got %s)' % st['h'])
    cb = pg.evaluate('PlateApp.scene().casino'); near(cb['x'] + cb['w'] / 2, 290, 0.05, 'centre x stays after a handle drag'); near(cb['y'] + cb['h'] / 2, 70, 0.05, 'centre y stays after a handle drag'); near(cb['w'] / cb['h'], 5.4, 0.01, 'aspect ratio stays')
    pg.fill('#t-casino-h', '100'); pg.fill('#t-casino-x', '20'); pg.fill('#t-casino-y', '20')
    bx = pg.evaluate('PlateApp.scene().casino'); hx0, hy0 = mmpx(bx['x'] + bx['w'], bx['y'] + bx['h']); tx, ty = mmpx(290 + 270 * 1.1, 70 + 50 * 1.1)
    pg.mouse.move(hx0, hy0); check(pg.evaluate("document.getElementById('svg').style.cursor") == 'nwse-resize', 'cursor over the bottom right corner is nwse-resize')
    pg.mouse.down(); pg.mouse.move(tx, ty, steps=6); pg.mouse.up(); pg.wait_for_timeout(50)
    st = S()['texts']['casino']; near(st['h'], 110, 1.5, 'corner handle: scale 1.1 (got %s)' % st['h']); cb = pg.evaluate('PlateApp.scene().casino'); near(cb['x'] + cb['w'] / 2, 290, 0.05, 'corner: centre x stays'); near(cb['w'] / cb['h'], 5.4, 0.01, 'corner: aspect stays')
    pg.fill('#t-casino-h', '100'); pg.fill('#t-casino-x', '20'); pg.fill('#t-casino-y', '20'); pg.check('#snap')
    # a handle snaps to the edges and centres of the other elements: the right edge of CASINO onto the left edge of OPEN (x = 600)
    pg.fill('#t-open-x', '600'); pg.uncheck('#sameH-casino')
    bx = pg.evaluate('PlateApp.scene().casino'); hx0, hy0 = mmpx(bx['x'] + bx['w'], bx['y'] + bx['h'] / 2); tx, ty = mmpx(597.5, 70)
    pg.mouse.move(hx0, hy0); pg.mouse.down(); pg.mouse.move(tx, hy0, steps=6); pg.mouse.up(); pg.wait_for_timeout(50)
    cb = pg.evaluate('PlateApp.scene().casino'); near(cb['x'] + cb['w'], 600, 0.02, 'the right handle snapped to x = 600 (the left edge of OPEN)'); near(cb['x'] + cb['w'] / 2, 290, 0.05, 'snapping keeps the centre')
    pg.fill('#t-casino-h', '100'); pg.fill('#t-casino-x', '20'); pg.fill('#t-casino-y', '20')
    # strip pieces
    pg.click('#stripAdd'); check(len(S()['strips']) == 1, 'strip piece added'); pg.keyboard.press('r'); check(S()['strips'][0]['rot'] == 90, 'R rotates the strip')
    pg.keyboard.press('Delete'); check(len(S()['strips']) == 0, 'Delete removes the strip')
    # CLOSED hole export modes
    pg.select_option('#closedHole', 'slot'); e2 = pg.evaluate('PlateApp.drillEps()'); check(ncirc(e2) == 10 and nmove(e2) == 10 + 1 + 1 + 10, 'slot mode: 10 circles + a rectangle + 10 stick outlines (+ the plate outline)')
    pg.select_option('#closedHole', 'none'); e3 = pg.evaluate('PlateApp.drillEps()'); check(ncirc(e3) == 10 and nmove(e3) == 10 + 1 + 10, 'none mode: 10 circles + 10 stick outlines (+ the plate outline)')
    pg.select_option('#closedHole', 'round')
    # quick hole buttons
    pg.click('#t-casino-fit'); offs = S()['texts']['casino']['holeOffsets']; check(len(offs) == 6, 'fit button stores 6 offsets')
    pg.click('#t-casino-centre'); check(all(o['dx'] == 0 and o['dy'] == 0 for o in S()['texts']['casino']['holeOffsets']), 'centre button zeros the offsets')
    # JSON round trip
    j = pg.input_value('#json'); pg.evaluate('PlateApp.commit()'); j = pg.input_value('#json'); d = json.loads(j); check(d['version'] == 1 and d['texts']['casino']['font'] == 'DejaVu Sans', 'JSON textarea shows the state')
    d['plate']['w'] = 800; pg.fill('#json', json.dumps(d)); pg.click('#jsonApply'); check(S()['plate']['w'] == 800, 'JSON import applies')
    pg.fill('#json', '{"version":9}'); pg.click('#jsonApply'); check('Not loaded' in pg.inner_text('#jsonMsg'), 'bad JSON is reported')
    # copy JSON from the app / paste the clipboard into the app
    pg.click('#jsonCopy'); pg.wait_for_timeout(100); clip = pg.evaluate('navigator.clipboard.readText()')
    check(json.loads(clip)['plate']['w'] == 800 and 'Copied' in pg.inner_text('#jsonMsg') + 'Copied' and 'copied' in pg.inner_text('#jsonMsg'), 'Copy JSON puts the layout on the clipboard')
    d2 = json.loads(clip); d2['plate']['w'] = 600; pg.evaluate('t => navigator.clipboard.writeText(t)', json.dumps(d2)); pg.click('#jsonPaste'); pg.wait_for_timeout(200)
    check(S()['plate']['w'] == 600, 'Paste clipboard into app loads the layout (got %s)' % S()['plate']['w'])
    pg.evaluate('t => navigator.clipboard.writeText(t)', 'not json'); pg.click('#jsonPaste'); pg.wait_for_timeout(200); check('Not loaded' in pg.inner_text('#jsonMsg') and S()['plate']['w'] == 600, 'bad clipboard text is reported and changes nothing')
    pg.evaluate("document.activeElement.blur()"); d2['plate']['w'] = 700
    pg.evaluate("t => { const dt = new DataTransfer(); dt.setData('text', t); document.dispatchEvent(new ClipboardEvent('paste', { clipboardData: dt, bubbles: true })); }", json.dumps(d2)); pg.wait_for_timeout(100)
    check(S()['plate']['w'] == 700, 'Ctrl+V anywhere on the page loads a pasted layout')
    pg.fill('#plateWn', '960')
    # frame info
    pg.fill('#plateWn', '960'); info = pg.inner_text('#frameInfo'); check('Total 24 units = 72 LEDs' in info, 'frame info: ' + info.replace('\n', ' | '))
    # layouts in localStorage
    pg.fill('#layoutName', 'test one'); pg.click('#layoutSave'); check('test one' in pg.inner_text('#layoutList'), 'saved layout is listed')
    pg.evaluate('PlateApp.commit()'); pg.reload(); pg.wait_for_timeout(400); check(S()['plate']['w'] == 960 or S()['plate']['w'] == 800, 'autosave restored after reload'); check('test one' in pg.inner_text('#layoutList'), 'saved layout survives reload')
    # the repository root page redirects to the designer (GitHub Pages entry)
    pg.goto('file://' + ROOT + '/index.html'); pg.wait_for_url('**/tools/plate-designer/index.html', timeout=5000); check(pg.locator('#plateW').count() == 1, 'root index.html redirects to the Plate Designer')
    pg.goto(URL); pg.wait_for_timeout(300)
    # plate edge cut line and LED strips inside the plate
    pg.goto(URL); pg.wait_for_timeout(300); pg.evaluate(LEGACY_JS); pg.wait_for_timeout(50); pg.evaluate("PlateApp.useFont('casino','DejaVu Sans')")
    n0 = pg.evaluate('PlateApp.lettersEps()'); check('PLATE_CUT' not in n0['dxf'], 'plate cut is off by default')
    pg.check('#exPlateCut'); ld = pg.evaluate('PlateApp.lettersEps()')
    check(ld['dxf'].count('POLYLINE\n8\nPLATE_CUT') == 1 and ld['polys'] == n0['polys'] + 1 and nmove(ld['text']) == nmove(n0['text']) + 1, 'plate edge adds one closed outline to the letter EPS and DXF')
    pg.check('#exNest'); lnest = pg.evaluate('PlateApp.lettersEps()')
    check(lnest['dxf'].count('POLYLINE\n8\nPLATE_CUT') == 1 and lnest['polys'] == n0['polys'] + 1, 'nested: the plate edge is a nested piece')
    pg.uncheck('#exNest'); pg.uncheck('#exPlateCut')
    S0 = S(); check(S0['frame']['inside'] is False, 'strips outside by default')
    t_out = pg.inner_text('#frameInfo'); pg.check('#frameInside'); check(S()['frame']['inside'] is True, 'top bar checkbox sets frame.inside')
    t_in = pg.inner_text('#frameInfo'); check(t_in != t_out and 'Total 22 units' in t_in.replace('\xa0', ' ') if S()['plate']['w'] == 960 else True, 'frame info changes when the strips move inside')
    pg.click('#zfit'); pg.wait_for_timeout(100)
    ghost = pg.evaluate("document.querySelectorAll('#svg g[pointer-events=none] rect[stroke-dasharray]').length"); check(ghost == 4, 'inside: four ghost strips (dashed, translucent) are drawn over the plate, got %d' % ghost)
    pg.uncheck('#frameInside'); pg.wait_for_timeout(100)
    # extra holes in a letter
    pg.goto(URL); pg.wait_for_timeout(300); pg.evaluate(LEGACY_JS); pg.wait_for_timeout(50); pg.evaluate("PlateApp.useFont('casino','DejaVu Sans')"); pg.click('#zfit'); pg.wait_for_timeout(200)
    def scr(x, y):
        vb = [float(v) for v in pg.evaluate("document.getElementById('svg').getAttribute('viewBox')").split()]; r = pg.evaluate("(function(){var b=document.getElementById('svg').getBoundingClientRect();return [b.left,b.top,b.width,b.height]})()")
        return r[0] + (x - vb[0]) / vb[2] * r[2], r[1] + (y - vb[1]) / vb[3] * r[3]
    arcs0 = ncirc(pg.evaluate('PlateApp.drillEps()')); dxf0 = pg.evaluate('PlateApp.drillDxf()').count('0\nCIRCLE\n')
    check(S()['texts']['casino']['extraHoles'] == [], 'no extra holes by default'); check(pg.locator('#t-casino-xbox .xadd').count() == 6 and pg.locator('#t-open-xbox .xadd').count() == 4 and pg.locator('#t-closed-xbox').count() == 0, 'one add button per letter (CASINO 6, OPEN 4), none for CLOSED')
    pg.click('#t-casino-xbox .xadd[data-i="1"]'); pg.wait_for_timeout(100)
    xh = S()['texts']['casino']['extraHoles']; check(len(xh) == 1 and xh[0]['i'] == 1, 'the add button adds an extra hole to letter 2')
    c1 = pg.evaluate('PlateApp.scene().casino.cells[1]'); check(len(c1['extras']) == 1 and (abs(c1['extras'][0]['x'] - c1['hole']['x']) > 5 or abs(c1['extras'][0]['y'] - c1['hole']['y']) > 5), 'the new hole is placed away from the main hole')
    check(ncirc(pg.evaluate('PlateApp.drillEps()')) == arcs0 + 1 and pg.evaluate('PlateApp.drillDxf()').count('0\nCIRCLE\n') == dxf0 + 1, 'the extra hole is in the drill EPS and DXF')
    check('A2 hole 1' in pg.inner_text('#t-casino-xbox'), 'the list names the hole: A2 hole 1, got %r' % pg.inner_text('#t-casino-xbox'))
    check('Holes covered by the letters: 4/7' in pg.inner_text('#info-casino') or '/7' in pg.inner_text('#info-casino'), 'the hole counter counts the extra hole (7 holes)')
    ex = c1['extras'][0]; x0, y0 = scr(ex['x'], ex['y']); pg.mouse.move(x0, y0); pg.mouse.down(); k = pg.evaluate('(function(){var b=document.getElementById("svg").getBoundingClientRect();var vb=document.getElementById("svg").getAttribute("viewBox").split(" ");return b.width/parseFloat(vb[2])})()')
    pg.mouse.move(x0 + 3 * k, y0 + 2 * k, steps=4); pg.mouse.up(); pg.wait_for_timeout(100)
    xh2 = S()['texts']['casino']['extraHoles'][0]; near(xh2['dx'] - xh[0]['dx'], 3, 0.6, 'dragging moves the extra hole by 3 mm in x'); near(xh2['dy'] - xh[0]['dy'], 2, 0.6, 'and by 2 mm in y')
    pg.keyboard.press('Delete'); pg.wait_for_timeout(100); check(S()['texts']['casino']['extraHoles'] == [], 'Delete removes the selected extra hole')
    check(pg.locator('#undo').is_enabled(), 'undo available'); pg.click('#undo'); pg.wait_for_timeout(200); check(len(S()['texts']['casino']['extraHoles']) == 1, 'undo brings the hole back')
    ex = pg.evaluate('PlateApp.scene().casino.cells[1].extras[0]'); x1, y1 = scr(ex['x'], ex['y']); pg.mouse.dblclick(x1, y1); pg.wait_for_timeout(100); check(S()['texts']['casino']['extraHoles'] == [], 'double-clicking an extra hole removes it')
    pg.mouse.dblclick(x1, y1); pg.wait_for_timeout(100); xh3 = S()['texts']['casino']['extraHoles']; check(len(xh3) == 1 and xh3[0]['i'] == 1, 'double-clicking inside a letter adds a hole at that spot (letter 2)')
    c1b = pg.evaluate('PlateApp.scene().casino.cells[1]'); near(c1b['extras'][0]['x'], ex['x'], 0.7, 'the new hole is where the click was (x)'); near(c1b['extras'][0]['y'], ex['y'], 0.7, 'and (y)')
    pg.click('#t-casino-xbox .xdel'); pg.wait_for_timeout(100); check(S()['texts']['casino']['extraHoles'] == [], 'the x button in the list removes the hole')
    pg.fill('#t-casino-text', 'CAS'); pg.click('#t-casino-xbox .xadd[data-i="2"]'); pg.fill('#t-casino-text', 'CA'); pg.evaluate('PlateApp.commit()'); pg.wait_for_timeout(100)
    check(pg.locator('#t-casino-xbox .xchip').count() == 0, 'a hole of a letter that no longer exists is not listed')
    pg.fill('#t-casino-text', 'CASINO'); pg.evaluate('PlateApp.commit()')
    # plate centre lines and Ctrl = no snapping
    pg.goto(URL); pg.wait_for_timeout(300); pg.evaluate(LEGACY_JS); pg.wait_for_timeout(50); pg.click('#zfit'); pg.wait_for_timeout(100)
    check(pg.evaluate("document.querySelectorAll('#svg line[stroke=\"#0a8f8f\"]').length") == 2 and 'centre 480, 150' in pg.evaluate("document.getElementById('svg').textContent"), 'the plate centre lines and the centre label (490, 150) are drawn')
    check(pg.evaluate("document.querySelector('#svg line[stroke=\"#0a8f8f\"]').getAttribute('x1')") == '480', 'vertical centre line at x = 480')
    check(S()['ui']['snap'] is True, 'snap is on by default')
    pg.fill('#t-casino-x', '20'); pg.fill('#t-casino-y', '20')
    ax, ay = scr(20 + 540 * 0.2, 24); kk = pg.evaluate('(function(){var b=document.getElementById("svg").getBoundingClientRect();var vb=document.getElementById("svg").getAttribute("viewBox").split(" ");return b.width/parseFloat(vb[2])})()')
    pg.mouse.move(ax, ay); pg.mouse.down(); pg.mouse.move(ax + 191.5 * kk, ay, steps=5); pg.mouse.up(); pg.wait_for_timeout(100)
    near(S()['texts']['casino']['x'], 210, 0.01, 'dragging CASINO 191.5 mm snaps its centre onto the plate centre line (x = 210)')
    pg.fill('#t-casino-x', '20'); ax, ay = scr(20 + 540 * 0.2, 24)
    pg.keyboard.down('Control'); pg.mouse.move(ax, ay); pg.mouse.down(); pg.mouse.move(ax + 191.5 * kk, ay, steps=5); pg.mouse.up(); pg.keyboard.up('Control'); pg.wait_for_timeout(100)
    near(S()['texts']['casino']['x'], 211.5, 0.3, 'with Ctrl held the same drag does not snap (x = 211.5)')
    pg.fill('#t-casino-x', '20'); pg.evaluate('PlateApp.commit()')
    # plate resize happens around the plate centre
    pg.goto(URL); pg.wait_for_timeout(300); pg.evaluate(LEGACY_JS); pg.wait_for_timeout(50); cx0 = S()['texts']['casino']['x']; w0 = S()['plate']['w']
    pg.fill('#plateWn', str(w0 - 100)); pg.wait_for_timeout(100); near(S()['texts']['casino']['x'], cx0 - 50, 0.01, 'plate 100 mm narrower: content shifts 50 mm (both edges move)'); check(S()['plate']['w'] == w0 - 100, 'plate width changed')
    h0 = S()['plate']['h']; cy0 = S()['texts']['casino']['y']; pg.fill('#plateHn', str(h0 - 40)); pg.wait_for_timeout(100); near(S()['texts']['casino']['y'], cy0 - 20, 0.01, 'plate 40 mm lower: content shifts 20 mm up')
    pg.fill('#plateWn', str(w0)); pg.fill('#plateHn', str(h0)); pg.wait_for_timeout(100); near(S()['texts']['casino']['x'], cx0, 0.01, 'back to the old width: content is back'); pg.evaluate('PlateApp.commit()')
    # plate size limits 1-1000 mm, defaults 960 x 300
    pg.goto(URL); pg.wait_for_timeout(300); pg.evaluate("PlateApp.reset && PlateApp.reset()")
    pg.fill('#plateWn', '1'); pg.fill('#plateHn', '1000'); pg.wait_for_timeout(100); check(S()['plate']['w'] == 1 and S()['plate']['h'] == 1000, 'plate can be 1 x 1000 mm')
    pg.fill('#plateWn', '5000'); pg.fill('#plateHn', '-4'); pg.wait_for_timeout(100); check(S()['plate']['w'] == 1000 and S()['plate']['h'] == 1, 'width is limited to 1000, height to 1')
    check(pg.get_attribute('#plateW', 'max') == '1000' and pg.get_attribute('#plateH', 'max') == '1000' and pg.get_attribute('#plateWn', 'min') == '1', 'the sliders and number fields are 1-1000')
    pg.fill('#plateWn', '960'); pg.fill('#plateHn', '300'); pg.wait_for_timeout(100); pg.evaluate('PlateApp.commit()')
    # gold flash and panel scrolling when a text is selected from the drawing
    pg.goto(URL); pg.wait_for_timeout(300); pg.evaluate(LEGACY_JS); pg.wait_for_timeout(50); pg.evaluate("PlateApp.useFont('casino','DejaVu Sans')"); pg.set_viewport_size({'width': 1300, 'height': 520}); pg.click('#zfit'); pg.wait_for_timeout(200)
    pg.evaluate("document.getElementById('panel').scrollTop = 0"); pg.wait_for_timeout(100)
    def sect_state(key):
        return pg.evaluate("(function(){var p=document.getElementById('panel').getBoundingClientRect(),e=document.getElementById('sect-%s').getBoundingClientRect();return [e.top-p.top,e.bottom-p.top,document.getElementById('panel').clientHeight,document.getElementById('sect-%s').classList.contains('flash')]})()" % (key, key))
    ob = pg.evaluate('PlateApp.scene().open'); ox, oy = scr(ob['x'] + ob['w'] * 0.2, ob['y'] + 4)
    check(pg.evaluate('PlateApp.selection().type') == 'casino' and sect_state('open')[1] > sect_state('open')[2], 'before: CASINO is selected and the OPEN section is not fully visible')
    pg.mouse.click(ox, oy); pg.wait_for_timeout(120)
    check(pg.evaluate('PlateApp.selection().type') == 'open', 'clicking OPEN in the drawing selects it')
    check(sect_state('open')[3] is True, 'the OPEN section flashes (gold)'); check(pg.evaluate("document.querySelectorAll('#svg rect[stroke=\"#e8a000\"]').length") == 1, 'a gold bounding box is drawn around OPEN')
    pg.wait_for_timeout(900); st = sect_state('open'); m = st[2] / 5
    check(st[0] >= m - 1.5 and st[1] <= st[2] - m + 1.5 or (st[1] - st[0] + 2 * m > st[2] and abs(st[0] - m) < 1.5), 'the panel scrolled so that OPEN is visible with a 1/5 margin: top %.0f bottom %.0f of %d' % (st[0], st[1], st[2]))
    check(sect_state('open')[3] is False and pg.evaluate("document.querySelectorAll('#svg rect[stroke=\"#e8a000\"]').length") == 0, 'the flash is over after half a second')
    top1 = pg.evaluate("document.getElementById('panel').scrollTop"); pg.mouse.click(ox, oy); pg.wait_for_timeout(150)
    check(sect_state('open')[3] is False and pg.evaluate("document.querySelectorAll('#svg rect[stroke=\"#e8a000\"]').length") == 0 and pg.evaluate("document.getElementById('panel').scrollTop") == top1, 'clicking the already selected text: no flash, no scrolling')
    pg.evaluate("document.getElementById('panel').scrollTop = 0"); cb = pg.evaluate('PlateApp.scene().casino'); cx2, cy2 = scr(cb['x'] + cb['w'] * 0.2, cb['y'] + 4)
    pg.mouse.move(cx2, cy2); pg.mouse.down(); pg.wait_for_timeout(80); check(sect_state('casino')[3] is True, 'starting a drag on an unselected text selects it and flashes'); pg.mouse.move(cx2 + 5, cy2 + 5, steps=3); pg.mouse.up()
    pg.wait_for_timeout(700); pg.evaluate("document.getElementById('panel').scrollTop = 300")
    pg.mouse.click(*scr(S()['arrow']['x'] + 20, S()['arrow']['y'] + 20)); pg.wait_for_timeout(150)
    check(pg.evaluate('PlateApp.selection().type') == 'arrow' and not any(sect_state(k)[3] for k in ('casino', 'open', 'closed')) and pg.evaluate("document.querySelectorAll('#svg rect[stroke=\"#e8a000\"]').length") == 0, 'selecting the arrow does not flash anything')
    pg.set_viewport_size({'width': 1400, 'height': 800}); pg.wait_for_timeout(100)
    # frame material: field, info text, PDF page
    pg.goto(URL); pg.evaluate('localStorage.clear()'); pg.goto(URL); pg.wait_for_timeout(300)
    check(pg.input_value('#frameWn') == '30' and pg.get_attribute('#frameW', 'max') == '100' and pg.get_attribute('#frameW', 'min') == '0' and pg.get_attribute('#frameWn', 'max') == '100', 'frame width field: default 30, range 0-100')
    fi = pg.inner_text('#frameMatInfo').replace('\xa0', ' '); check('plate edge 1800 mm' in fi and 'outer edge 2040 mm' in fi and 'long 660 mm, short 600 mm' in fi and 'long 360 mm, short 300 mm' in fi and 'Material needed (long edges): 2040 mm' in fi, 'frame info: ' + fi)
    pg.fill('#frameWn', '50'); pg.wait_for_timeout(100); fi = pg.inner_text('#frameMatInfo'); check(S()['frameWidth'] == 50 and 'outer edge 2200 mm' in fi and 'long 700 mm' in fi, 'frame width 50 updates the info: ' + fi)
    pg.fill('#frameWn', '500'); pg.wait_for_timeout(100); check(S()['frameWidth'] == 100, 'frame width limited to 100')
    pg.fill('#frameWn', '-3'); pg.wait_for_timeout(100); check(S()['frameWidth'] == 0 and 'No frame' in pg.inner_text('#frameMatInfo') and 'perimeter 1800 mm' in pg.inner_text('#frameMatInfo'), 'frame width 0: no frame, perimeter shown')
    fp0 = pg.evaluate("PlateApp.drillPdf('A4')"); check(fp0['pages'] == fp0['tilePages'], 'no frame page in the drill PDF when the width is 0')
    pg.fill('#frameWn', '30'); pg.wait_for_timeout(100); fp = pg.evaluate("PlateApp.drillPdf('A4')")
    check(fp['pages'] == fp['tilePages'] + 1 and 'Top bar: long edge 660 mm' in fp['text'], 'the frame page is the last page of the drill PDF')
    fr = pg.evaluate('PlateApp.framePdf()'); check(fr['pages'] == 1 and fr['text'].startswith('%PDF-1.4') and 'Right bar: long edge 360 mm' in fr['text'] and '/MediaBox [0 0 841.89' in fr['text'], 'separate frame PDF: one A4 landscape page')
    pg.fill('#plateWn', '1000'); pg.fill('#plateHn', '800'); pg.wait_for_timeout(100); check('outer edge 3840 mm' in pg.inner_text('#frameMatInfo'), 'frame info follows the plate size: ' + pg.inner_text('#frameMatInfo'))
    pg.evaluate('PlateApp.commit()'); pg.reload(); pg.wait_for_timeout(300); check(S()['frameWidth'] == 30, 'frame width survives reload')
    # EPS sheet area: the plate is centred in the sheet w x h
    pg.goto(URL); pg.wait_for_timeout(300); pg.evaluate(LEGACY_JS); pg.wait_for_timeout(50)
    pg.fill('#exSheetW', '1000'); pg.fill('#exSheetH', '400'); pg.wait_for_timeout(100)
    def first_lines(t, n): return t.split('\n4 M q\n')[1].split('\n')[:n]
    check(S()['export']['plateOutline'] and first_lines(pg.evaluate('PlateApp.drillEps()'), 2) == ['56.693 992.126 m', '2777.953 992.126 l'], 'drill EPS: the 960 x 300 plate is centred in the 1000 x 400 sheet (offset 20, 50 mm): %s' % first_lines(pg.evaluate('PlateApp.drillEps()'), 2))
    pg.check('#exPlateCut'); lc = pg.evaluate('PlateApp.lettersEps()')['text']; check(first_lines(lc, 2) == ['56.693 992.126 m', '2777.953 992.126 l'], 'letter EPS: plate edge centred the same way: %s' % first_lines(lc, 2))
    pg.fill('#exSheetW', '500'); pg.wait_for_timeout(100); lw = pg.evaluate('PlateApp.lettersEps()'); check('larger than the sheet' in lw['message'] if 'message' in lw else True, 'sheet smaller than the plate: warning'); check(first_lines(lw['text'], 1) == ['0 992.126 m'], 'sheet narrower than the plate: no horizontal offset, area grows')
    pg.uncheck('#exPlateCut'); pg.fill('#exSheetW', '600'); pg.fill('#exSheetH', '300'); pg.wait_for_timeout(100)
    # strip pieces: free rotation (field, handle, R)
    pg.goto(URL); pg.evaluate('localStorage.clear()'); pg.goto(URL); pg.wait_for_timeout(300); pg.set_viewport_size({'width': 1400, 'height': 800}); pg.click('#zfit'); pg.wait_for_timeout(200)
    import math
    pg.click('#stripAdd'); pg.wait_for_timeout(100); st0 = S()['strips'][0]; check(st0['rot'] == 0 and pg.input_value('#stripRotN') == '0', 'a new piece starts at rotation 0')
    pg.fill('#stripRotN', '33.5'); pg.wait_for_timeout(100); check(S()['strips'][0]['rot'] == 33.5 and pg.locator('#svg polygon[stroke="#d00"]').count() == 1 and pg.locator('#svg circle[stroke="#d00"]').count() == 1, 'the rotation field turns the selected piece (33.5), handle shown')
    pg.fill('#stripRotN', '-90'); pg.wait_for_timeout(100); check(S()['strips'][0]['rot'] == 270, 'negative angles wrap: -90 -> 270')
    pg.fill('#stripRotN', '0'); pg.wait_for_timeout(100)
    def sc_c(): st = S()['strips'][0]; return st['x'] + 50, st['y'] + 5
    cx, cy = sc_c(); hx, hy = cx + 62, cy
    pg.mouse.move(*scr(hx, hy)); pg.mouse.down(); pg.mouse.move(*scr(cx + 80 * math.cos(math.radians(40)), cy + 80 * math.sin(math.radians(40))), steps=8); pg.mouse.up(); pg.wait_for_timeout(100)
    near(S()['strips'][0]['rot'], 40, 0.15, 'dragging the round handle turns the piece freely'); check(pg.input_value('#stripRotN') in ('40', '39.9', '40.1') or abs(float(pg.input_value('#stripRotN')) - 40) < 0.15, 'the field follows the handle drag')
    check(abs(S()['strips'][0]['x'] + 50 - cx) < 0.01 and abs(S()['strips'][0]['y'] + 5 - cy) < 0.01, 'turning keeps the centre of the piece')
    hp = (cx + 62 * math.cos(math.radians(40)), cy + 62 * math.sin(math.radians(40)))
    pg.keyboard.down('Shift'); pg.mouse.move(*scr(*hp)); pg.mouse.down(); pg.mouse.move(*scr(cx + 80 * math.cos(math.radians(52)), cy + 80 * math.sin(math.radians(52))), steps=8); pg.mouse.up(); pg.keyboard.up('Shift'); pg.wait_for_timeout(100)
    check(S()['strips'][0]['rot'] == 45, 'Shift while dragging the handle snaps to 15 degrees (52 -> 45), got %s' % S()['strips'][0]['rot'])
    pg.keyboard.press('r'); pg.wait_for_timeout(60); check(S()['strips'][0]['rot'] == 90, 'R turns to the next 90 degree step (45 -> 90)')
    pg.keyboard.press('r'); pg.wait_for_timeout(60); check(S()['strips'][0]['rot'] == 180, 'R again: 180')
    pg.click('#stripRot'); pg.click('#stripRot'); pg.wait_for_timeout(60); check(S()['strips'][0]['rot'] == 0, 'the Turn 90 button: 180 -> 270 -> 0')
    pg.fill('#stripRotN', '30'); pg.wait_for_timeout(100)
    pc = pg.evaluate("(function(){ var p = document.querySelectorAll('#svg polygon[stroke=\"#d00\"]')[0]; return p.getAttribute('points'); })()"); pts = [tuple(float(v) for v in q.split(',')) for q in pc.split()]
    check(len(pts) == 4 and abs(math.hypot(pts[1][0] - pts[0][0], pts[1][1] - pts[0][1]) - 100) < 0.05 and abs(math.hypot(pts[2][0] - pts[1][0], pts[2][1] - pts[1][1]) - 10) < 0.05 and abs(math.degrees(math.atan2(pts[1][1] - pts[0][1], pts[1][0] - pts[0][0])) - 30) < 0.05, 'the drawn piece is a 100 x 10 mm rectangle turned 30 degrees')
    pg.mouse.click(*scr(cx + 40 * math.cos(math.radians(30)), cy + 40 * math.sin(math.radians(30)))); pg.wait_for_timeout(60)
    check(pg.evaluate('PlateApp.selection().type') == 'strip', 'a click on the turned piece selects it')
    pg.mouse.click(*scr(cx - 45 * math.cos(math.radians(30)) + 12 * math.sin(math.radians(30)), cy - 45 * math.sin(math.radians(30)) - 12 * math.cos(math.radians(30)))); pg.wait_for_timeout(60)
    check(pg.evaluate('PlateApp.selection().type') != 'strip', 'a click just beside the turned piece (its old bounding box area) does not select it')
    pg.mouse.click(*scr(cx + 40 * math.cos(math.radians(30)), cy + 40 * math.sin(math.radians(30)))); pg.wait_for_timeout(60)
    sx0, sy0 = S()['strips'][0]['x'], S()['strips'][0]['y']; pg.mouse.move(*scr(cx + 20 * math.cos(math.radians(30)), cy + 20 * math.sin(math.radians(30)))); pg.mouse.down(); pg.mouse.move(*scr(cx + 20 * math.cos(math.radians(30)) + 15, cy + 20 * math.sin(math.radians(30)) + 7), steps=6); pg.mouse.up(); pg.wait_for_timeout(100)
    check(S()['strips'][0]['rot'] == 30 and abs(S()['strips'][0]['x'] - sx0 - 15) < 3.5, 'dragging the turned piece moves it and keeps the angle (snap may nudge it)')
    pg.evaluate('PlateApp.commit()'); pg.reload(); pg.wait_for_timeout(300); check(S()['strips'][0]['rot'] == 30 and S()['stripsV'] == 2, 'the angle survives a reload')
    pg.evaluate("PlateApp.state().strips[0].rot = 30"); info = pg.evaluate("document.getElementById('stripInfo').textContent"); check('piece' in info.lower(), 'strip info still shows: ' + info)
    # arrow LED windows come from the LED window fields, whatever the CLOSED mode is
    pg.goto(URL); pg.wait_for_timeout(300); pg.evaluate(LEGACY_JS); pg.wait_for_timeout(50)
    for mode in ('round', 'slot', 'none'):
        pg.select_option('#closedHole', mode); dd = pg.evaluate('PlateApp.drillDxf()')
        check(dd.count('POLYLINE\n8\nARROW') == 10 and '8\nARROW\n10\n115.38\n20\n119.34\n' in dd, 'CLOSED mode %s: the 10 arrow windows are written; RAIL-UP-L window corner (115.38, 180.66 -> y flipped 119.34)' % mode)
    pg.select_option('#closedHole', 'none'); pg.fill('#slotW', '60'); pg.fill('#slotH', '6'); pg.wait_for_timeout(100); dd = pg.evaluate('PlateApp.drillDxf()')
    check('8\nARROW\n10\n122.38\n20\n120.34\n' in dd and 'LED window' in pg.inner_text('#panel'), 'the LED window fields (60 x 6) size the arrow windows even with no CLOSED hole')
    pg.select_option('#closedHole', 'round'); pg.fill('#slotW', '74'); pg.fill('#slotH', '4'); pg.wait_for_timeout(100)
    # arrow stick outlines and the mirrored drill pattern
    pg.goto(URL); pg.wait_for_timeout(300); pg.evaluate(LEGACY_JS); pg.wait_for_timeout(50)
    check(S()['export']['mirrorDrill'] is False and not pg.is_checked('#exMirrorDrill') and pg.is_checked('#exArrow'), 'mirror image of the drill pattern is off by default; arrow outlines on')
    e_n = pg.evaluate('PlateApp.drillEps()'); d_n = pg.evaluate('PlateApp.drillDxf()'); f_n = pg.evaluate("PlateApp.drillPdf('A4')")['text']
    pg.uncheck('#exArrow'); e_x = pg.evaluate('PlateApp.drillEps()'); check(nmove(e_x) == nmove(e_n) - 10 and 'ARROW' not in pg.evaluate('PlateApp.drillDxf()'), 'arrow option off: no stick outlines'); pg.check('#exArrow')
    pg.check('#exMirrorDrill'); e_m = pg.evaluate('PlateApp.drillEps()'); d_m = pg.evaluate('PlateApp.drillDxf()'); f_m = pg.evaluate("PlateApp.drillPdf('A4')")['text']
    check(S()['export']['mirrorDrill'] is True, 'the mirror option is stored')
    def first_xs(t): return [float(l.split()[0]) for l in t.split('\n4 M q\n')[1].split('\n') if l.endswith(' m') and not l.startswith('0 0')]
    xn, xm = first_xs(e_n), first_xs(e_m); W = 960 * 72 / 25.4
    check(len(xn) == len(xm) == 22, 'EPS: the same 22 paths when mirrored (outline, 11 circles, 10 stick outlines)')
    def circ_centres(t): return [float(l.split()[0]) - 5 * 72 / 25.4 for l in t.split('\n4 M q\n')[1].split('\n') if l.endswith(' m') and not l.startswith('0 0')][1:11]
    cn, cm = circ_centres(e_n), circ_centres(e_m)
    check(len(cn) == 10 and all(abs(a + b - W) < 0.02 for a, b in zip(cn, cm)), 'EPS: every circle centre x -> plate width - x when mirrored')
    check(d_n != d_m and d_n.count('CIRCLE') == d_m.count('CIRCLE') and d_m.count('POLYLINE\n8\nARROW') == 10, 'DXF is mirrored too')
    check(f_n != f_m and f_m.startswith('%PDF-1.4') and f_m.count('(L-CAP D2) Tj') == f_n.count('(L-CAP D2) Tj'), 'PDF is mirrored too, labels stay readable text')
    pg.uncheck('#exMirrorDrill'); check(pg.evaluate('PlateApp.drillEps()') == e_n and pg.evaluate('PlateApp.drillDxf()') == d_n, 'turning the mirror off gives the original files back')
    lt = pg.evaluate('PlateApp.lettersEps()')['text']; pg.check('#exMirrorDrill'); check(pg.evaluate('PlateApp.lettersEps()')['text'] == lt, 'the drill mirror does not touch the letter cut (it has its own mirror option)'); pg.uncheck('#exMirrorDrill')
    # selecting several texts: rubber band, shift / ctrl, group move and scale, same height
    pg.goto(URL); pg.evaluate('localStorage.clear()'); pg.goto(URL); pg.wait_for_timeout(300); pg.evaluate(LEGACY_JS); pg.wait_for_timeout(50); pg.evaluate("PlateApp.useFont('casino','DejaVu Sans')"); pg.set_viewport_size({'width': 1400, 'height': 800}); pg.click('#zfit'); pg.wait_for_timeout(200)
    def box(k): return pg.evaluate('PlateApp.scene().%s' % k)
    def drag_mm(a, b, steps=6, button='left'):
        pg.mouse.move(*scr(*a)); pg.mouse.down(button=button); pg.mouse.move(*scr(*b), steps=steps); pg.mouse.up(button=button); pg.wait_for_timeout(60)
    v0 = pg.evaluate('[PlateApp.view.cx, PlateApp.view.cy]'); drag_mm((-15, -15), (-15, -45), button='right'); v1 = pg.evaluate('[PlateApp.view.cx, PlateApp.view.cy]')
    check(abs(v1[1] - v0[1]) > 5 and pg.evaluate('PlateApp.selected()') == ['casino'], 'right button drag pans the view (selection unchanged)')
    v0 = pg.evaluate('[PlateApp.view.cx, PlateApp.view.cy]'); pg.click('#zfit'); pg.wait_for_timeout(100)
    drag_mm((-15, -15), (610, 60)); check(pg.evaluate('PlateApp.selected()') == ['casino', 'open'], 'rubber band over CASINO and OPEN selects both, got %s' % pg.evaluate('PlateApp.selected()'))
    check(pg.evaluate('[PlateApp.view.cx, PlateApp.view.cy]') == [pg.evaluate('PlateApp.view.cx'), pg.evaluate('PlateApp.view.cy')] and abs(pg.evaluate('PlateApp.view.cx') - 480) < 1, 'the left button drag did not pan')
    check(pg.locator('.sect.flash').count() == 2 and pg.evaluate("document.querySelectorAll('#svg rect[stroke=\"#e8a000\"]').length") == 2, 'both selected texts flash (2 panel sections, 2 gold boxes)')
    pg.wait_for_timeout(700)
    cb, ob = box('casino'), box('open'); ux0, uy0 = min(cb['x'], ob['x']), min(cb['y'], ob['y']); ux1, uy1 = max(cb['x'] + cb['w'], ob['x'] + ob['w']), max(cb['y'] + cb['h'], ob['y'] + ob['h'])
    # group move
    cx0, ox0 = S()['texts']['casino']['x'], S()['texts']['open']['x']; drag_mm((cb['x'] + cb['w'] * 0.2, cb['y'] + 4), (cb['x'] + cb['w'] * 0.2 - 3, cb['y'] + 4 + 5)); pg.keyboard.up('Control')
    dxc, dxo = S()['texts']['casino']['x'] - cx0, S()['texts']['open']['x'] - ox0
    check(abs(dxc - dxo) < 0.01 and abs(dxc) > 0.5 and pg.evaluate('PlateApp.selected()') == ['casino', 'open'], 'dragging one of the group moves both by the same amount (%.2f, %.2f), group stays' % (dxc, dxo))
    # group scale: bottom right corner handle
    pg.fill('#t-casino-x', '20'); pg.fill('#t-casino-y', '20'); pg.fill('#t-open-x', '580'); pg.fill('#t-open-y', '20'); pg.wait_for_timeout(100)
    pg.evaluate("PlateApp.commit()"); cb, ob = box('casino'), box('open'); ux0, uy0 = min(cb['x'], ob['x']), min(cb['y'], ob['y']); ux1, uy1 = max(cb['x'] + cb['w'], ob['x'] + ob['w']), max(cb['y'] + cb['h'], ob['y'] + ob['h'])
    gcx, gcy = (ux0 + ux1) / 2, (uy0 + uy1) / 2; h0c, h0o = S()['texts']['casino']['h'], S()['texts']['open']['h']; occ0 = (ob['x'] + ob['w'] / 2, ob['y'] + ob['h'] / 2)
    pg.uncheck('#snap'); drag_mm((ux1, uy1), (gcx + (ux1 - gcx) * 0.8, gcy + (uy1 - gcy) * 0.8)); pg.check('#snap')
    cb2, ob2 = box('casino'), box('open'); fc, fo = S()['texts']['casino']['h'] / h0c, S()['texts']['open']['h'] / h0o
    near(fc, 0.8, 0.02, 'group scale: CASINO height x 0.8 (got %.3f)' % fc); near(fo, fc, 0.002, 'group scale: OPEN scaled by the same factor')
    near((min(cb2['x'], ob2['x']) + max(cb2['x'] + cb2['w'], ob2['x'] + ob2['w'])) / 2, gcx, 0.3, 'the group centre stays (x)'); near((min(cb2['y'], ob2['y']) + max(cb2['y'] + cb2['h'], ob2['y'] + ob2['h'])) / 2, gcy, 0.3, 'and (y)')
    near(ob2['x'] + ob2['w'] / 2 - gcx, (occ0[0] - gcx) * fc, 0.4, 'OPEN centre moved towards the group centre in proportion (distance x %.3f)' % fc)
    check(pg.evaluate('PlateApp.selected()') == ['casino', 'open'], 'still a group after scaling')
    # hole drag keeps the group, ctrl click removes, click collapses, shift click adds, empty click clears
    c0 = pg.evaluate('PlateApp.scene().casino.cells[0].hole'); hz = pg.evaluate('JSON.stringify(PlateApp.state().texts.casino.holeOffsets)'); drag_mm((c0['x'], c0['y']), (c0['x'] + 2, c0['y'] + 2))
    check(pg.evaluate('PlateApp.selected()') == ['casino', 'open'] and pg.evaluate('JSON.stringify(PlateApp.state().texts.casino.holeOffsets)') != hz, 'dragging a hole moves the hole only and keeps the group selected')
    cb, ob = box('casino'), box('open'); pg.keyboard.down('Control'); pg.mouse.click(*scr(ob['x'] + ob['w'] * 0.2, ob['y'] + 4)); pg.keyboard.up('Control'); pg.wait_for_timeout(60)
    check(pg.evaluate('PlateApp.selected()') == ['casino'], 'ctrl+click on a group member removes it, got %s' % pg.evaluate('PlateApp.selected()'))
    pg.keyboard.down('Shift'); pg.mouse.click(*scr(ob['x'] + ob['w'] * 0.2, ob['y'] + 4)); pg.keyboard.up('Shift'); pg.wait_for_timeout(60)
    check(pg.evaluate('PlateApp.selected()') == ['casino', 'open'], 'shift+click adds a text, got %s' % pg.evaluate('PlateApp.selected()'))
    pg.mouse.click(*scr(ob['x'] + ob['w'] * 0.2, ob['y'] + 4)); pg.wait_for_timeout(60)
    check(pg.evaluate('PlateApp.selected()') == ['open'], 'a plain click on a group member selects only that one, got %s' % pg.evaluate('PlateApp.selected()'))
    pg.mouse.click(*scr(-15, -15)); pg.wait_for_timeout(60); check(pg.evaluate('PlateApp.selected()') == [], 'a click on empty space clears the selection')
    pg.keyboard.down('Shift'); pg.mouse.move(*scr(-15, -15)); pg.mouse.move(*scr(-16, -16)); cur_p = pg.evaluate("document.getElementById('svg').style.cursor"); pg.keyboard.up('Shift')
    check('data:image/svg+xml' in cur_p, 'with shift held the cursor shows the plus')
    pg.keyboard.down('Control'); pg.mouse.move(*scr(-15, -15)); pg.mouse.move(*scr(-16, -17)); cur_m = pg.evaluate("document.getElementById('svg').style.cursor"); pg.keyboard.up('Control')
    check('data:image/svg+xml' in cur_m and cur_m != cur_p, 'with ctrl held the cursor shows the minus')
    drag_mm((-15, -15), (cb['x'] + 5, cb['y'] + 5)); pg.keyboard.down('Shift'); drag_mm((-15, 150), (ob['x'] + 5, ob['y'] + 5)); pg.keyboard.up('Shift')
    check(pg.evaluate('PlateApp.selected()') == ['casino', 'open'], 'shift+rubber band adds to the selection, got %s' % pg.evaluate('PlateApp.selected()'))
    pg.keyboard.down('Control'); drag_mm((ob['x'] - 10, 150), (ob['x'] + 5, ob['y'] + 5)); pg.keyboard.up('Control')
    check(pg.evaluate('PlateApp.selected()') == ['casino'], 'ctrl+rubber band removes from the selection, got %s' % pg.evaluate('PlateApp.selected()'))
    drag_mm((-15, 250), (500, 235)); check(pg.evaluate('PlateApp.selected()') == [], 'a rubber band over nothing clears the selection (replace)')
    # same height
    check(S()['sameHeight'] is True and pg.is_checked('#sameH-casino') and pg.is_checked('#sameH-open'), 'same height is on by default (both checkboxes)')
    pg.fill('#t-casino-h', '120'); pg.wait_for_timeout(60); check(S()['texts']['open']['h'] == 120, 'with same height on, changing the CASINO height changes OPEN too')
    pg.fill('#t-open-h', '90'); pg.wait_for_timeout(60); check(S()['texts']['casino']['h'] == 90, 'and the other way round')
    cb = box('casino'); click_c = scr(cb['x'] + cb['w'] * 0.2, cb['y'] + 4); pg.mouse.click(*click_c); cb = box('casino'); pg.uncheck('#snap')
    drag_mm((cb['x'] + cb['w'], cb['y'] + cb['h'] / 2), (cb['x'] + cb['w'] / 2 + cb['w'] * 0.6, cb['y'] + cb['h'] / 2)); pg.check('#snap')
    check(abs(S()['texts']['casino']['h'] - 108) < 3 and abs(S()['texts']['open']['h'] - S()['texts']['casino']['h']) < 0.01, 'a handle drag on CASINO scales OPEN to the same height (%s, %s)' % (S()['texts']['casino']['h'], S()['texts']['open']['h']))
    pg.uncheck('#sameH-open'); check(S()['sameHeight'] is False and not pg.is_checked('#sameH-casino'), 'unchecking in OPEN unchecks the shared setting (CASINO checkbox follows)')
    pg.fill('#t-casino-h', '70'); pg.wait_for_timeout(60); check(S()['texts']['casino']['h'] == 70 and S()['texts']['open']['h'] != 70, 'with it off, only CASINO changes')
    pg.check('#sameH-casino'); h_open = S()['texts']['open']['h']; pg.wait_for_timeout(60); check(S()['texts']['open']['h'] == h_open, 'turning it on changes nothing by itself')
    pg.fill('#t-casino-h', '100'); pg.fill('#t-casino-x', '20'); pg.fill('#t-casino-y', '20'); pg.fill('#t-open-x', '580'); pg.fill('#t-open-y', '20'); pg.evaluate('PlateApp.commit()')
    # preview and screenshots
    shot = sys.argv[1] if len(sys.argv) > 1 else '/tmp/plate_designer.png'
    pg.click('#zfit'); pg.screenshot(path=shot)
    pg.click('#preview'); pg.screenshot(path=shot.replace('.png', '_preview.png'))
    check(not errs, 'no page errors: %s' % errs)
    b.close()
print('RESULT: %d failures' % len(fails)); sys.exit(1 if fails else 0)
