anttiraisala/casino-open-sign/(commit log)

2026-11-07 Add casino sign project: sketch, drawings, hardware tests and host test harnesses
    Arduino Mega 2560 CASINO OPEN sign (sketch, Wokwi diagram, schematic, layout,
    parts list), three separate hardware tests (strip_test, stick_test,
    stick_test_direct), host-side test harnesses and generator tools. Adds MIT
    LICENSE, README.md, CLAUDE.md and PROGRESS.md.
    Claude-Session: https://claude.ai/code/session_014r6rPhT5roY32RmJFZx3Ka
    [parts-list.csv, parts-list.xlsx]
2026-11-08 Add brightness curves, 10-stick arrow and three new hardware tests
    - Sign sketch: per-LED-type brightness curves (no global brightness), arrow of 10 Grove sticks,
    switch and ball direction bits, CLOSED light stick on A3.
    - New tests: strip_single_led_test (one pixel walks along 12 V WS2811 strips),
    strip_knight_rider_test (bouncing light, D9 red / D10 blue / D11 green) and
    sticks_11_test (10 arrow sticks + CLOSED light, heat check), each with README (EN/FI),
    schematic, layout, Wokwi diagram, host harness and mutation script.
    - Brightness-curve phone tool, arrow geometry and drill template, docs and PDFs updated.
    Claude-Sessio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
    [parts-list.csv, parts-list.xlsx]
2026-11-09 Add Plate Designer: browser tool for the front plate drill/cut layout
    Boxes for arrow, CASINO, OPEN and CLOSED, letter holes with covered check,
    CLOSED round/slot hole, dimension arrows, LED strip frame, strip pieces,
    fonts by name, thickening, thin-part warning, preview, undo, JSON, local
    storage. Exports: drill EPS, tiled A4/A3 PDF, letter cut EPS (as placed or
    nested). Core logic has a node test with a 47-mutant mutation test and a
    Playwright UI test.
    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
2026-11-09 Plate Designer: DXF export, single-file build, export text box
    Drill pattern and letter cut as R12 DXF (layers PLATE/HOLES/SLOT, LETTERS/BOXES),
    8 new mutants (55 total). Exports are also shown as text with a Copy button
    because downloads are blocked in the published artifact.
    tools/build_plate_designer_single.py inlines the tool into one HTML page.
    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
2026-11-09 Plate Designer: tooltips, live dropdowns, drag numbers, font wait, JSON paste, resize around centre
    - every field has a tooltip; dropdowns open on click, arrows preview live, Enter accepts, Esc reverts
    - number fields change by dragging (sideways 1 step per 2 px, up/down 4x faster)
    - a new font is drawn only after it has loaded (no fallback flash)
    - Copy JSON from app / Paste clipboard into app (Ctrl+V anywhere)
    - changing height, cell width or gap keeps the centre of the text box
    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
    [plate_designer_ui_test.py]
2026-11-09 Plate Designer: letters, arrow and labels in the drill PDF
    The tiled A4/A3 drill PDF now also draws the letters and the arrow sticks in
    light grey with labels (C1..O6, stick names with connectors, CLOSED), so one
    print is the drilling template and a second print is the layout drawing.
    Option pdfRef (default on) in the JSON/UI; 9 new mutants (64 total).
    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
2026-11-09 Plate Designer: hole distances in the drill PDF; GitHub Pages entry
    The tiled drill PDF writes the distance from every hole centre to all four
    plate edges around the hole (numbers rounded to 0.1 mm plus thin dotted lines;
    slot: distances to its edges). Option pdfDims, default on; EPS/DXF unchanged.
    19 new mutants (83 total). Root index.html redirect, .nojekyll and README
    links prepare GitHub Pages (owner must switch Pages on).
    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
2026-11-09 Plate Designer: scale handles on text boxes, locked-aspect width/height
    The selected text box (CASINO, OPEN, CLOSED) has handles at the corners and side
    midpoints that scale the whole text uniformly around the centre of its box, plus
    a centre dot that moves it. The dragged handle snaps to the edges and centre
    lines of the other boxes and the plate. New Width field; Height and Width scale
    the text uniformly (cells, gaps, hole offsets) with the aspect ratio locked.
    Pure helpers in plate-core.js, 19 new mutants (102 total), UI test drags handles.
    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
    [mutate_plate_designer.py, plate_designer_ui_test.py]
2026-11-09 Plate Designer: LED strips inside the plate, plate edge cut line, several holes per letter
    - frame.inside option (strips on the plate as translucent ghosts, 100 mm groups tinted)
    - export.plateCut option (plate edge in the letter cut EPS/DXF, layer PLATE_CUT)
    - texts.*.extraHoles: add buttons per letter, double-click add/remove, drag, drill exports
    - tests and mutants extended (132 mutants)
    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
2026-11-09 Plate Designer: plate centre lines, snapping of holes and strips, Ctrl disables snapping
    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
    [plate_designer_ui_test.py]
2026-11-09 Plate Designer: resize the plate around its centre
    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
2026-11-09 Plate Designer: plate size 1-1000 mm, default 960 x 300
    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
2026-11-09 Plate Designer: gold flash and panel scroll when a text is selected from the drawing
    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
2026-11-09 Plate Designer: multi-selection of texts, group move/scale, same-height option
    Right/middle button pans, left button selects; rubber band with Shift/Ctrl
    add/remove, Shift/Ctrl+click, group handles, S.sameHeight for CASINO/OPEN.
    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
2026-11-09 Plate Designer: frame material calculator, frame PDF page, default plate 600 x 300
    Frame width 0-100 mm (default 30), mitred bars, perimeter and material needed,
    frame page in the drill PDFs and a separate A4 frame PDF.
    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
2026-11-09 Plate Designer: Roland CutStudio EPS format, plate centred in the export sheet
    EPS exports use only m/l/c, no closepath, Bezier circles, points, y up and an
    extra 0 0 m at the end. The plate is centred in the Export sheet w x h area.
    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
2026-11-09 Plate Designer: strip pieces turn freely (any angle)
    Rotation field, drag handle (Shift = 15 degree steps), R = 90 degree step;
    strips JSON version 2, older files converted on load.
    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
2026-11-09 Plate Designer: arrow stick outlines in the drill export, mirrored drill pattern option
    The arrow is written as the outlines of its 10 LED sticks instead of round
    holes; new option mirrors the drill pattern (EPS, DXF, PDF), off by default.
    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
2026-11-09 Plate Designer: arrow drill export cuts the LED window of each stick
    Each of the 10 arrow sticks gets a rectangle of the LED window size (shared
    with the CLOSED slot fields, 74 x 4 mm), written whatever the CLOSED mode is.
    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
2026-11-09 Add strip_frame_demo_test: 16-pixel frame strip with three colour Knight Rider lights and a pulsing single pixel
    D9: red 500 ms, green 385 ms (1.3x), blue 333 ms (1.5x) per step, additive colours.
    D10: single pixel pulse, 3 s, 8 cycling colours. Peak 80. Host test and 45-mutant test.
    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
2026-11-10 strip_frame_demo_test: 18-pixel frame (6/3/6/3), light route clockwise from the upper-left corner
    Strip pixel 1 at the lower-left corner, counter-clockwise; the Knight Rider lights start at
    pixel 15 and run clockwise, turning at pixel 16 (34 steps per cycle). Test and mutants updated.
    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
2026-11-10 strip_frame_demo_test: add D11 colour bar (6 pixels, red-green-blue-cyan-violet-white moving one pixel per second)
    Sketch, Wokwi diagram, wiring and layout drawings, READMEs, host test and mutants updated.
    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
2026-11-10 strip_frame_demo_test: add D12 pixel test (10 pixels: counter, fill/empty, R-G-B-W, runner)
    Other sequences unchanged. Sketch, Wokwi diagram, wiring and layout drawings, READMEs, host test and mutants updated.
    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
2026-11-10 Add Casino Open Sign V2 (casino_open_sign_v2): 18-pixel frame on D11, 10-pixel letters on D12, 11 sticks
    - sketch: one 12 V WS2811 frame strip (pixel 1 lower-left, counter-clockwise), frame light from the upper corner
    runs both ways round the frame to the opposite lower corner; letters strip with OPEN wired reversed (letterPixel)
    - new wiring diagram (5 V + 12 V supplies), layout, layout-parts, parts list, Wokwi diagram, README EN/FI
    - host harness + mutation test, generators in tools/, docs updated
    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
    [parts-list.csv]
2026-11-10 Casino Open Sign V2: new shield connectors for the 11 sticks (V2 only)
    L-WING-UP D6, L-WING-DN D5, RAIL-UP-L D7, RAIL-UP-R D8, RAIL-DN-L D3, RAIL-DN-R D4,
    R-CAP A3, CLOSED stick A0 (L-CAP D2, R-WING-UP A1, R-WING-DN A2 unchanged). Stick
    positions on the plate, v1 and arrow_sticks stay untouched. Sketch, harness, mutants,
    generators (connectors read from the sketch), drawings, READMEs and docs updated.
    Layout drawing now shows stick names with their connectors.
    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
2026-11-10 Casino Open Sign V2: I2C bus scan at boot, found devices printed to Serial
    scanI2cBus() lists every device on 0x08-0x77 before the LCD init and warns when
    nothing answers on LCD_I2C_ADDRESS (0x27). Harness checks, 9 new mutants, README EN/FI and docs updated.
    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
2026-11-10 Add hex_rotary_test: hex rotary switch changes a number A shown on the I2C LCD
    Self-contained test folder: sketch (legs 1,2,4,8 on D34-D37, C to GND, direction and steps from the position change, reverseDirection bit, I2C scan, LCD retry and periodic re-init, sign of life), Wokwi diagram, wiring and layout drawings (SVG+PDF), README.txt and README-fi.txt, host test and 108-mutant mutation test. Docs and RDD files updated (IDEA-011).
    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
    [hex_rotary_test_harness.cpp, mutate_hex_rotary.py, sketch.ino]
2026-11-11 Add C++ menu engine, table generator and menu_test hardware test
    - tools/menu_engine: C++ engine (same rules as the JS engine), JSON -> PROGMEM table
    generator, hardware shell (hex switches, buttons, slide switches, I2C LCD, sign of life)
    - tools/generate_menu_test.js assembles menu_test/sketch.ino; menu_test/ has Wokwi diagram,
    wiring and layout drawings (SVG+PDF) and README.txt/README-fi.txt
    - Menu Editor loaded with the owner's menu JSON (21 properties), republished
    - tests: JS vs C++ differential test, C++ checks, mutation tests (engine 99, core 128)
    - RDD files, PROGRESS.md, CLAUDE.md, AI_CONTEXT.md updated; V2 sketch not changed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
2026-11-11 Fix menu_test compile error: no user-defined types in function signatures
    The Arduino IDE builds prototypes before struct definitions, so readHexRaw, pollHex and
    pollButton now take an index. Add tests/arduino_signature_lint.py.
    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
    [arduino_signature_lint.py, mutate_menu_engine.py, sketch.ino]
2026-11-11 Label rotary switch legs clearly in menu_test and hex_rotary_test wiring diagrams
    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
2026-11-11 Casino Open Sign V2: program switch D34-D37, 15 letter programs, 15 frame patterns
    IDEA-015, IDEA-016, OQ-013, REQ-013 in progress (AP-007). Wiring diagram, Wokwi diagram and READMEs updated.
    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
2026-11-11 RDD: OQ-013 answered, REQ-013 reads the program switch all the time
    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
2026-11-11 Casino Open Sign V2: settings menu in the sketch (generated block), menu switch D42-D45, OK/BACK/SHIFT D48-D50, EEPROM, status page, speeds and brightness curves as menu properties, SW3/SW4 removed
    Menu generator warns on a preset for a read-only property; menu_test arrow mapping fixed; Wokwi diagram, wiring diagram and READMEs updated; tests and mutation tests extended (host only).
    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
    [Arduino.h, casino_open_sign_v2_harness.cpp, mutate_menu_core.py, mutate_v2.py, sketch.ino]
2026-11-11 Menu: Frame/Letters/Arrow groups, Brightness submenus, "Name: value" rows, padlock view page
    Rename Strip -> Frame and Stick -> Arrow. Root: Controls, Speed, Frame,
    Letters, Arrow, Brightness, Random program, Restore defaults. Property rows
    scroll as one "Name: value" text when they do not fit 16 characters. OK on a
    read-only property opens a view page with a padlock (custom LCD character 1).
    Engine, JS core, V2 sketch, menu_test, tests, READMEs and RDD files updated.
    Host tested only.
    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
    [Wire.h, casino_open_sign_v2_harness.cpp, menu_editor_ui_test.py, menu_engine_harness.cpp, mutate_menu_core.py, mutate_menu_engine.py, sketch.ino]
2026-11-11 RDD: record IDEA-017 (single rotary switch, Frame/Letters effects) - documents only
    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
2026-11-12 V2: remove the program switch, effects chosen in the menu (IDEA-017)
    Menu group Effects (Frame effect, Letters effect 0..15, Random delay), effects
    also first in the Frame and Letters groups, one shared random timer, status
    row 0 "F12 L03 Open", countdown while either group is random, live preview and
    BACK restore. Program switch D34-D37 removed from casino_open_sign_v2 and
    menu_test (sketch, drawings, Wokwi, READMEs), menu JSON copy, tests, RDD files.
    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
2026-11-12 V2: rename BACK to CANCEL, CANCEL skips the LED test, skip button SW2/D33 removed
    BACK is now CANCEL everywhere (PIN_CANCEL, MENU_KEY_CANCEL, texts, drawings, Wokwi,
    READMEs, editor, tests). The power-on LED test is skipped with CANCEL (D49): the LCD
    scrolls 'press CANCEL to skip' and shows 'Test skipped' for 1.5 s afterwards; a button
    held at power-up does not skip. D33 and SW2 removed from V2.
    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
    [casino_open_sign_v2_harness.cpp, menu_editor_ui_test.py, mutate_menu_core.py, mutate_menu_engine.py, mutate_v2.py]
2026-11-12 Spread out V2 pins: frame D12, letters D10, menu switch D38/D41/D42/D45, OK D46
    Easier to unplug single sockets on the Mega. menu_test follows for the menu
    switch and OK. Arrow switch D32, casino switch D30, CANCEL D49, SHIFT D50
    unchanged. Drawings, Wokwi files, READMEs, docs, tests and mutants updated.
    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
    [parts-list.csv]
2026-11-12 Add Brightness test mode: Brightness > Brightness test shows a fixed pattern on every LED
    Pattern (Ramp of 10 steps 26..255, All white, Red, Green, Blue, Level) and
    Level live in the submenu together with the three curve groups, so the
    curves can be edited while the pattern is visible. The pattern goes through
    the brightness curves; nothing is stored. Generator emits MENU_REF_ constants.
    Menu JSON copy, README (EN+FI), docs, RDD (IDEA-018, REQ-019), tests and
    mutants updated.
    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
    [casino_open_sign_v2_harness.cpp, mutate_menu_engine.py, mutate_v2.py, sketch.ino]
2026-11-12 Add EEPROM clear tool (eeprom_clear/): sets every EEPROM byte to 0xFF once
    A USB upload does not clear the EEPROM, so the V2 menu settings survive
    uploads. The tool needs no wiring, verifies by reading back, blinks pin 13
    (slow = ok, fast = failed) and prints a DBG line per second. README EN+FI,
    wiring drawing (SVG+PDF), Wokwi file, host harness and 52 mutants, V2 README
    note, docs and RDD (IDEA-019, REQ-020).
    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
    [EEPROM.h, eeprom_clear_harness.cpp, mutate_eeprom_clear.py, sketch.ino]
2026-11-12 Add Monochrome menu property and grey "Grey bands" effect 15 (REQ-021)
    Effects > Monochrome (No/Yes, stored) shows every effect as grey levels
    (brightest channel); Brightness test and the power-on LED test stay coloured.
    Effect 15 of the frame and the letters is now Grey bands: always grey, four
    levels, moving patterns, broken-light flicker. The new stored property changes
    the EEPROM layout tag, so saved menu values reset once on the first start.
    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
    [casino_open_sign_v2_harness.cpp, frame_pattern_reference.py, mutate_v2.py, sketch.ino]
2026-11-12 Grey bands (effect 15): only off, half and full; all lit at the start of each phase
    Frame and letters effect 15 now use three levels (0, 128, 255) instead of four
    greys, start every phase with everything lit, then scroll off/half/full
    patterns; the broken-pixel flicker picks 0/128/255.
    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
    [casino_open_sign_v2_harness.cpp, frame_pattern_reference.py, mutate_v2.py, sketch.ino]
2026-11-12 Arrow sticks default Max 60, grey-only LED test in Monochrome, frame blink-out in effect 15
    - default curve Max of the arrow sticks 80 -> 60 (25 % less)
    - power-on LED test shows only greys while Monochrome is on
    - effect 15: the whole frame blinks out now and then
    - tests, mutants and docs updated
    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
